sparkiscool/noxen/README.md

# Noxen

Drone frames whose printed parts are generated by a topology engine, one script per part, every optimisation run on GitHub.
The picture below is the current assembly, redrawn by CI after every result; nothing here is updated by hand.

## Scout v4
Scout v4, current assembly

[Open the Scout v4 viewer](https://sparkiscool.github.io/noxen/scout_v4.html?view=iso&still): 5.1 in Gemfan 5125 props on a frame printed
in PCTG, with 4 M3 bolts under the deck for the battery mechanism to mount to (the mechanism itself is designed separately), one camera that
is also a ceiling probe on a two-blade tape mast, and a half cage of 3 mm rods with a flat roof, frame-checked (`tools/scout_v4_shape.py`).

## Overseer
Overseer, current assembly

[Open the Overseer viewer](https://sparkiscool.github.io/noxen/overseer.html?view=front&still): every part, its mass and whether it passed; press play for the turntable.

Grey parts are placeholders still to be generated, red ones failed their last run. Every system is at https://sparkiscool.github.io/noxen/.

## Nox Ground Unit (the box)
Nox Ground Unit, current assembly

[Open the box viewer](https://sparkiscool.github.io/noxen/box.html?view=iso&still): the swap arm v7 with seven bays, the stand, the
enclosure, and the landing funnel drawn on the latch footprint so both drones seat at one height, 65 above the arm's grip height
so the wheel turns clear under them, standing on two beams across the enclosure's side sheets (`tools/import_box.py` brings the
mechanism's meshes over from the nox repo; `parts/box_funnel/make.py` draws the funnel).

## xswap short lock (the Overseer's battery mechanism)
xswap short lock in the Overseer

[Open the lock viewer](https://sparkiscool.github.io/noxen/xswap.html?view=iso&still): the short lock v5 on the Overseer's base inserts through one
swap cycle (pincer, fingers, gate bars, rail, flip), the drone see-through round it, with the shell's height over the cage feet read out
(`tools/import_xswap.py` copies the lock's meshes from its own page; `tools/xswap_motion.py` is the cycle).

## Live artifacts (the pages above as claude.ai artifacts, republished by the sessions)
Each system's `artifact` URL is in its `systems/<name>.assembly.json`; a session publishes `site/<name>.html` there after `python tools/build_site.py --inline`.
- Overseer: https://claude.ai/artifact/VhDfnp75uoVsj8SnyrW2Qg
- Scout v4: https://claude.ai/artifact/AqA1sXuqfs4APM6zRdf2iL
- Nox Ground Unit: https://claude.ai/artifact/QyhSnHpskSzztt5kajHG9z
- xswap short lock in the Overseer: https://claude.ai/artifact/Tiij4hVRdJWVdtLy9JdeQv

## How it works
One script per part, GitHub runs the topology engine, one page shows the assembly. Claude writes scripts, nothing else.

## Every part
1. Tell the design chat what the part mounts and carries. It writes your notes to `parts/<name>/feedback.md` and starts a worker
   session for the stream (CLAUDE.md, Sessions), so the chat stays free.
2. The worker writes `parts/<name>/part.py` and a line in `systems/<drone>.assembly.json`, pushes to main (the push starts the run).
3. The runner optimises, solid-checks, commits `result.json` + `part.stl`. The page rebuilds; the grey box becomes the real part.
4. The worker fixes fails at the root cause, republishes the artifact, reports once to the design chat and archives itself.

Manual run of any part(s): Actions -> parts -> Run workflow -> names. Empty = everything missing or stale.
Housekeeping: a weekly scheduled session runs `tools/sweep.py` on Monday morning and archives finished sessions.

## What the runner does when it is cut off
Runner cap is 6 h. The engine checkpoints every 10 iterations; a job that hits the cap saves the checkpoint and
starts itself again for that part, up to 4 attempts (about 22 h). A crash is not retried: it shows red and needs a fix.

## Layout
```
topo/                  engine (from nox/topo; the setup audit, PCTG and the export cleanup added here)
tools/solid_check.py   the gate      tools/build_site.py  page builder      tools/stale_parts.py   tools/sweep.py  housekeeping
parts/<name>/part.py   the setup; CI adds result.json, part.stl, preview.png
systems/*.assembly.json  every drone: part ids, placeholder shapes, poses       systems/dimensions.md  the numbers
site/index.html        the viewer (three.js, reads site/assembly.json that CI writes)
archive/               meshes nothing uses any more (archive/README.md)
```
Status on the page is computed, never stored: `result.json` present and its `part_sha` matches `part.py` -> done or failed; mismatch -> stale; missing -> pending.

## What came from the old repo (28 Oct)
`systems/dimensions.md`, `systems/parts-list.md`, both drones' assemblies and every part's mesh then (viewing copies; a run regenerates
the print file). Paths written `nox/...`, `docs/...` or `runs/...` in those files are in the old `nox` repo, not here.
Scout v3 (`systems/scout.assembly.json`) is archived: off the page, kept for its tools and the box's v3 checks.
