sparkiscool/noxen/archive/dimensions_scout_v3.md

# Scout v3 numbers (archived 9 Nov from systems/dimensions.md; Scout v3 is archived, the live Scout is v4: `python tools/dim.py C`)

## System Scout v3 (27 Oct 2026, layout v3 / cage v2, race-car shape; `nox/scout/v3/layout_v3.py`, assembly `nox/scout/v3/scout.assembly.json`, run `runs/scout_layout/v11/summary.md` (earlier: `v6/` cage v1, `v7/` octagon, `v8/` camera on top, `v9/` v3 middle rectangle, `v10/` Radxa standing); drone frame: x nose, y left, z up, plate underside 18.5, thrust centre = plate centre x 0; C geometry on E sizes unless tagged)
| Item | Value | Tag |
|---|---|---|
| Brief (Spark 27 Oct) | the latest Scout layout (PR 94 run v5) in a triangulated cage: **every rod 3 mm, about half the rods, any rod length; the bottom = the Overseer base loop's 4 side nodes (one reverse funnel, the Scout on fewer ramps); a race-car look; the camera low, no sharp section under it; small triangles to one node**; one camera; the Bee35 carbon base kept; one design | Spark |
| **Bottom (G Shared bottom ring)** | the Overseer cage v5 base loop's 4 side nodes (PR 122; Spark 27 Oct): (+85.8, ±116.1), (−68.9, ±119.7) about the catch centre, 154.7 long, 232.2 / 239.4 wide; plane 3.0 + 2.12 seat under the cartridge flat bottom (DEFAULT); nodes Ø20, rods 3.0; catch (tab line) x −2.50 (2.5 aft of the thrust centre, v13 re-trim for the real node mass), plane z −49.6; funnel band clear of links; swap column: receiver + 26.5 at the nose end, + 17.6 at the tail, + 30 at the sides | C |
| Rods | **58 (layout v13), all 3.0 solid carbon**: shell 50 (61..239, 6.34 m) on 19 nodes (4 on the ring, PETG nodes with 3.2 epoxy sockets, incl. the waist pair (−1.0, ±125.1, −11.9)); links 8, none on the carbon arms: 4 a side from the tie saddle's face (y ±44.3, z −7); none in the funnel band; nose top node (v13 node 17) sockets toward +x within 5 of its centre (camera mount 5.45 away, C); **every rod 3.0, every socket 3.2 (Spark 27 Oct: "lets just stick with 3mm rods for the scout"; the frame model's 6/4 sizing dropped)** (seat −2.12 and the catch's side sleeves stay) | C / Spark |
| Tie saddle | printed PETG (DEFAULT 27 Oct), 17 g E: a rail a side x −50..42, y ±36.3..42.3, z −15..6, outside the belly mount and the receiver TPU end pieces, rail and ties ≥ 2 off the flow bipod and cradle (y −50..−27.5, x −30..30, z −32..18.5; now 2.8 rail, 9.8 saddle ties, 42.3 shell rods, C); 2 tabs a side to the plate underside at x ±14..26, 4 M3 into the plate (4 new plate holes); rod sockets 3.2 epoxied; the cage ties' root and fuse, ahead of the latch; alt: core ties on the plate edges (42 rods, 651 g, bare carbon roots) | C / E |
| Shell (race-car look) | flat roof at the drone's top (109 between node centres), a clean raked front behind the camera (no nose point, Spark), a raised tail point (55 behind the margin hull, 18 under its top; it adds 54 of length), corners of the margin hull grown 24 mm along 6 directions; no triangle with all edges under 70, no rod under 45 (small triangles merged to one node); mirror-exact; node extents 362 x 266 x 111, 6.4 L, largest cell Ø129 (v13); rods 13.9 off the swept disks | C / DEFAULT |
| **Cage v20, the light funnel cage (8 Nov, Spark: "for the scout this is way too ridiculously heavy ... keep material near props as little as possible so it doesn't take away thrust ... reduce the number of rods by half, keep in mind this is a drone"; `tools/scout_cage.py`, frame model `tools/scout_cage_loads.py`; supersedes v19)** | What v19 weighed: 77 rods as cut (5.71 m, 79 g E) in 25 nodes (23 printed structures, 199 g M-run of 8 Nov), the units 177 g and the clips 15 g on a 340 g core: ~807 g against the 500 g budget; 1.74 m of rod lay over or under the prop discs (the roof fans, the lower band, the skids at |y| 84). v20 keeps the ring (side flats split at mid nodes PM0 / PM1), the window, the three-node ridge and the skids; drops the base rails and their mid nodes, the skid mid nodes, the lower band, the roof fans, the front slants and the yoke ties: 21 nodes (19 printed, 17 structures), 39 rods (2 bridges), 4 arm ties down to the skid ends; **41 rods as cut, 3.52 m (46 g E)**. New: a waist hoop RM-PM0 / RM-PM1 across the roof at x 0, the one transverse line between the four discs (5.65 from their edges in plan, 19 above); the skids at |y| 110 (outboard of the discs' plan, was 84) on A-frames from the side mids, a vertical from each skid end to its ring corner, a brace to the sill (K0-P0) or the tail flat (K1-P3). Disc shadow (`disc_shadow`: rod length inside a disc's plan, over it or under it): 314 mm, of it 212 the four ties under the arm tips (under the plate anyway) and 51 each the rear ridge rods' ends; v19 1744 over 26 rods. Checks: prop 12.2 (TB-P3), body 4.0 (sill vs camera), camera clear, passing 23.8, funnel 11.4 (exact descent gate: 0 crossings in 65 states), shell closed with 20 planar declared openings, open share 78 % (the four roof panels ring to ridge, 70 x 110: a flat ceiling touches the ring and the ridge first at any roll under 46°, the ring stands 12 outside and 13 above every disc edge, so only a poker reaches a disc through a panel). Frame: 117 Hz (v19 250), 18 hinges of 57 (v19 6 of 75), Euler ≤ 0.58 (P3-P4), pull-out ≤ 233 N (cap 940), side ≤ 49 (1200), end moment ≤ 1769 N mm (socket cap 2000, RF-RM), softest case the upside-down 35 g crash 15.0 mm at K3 (v19 1.45): half the rods is a tenth of the stiffness, every cap still met. Rejected on the way (frame model dry runs): hangers from skid mid nodes to the ring corners (6.6..12.1 from the discs at |y| 84..110); a V from the skid mids to the ridge (9.9 from the discs with the apex at z 70, 1.5 from the plate at z 62: no straight line threads the gap); roof fans (the front pair crosses the front discs 89 mm each and both pairs push the spine to Euler 1.46); the spine alone without the hoop (27 mm, 2157 N mm at RF-R7). Nodes: 74 sockets (v19 134), budgets 1.2..4.8 cm³ a structure (Σ 39.7, `spec_for`), **E 95..110 g the set**; the Scout then ~680 g E (core 340, units 177, clips 15, cage 150) against 500: the units are the next lever. | E / F |
| **Cage v20 run 1 and the 8 Nov node rules (Spark via the Overseer session: continue the Scout cage; a half cage is fine, it protects the top; as well designed as the Overseer's; design only, no prints)** | **Run 1 (8 Nov 11:45..12:20 PST, PETG rules):** all 17 structures PASS both gates, **104.1 g the set** (v19 199): K0..K3 7.7..7.9 g, P0+R0 / P7+R7 10.3, P3 / P4 6.6, PM0 / PM1 6.4, RM 4.6, P1 / P2 / P5 / P6 3.6, RF / RB 3.6; indices 0.01..0.11; 1..4 min each. Clips 3.7 g, 0.19..0.27. Nose unit 81.5 g, index 0.50 at the yoke under the plate (44.5, 1, 16) in the 35 g funnel catch: FAIL at the new 0.3 limit (0.39 at the NB sockets). Tail unit 90.3 g, 0.30 at the TB-P4 socket, gate FAIL on a 0.7 mm flake (6.8 mm³, 2.2 x 1.0 x 0.1) on the runner rim's end band at (−86.5, 30.4, −41.7), 0.4 under the rim top: a generated finish flake, not a drawn wall; watched for a recurrence before an engine session. System check against v19: the probes that reached the UBEC and the Radxa through the belly, the fit (tail unit room vs arm clip 2) and the FC cable access failed on v19 too; new on v20 are edge probes reaching the motor bottoms at the arm tips by 32 mm and the prop tips by 2..3 mm from below (v19's nose and tail V rods kept them 17..18 clear); four rods NB-K0 / NB-K3 / TB-K1 / TB-K2 would restore that at 45 rods as cut (Spark's call). **8 Nov rules applied (the Overseer's node changes, `parts/scout_node_lib.py`, `parts/scout_units_lib.py`):** every printed part PCTG (the engine keeps the PETG model, CLAUDE.md); limit 0.3 on every node, unit and clip, budgets x1.4 (nodes 1.54 x the skeleton, nose 55 → 77 cm³, tail 60 → 84, clips 1.5 → 2.1); skid nodes K0..K3 take a ground hit alone: **550 N** up through the foot (0.7 kg from 0.6 m, 4.1 J, stopped in ~15 mm of rod flex, peak 2x the average; the Overseer's 1300 N for 1.65 kg), limit 0.2, twice the budget; the landing slab inside the 3.0 foot, 2.5 tall; every socket the injectable pattern (`parts/socket_inject.py`: 0.5 annulus on 3 lands, feed ring 0.5 into the floor, Ø2 fill port, Ø1.5 vent; the port side from `port_dir`, in the units the port and vent continued 150 out), collar WALL 3.0 and FLOOR 3.0 (2.5 beyond the annulus); no min_member_mm in SPEC. **TPU 95A feet:** the Overseer's Ø22 x 6 cap (`parts/overseer_tpu_foot/make.py`) over each skid node's Ø16 landing face, four in `parts/scout_tpu_feet/part.stl` (written by `tools/scout_cage.py`), the Scout standing on them at z −59.4, the skid rods 10 above the ground; at K1 / K2 x −100 the caps crossed the funnel's rear outer wall by 2.0 mm when seated (|y| 116.3), so the rear skid ends moved to **x −95** (skids 195, descent gate 0 crossings in 65 states, frame unchanged: 118 Hz, Euler ≤ 0.59, 15.2 mm upside-down). Budgets now: 1.6..6.7 cm³ a node, skid nodes 7.7..8.2; expect ~130 g of nodes (E) with the thicker collars and the x1.4, the units ~100 and ~110 g (E) at x1.4: the Scout then ~720 g E against 500, the units still the lever. Design only: nothing print-ready (Spark 8 Nov: "wait on all prints, we are still designing"). | M / E / F |
| **Cage v21, the half cage (8 Nov, Spark: "why are we still keeping the lower half of the cage, it provides little value as the bottom shape for the funnel already had plenty of material ... get rid of any ongoing full cage and focus on the new half cage design")** | v20 run 2 cancelled (the 23 runs, ~1:40 pm PST). Kept: the ring at z 58, the ridge at z 70 with the waist hoop, the nose window, the four rods into the nose and tail units. Gone: the skids, A-frames, verticals, braces, the four skid nodes K0..K3 and the TPU feet (~68 g E with their ties and clips). New: a knee S0 / S1 at (0, ±115, 12) under each side mid, in the side flat's plane (12.4 outside every disc in plan at any height): a leg up to the side mid (46), a fan to the two ring corners on that side (91), and the two arm-clip ties in under the disc (82, level at z 12 from roots lowered 13.5 -> 12: at 13.5 the level tie's collar lost 6 % to the plate keep-out, the collar check refused all four clips). 31 rods (2 printed bridges, 2.46 m), 4 ties (0.33 m), 33 rods as cut 2.25 m (34..129); 15 printed structures + 4 clips. Landing: the base units' runners (seat rims z -44.3, 184 x 66.8): the frame model's contact points there (scout_cage.BASE, stiff to the core), and each runner takes a 600 N ground hit alone (2 m g h / 15 mm from 0.6 m at 765 g, the Overseer's rule; units kept at limit 0.3 and their budgets, not the 0.2 / 2x of a landing node: Spark's call). Checks: prop 12.2 (TB-P3), body 4.0, camera clear, passing 23.8, funnel 12.7 (NB-P0 seated), shell closed over the top with the bottom declared open in planar pieces (gap 0), mirror exact; disc shadow 295 mm (the four clip ties 48 each, the rear ridge 51 x 2; v20 314). Frame model: 136 Hz (v20 118), 20 hinges of 51, Euler ≤ 0.32 (RB-P4), end moment ≤ 1839 N mm (RF-RM; cap 2000), worst case upside down 12.8 mm at P6 (v20 15.2 at K3); side crash 3.1 mm on the knee and the runners. Rejected: the top alone (26 mm and 2.6 N m over the cap in a side crash); the leg without the fan (2.02 N m, 13.7 mm); the fan without the leg (17.2 mm); a rod in at x 0 to the nose unit's side instead of the clip ties (2.9 N m on its sockets); the knee at z 18 (the leg 40 merges into a bridge). Not covered from below by design (Spark: the funnel and the base units cover the bottom): a probe from under the arms reaches the motor bottoms (v20 already). | C / E |
| **Cage v19, the low domed funnel cage shortened to the rear discs (4 Nov, Spark: compact, the electronics into the printed base; `tools/scout_cage.py`, frame model `tools/scout_cage_loads.py`; supersedes v18)** | v18 with the tail flat in from x −130 to **−116**, the least the rear discs' 12 mm keep-out allows (54.1 + 48.45 + 12 = 114.6; v18's −130 made room for the tail electronics bay behind the plate, now in the tail unit's bay over the runner), TB in to (−112, 0, 10) (its rods to P3 / P4 pass the rear discs by 12.3). Node extents 252 x 230 x 118 (v18 266). Checks: prop 12.0, body 11.2 (NB-P0 vs the camera), camera clear, funnel 4.8; frame 231 Hz, Euler ≤ 0.55 (RM-P2; RB-P3 / P4 0.53 on the shorter tail), upside-down landing 1.4 mm. **CG (system_check on the assembly): run-2 masses (−0.35, 0.12, 4.6), run-3 masses (0.13, −0.02, 4.8) against the thrust centre (0, 0), tolerance 3; the frame model's all-up 730 g at (0.6, 0.0, 7.2).** **Nodes (4 Nov): the 25 nodes other than NB / TB are engine setups `parts/scout_cage_node_<key>` from `parts/scout_node_lib.py` (after the Overseer's node library): socket collars 2.5 round each 3.2 x 10 bore with a 3.0 floor (**5 Nov, Spark: the nodes are overweight: collars 2.0 with a 2.0 floor, 119 → 83 g of collars over the 25, and 2 cm³ generated: a run-1 node was 8.3..10.5 g, half of it the 4 cm³ budget, at indices 0.01..0.16, so half the budget keeps every index under 0.35; expect 4.5..7.5 g a node, 150 g the set, E**; **and the envelope (5 Nov, Spark: the nodes still look wrong): run 1 grew each node in a box-and-ball envelope up to 56 mm across, so with the frame loads tiny (indices 0.01..0.16) the 4 cm³ went into spindly webs between collars 7..17 mm out; now a Ø12 strut round each member from the centre to its collar's mouth (2.5 of room round the collar) and a Ø17 hub ball, so the engine only decides how much of each strut to keep: a star of struts, a node**), the bore from 7 out or further where two members meet closely so no bores overlap (exact check), a landing face under the six skid nodes, loads from the frame model's node_loads, supports the two stiffest members; h 1.0, 4 cm³ each (E); 3..8 members a node | E / F |
| **Cage v18, the low domed funnel cage on skid trusses (4 Nov, Spark: the whole design more pleasing, inside parts that hold everything; `tools/scout_cage.py`, frame model `tools/scout_cage_loads.py`; supersedes v17)** | v17's skid trusses, braces and ties with the profile lowered and domed: **ring z 58** (was 62; at \|y\| 115 it is 12 radially outside the discs at any height; at 54 the roof rods coming down to it passed 10 over the discs' far edges), **roof ridge of three nodes at z 70** (RF (70, 0), RM (0, 0), RB (−70, 0)) fanned to the ring: a 12 dome, every roof rod ≥ 12 over the discs (the mid node halves the ridge: an upside-down landing put 407 N in a 140 ridge rod, 1.69 of its Euler load; now 0.54 worst, RM-P2). **NB (118, 0, 8) and TB (−130, 0, 14) are printed into the nose and tail units** (`PRINTED`), the tie sockets C (±58, ±30, 14) on the units' yoke corners, the arm ties A on printed clips; v17's tail ties are the tail unit itself. 27 nodes (25 printed as nodes), 71 rods 3.0, 6.69 m (74 g E rod + nodes), 8 ties 0.65 m; pin-jointed 4 rods short of 75 (the window, the belly, the two ends between the skids). Node extents 266 x 230 x 118. Checks: prop 12.0 (P0-P1), body 6.0 (TB-B1 vs the UBEC), camera clear, funnel 4.8 (K3-R7 at +y 20, h 30); frame: first mode 232 Hz, crash deflection ≤ 1.54 mm (upside down on the roof; every other case ≤ 0.2), landings ≤ 0.05, compression / Euler ≤ 0.54, pull-out ≤ 443 N of 940 (P3-P4, upside down), end moment ≤ 297 N mm | E |
| **Mounting audit (4 Nov, Spark: confirm every screw hole and its access against the parts' published dimensions)** | **Published and used as published:** motors EMAX ECO II 2004, 12 x 12 M2 (spec; the Bee35 lists 12 x 12 M2 x 6 motor holes); FC MicoAir743 AIO, 25.5 x 25.5 Ø3 (spec) on the plate's 25.5 pattern, measured as a diamond at (1.9, 0) (M, 22 Oct); Radxa Zero 3W, four Ø2.8 (M2.5) at 57.85 x 22.85..22.90 (Radxa STEP v1.11); camera DECXIN 2633V2, M2 on 28 x 28 (coupon A, M); MTF-02P, UBEC, XR2: no holes (tape, spec). Bee35 plate (listings): FC patterns 20 x 20 / 25.5 x 25.5 / 30.5 x 30.5, motor 12 x 12 M2, plate 3.5 (D8 M). **Not published, from the trace (C / E, CHECK on the plate):** the nose bolt hole (36, 0) and the (3.9, ±31) pair the nose yoke also uses; whether the 20 and 30.5 patterns sit as squares or, like the measured 25.5, as diamonds. The nose yoke is held by the measured 25.5 diamond's three front holes alone, so those three pads are a bonus or a drill. The tail yoke's (−55, ±13) pair is drilled by design. **Screws and access:** FC standoffs M3 x 12 (4 standoff + 3.5 plate + 5 insert) down from the top through the plate into the nose yoke, open above; nose (36, 0) and (3.9, ±31) M3 x 8 from the top, open; tail (−16.13, 0) = the FC diamond's tail standoff bolt, (−55, ±13) M3 x 8 from the top between the arm roots; receiver 4 M3 up from below through the receiver's bolt keys (the latch's own design); camera 4 M2 x 6 from the front through the board into the posts' inserts, open through the window; Radxa 4 M2.5 x 6 from the tail end along −x into the posts' inserts: the UBEC now lies flat under the board (z −24.3..−16.3, the board's bottom edge at −15) and an Ø8 x 40 driver column from each hole is a cut, so nothing grows in the way; motor screws M2 x 14 (6 stock + the 8 mm clip) up from below through the clip and the plate, open under the arm tips; every rod slides into its socket along its own line, resin through the injection port. Build order: the units bolt to the plate first (from the top), the receiver up into them (from below), the boards (the Radxa's screws from the tail end, then the UBEC taped under it and the XR2 on its land), the camera from the front, the rods last | spec / M / C |
| **Inside parts (4 Nov, Spark: "design inside parts that hold everything"; `parts/scout_units_lib.py`, setups `parts/scout_nose_unit`, `parts/scout_tail_unit`, `parts/scout_arm_clip_1..4`; supersede the belly mount v1, the belly skirt, the tail bay mount v2 and the camera mount v1)** | **Nose unit**, one PETG piece: the nose yoke under the plate (3 M3 x 5.7 inserts: the Bee35 hole (36, 0) and two drilled at (34, ±14)) to the receiver's nose inserts (48.28, ±26.55) (Ø10 bosses z 9.6..18.5, the receiver's bolts up through its keys), the nose runner (x 55.3..93.5, \|y\| 33.4, z −44.3..−24.3: a 3 mm seat rim over the funnel's ring with 4 mm 55° lead-ins drawn, the inside generated) with a 26 x 20 window the flow sensor looks down through (MTF-02P lens (74, −2.5, −24.5), board taped under a land at z −18.4; was (0, −30, −30): beside the receiver there is no room between it and the funnel's y face, under the plate the receiver clips its view), the camera boom (lens (126, 0, 40), 4 forward: four Ø5.6 x 10 M2 posts behind the board back x 114 at (±14, 26 / 54) clear the front discs' 12 mm keep-out by 2.4), cage node NB's four sockets and the two nose tie sockets. **Tail unit**: the tail yoke (4 drilled M3 at (−30, ±14), (−55, ±20)) to the receiver's tail inserts (−37.65, ±26.55), the tail runner, the electronics tray (z 0..7.5: Radxa Zero 3W on four Ø8 posts with M2.5 x 4 inserts at its STEP holes, PCB bottom z 5.9, the SD card out the tail, USB-C / HDMI plugs out the right edge; UBEC 61 x 17 x 8 and XR2 34.5 x 13 x 4 on 2 mm tape lands, their leads and antenna cut), cage node TB's four sockets and the two tail tie sockets. **Arm clips** (4): 4 mm under each arm tip on the motor's M2 screws (M2 x 10 through clip and plate), Ø6 shaft clearance, the tie socket hanging under the tip. Keep-outs are cuts: receiver + 0.5, plate, boards + plugs, camera body / plugs / view, the discs grown 12, rods beyond the mouths. Loads: the receiver set's share 155 g (E) and the camera 10 g / boards 32 g in 35 g crashes (14 directions) and flight, a 35 g landing into the funnel on the seat rim and the lead-ins (0.42 of the drone a runner, E), every socket's frame-model force (`systems/scout.cage_loads.json`). Grids: both units h 2.0 (nose 150k cells, tail 123k; the tail at h 1.5 was 287k and its direct solve took 8.8 GB, killed here and over the CI runner's 7 GB; the nose 332k at 1.5 is refused), clips h 0.8 (86k). **Run 1 (4 Nov, 21 / 26 / 1 min):** nose gate PASS 60.4 g, index 0.60 in the funnel catch (seat up) at the nose wall's top (the wall room was 7 wide); tail gate FAIL (two necks at the ends of the 2 mm tape lands) and index 2.34 in TB-B1 tension under the tail pad (−55, −20) (the tray hung on a 10 wide wall slot); clips 2.99 g, index 0.26, clips 1 and 4 gate FAIL: the tie collar's top (root z 17) sheared by the plate keep-out to a 1.1 sliver (2 and 3 passed by grid luck). **The class: drawn bodies left thinner than 2 mm after their cuts; audit `drawn_thin` (exact geometry, under 2.5 mm across the smallest extent) now refuses them before a run; a collar sheared by a keep-out is caught by `check_collars` in the setups (a collar must keep 97 % of itself).** Run 2: lands 4 thick, clips 8 thick with the tie roots at z 13.5, the nose wall room to x 66, the tail wall room to x −66, both units 50 cm³. **Run 2 (31 / 31 / 3..5 min): nose PASS 73.3 g, index 0.41 (funnel catch); clips PASS 3.7 g, 0.12..0.23; tail FAIL: one neck (a 2.6 cm³ blob bridging the UBEC's lead clearance, a 17 x 9 slot through the yoke's side where the pads and tie socket load it) and index 1.16 at the tray's step past the wall room (36 vs 33.4 wide at z 0) in the funnel catch, 80.9 g.** **Run 3 (Spark 4 Nov: "we can keep the fc on top of the base plate"):** the FC on 4 mm standoffs over the plate (board z 26..27.6, caps to 32.5, 6 under the discs' band), so the yokes meet under the plate's middle at x −8 and bolt through the plate's own holes: nose (36, 0), the FC diamond's (19.93, 0), (1.9, ±18.03) (the FC's standoff bolts go on through the plate into the yoke's inserts), (3.9, ±31); tail (−16.13, 0) + one drilled pair (−55, ±13). **Then (Spark 4 Nov: "fit as much of the electronics into the printed base plate that hits the funnel as possible"): the tail tray behind the plate is gone; the three boards stand on edge in a bay over the tail runner, inside the funnel's bowl (x −100..−52, \|y\| 33.4, z −24.3..12): the UBEC at x −95..−87 (61 along y, 17 tall, leads out the ±y ends), the Radxa Zero 3W PCB at x −80..−78.4 (65 along y, 30 tall z −23..7, components to −x toward the UBEC, USB-C / HDMI up between the arms, the SD card out the −y end) on four Ø8 posts along +x with M2.5 x 4 inserts (posts toward the UBEC were boxed in by its clearance, audit), the XR2 at x −72..−71 (|y| 8, z −22.5..−10.5, antenna flat along −y); the UBEC and XR2 on 4 mm lands behind them; a short arm x −120..−96 to the tail node. Run 3 is this layout at 50 cm³ **Run 4 (5 Nov, 37 / 35 min): nose gate FAIL at index 0.42, 84 g: the lower camera posts' 2 mm stubs behind the plug keep-out had 1.2 mm of room beside them, two loose 33 mm³ blobs; tail gate FAIL at index 0.45, 80.8 g: the tail-node arm met the bay over a 4 mm overlap, three necks, the arm's collars 86 % off the main body. The class: a loaded drawn body whose only room to the support is thinner than a member; audit `env_neck` (the room eroded by half a member must still join every loaded body to the support) refuses it before a run. Run 5: the post block to the board's back and \|y\| 24; the tail bay room \|y\| 40 and up to z 22 behind the plate's tail, so the room passes the Radxa (on edge across the whole bay) on both sides and over its top (the arm into the bay alone still reached the yoke only through slivers: env_neck).** **Nose run 5 (5 Nov, 22 min, started by the push of the run-5 setup): gate FAIL on the same two loose stubs with the wider room, index 0.67, 82 g: the lower posts have 2 mm beyond the 8 mm plug keep-out and carry under 1 N each, so the layout never builds to them; run 6 gives every post a Ø10 x 4 root boss behind the plug zone, a body the layout ties and builds onto (the Overseer's head mount posts sit in its slab).** **Nodes, run 1 (5 Nov): 21 of 25 PASS at the first run, indices 0.01..0.16, 8.3..10.5 g each (198 g for 21; the 5 g estimate was for 3 mm rods alone: with 4 cm³ generated and 4 g of collars a node is 9); B0..B3: at each rail corner the arm tie and the yoke tie arrived 2..13° apart, so the no-overlap rule started their bores 39..85 mm out and the nodes grew to 290k..586k cells: B1 / B2 refused in a minute, B0 / B3 crawling. The yoke ties (C) now end at the rail mid nodes BM0 / BM1 (9 members each, bores from 13 at most; the corners 7..15); `scout_node_lib.check_members` refuses a bore over 25 mm out (a fork). Frame: 246 Hz with the ties so.** **Tail run 5 (5 Nov, 37 min): gate FAIL at index 0.40, 79.9 g: no necks, no thin walls, but the tail-node arm's web eroded apart from the body (a 2.7 mm³ remnant); run 6: the arm room \|y\| 20 and 24 tall, 60 cm³** **Run 6 (5 Nov, nose 21 / tail 42 min): nose gate FAIL, 84.4 g, index 0.45 (funnel catch, seat up, at the (36, 0) pad as in run 3): the root bosses fixed the posts (no loose stubs), but two 150 mm³ knobs sat on the seat rim's side bands at (62, ±29, −40), joined over 16 mm² on necks under 3 mm: the seat's side-face and end-face load regions ran 2.7 mm above the 3 mm rim up the chamfer, into the block's room, so the layout grew material out to those loaded nodes to carry the funnel's side push. The class: a load region reaching off its drawn face into design room; the audit's `load_room` check (over 10 % of a case's loaded nodes with no drawn cell at them) refuses it before a run; the seat regions now stop at the rim's top (both runners). Tail gate FAIL, 92.9 g, index 0.18 (TB-P3 tension): the first tail with no necks, no loose drawn bodies and no thin walls; one body plus a 4.8 mm³ floating crumb the engine's cleanup dropped (one watertight body exported) but the gate counts (any loose piece over 1 mm³): a gate rule, Spark's call (align it with the exporter's 10 mm³ core limit, or have the engine report where the crumb sits). The audit then found a second source in the tail: the wall room box (x −66..−52) ran from the seat up without the lead-in wedge, so the chamfer zone at the yoke end was design room the engine could fill toward the funnel's face (28 of the side-face region's 64 cells); both units' wall rooms now have the wedge cut out. Run 7: both units with the clipped seat regions and the wedge out of the wall room (the tail also for its mass: the 60 cm³ budget and the bay room gave 92.9 g).** | C / E / F |
| **Placement audit (5 Nov, Spark: "check that all nodes and all rods are in the right places")** | Every node part is built in drone coordinates at its cage point (`parts/scout_node_lib.py`: the collars along the rod axes from `tools/scout_cage.py`'s tables, so the mesh needs no pose); `check_members` passes for all 25 (every socket pair on one axis, 3..9 members, no bore over 25 mm out, every member with a frame-model load); the rods mesh `parts/scout_cage_v19/part.stl` is from the current tables (85a11aa, the yoke ties to BM0 / BM1); the cage checks on the current tables: prop clearance 12.0 (P0-P1), body 4.0 (P0-P7 vs the camera), no rod in the camera's view, funnel 4.8 (K3-R7 at +y 20, h 30), shell closed and mirrored (27 nodes, 71 rods, 46 triangles). **What was wrong on the page:** BM0 / BM1's meshes were run 1's, before the yoke ties C0..C3 were retargeted to them, so the four tie rods arrived at nodes with no socket for them; B1 / B2 had no mesh (refused as forks, never rerun); the other 19 nodes' meshes were built to the same geometry as now (only their loads changed). The node reruns of 5 Nov (the lighter spec) replace all 25. | C |
| **Merged nodes (5 Nov, Spark: "if any two nodes are too close together, like the nodes in the front, we should just make that into one structure, the same all across the scout")** | Rule, in `tools/scout_cage.py`: two nodes closer than MERGE_MM = 60 are one printed structure (`GROUPS`, union-find over `BRIDGES`), the rod between them a printed PETG bridge (no sockets); `parts/scout_node_lib.py` builds the pair as one part (`parts/scout_cage_node_<a>_<b>`: both nodes' collars, struts and hubs, a Ø12 room along the bridge, 5 cm³: two nodes' 2 and a bridge's worth), the rods mesh and the frame model leave the bridges out of the carbon (frame: a bridge is a PETG Ø8 beam, E 2.1 GPa). At 60: the two window posts P0-R0 / P7-R7 (41 mm), the ring's tail corners P2-P3 / P4-P5 (53) and the six skid-truss posts B0-K0 .. BM1-KM1 (57): 10 pairs + 5 singles (P1, P6, RF, RM, RB) = 15 printed structures, 61 carbon rods (6.14 m). Next pairs up: NB-P0 62 (NB is in the nose unit), B0-P0 / B3-P7 70, the corner diagonals B0-R0 / B3-R7 89. **Weight (E): a wash.** A rod costs 11 g/m; its two collars at 2.0 wall 1.1 g; the engine's material behind the two sockets ~0.8 g: a 41 mm window post 2.4 g in all, a 57 mm skid post 2.6. A printed Ø8 PETG bridge over the span between the hubs: 24 mm 1.5 g, 40 mm 2.6 g. So the window pairs save ~1 g each, the skid pairs break even, and the corner diagonals (B0-R0: 72 mm of bridge, 4.6 g against 2.9) would cost 1..2 g each, so they stay rods. Over the cage: −2 g for the 10 pairs, +5 g if the four corner groups B-P-R were merged too. **Frame model with PETG Ø8 bridges** (`systems/scout.cage_loads.json`): the 8 window and skid pairs alone: first mode 241 Hz (246 all carbon), crash deflection 1.44 mm (1.41), Euler ≤ 0.58 and the largest rod force 457 N unchanged (P3-P4), a bridge under 8 MPa (Ø6: 240 Hz; Ø10: 273 Hz, a Ø10 bridge is stiffer in bending than the rod). With the ring's tail corners P2-P3 / P4-P5 bridged too (the rule at 60): 218 Hz, 2.01 mm upside down on the roof, Euler ≤ 0.61 (RM-P2): the ring's rear corners carry the roof, and a Ø8 PETG bridge is 5x softer along its axis than the rod; the engine sizes the printed corner from the rod's load (5 cm³ a pair), so the built corner is stiffer than this Ø8 estimate. What merging buys is not mass but parts: 10 fewer rods to cut and 20 fewer sockets to resin. **The empty sockets Spark saw on the page (7 Nov, "nodes with place for rods that dont have rods"):** not the design: the page's mesh cleanup (`build_site.view_mesh`) merged two in-line rods that met at a mid node's centre into one body and dropped it, so RF-RM-RB, the rails through BM0 / BM1 and the skids through KM0 / KM1 (10 rods) showed empty sockets while the STL had all 69. The rods mesh now draws each rod as it is cut, socket floor to socket floor (`scout_cage.rod_ends`: 69 rods, 5.37 m, 42..136 mm, the cut list in `cage_shell.rod_cuts_mm`), so no two touch and the page keeps every one (checked: 69 bodies in the page copy). **Found on the way (the pair setups):** the nose braces K0-R0 / K3-R7 passed 15.9 mm from P0 / P7, through their P0-P1 / P7-P6 collars (the run-1 nodes had no check for a passing rod, so the printed P0 would have sat on the brace); they now end at P0 / P7 (one printed structure with R0 / R7, so the brace still reaches the ring through the bridge). Checks for it from now on: `scout_cage.checks` screens every rod against every node it does not end at (axis 20 mm from the centre; nearest now 23.8, the sill P0-P7 past NB, whose sockets point elsewhere) and `scout_node_lib.check_members` refuses a collar a passing rod comes within 1 mm of (exact, every node, NB and TB too). Grids: a 57 mm pair is 230k cells at h 1.0, so the pairs run at h 1.2; the singles at 1.0. Frame after the reroute: 221 Hz, 2.01 mm, Euler ≤ 0.61. **Strut singles at a flat 2 cm³ (run of 7 Nov 02:40, the five that stay single: P1 6.2 g, P6 6.2, RF 5.2, RM 5.7, RB 5.2; indices 0.04..0.28, one body each): gate FAIL on 2..10 flakes a node, 1.0..1.4 mm thick, 15..35 mm³, in the re-entrant corners where the strut rooms meet, where the engine's 6.25 mm members did not fill the Ø12 room (the export cleanup lists them as slivers but removes only their cores: an engine class, its own session started 7 Nov). The budget a node needs is what its members weigh: the engine's member floor is 6.25 mm at the gate's 2.0 mm erosion (`topo.layout.gate_member_mm`: 2 x 2.0 + 2.25), so every strut from the hub to a collar's mouth is Ø6.25 whatever the load (the indices at 2 cm³ say Ø4 would carry it); `spec_for` now sets each structure's budget from its skeleton (a Ø14 hub ball and a Ø6.25 member from the hub's surface to every mouth, the bridge too, +10 %): singles 2.5..3.5 cm³, pairs 5..7. Sockets start at 5 (NODE_R 7 → 5) and the strut room is 1.5 round the collar (2.5), so the struts are shorter and the rooms tighter. Expected: singles 6..8 g, pairs 11..14, the 15 structures ~150 g against run 1's 246 for 25 nodes. The lever left is the gate's member floor: at 4.5 mm the generated half of a node would halve again. **Merged run 1 (7 Nov 03:56, with the ports): singles P1 / P6 8.7 g, RF 5.6, RM 6.4 (PASS, index 0.04), RB 6.5; pairs B+K 12.6..14.0, BM+KM 14.8, P2+P3 / P4+P5 14.6; P0+R0 / P7+R7 stopped by the early strength check. Two classes: (1) every structure but RM failed the gate on 1.1..1.2 mm walls, 22..25 mm³ each, that sit ON the collars at their resin grooves: a 2.0 wall less a 0.5 groove is 1.5, and the engine session of 7 Nov found the same (the flakes of the earlier strut run were these too) and added the audit's `drawn_wall` (a drawn body with a wall under the gate's thin rule after its cuts is refused): collars are 2.5 again, as the Overseer's (2.0 at the grooves), the strut room 3.0 for the drawn share. (2) The pairs' indices 0.54..1.40 sat in the bridge next to one node (P2+P3 1.40 at 10 mm from P3; B0+K0 0.75 at 10 mm below B0): the pair had one support, the two stiffest members over both nodes, so every pull at the other node ran through the bridge; a pair now has the two stiffest members at each node as its support, the bridge carries only its frame force. Nose run 8 (with the ports, 20 min): gate PASS, 84.3 g, index 0.40 (seat-up catch): the first nose through both gates. Tail run 8 (42 min): 92.7 g, index 0.18, gate FAIL on the same 0.7 mm sliver at the runner's rim corner (−87, −30, −42). Clips run 3 (with the ports): PASS, 3.7 g, 0.10..0.19.** **Merged run 2 (7 Nov 05:58, collars 2.5, supports per node, 1..8 min each): 13 of 15 PASS both gates: P0+R0 / P7+R7 14.6 g (0.18), P2+P3 / P4+P5 16.9 (0.07..0.08), B0+K0 / B3+K3 16.6 (0.24 / 0.33), B1+K1 / B2+K2 14.2 (0.10 / 0.14), P1 / P6 10.2 (0.09), RB 7.6 (0.16), RF 6.5 (0.11), RM 7.3 (0.06): 157 g the 13, the whole set of 15 ~187 g against run 1's 246 for 25 nodes (the collars at 2.5 cost 0.2 g a socket back). BM0+KM0 / BM1+KM1 refused by load_room: at the pairs' h 1.2 the 1 mm landing-face band under KM0 caught a layer of cells outside the foot (128 of 280); the region is now the foot's own volume (z +0.2..2.8 of its 3, r 7.8).** **Merged run 3 (7 Nov 07:08, all 15 on one setup, 1..10 min each): 15 of 15 PASS both gates. B0+K0 / B3+K3 16.4 g (0.08), B1+K1 / B2+K2 14.2 (0.04), BM0+KM0 16.9 / BM1+KM1 17.0 (0.03 / 0.04), P0+R0 / P7+R7 14.6 (0.18), P2+P3 / P4+P5 16.9 (0.07 / 0.08), P1 / P6 10.2 (0.09), RB 7.6 (0.16), RF 6.5 (0.11), RM 7.3 (0.06): the set 200 g (M, 15 structures) against run 1's 246 g for 25 nodes; with the 61 carbon rods at 68 g and the 8 ties, the cage is ~290 g. The pairs came in 3..4 g over the skeleton estimate each (the bridge's Ø12 room filled, and the 2.5 collars). Every index is under 0.2: the budgets have margin to give back if the member floor ever drops.** | C / E / F |
| **Resin injection ports (5 Nov, Spark: "nodes need to be resin injectable")** | Every 3.0 socket on the Scout (the 15 cage structures, NB / TB and the tie sockets in the units, the arm clips) gets a Ø2 channel from the bore 1.5 above its floor out through the collar wall and the body (`parts/cage_node_lib.port_dir` / `port_cut`, cut through the whole envelope so nothing grows over it): the rod goes in dry, the syringe tip in the port, resin fills from the floor up through both grooves and shows at the mouth (the mouth is the vent; the coupon's floor vent is not drawn, a node's floor backs onto the body). Direction: perpendicular to the bore, as near outward from the cage (away from (0, 0, 10)) as the room allows, no other member within 30° (the 6..8-member nodes have no 40° gap) and the channel clear of the other collars by 1.5; in the units the node sockets' ports point down out of the underside and the tie sockets' out of the yoke's side, the clips' down under the arm tip. So every port is reachable with the cage assembled (rods last, row Mounting audit). Resin: **one tip for every socket on both drones (Spark 8 Nov: "one size that fits all optimized for resin flow and contact, then build the nodes around it"): a 14 G blunt luer-lock tip (Ø2.11 outside, Ø1.60 bore: 3.3x the flow of 16 G, 13x of 18 G, flow ~ bore^4) on a 3 ml luer-lock syringe, slow epoxy; ports become Ø2.5 (PORT_R 1.25, 0.2 clearance a side for a printed hole) with a 2.5 tall feed ring so the port opens fully into it; applied by recut after the 8 Nov batches land (a constant change on main restarts every running node). Bigger (12 G, Ø2.77) needs a Ø3.1 port, wider than the 3.0 collar wall leaves room for on the 6..8-member nodes; the 0.5 annulus round the rod sets the fill rate past 14 G anyway**, M (tip sizes) / E; coupon it before the first node (the Overseer's coupons v2 were brushed, not injected). **The bore's inside (7 Nov, Spark: "make the inner pattern in a way where the resin can actually make the best contact with the rod"):** a plain 3.2 bore on a 3.0 rod leaves 0.1 of radial gap, which resin barely enters, so the bore now has three 0.3 deep, 60° wide channels (pockets) along it from 1 mm above the floor out of the mouth, between three 60° lands of the plain 3.2 bore that centre the rod; the port opens into the first pocket, the two 0.5 grooves at a third and two thirds of the depth join the three pockets round the rod, and the resin shows at the mouth through them: a bond line of 0.3 on 60 % of the rod's surface and the grooves' rings on the rest, against a dry 0.1 film before (`cage_node_lib.socket_cuts(pockets=3)`, every Scout socket; the Overseer's sockets unchanged). The collar is 2.2 at a pocket and 2.0 at a groove, within the audit's 2 mm wall rule. The printer sees a 3-lobed hole: the lands are 1.7 wide arcs, the pockets 0.3 steps, both well over the 0.4 nozzle. | C / E |
| **Node length and the merge distance (8 Nov, Spark: "the nodes are super long")** | What sets a node's size: each arm reaches socket start + the 10 mm bore + the 4 mm collar end; the start is 5 mm unless a neighbour's bore would come within 2.5 mm of wall, which pushes it to 8..17 (mean 10..12 over the cage), so a single node is 43..58 mm across (RM 43, P1 57, RB 58) and a merged pair 104..115 mm (the 41..57 mm span between the two nodes inside one part). The levers: the bore depth (10 is Spark's coupon; 8 would take 4 mm off a part and leave ~750 N of pull-out against 301 N worst, E, not taken without a coupon), the wall between bores (2.5 to the gate's 2.0 would save ~1 mm a start, not taken), and the merge distance, which is the length: MERGE_MM 60 → 45, so only the window posts P0+R0 / P7+R7 (41 mm, 104 long) stay merged and the ring corners P2 / P3 / P4 / P5 and the skid-truss nodes B0..B3, K0..K3, BM0 / BM1, KM0 / KM1 are single nodes again (23 structures, 77 carbon rods as cut 5.71 m, 38..136 mm). Frame with only the two bridges: 250 Hz (221 with ten), crash deflection 1.45 mm (2.01), Euler ≤ 0.59: the ten PETG bridges had been softening the ring and the skids. **Split run (8 Nov 00:36, 0..8 min each): 23 of 23 PASS both gates, 199 g the set (the 15 merged structures were 200): B0 / B3 9.6 g, B1 / B2 7.8, BM0 / BM1 12.6, K0 / K3 6.3, K1 / K2 6.5, KM0 / KM1 4.3, P2 / P5 8.2, P3 / P4 8.7, P1 / P6 10.1, P0+R0 / P7+R7 14.6, RB 7.5, RF 6.5, RM 7.3; indices 0.01..0.18. Looked at on the page (headless render): every socket holds its rod, the hubs are Ø20 balls with the collars as short stubs, the skid nodes a boot on a foot.** | C / E / F |
| **Filament (8 Nov, Spark: "is PETG still the best filament for this?")** | **Superseded the same day: PCTG for every printed part (Spark 8 Nov via the Overseer session, CLAUDE.md; the Overseer's PETG nodes and arms broke in testing).** The morning's answer: PETG stays for the nodes, the units and the clips: the carbon rods carry the cage's stiffness (every node index is under 0.2 at the gate's 6.25 mm members), the crash cases need toughness more than stiffness, it prints on the open A1 mini with the stock nozzle, bonds with epoxy after a scuff, and is on Amazon in any colour. What would change it: PETG-CF (Bambu / Polymaker, Amazon) is ~2x stiffer and creeps less under a resined rod's pull, but it needs the hardened 0.4 nozzle (A1 mini: hardened steel nozzle, Amazon) and is more brittle across layers, so a crash into a node edge is worse; PA-CF / PAHT-CF want a dry box and an enclosure the A1 mini has not got; ASA / ABS warp open-frame and add nothing PETG lacks here; PCTG (Polymaker) is PETG's tougher, clearer cousin, same settings, a drop-in if a node ever cracks on a crash test. Resin: a slow (30 min) epoxy fills the pockets before it gels; CA would not reach the floor through a Ø2 port. | E |
| Frame results (Scout, `tools/scout_cage_loads.py` on v17 then v18, writes `systems/scout.cage_loads.json` with `node_loads` for the units' sockets) | the Overseer's engine (3D Euler beams, rigid joints: a 3.0 rod in a 10 deep PETG socket turns at ~230 N m/rad, 5..12x the rod's own 4EI/L, so the rods are the compliance; the PETG limits strength: pull-out ~940 N, side ~1200 N, end moment ~2.0 N m, all E), the plate and everything on it one rigid body (554 g at (−11, 0, −4)) on the ten tie roots, cage 211 g, 765 g all. Cases: 35 g crash in 14 directions onto the hull face the CG ray leaves through (6 faces), landing 6 g flat on the skids, rough landing 6 g rolled / pitched 20°. **Results v17: first free-free mode 204 Hz** (v16 with its single-diagonal panels 147); crash deflection ≤ 0.29 mm (v16: 17 mm tail-first, 8.4 flat), landings ≤ 0.06; largest rod force 210 N (tie A0-B0, nose crash); compression / Euler pinned ≤ 0.53 (P0-P7, the window sill, 115 long; Overseer benchmark 0.73); socket pull-out ≤ 207 N of 940, side ≤ 10 of 1200, end moment ≤ 402 N mm of 2000. **v18 (NB / TB on the units, no tail ties): 232 Hz, ≤ 1.54 mm (upside down on the roof, P3-P4 443 N), Euler ≤ 0.54, end moment ≤ 297.** v16's weak points, all fixed by v17: base rails 200 long buckled at 1.10, TB-B1/B2 at 1.08, the skid panels hung on socket bending at 1860 N mm, tie C1-B1 at 1157 N over pull-out | F on E |
| **Cage v15, the compact funnel cage (3 Nov, Spark: v14's 392 x 284 was far too large, then "the scout is colliding with the funnel"; `tools/scout_cage.py`, checks in the script; supersedes v13 and v14 for the shared funnel of `parts/box_funnel/make.py`)** | a closed 3.0 rod octagonal prism tangent to the prop keep-out, formed to the Scout seated in the funnel: **22 nodes, 48 rods, 4.88 m (54 g E rod + nodes), mirror-exact, shell closed with its openings declared (the bottom inside the base rails and its nose / tail Vs; the nose window for the camera); node extents 266 x 230 x 107** (v13 362 x 266 x 111). The one ring at z 62 is the prop keep-out ring and the roof's edge: flats at |y| 115, nose 136, tail −130, corner chamfers on |x| + |y| = 193.7 (tangent to the discs' 12 mm keep-out), every rod ≥ 12.1 from the swept discs; roof a 2-node spine (70 / −70, 0, 62) fanned to the ring; the front nodes dip to z 17 with a window sill between them under the 89 x 73° view from the lens (122, 0, 40). **The whole shell stays above z 0, over the funnel's wall tops (z −4.3), in every state of the descent (the end walls sweep |x| ≤ 153, |y| ≤ 85 at the capture limits; a first draft with its base ring at z −48 rode into the end walls a few mm above the seat):** base rails at |y| 115, z 0, nose and tail bottom nodes (118 / −130, 0, 8), four legs from the rail ends (±100, ±115) to feet at z −45 (TPU caps Ø16 x 3, contact −48, 10 over the funnel's nose beam; the belly skirt at −44.3); rods ≥ 6.3 off every part (the tail node behind the Radxa); longest rod 200, shortest 45, largest cell Ø76. **What the compactness cost the layout (3 Nov): the tail electronics moved from the tail bay (x −118..−178) to flat under the plate's tail (Radxa x −118..−53, UBEC and XR2 beside it, z 7.5..20, over the funnel mouth; XR2 antenna laid along −x), the camera from lens (149, 0, 42) to (122, 0, 40) just ahead of the front discs, the flow sensor from y −40 to −30; the funnel lost the rim on its x walls.** Seated check (tools/seat_check.py): 0 crossings with the funnel and deck for both drones. Node design, loads (frame model) and the saddle ties into the plate: next | C / E |
| Strength (frame model v4 on v13, `runs/scout_frame/v4/`) | 35 g crash (313 N at 912 g) through the saddle ties: **every rod 3.0 fails** (31 of 58 buckle, 12 crash and 22 handling stresses over 600 MPa, first mode 34 Hz, nodes by the fit); **Spark 27 Oct: 3.0 everywhere, accepted** (rods are the fuse, a cheap swap; lift it by the nodes or the plate); the camera mount v2 must reach 100 Hz on 3.0 rods (clips near nodes) | F on E / Spark |
| Balance | **tail bay out of the prop wash, CG in the middle of the props** (Spark 27 Oct, DEFAULT): Radxa on edge and the UBEC behind the rear disks, riding with the catch on the electronics session's mount (round 5 concept 49.2 g + cables 6.3 g, E; Radxa post keep-outs cut); XR2 fixed in the frame at x −110..−94, y −27..−15 (3.8 out of the wash); catch set **2.5 aft** (v13, for the real node mass): CG 0.7 mm off pack in, 0.7 pack out (system_check, x and y); FC IMU offset x −2.50 (PX4) | C on E |
| Camera (one) | DECXIN 2633V2 89 x 73 (E), horizon, **lens (149, 0, 42), close in at the nose, outside the cage, printed PETG only** (Spark 27 Oct): cradle 0.5 clear, lips 6 over and under (x 128..153, z 17..67); mount v1: one PETG print 21.8 g (M), lens hood 4.0 ahead (DEFAULT 3), truss arms into **4 snap clips pushed on from the front after the cage is built** (9 long, bore 6.2, mouth 5.6 into the cage): top (110.5, ±18.0, 61.1) rod 7-8, bottom (122.6, ±18.0, 11.5) rod 14-15; 2 CA'd stop collars; pop 23 N a clip (E) = the fuse; 109.3 Hz (F) | C / M / E / F |
| Funnel fit | funnel band (30 above the plane, inside the opening or 40 past its ends): no link in it; the shell rods leaving the 4 bottom nodes rise through it; 2 shell rods reach it at the nose low node (106.7, 0, −19.0); no tail low node (every node past x −130 about the catch ≥ 91 above the plane); the design center's ramp check decides | C |
| Landing | the 4 bottom nodes are the lowest points; no link lands on them. **Box catch F (PR 155, DEFAULT):** TPU foot caps Ø16 x 3 under the 4 ring nodes, the same as the Overseer's (both drones' side tubes at one height, cartridge 16.2 above the deck, C); 6 mm printed sleeves on the 2 side rods over x ±32 (2 x ~1 g E; they fall away if the ring rods go 6/4); alt: the loop 9.2 lower, ring on the deck | C / E / DEFAULT |
| Props shadow | 3.0 % above, 8.2 % below (plan shadow weighted by r, v13) | E |
| Mass | 912 g all-up (system_check, v13, E): cage 298 (shell rods 70, nodes + caps 203 by the fit to the saved nodes v2, saddle ties 8, tie saddle 17); camera 10 (E) + mount v1 21.8 + 2 collars 0.5 (M) = 32.3 (M + E); the electronics session's tail bay mount 49.2 and cables 6.3 (round 5 concept); bought, latch set and wires 526; budget 500 soft (L) | E |
| Access | swap down (cartridge, pack, plug); 4 receiver bolt keys from below; FC USB-C cable out the tail-left through a cell: 8 / 8; 25 / 25 with the belly mount v1's keys and paths | C |
| Electronics tail bay (mount v2 on v12) | v12 poses, catch −5.0 (C); tail block 15.9 g E (web under the plate to x −31.0, 2 M3 through the tab at (−42.0, ±16.0) C, fin + foot to z 34) + carrier 33.2 g E (4-M3 yoke = lateral fuse, tube spine 14, UBEC box 6, XR2 floor z 21); mount 49.2 g E at (−84.0, −0.2, 10.7) C, cables 6.3 g E; L crash worst 0.27 E; 235 / 476 Hz E; CG 0.56 / 1.49 at −5.0 C (main, camera mount); belly mount tail face x −31.0 (req). `runs/scout_electronics/v2/envelope.json` | C on E |
| Belly mount (concept v1) | PETG 25.0 g E at (2.1, −10.7, 6.8) C: 2 yokes, plate to receiver; receiver 4 M3 inserts (−37.65, ±26.55), (48.28, ±26.55); 4 new plate M3 (−25, ±13), (30, ±13), Bee35 holes empty; tail face x −31; ESC vents x ±18 (641 mm²); flow (0, −40, −30) on a bipod; flow clear air DEFAULT slipstream (10.7 out), alt column (2.6 % under a disk; no pose passes); FC on AIO holes, soft-mount req 5.2 columns, rib ≤ 6.5. `runs/scout_belly_mount/v1/` | C on E |
