sparkiscool/noxen/systems/probe_sim/blossom.png

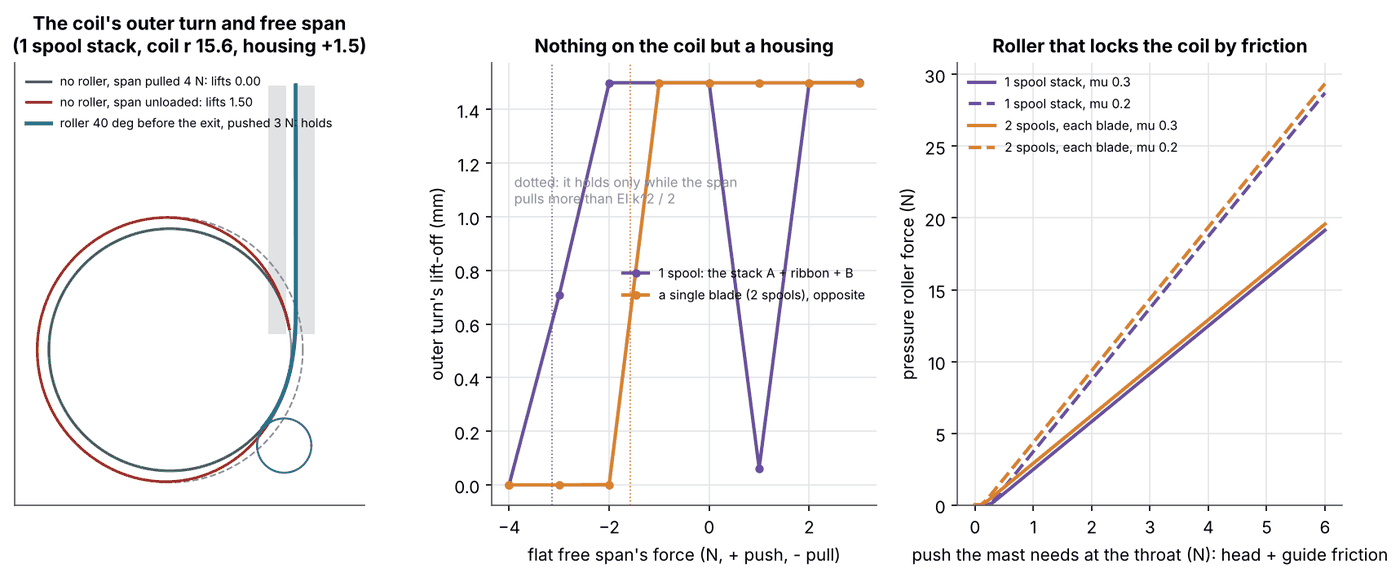
systems/probe_sim/blossom.png
