sparkiscool/noxen/systems/probe_sim/cable.png

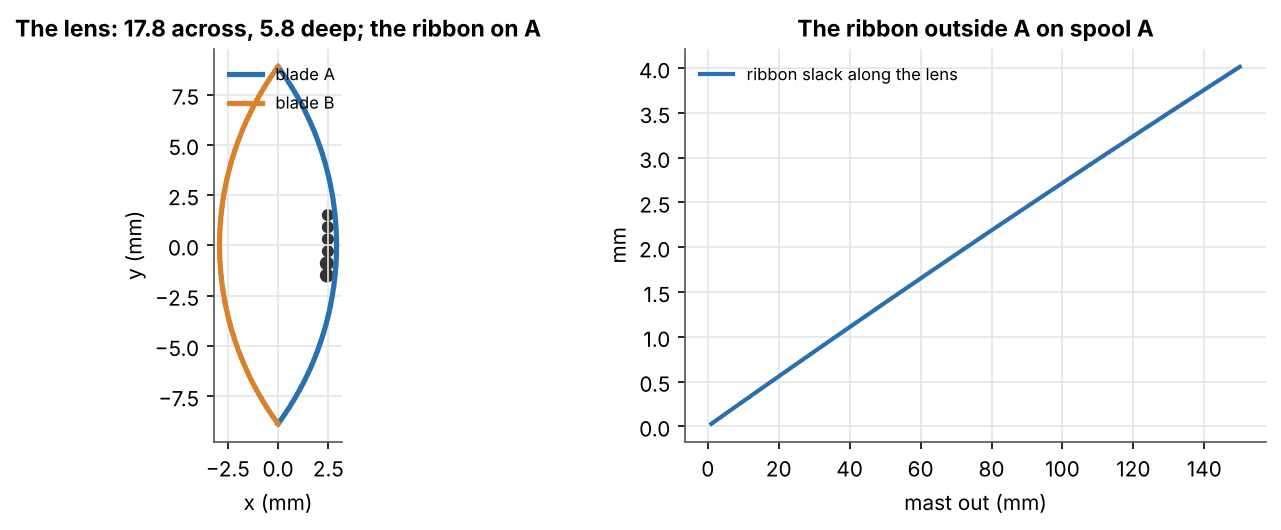
systems/probe_sim/cable.png
