sparkiscool/noxen/systems/probe_sim/coil.png

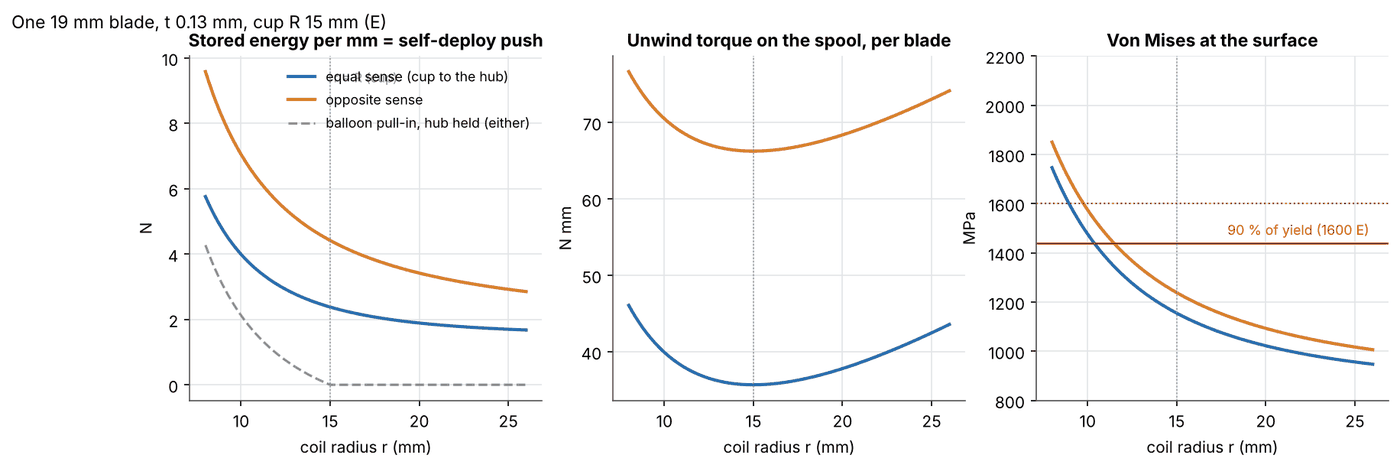
systems/probe_sim/coil.png
