sparkiscool/noxen/systems/probe_sim/drive.png

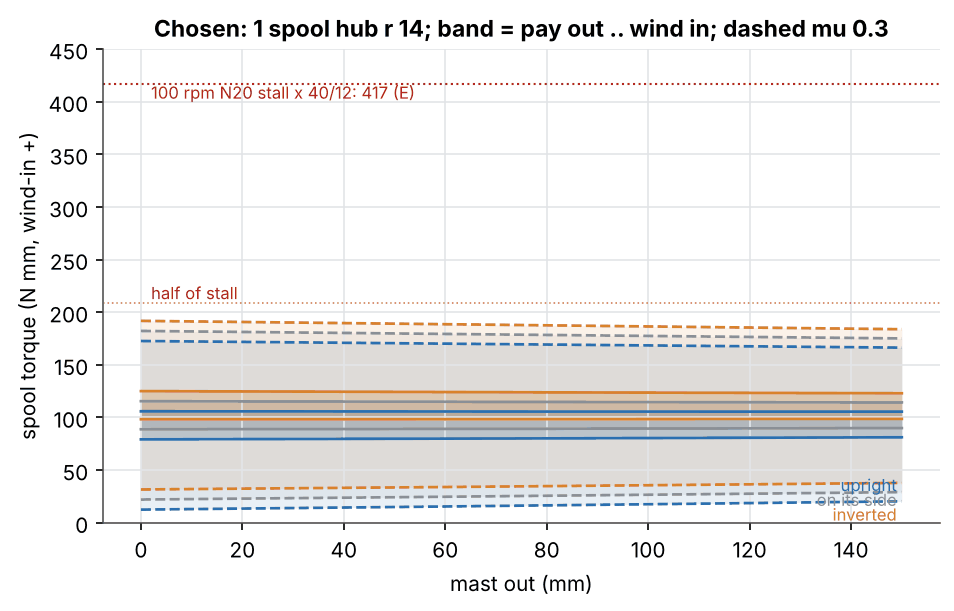
systems/probe_sim/drive.png
