sparkiscool/noxen/systems/probe_sim/fe_fold.png

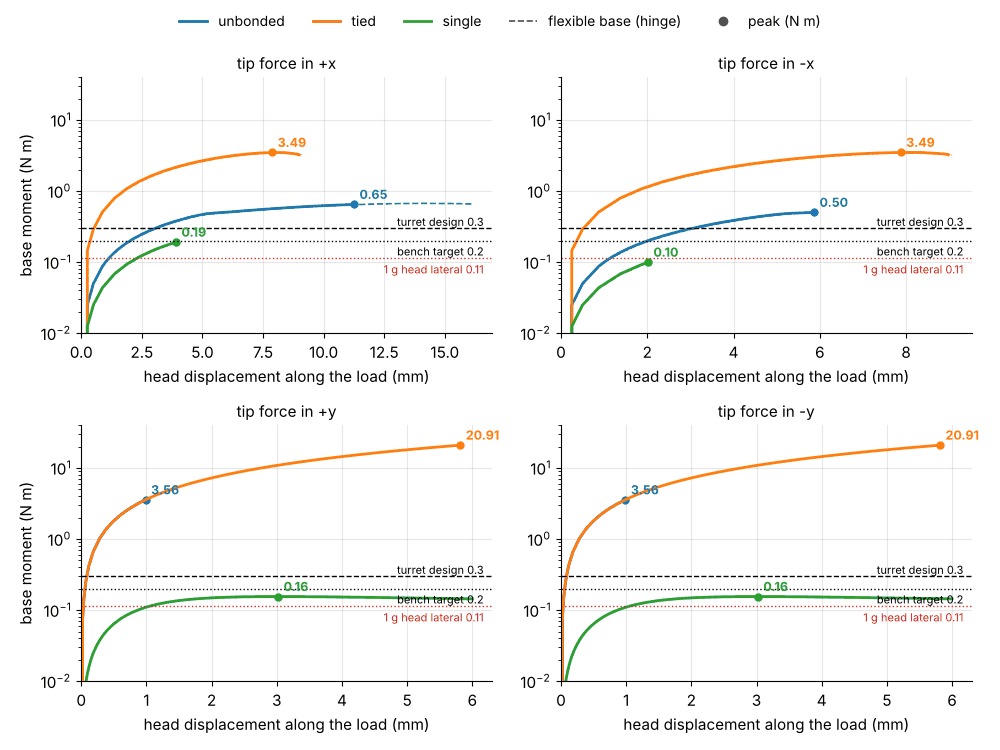
systems/probe_sim/fe_fold.png
