sparkiscool/noxen/systems/probe_sim/fe_modes.png

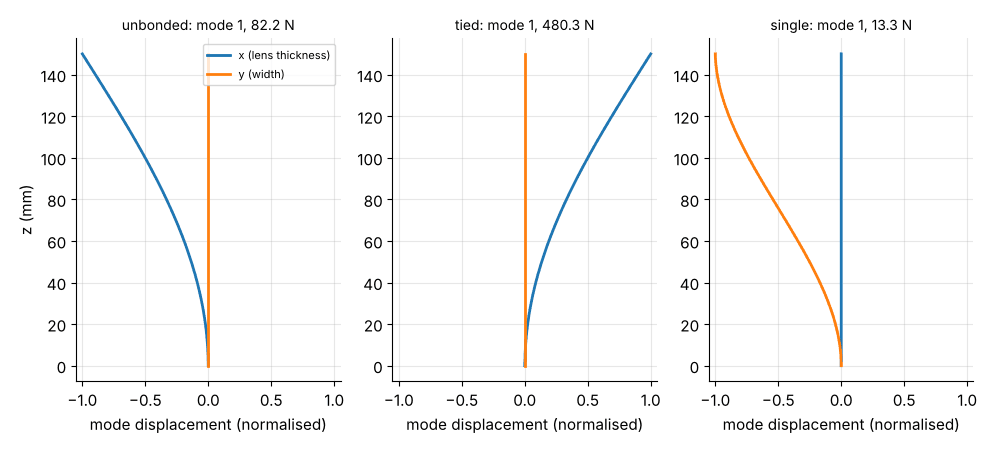
systems/probe_sim/fe_modes.png
