sparkiscool/noxen/systems/probe_sim/fe_transition.png

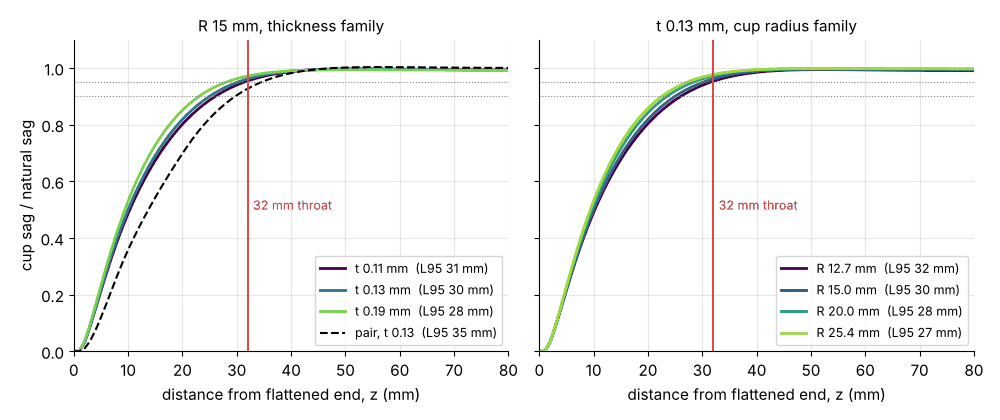
systems/probe_sim/fe_transition.png
