sparkiscool/noxen/systems/probe_sim/fit.png

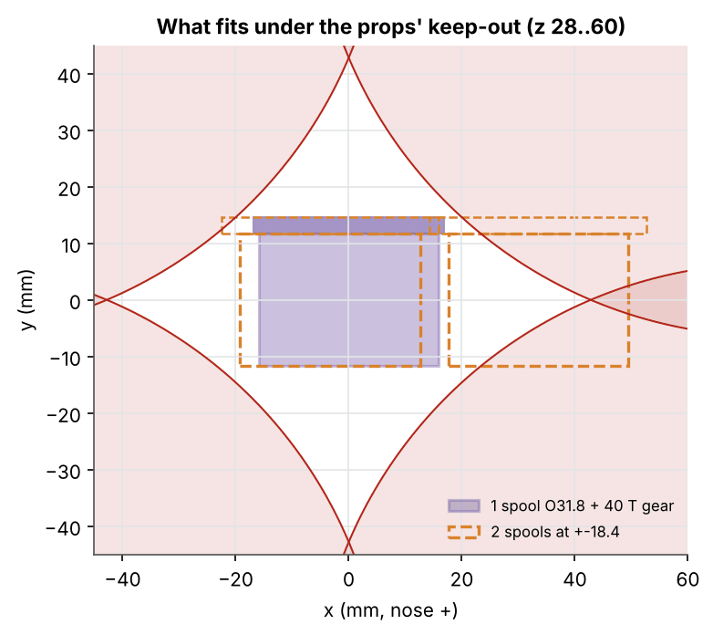
systems/probe_sim/fit.png
