sparkiscool/noxen/systems/probe_sim/hub_min.png

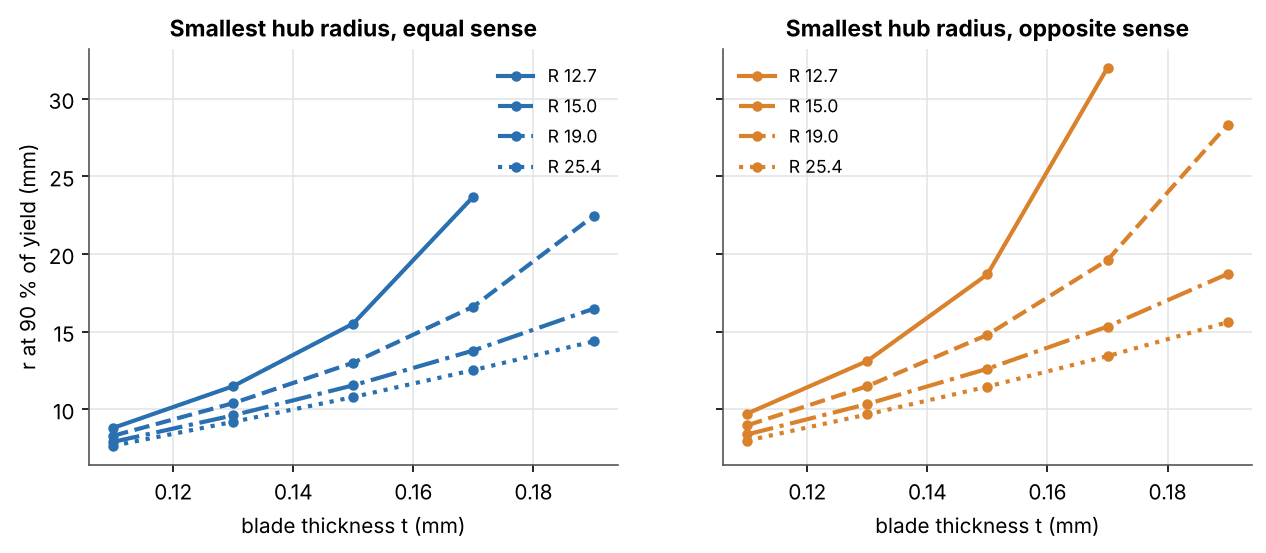
systems/probe_sim/hub_min.png
