sparkiscool/noxen/systems/probe_sim/layouts.png

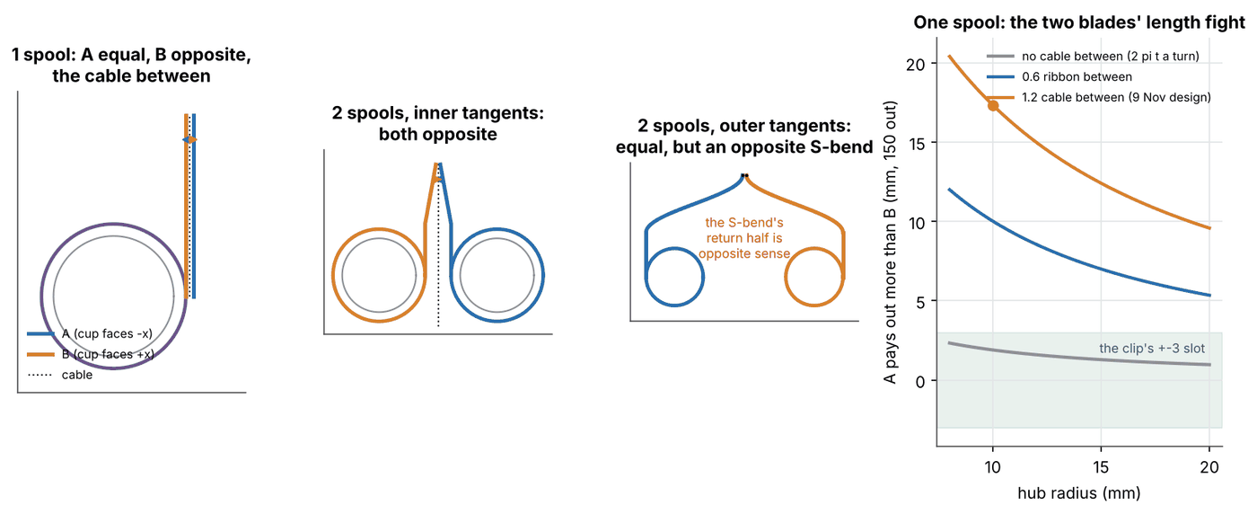
systems/probe_sim/layouts.png
