sparkiscool/noxen/systems/probe_sim/stroke_torque.png

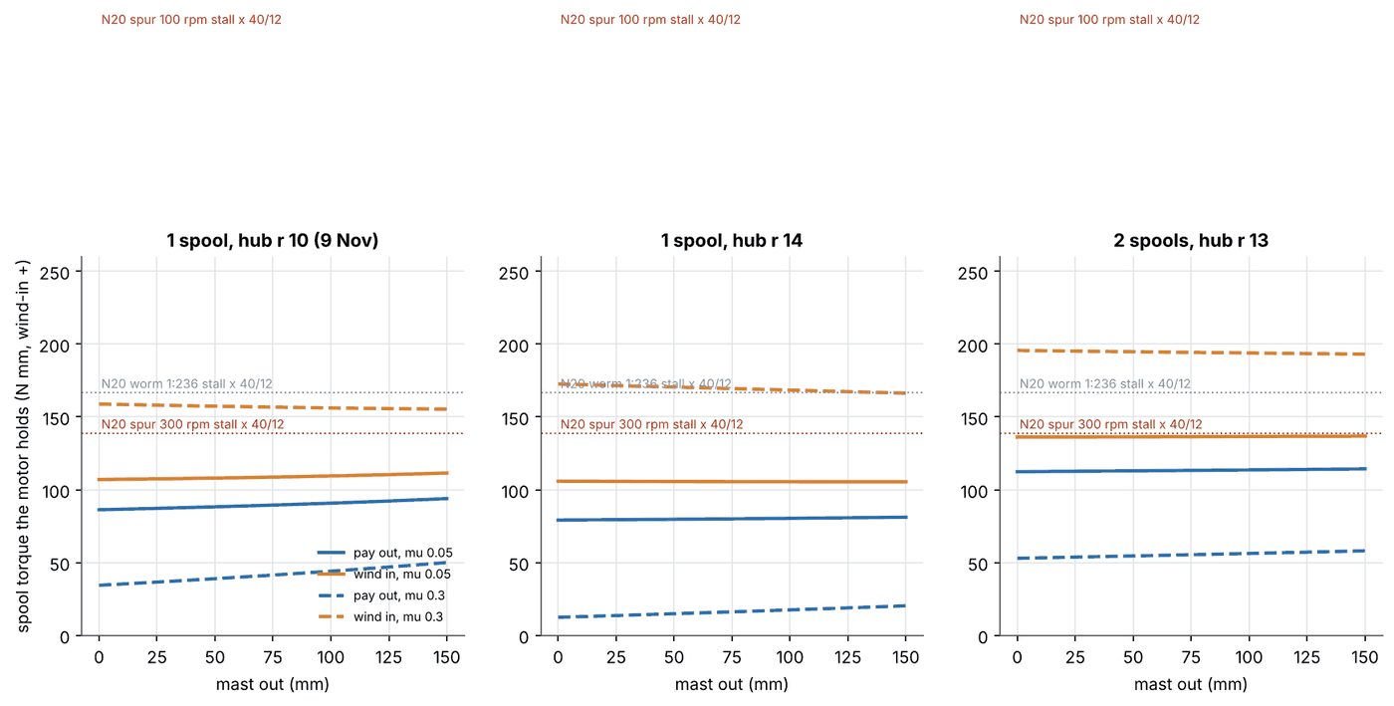
systems/probe_sim/stroke_torque.png
