sparkiscool/noxen/parts/box_arm/ref/README.md

Reference only, copied 13 Nov by the design chat from the older repo (arm v7, never built): the v7 system pass's results
(arm_v7_system.json: frame loads on the rails, V-wheels, hub, cases) and the scripts that made them. Nothing here is imported
by a part; read slices, the numbers that matter also sit in systems/dimensions.md "System box swap: arm".
