sparkiscool/noxen/parts/box_stand_mast/feedback.md

# Box stand (the built demo's mast, kb, bars, cradle keel, toe): notes

## Spark
- 13 Nov, asked in the design chat "The larger arm ring no longer clears your printed demo stand. Which change to the stand do you want?": "Hub 15 mm higher (Recommended)" = reprint the mast 15 mm longer and saw the cradle upstand off the printed keel.

## Design chat (session_01EtHMZPw3VtLv7n2ybfHWpH), 14 Nov: done here because three workers' permission checks refused the stand
- Geometry, in W (hub at the origin, so arm, funnel and seat do not move): the mast is 15 longer, a prism of its own 384 mm2 section let in at W Z -49 (between the kb's top at -52 and the stub's foot at -45): 187 long, 83.8 cm3 (was 172, 78.0). The keel is the printed one (git 33cd639) less everything above its bar's top (W Z -181 as printed): 36.7 cm3 (printed 55.2). The toe is the printed one, uncut (41.5 cm3). kb, both bars, keel and toe sit 15 lower in W (pose z -15); the floor is W Z -216.
- These three part.stl files are that geometry (mast in W; keel and toe in their printed coordinates, to be posed z -15). NOT yet in systems/box.assembly.json or tools/import_box.py on main (their STAND_NOTE, stand_versions and recut_stand still describe the cut keel): a push of systems/ or tools/ restarts every part with no result, so it waits for the runs to land.
- Checked: tools/box_check.py full run with this stand in place (local, 14 Nov): PASS, 0 overlaps. The -90 deg bay's lowest point is W Z -192.9, the keel bar's top -196: 3.1 clear; floor 23.1 under the bays.
- Print: the mast no longer stands on the 180 bed (187). File in print pose on its 60 x 187 side along the bed diagonal (160.5 x 160.5 x 60), 7,385 mm2 on the bed, solid check PASS; the tube's inner ceiling (7,163 mm2) bridges or takes support.
- NOT checked: the stand's strength with the arm v8 on it (the arm, its 11 bays with packs, the 118 N push at W Y 192). The keel bar without its cradle has the 580 mm3 section it already had over W Y 107..137; whether that carries the new overhung weight is open. Do not call the stand done.

## Design-chat worker, 14 Nov: strength with the arm v8 (parts/box_stand_mast/check.py, check.json)
- Method: hand beam checks on the plain sections (mast tube, kb tenon, keel and toe bars, bars), sections measured on the posed meshes; no FE (the pieces are prisms and bars; the result is not near the gate). PCTG allowables by class (topo/material.py), gate 0.5 in every class. Supports: the floor only (free-standing; nothing bolts the stand to the v2 sheets, which are a layout).
- Loads from the system: the arm v8 with 11 bays and packs 9717 g (E: printed at run masses or volume x 1.23, receivers at their runs, packs 7.5 / 2.2 N per bay from box_arm8 bay_mount, bought at catalogue masses), CG W (-2.1, 129.0, -21.4); the turning ring's CG 25.9 off the axle (2.2 N m unbalance at its worst angle); the insert at the drone 106.6 N (flight) / 118 N (misuse) down on the arm at W (0, 192.5, 176); carrying an Overseer 10 N; a dropped Overseer 150 N; axle stall 5.53 N m about Y; handling 3 g down + 2 g side. The stand's own 462 g.
- The sawn-off cradle held the v1 demo's -90 bay module (bay v4i and its XT60 pull, dimensions.md System box structure). In v8 every bay is on the arm's ring: that load is in the 9.7 kg and reaches the stand through the stub. Nothing else needs a new path.
- Results (worst index, case): mast (15 longer, as drawn) FAIL 0.77 standing (sustained; tube W 6438 mm3, 15.2 N m at the kb's top), 0.71 insert at the drone (38.9 N m), 0.86 handling (45.5 N m + 14.7 lateral + 30.3 torsion). kb FAIL: its tenon inside the mast (W 4396) 1.12 standing, 1.04 insert, 1.27 handling. Keel (sawn) FAIL: at least 1.75 standing at W Y 90 on a perfectly flat floor (lower bound: the floor's resultant is at Y 128 standing, 161 at the insert, in front of the bars at Y 62, so the keel carries at least V (y_res - y)), 2.75 at the insert; 7.7 on an uneven floor at the Y 175 notch. Toe: nothing on a flat floor; FAIL 2.11 on an uneven floor (20 x 10 bar). Bars FAIL 0.84 standing, 1.22 handling on an uneven floor.
- Fit FAIL: the arm v8's stub (parts/box_arm8/make.py) is a Ø90 flange with 4 M5 at r 38 on 45 deg, i.e. X +-26.9, Z +-26.9; the mast's face is 40 wide with holes at X +-10, Z +-30 (stub v3). The stub does not bolt to this mast.
- Not changed: no piece redrawn. The fix is a new stand, not a piece: the arm hangs 130..190 in front of the mast and the floor has to push back under the ring, where the ring's sweep leaves 20 mm over the floor at X 0, 37 at |X| 100, 76 at |X| 150. Requirements for it (a stream of its own, engine parts): (1) a mast face for the v8 stub (Ø90, 4 M5 at r 38 on 45 deg, W Y 0) clear of the axle stepper (X -71..-29, Y -48..24, Z 19..61) and the PSU box (X 42..157, Y -66..-36, Z -170..45); (2) the wrench at the stub face per case in check.json (standing 95.3 N at Y 129 is the one that sets the mast at SF 10; the insert 106.6 N at Y 192.5 sets the base); (3) a base bearing on the floor forward to about W Y 250 as two rails at |X| >= 100 tied behind the hub (Y < 76, Z < -155 is free across) to the mast's foot; (4) pieces within the 180 bed, joints carrying 45 N m. Print nothing of the stand until then: the 15 longer mast is not to be printed.
