sparkiscool/noxen/parts/box_funnel/feedback.md

# Landing funnel (parts/box_funnel/make.py: frame, end walls, strips, drive): notes

## Spark
- 13 Nov: "do a full optimization run over the whole design and build the arm as well make sure things all are compatable and get it ready to print"
- 10 Nov: both packs' latch sets must fit the funnel meant for them ("yes we need to make the battery fit the funnel do whatever you need"); the Overseer seat moved so both grip points line up.

## Design chat (session_01EtHMZPw3VtLv7n2ybfHWpH), its reading, not Spark's words
- Drawn, never through the engine; its solid check ran out of memory here and is unverified. The end-wall drive is a placeholder.
- The seat and hole were resized to the real latch v7 sets (hole 177 x 57, seat 68.8 wide, CX -0.48): parts/latch7/make.py `--fit` is the check, both packs, keep it clear.
- systems/box.assembly.json (the whole box) still shows the old funnel, latch v5/v6 context meshes and the arm v7 meshes.

## Design chat, 13 Nov: state handed to a fresh funnel worker (the first one stopped after three poses of the design in one context)
- Done and passing its checks: funnel v5 (two engine halves on four cross arms, lead-screw wall drive, four steel hold-down keys on the end walls into the receivers' end notches), the turned pose (tools/seat_check.py SEAT_TO_W, one definition: both drones nose toward the hub side), tools/box_check.py PASS with 0 overlaps against arm v8 (it reads parts/box_arm8/make.py funnel_keepout(): W X -36..69, Y 54..79, nothing below Z 161.5) and latch v7. Audit smokes at SPEC h: box_funnel_arm 0.241, box_funnel_half_tail 0.381.
- NOT passing: box_funnel_half_nose, audit 0.60 (limit 0.5), case "Overseer off centre onto the +y face, at its ear", peak at seat (57.9, 58.3, -32.6): the rail's section just inboard of the nut block's lane (the lane, |y| 46..58, h 0..12, leaves the 3 mm wall as the only web between the rib above and the room under the ledge). The tail half has the same section and passes; what differs is not found (nose rib runs to x 88, tail's to 76; the nose beam is 46 further from its ear).
- Tried, did not move it: a wider link from the ear to the nose beam (0.61 -> 0.59), a 15 mm deep run outside the arm's head from the ear to the beam (0.59), closing a 0.6 fin at the motor plate (0.60).
- Not tried: the audit's stress field for that case in both halves side by side (look before changing anything more); a web outboard of the block lane on the -y side only (no switch bar there), dropping the mirror symmetry; the nose beam as two stubs over the rail disc (seat x 114..138) with its own arm variant.
- Open besides: the stand's keel and toe are cut back from the -90 deg bay as geometry only (strength unchecked; Spark's printed demo keel would need the same cut); the enclosure sheets need 8 holes o 4.5 at W Z 121.3; the M4 screw shafts are cut to 62 (Spark does not cut metal if a part to length exists: look for one); the topo suite's slender-arms test fails the same before and after the audit.py change (an engine matter, reported to Spark).

## Funnel worker 2 (session_01EtHMZQEmMbreZjxCMTMFTs), 13 Nov: what was found and changed
- Cause of the nose half's 0.60: a fin of room. The nut blocks' lane stopped at |y| 58.1 and the room ends at 59: 0.9 mm of room, one cell at h 2.2, the rib's lowest fibre ending on the motor's drawn front plate. A second one inboard (0.67 once the first was closed): the wedge between the sloped side wall's back and the lane, under a member wide above h 6.8. The tail half has both; its grid puts that cell among the ones left out beside a loaded node, so its 0.38 hid it. Nose and tail were never different.
- Fixed in make.py: the lane runs out past ROOM_Y and in to the wall's back above the height where the wedge is under 3.2; the joint M4's nut pocket is open to the side. topo/audit.py room_strength now says when the peak sits in room one cell thin and gives the fin's box (test in test_topo t_audit_room_full).
- With the fins closed the honest peak was the rib beside the joint flange (0.53 nose, 0.42 tail): the joint held the rail over |y| 42..60 only. Now: a second M4 at |y| 83, z -24.5 outside the rib (in the rib its nut pocket necked the outer fibre, 0.57), the rib 77 wide (was 74; 88 is the bed's limit for the flange), its root down to z -41 over x 0..22. Steps or tapers in the rib's width near the joint were notches (0.46 to 0.64): it is one width from the joint on.
- Audits at SPEC h: nose OK 0.469, tail OK 0.410, arm OK 0.241. What is left at the peak: the drawn side wall at the inboard end of the tab's slot, beside the motor plate (nose), and under the loaded face near the switch pocket (tail); the level elsewhere is 0.3 or under. The margin is thin for the runs (thinned estimate 0.99 / 0.87): if a run's result fails there, the slot's end is the place (it ends 0.6 from the plate; the travel fixes both).
- tools/box_check.py full: PASS, 0 overlaps; latch7 --fit ok for both packs. Closest landing pass of the Overseer is 1.0 mm (cage node 0 at seat (-76, -78, -17), the wider rib's corner).
- Screw: no shaft to length exists. Amazon lists this gearmotor with M4 x 34, 55 or 100; the travel needs 59.3 (plate 3.5 + half block 6 + 48.2 + half nut 1.6). The page's bought list now names the M4 x 100 (B0GDTKHL8T), cut to 62; it named the 55 before, which is 4.3 short. To use the 55 uncut the walls' open position would have to come in from 11.0 to under 6.7 (the latch stream's number).
- Stand: checked, FAILS. The page's keel and toe were cut more than their note said (the note gave the last cut only): the keel keeps 30.0 of 55.2 cm3, its cradle is gone and its bar is 9.2 high where it was 20; section modulus 89 mm3 where it was 5637. At index 0.5 it carries 3 N at the toe's front edge (uncut 193 N). The arm v8 bays pass 8.1 mm over the floor on the centre line, so no keel fits there: the spine has to become two rails outside |X| 70 or the hub has to stand 15 higher. Not redrawn: it moves the box structure (mast, sheets, the demo Spark printed) with the arm. Written on the page (tools/import_box.py STAND_NOTE).
- Still open: the enclosure sheets' 8 holes o 4.5 at W Z 121.3; the topo suite's slender-arms test (engine).
- First runs on main (13 Nov, run 265): half_tail PASS 0.467, 246.5 g; arm PASS 0.448, 63.7 g; half_nose FAIL 0.545 (245 g) at (24.9, 73.7, -30.4): the rib's lower outer fibre over the motor, where the motor's side entry keeps the rib 14.4 deep. Solid check PASS on all three.
- Fix: the rib is 88 wide (the beam's width) from the joint to x 50 and 77 beyond; the joint's outer M4 moved into the rib at |y| 68, pocket open to the top. Filled solid the rib reads 0.32 (was 0.47). An 88 rib over its whole length and a square top edge hit the Overseer's v8 foot nodes landing 20 off centre (1066 mm3, then 59): hence 77 beyond x 50, the nose rib ends at x 84 (was 88) and the top outer edge is chamfered. No audit check added for this fail: the room read 0.469 filled and 0.545 built, and no rule on that ratio holds (the arm read 0.241 and 0.448).
- After the fix: audits nose 0.434, tail 0.413, arm 0.241; box check PASS, 0 overlaps, with the Overseer's v8 nodes and head mount v12; closest Overseer landing pass 1.3 mm; latch fit ok. The uncut M4 x 100 shaft was tried: it crosses the Overseer's cage tubes in 17 landing states, so the cut to 62 stands. Topo suite 46 / 47 (slender arms, known).
- Stand (Spark 13 Nov: hub 15 mm higher, mast 15 longer, cradle sawn off the keel): not drawn. This session's permission system refused the work.

## Funnel worker 3 (14 Nov): the halves' print pose, the print kit; the stand not done
- The halves (build -z, upside down) passed their runs standing on 40 to 66 mm2: the side walls' top edges were square to their 55 deg faces (a line) and the rib's room ended 1.0 under that plane. Nothing in the engine makes a result touch the bed (the build direction is only the layers' weak axis). Now in make.py: TOP_Z (the bed plane, seat z -16.3), RIM (each side wall's top edge level over |x| 0..90 with a drawn flat behind it out to |y| 61, 3 thick: 2 x 7.0 x 90), the rib's room and the joint's outer flange end ON that plane, the rib's chamfer is the same plane as before. Drawn flat on the bed 1452 mm2 a half; topo/audit.py `bed` refuses a setup under its `bed_min_mm2` (1200 here; reported for every part, test t_audit_bed).
- Width: the half stays 176 on the 180 plate (the beam, 42 over the bed); what lies on the bed is within |y| 79, so a 5 mm brim fits. No change to the laps or the arms.
- Seat finish: upside down the ledges' seat face is an overhang and takes supports. LIP 0.4: the plastic seat face stands 0.4 under the seat plane, the TPU strips (unchanged, 2.0) stand proud, so the drones rest on TPU only and a support scar never carries. Latch fit unchanged (rests at 0.0 / -0.01, on the strips).
- Audits at SPEC h with the rim: nose 0.384 (was 0.434), tail 0.399 (0.413). tools/box_check.py full PASS, 0 overlaps (closest Overseer landing pass 1.4); latch7 --fit ok both packs.
- Kit: tools/funnel_kit.py writes print/<name>.stl in print pose, measures it there (size, flat on the bed, overhang), gates that file, pictures it (parts/box_funnel/kit/), all in parts/box_funnel/kit.json; the page's print table is that file. End walls measured in eight poses: neither the back nor the sliding face lies flat (0 mm2: the corner hips fold out of the face's plane, the key bosses stand on the back); they stand on their foot, 252 mm2 with a 5 brim, 711 mm2 of overhang within 6 of the bed (tabs, nut blocks, bosses), none on the sliding face. Keys: 3 x 3 x 16 round-ended, to length, on the bought list.
- 46 other engine setups read 0 mm2 of drawn flat on their bed plane (the nodes, the arm v8 carriage and lift among them): the check is asked per setup, not forced on them.
- Stand (mast 15 longer, cradle sawn off the keel, the stand in box_check, the mast's print file): NOT done. This session's permission system refused reading the stand's meshes, twice, as it did for worker 2. Nothing of the stand is changed; the page's stand note stands.
