sparkiscool/noxen/parts/overseer_head_mount/feedback.md

## Spark 9 Nov
- "weird disconnected members, i thought we were over this issue": no member may end in air. Check every result with a skeleton-tip check before reporting (tips away from every drawn attachment).
- Option A of the 8 Nov study: L2 as far back as allowed outside the cage, cameras behind the cage front with maximum vision, sockets one socket back on the cut rods, head rods cut off (crossbar saddle).
- 9 Nov (Spark: go): cut the cage crossbar 15-16 in the middle so the L2 moves further back. L2 base 40 back and 40 up from v9's (384.0, 0, 51) = (344.0, 0, 91.0), axis unchanged (15 deg below +x). Study with the bar removed (head rods already cut): rods 52 clear, props 47 clear, 1 % of the L2 field blocked; at 60 back 9 %, 80 back 13 %. The saddle goes; the mount gets one socket on each cut end of the crossbar (it bridges the gap, so nodes 15-16 stay tied through it). Spark needs the crossbar cut positions in inches. Re-check the cameras (lens (340, +-30, 10)) against the new L2 field and the rods.

## 12 Nov (Spark) on v11 as the page shows it
- "the headmount on the artifact doesnt even fit the rods and also doesnt require the front rod to be cut at all also its still too forward"
- Design chat's check of the page (12 Nov, build da656d4): the page draws the crossbar 15-16 whole (rod mesh at its old length, 23 mm of it through the mount's solid); node 17's 4 tubes end at the mount face in half-pipe channels open to -x (a ring 5.2 round each tube 18..33 from node 17 is only 21-38 % in the mount for 17-15 / 17-16, 62-67 % for 17-18 / 17-19), so on the page the rods look beside the mount, not in it; the L2 base (344, 0, 91) is still ahead of the crossbar line (x 354 at z 129), so cutting the bar buys nothing visible.
- So: the rods must visibly seat in full sockets; the crossbar cut must be what lets the L2 go back (L2 behind the bar line, through the gap) or the bar stays whole; the L2 and cameras further back than v11. Spark (8 Nov): "i can also cut the rods more if thats better". The page must draw every cut rod at its cut length.
