sparkiscool/noxen/parts/overseer_arm_front_pad/feedback.md

## Spark 9 Nov
- Same motor mount as the rear arm: entirely solid, circular, a lot of material ("so it doesn't crack and break again"; "the motor snapped off along with the place it mounted to, make sure that doesn't happen again").
- "I already replaced it once so now it needs to be two nodes length back not just one": the sockets two socket lengths back on the cut rods (tubes 34 toward the root, spokes 24 out from the arm node). Spark cuts the rods flush at the current pad's socket mouths and needs those cut positions in inches.
- The ring under the pad stays on the front pad (without it the pad stood on four posts and reached 0.41).
