sparkiscool/noxen/parts/overseer_arm_rear/feedback.md

## Spark 9 Nov
- The arm design itself is good. The ENTIRE motor mount must be solid, also under the circular plate: "we need a lot of material there so it doesn't crack and break again". Base completely circular. (Setup now: solid O36 x 14 pad on a solid 8 deep cone, solid_ok.)
- "Last time the motor snapped off along with the place it mounted to, make sure that doesn't happen again" (limit 0.2 on the arms; print on its side, 100 % infill at the motor end; motor heat to be checked on the test jig).
- The under-pad flaps "do nothing, remove them" (rear: removed; it passed without them).
