sparkiscool/noxen/parts/box_arm/ref/box-arm.md

# Box swap arm v4: cartridge long side along the axle, gripper squeezing tangentially (16 Oct 2026)

The arm of the swap wheel (`nox/box/box.md`): everything that turns on the axle, plus the stub axle it turns on. Bay modules (linked, they are the box's standing frame; the casing is retired, Spark 16 Oct 21:09) are in `nox/box/box-case.md`; the stand in `nox/box/box-stand.md`. Numbers: `nox/dimensions.md` section I and `nox/box/arm_layout.py` (the one source the scripts read; the v4 block at its end). Scripts: `nox/box/` (meshes are rebuilt from them in each chat): `arm_layout.py`, `arm_pose.py` motor poses, `arm_cad.py` drawn bodies (`stub`, `head_parts`, `gripper_v4`, `fingers_and_racks`, `pinion_u`, `bay_module_parts`), `belt_clamp_v2.py` head belt clamp (+ `belt_clamp_v2_figure.py` section drawing), `arm_topo.py` pipeline, `arm_run_hub.py`, `post_hub_v5.py` (hub checks + print pose), `export_hub_set.py` (the drawn print set in print pose; `export_hub_set.py <name>` rebuilds one part), `arm_run_head.py [h] [cm3] A|B`, `arm_run_baymod.py`, `arm_kinematics.py` swap cycle + exact clearance sweep, `arm_wiring.py` harness numbers (doc `nox/box/box-wiring.md`), `post_v4.py`, `arm_artifact_build.py` + `arm_artifact_template.html`. All C unless tagged; hardware sizes not measured are E, CHECK. Live state of every arm part: `nox/current-parts.md`.

## How it got here (15 to 18 Oct)
- **v1 (15 Oct):** one bar, heads 180° apart.
- **v2 (16 Oct 00:00, Spark: heads one pitch apart, current parts):** 90° on crossing bars; failed the sweep (a turning pack's corners reached r 108). Sweeps now sample every 2° of every turn.
- **v3 (16 Oct 02:50):** glide rides under the pack, two 112 bars flat (Spark: 2040 on hand is 230+), glued bay ring (Spark 02:36). Built with the cartridge's x along the axle.
- **v4 (16 Oct 20:30):** Spark 17:34: both cartridges long side along the axle, squeezed tangentially (one head for Scout and Overseer). Spark 19:28: bays bolted to each other so any one swaps out. Cartridge v3 (19:15) numbers; main contacts are the receiver chat's copper strips + sprung copper shoes on AA springs (16 Oct 20:08), copied into every bay. Hub v3, motors, bars, belts, glides and idler ends carry over unchanged.
- **v4c / v4d (17 Oct 01:18..04:29):** balance leads dropped (01:18). Universal bay modules (02:00..02:02): every bay one module, Scout receiver centred, gripper tab line **Y_C 175** (was 136); 30° pitch, **9 bays, 90° drone opening** (02:27: as much as the funnel allows); bolted long side to long side with **M5 + nuts** (04:28 / 04:29). DS3218 servo from Spark's caliper photos (03:23).
- **Belt clamp (Spark 03:12: "we have no way to connect the belts"):** v1 (03:40, printed tooth grooves + cover plate) did not work (Spark 15:35); **v2 (15:40) = loop and pin**, taken from proven printer and robot-kit clamps (section below). Heads A and B run as v5 with v2.
- **Stub v3 + −90° cycle (18 Oct, arm chat):** stand v5e puts the stub on one 2040 post and mounts only the −90° bay, so the stub is redrawn for the post (section Stub v3) and the swap cycle picks and returns at −90 (section Swap cycle).
- **v5 (23 Oct, arm-v5 chat, Spark: no 2040 bars):** printed V-rails on the hub posts, 3-wheel bearing carriages, rack and pinion on the head motors (section v5 below). Bars, belts, idlers, idler ends, T-nuts and the head 20Ts go. v4 (sections What it is, belt clamp, axle drive) stays the demo build on hub v5; v5 needs hub v6 (motor seats moved, detent tower moved).

## v5: printed V-rails, bearing carriages, rack and pinion (23 Oct 2026; numbers and checks `nox/box/arm_v5_layout.py`, result `runs/arm/v5-layout/`; **24 Oct: rail, wheel, carriage, stroke and bolt numbers superseded by the section "v5 mechanism drawn" below and `runs/arm/v5-layout-b/`**)
Each head rides a **printed PETG V-rail** bolted to hub v5's four posts (same bolts, M5 inserts in the rail foot) on a **3-wheel carriage** printed into the head: **V-wheels OD 24 on 2 x 625ZZ each**, M5 axles through the carriage plate, two fixed on the rack side, one **eccentric** opposite (0.8 throw M5 spacer, the openbuilds V-slot pattern copied in print). The drive is a **16T m1 printed pinion on the head motor's D-shaft** meshing a **71 m1 rack** printed on a web of the carriage. No belt, idler, clamp, tension or endstop part on the heads; the axle drive (80T sun + spliced loop) is unchanged.
- **Rail (one design, A / B differ by the inner insert row):** Y 74..94 like the bar it replaces, r 29..134 (1.5 off the 80T flange); body X ±9, **90° ridge on both faces to X ±12 at Y 88 ±3, tip truncated at 11.5** (so the wheel groove's apex never bottoms); foot pads X ±16 x 6 (Y 74..80) only at the posts with the 2 x M5 inserts each (X ±10; r 35 / 38.75 and 76); a 4 x 4 servo-ribbon channel in the top at X −8..−4 with a 3.2 mouth (ribbon slid in from the end, DEFAULT). ~44 g each (E; a 112 2040 is ~90).
- **Carriage (head v6 feature, drawn):** plate Y 94..98, X −28..28, u 0..46 (the head body generates from Y 98, 0.7 later than the v4 glide); wing X 28..46.5 over the fixed wheels out to the rack web, u 0..30; **wheels at X ±22** (groove bottom X 12 on the ridge apex line, rim 1.0 off the rail body), Y 83..93, at (22, u 10), (22, 38), eccentric (−22, 24); nylocs Y 79..83; **rack web X 40.5..46.5 x Y 64..94 x u −41..30**, teeth on its +X face at Y 64..73 (pitch X 45.5, tips 46.5). Head B = head A mirrored in X (rack and eccentric on B's −X), as the gripper already is.
- **Pinion and motors:** 16T m1 (r 8, tip 9), teeth Y 64.5..72.5, boss Ø14 Y 56.5..64 with an M3 grub on the D-flat; axis at head X 53.5, Z 55: the pinion stays 6.4 / 7.0 inside the rack at the drone / park. 50.3 mm per motor turn, the 57.6 stroke in 1.15 turns. **Motors v5 (arm frame): A (53.5, 55) turned 45.8°, B (−55, −53.5) turned −135.8° (edge toward the axle, nearest 59.5, far corners r 100.1), axle (53.9, −43.7) at −39° on C 69.4** (balance search with the v5 motors: residual 10.1 g·m E, v4 4.4; the loop band at −39°). Drop lane to r 34 (2.5 off the 80T flange; the sweep chat's number).
- **Checks (C, 2D over 4 x 4 stroke states, both heads park / wait / bay / drone):** every pair that shares a Y band ≥ 1.0 (the wheels to the rail body 1.0 and the nylocs to the rail feet 1.4 are the designed minima; everything else ≥ 1.5); park bisector 4.0 (rule 1.5); carriage corner r 138.5 at the drone and the wheel rim r 141.3 at Y 83..93 (v4 glide corners 135.7, bar corners 135.5; stand arm lane r 145.5): **the bay module's keep cylinder grows from r 136.5 / Y 70..95.5 to r 143 / Y 70..98 in the next module version** (the v4i modules run Y 133..221, so nothing printed is touched). Loads (E): 20 N insert push = 1.5 N·m on the carriage, 55 N on a wheel flank; pinion separating force 7.3 N bends the hanging rack web 0.10 at the drone (0.2 backlash).
- **Detent moves (hub v6):** the v4 roller arm (hook at (−2.2, −66), anchor (−39, −56), tower (17, −29.4)) sits where head B's rack web now runs; re-place with `detent.py search()` on the v5 obstacles. 2D candidates with the same lever geometry: **roller angle −45° (ring v1 unchanged: notches every 30°), pivot side −1: roller (18, −18), pivot (7.4, −28.6), hook (35, −56.2), anchor (61.9, −29.3), min gap 2.9**; tower column near (16, −38) clears the loop band by 6 (E). −45 / +1 and −75 / +1 also clear (2.1 / 2.9). The holding margin with 10 g·m of unbalance: 0.366 + 0.10 = 0.47 N·m vs 0.554 (two springs): 1.19 (was 1.51); keep two springs.
- **Compaction (R 100 fixed; the box length is the funnel mouth, 320 on Y_C, back to the electronics at Y −66):** v5 on the posts with the universal modules keeps Y_C 175 and the 403 enclosure (DEFAULT, the v4i modules are sliced). **C1 Scout-length modules: Y_C 138, modules Y 94..184, enclosure 366.** **C2 rails on the motor plate (hub v6 without posts, rail Y 54..74, pinion plane Y 55..63, carriage plate 74..78): Y_C 118, modules 74..164, enclosure 346.** Height and width unchanged. Spark decides (`current-parts.md` Spark section, Decide: arm v5 stack).
- **Parts:** out 2 x 2040, 2 idler ends, 2 idlers, 2 belts + connectors, 8 T-nuts, 2 x 20T, 2 glides; in 2 rails, 6 V-wheels, 12 x 625ZZ, 6 x M5 x 25 + nylocs, 2 eccentric spacers, 2 pinions, 2 grubs, 8 M5 inserts, 2 racks (in the heads). Per arm about −120 g (E).
- **Next:** rails A / B v1 + V-wheel v1 + pinion v1 drawn (`arm_cad`, solid check, print pose); detent re-placed; hub v6 generated (v5 seats, tower at the new place, 1.0 under the 80T kept); heads A / B v6 with the carriage (plate, wing, web, wheel bores, the wiring entry moved to X −6) replacing the glide and the clamp; `arm_kinematics.py 1.0 all` with the v5 meshes; artifact "Nox Box Mechanism" shows v4 / v5 / v5-compact.

## v5 mechanism drawn (24 Oct 2026, arm-mech worker; `nox/box/arm_v5_cad.py`, layout `arm_v5_layout.py`, checks `runs/arm_rail/v1/checks.json`)
Rails A / B v1, V-wheel v1 (x6), 16T pinion v1 (x2) and the printed eccentric bush v1 (x2) are drawn (manifold3d), solid-checked and saved in `print/` (`box_arm_*_v1.stl`). The carriage itself stays a head v6 feature; `arm_v5_cad.carriage()` is a drawn proxy from the layout numbers for the fits, the sweep and the motion artifact.
- **Layout changes forced by checks (round DEFAULTs: Y_C 175, v5 rails on the hub posts):** (1) rail top Y 94 → 93 (C): the carriage plate (Y 94, C) sat at 0.0 on it, now 1.0 (C). (2) **Rail to post: one M5 x 16 socket head per post, down from the rail top at X 0 (C; counterbore Ø9 to Y 84, Ø5.5 through, C) into an M5 heat-set insert in the hub post top (hole Ø6.4 x 8 at X 0, E)**; was 2 x M5 at X ±10 from below into rail inserts: the inner posts (r 35 / 38.75) sit over bearing 1's shoulder, so no bolt head reaches them from below once the hub is on the bearings (hub v5's holes are blind at Y 52, M), and from above at X ±10 a head crosses the ridge and the wheel path. Alternative: cross bolts along X through cheeks on the rail foot and the posts (heavier, hub change too). (3) Ribbon channel centred, X −2..2, Y 89..93 (C), flanks tapering 4 → 3.2 (C) at the mouth (was X −8..−4: a 1.0 outer wall); the head's wiring entry moves to X 0; the counterbores open into it at the posts (the ribbon spans the Ø9). (4) Drone insert +6 (hook latch, E): stroke states park 32 / wait 81 / bay 86.1 / drone 89.6 / **drone insert 95.6** (C); the pinion stays ≥ 6 inside the rack only with the **rack web to u −47 (C, was −41, rack 77)**. **The carriage moved inward on its plate: wheels at u 4 / 32 / eccentric 18 (C, were 10 / 38 / 24, wheelbase 28 kept), plate u 0..40 (C, was 0..46)**: with the old set the +6 put the wheel rim at r 147.3 and the plate corner at r 144.3 (C) at the drone insert, past the r 143 module keep and the stand's r 145.5 arm lane; now r 141.3 / 138.5 (C), as before the push. Rail end stays r 134 (C): the outer wheel contact at the drone insert is r 127.6, 6.4 of ridge past it. **Bay module keep cylinder (next module version): r 136.5 (unchanged, C) to Y 98 (C, was 95.5)**: at a bay the carriage reaches r 131.9 (wheel rim) / 129.2 (plate), the rail tip r 134.5 (C). (5a) **Park hard stop** (box electronics v1: homing without endstops): a block X ±9 x Y 93..97 x r 27..31 (C) on each rail's top at the inner end; the carriage plate's inner edge meets it at z0 31 (C), 1.0 inside park; rail A's r 35 counterbore cuts through it (the M5 head passes). Homing: drive inward at low current to the stall, z0 := 31, go to park 32. The rail starts at r 27 (was 29: the 80T, ring and collar end at Y 72, the rail is Y 74..93). Heads v6 keep nothing at u < 0 inside X ±10, Y 93..98. (5) **Eccentric = printed bush** (no bought spacer): the carriage plate grows a boss r 8.6 (C, a 3.0 wall, the boss rule) round a Ø11.2 bore at (−22, u 18) (plate to X −30.6), head keep-outs Ø10 x Y 98..106 over every axle (head + key) and Ø26 x Y 98..101 over the bush (13 wrench) (C). 2D layout recheck (`runs/arm/v5-layout-b/`): every carriage / rail / motor gap ≥ 1.0, bisector 4.0 (C); the detent at −45° no longer clears (−1.32, C) with the longer rack tail (u −47): **re-placed at −135° (section v5 detent below)**.
- **Rail v1 (A / B, PETG):** body X ±9, **full depth Y 74..93** (C, DEFAULT; the layout's foot-only bottom left 13, 19 is 3.1x stiffer about X), r 27..134 (C); 90° ridges on both faces (X 9 → 11.5 flat, Y 85..91, C), tapered to X 10 over the last 2.5 (C) at both ends (the wheels slide on from the outer end); foot pads X ±16 x Y 74..80 x r ±10 (C) at the posts (clipped at r 27); the park stop block on the top at r 27..31 (the ribbon channel runs under it as a 4-long tunnel), a 2 x 45° fillet foot → body; one counterbored M5 per post; ribbon channel; A has one Ø2 dimple at r 125 (C), B two 4.5 apart (C, a 2.5 web). Symmetric in X: A and B differ only in the inner post (r 35 / 38.75). **49.7 / 50.0 g (M)**, 32 x 107 x 23 (M), bottom (Y 74) down, bed 2411 / 2439 mm² (M), no supports (the stop bridges the 3.2 channel mouth).
- **V-wheel v1 (PETG, x6):** OD 24 x 10 (Y 83..93, C), 90° groove centred Y 88 (C), apex truncated at r 10.25 (C, 0.25 off the ridge's flat), so the floor over the bearing seat is 2.22 (C); rim edges 0.5 chamfer (C); seat Ø16.05 (C) for 2 x 625ZZ butted, no centre lip (a 2.0 lip needs a 12-wide wheel and moves every Y in the stack): **press + a film of epoxy, DEFAULT** (alternative: wheel 12 wide with a 2.0 lip and 2 x M5 shims between the inner races). Rim r 12 at X 10 = 1.0 off the rail body (C); contact on both flanks r 10.5..12 (2.1 per flank, C). **2.8 g (M)**, either face down, bed 192 mm² (M, brim).
- **Pinion 16T m1 v1 (PETG, x2):** involute 20°, 0.1 backlash, **tip relief 0.06 over the top 0.35 and the tip cut to r 8.9** (C), root r 6.75 (C); teeth Y 64.5..72.5 (C), the bed-side 0.3 inset 0.3 (C, elephant foot); boss Ø14 Y 56.5..63 (C, 1.0 under the rack web) and a Ø12 neck Y 63..64.5 (C, 1.0 off the web face) so it is one body; D-bore Ø5.15 with the flat 2.075 off the axis (C); M3 grub tapped straight into the boss (Ø2.5 at Y 59.75, from the flat side, DEFAULT; the D carries the torque, the grub only holds it axially). **3.0 g (M)**, gear face down (143 mm², M). Fit (C): 0 mm³ with the drawn rack at every stroke state and through one full pitch of rolling, closest 0.06 (C; the rack tip in the 16T's root).
- **Eccentric bush v1 (PETG, x2):** shank Ø11 x 3.9 (C; Y 94.1..98, the plate stays in the clamp path), hex flange AF 13 x 2.5 (C) on the plate top, M5 bore 0.8 off axis (C; wall 2.05), a dimple on the flange marks the low side. Stack: M5 x 25 socket head on the flange, plate, 5 x 10 x 1 shim (Y 93..94), wheel, nyloc. Set: turn the hex until the carriage has no play and still rolls by hand, tighten. **0.8 g (M)**, flange down; shank bending at 52 N (E) 2.8 MPa, index 0.11 (E).
- **Loads (hand calcs, E; `arm_v5_cad.loads()`):** the 60 N insert acts at Y_C 175 and the rack takes it at Y 68.5, so the carriage couple is **6.39 N·m** (the layout used the plate plane: 4.6) → **228 N axial on each outer fixed wheel** (the eccentric sits at the centroid, 0). Rail bending at the outer post 5.7 MPa (index 0.23 across layers); rail slope at the carriage 0.47° = 0.63 shift at the pack; post bolt 156 N; park stop at the 74 N stall 6.2 MPa (0.25 across layers). Wheel flank: 323 N normal on one flank, Hertz 60 MPa vs 92 yield onset (index 0.66); 625ZZ axial 228 N vs C0 670. Pinion: 0.48 N·m, Lewis 25 MPa (0.56 in-layer), stall 74 N 31 MPa (0.70); D-flat 5 MPa. Pull 50 N (E): the same couple reversed, 0.83 of it. All loads E (hand calcs), geometry C.
- **Open:** wear of PETG wheels on a PETG ridge (Problem 25: 500 strokes on the first print); m1 teeth are under the 2.0 rule by nature (tooth 1.47 at the pitch line, like the gripper's m1 racks; solid_check passes, they read as acute edges): the alternative is m1.5 (r 12), which moves every motor; heads v6 may add tip relief on the rack too (the 16T's root is undercut; the drawn pair clears by 0.06, C).

## v5 detent, swap cycle and sweep (24 Oct 2026, arm-mech worker; `detent.py` `CHOSEN_V5` / `obstacles_v5()`, `arm_kinematics.py 1.0 v5`, `arm_v5_motion.py`; runs `runs/detent/v2/`, `runs/arm/v5/`)
- **Detent re-placed (C):** the −45° candidate no longer clears with the u −47 rack tail (−1.32, C). `detent.py search(v5=True)` on the v5 obstacles (posts, rails A / B with the park stops, both carriages swept over park..drone insert incl. the M5 tails to Y 73, 16T pinions and shafts, the axle loop / 20T / shaft at −39°, drop lane, saddle; levers widened to a 15 / 17) gives **`CHOSEN_V5`: roller at arm angle −135° (r 25.5), pivot side +1, levers 15 / 39 (as v1), hook along the tangent (psi 315): roller (−18, −18), pivot (−7.4, −28.6), hook (31.6, −28.6), anchor (31.6, −66.6), tower column at (18.5, −28.4)** (C). Gaps: arm parts 1.14, tower 1.0 (C, the designed minimum; the search's `gt < CLR` now has a 1e-6 float margin, which is why it returned none before). **Ring v1 unchanged** (−135 = −105 − 30: the same 12 notches, the hall at −60° still sees a land, home magnet unchanged). Holding with the v5 unbalance (10.1 g·m E): disturbance 0.422 N·m (E), 0.390 per spring: **margin 0.93 with one, 1.85 with two springs (keep two)** (E).
- **Detent arm v2 (PETG, `runs/arm_v6_parts/detent_arm_v2_print_pose.stl`):** the v1 lever with the hook along the tangent, 58.6 x 19.6 x 2.5 (M), 2.3 g (M), flat (714 mm² bed, M), solid_check PASS. **No printed spacer** (v1's Ø4.5 spacer round the M3 is a 0.65 wall and failed the gate): **2 x DIN 988 3 x 5 x 0.5 shims under the arm instead (DEFAULT)**. In-plane bending at the pivot at 8.4 N (E) ~10 MPa in-layer (E, index ~0.2). The tower (5.1 g C) is hub v6's: `arm_solids(design(CHOSEN_V5), Q)["tower"]`, mesh `runs/detent/v2/detent_tower_v5_W.stl`.
- **Swap cycle v5 (`arm_kinematics.KEYS_V5`, times E):** the v4 −90° cycle with the XT60 and hook latch: A's drone insert runs park → 83.6 fast (0.9 s), then the last 12 at 20 mm/s to **95.6** (0.6 s), releases at 12.0 s; the drone stays up on the plungers (pack at R + 11, E). B's bay insert: park → 72.6 fast, the last 12 at 20 mm/s to 84.6. Same 22 s, same stops.
- **Sweep v5 (`arm_kinematics.py 1.0 v5`, C): 298 states, 0 overlaps** (rails A / B v1, carriages drawn from the layout with wheels, axle stacks with the real M5 x 25 tails, bushes, 16T pinions rolling, detent at `CHOSEN_V5`, hub v6 drawn proxy, v5 motors and axle loop, v4 grippers and servos, cartridge v3, bay modules v4i at all 9 angles + TPU strips). Closest per pair (`runs/arm/v5/sweep_pairs.json`): fingers to servo 0.30, packs in the demo bay 0.30, detent spacer over the notch 0.40, fingers 0.50 (all v4 / designed); hub proxy to the 80T 0.99 and to the post 0.99 (C on the drawn proxy, 1.0 exact); **carriage plate to rail 1.0, wheels to plate 1.0, axle stacks to rail 1.4, detent ring to tower 1.07, tower to the 80T 1.40, axle loop to the tower 1.75** (C). Rack on pinion is a meshing pair (allowed; its own roll check: 0 mm³, closest 0.06, `runs/arm_rail/v1/checks.json`). Not in this sweep: the stand and the funnel (`sweep_box.py` built config is stale since stand v5e), hub v6 / heads v6 meshes (rerun `arm_kinematics.py 1.0 v5` when they exist).
- **Motion artifact:** `runs/arm/v5/motion.html` (+ mp4 / gif / png): one cycle with the v5 parts, readouts head A / B z0.

## v7 system pass: both packs, 9 bays (24 Oct 2026, swap arm system worker; `swap_system.py` (NOX_ARM v7), `arm_v7_layout.py`, `arm_v7_cad.py`, `hub_v6.py` / `hub_v6_topo.py`, `arm_kinematics.py 1.0 v7:<pack>:<pick>:<ret>`; requirements `nox/dimensions.md` "System box swap: arm"; results `runs/arm/v7/`)
- **Status (round 3d, 24 Oct): concept check PASS (review round 4, after rounds 2 and 3 FAIL); recheck after merge: the carriage plate top 74.35 (C) and the insert-lane keep-out lowered to Z 89 / 95 (C / M) for heads v7 (session_01CN2CVH9uV21E2RDEbEipvG).** Current numbers: `nox/dimensions.md` "System box swap: arm"; summary `runs/arm/v7/summary.md`. The bullets below are the pass's history, newest last; superseded values are marked.
- **Rails v5 (24 Oct, box electronics PR 103):** the head ribbon is 5 conductors ~6.1 wide (E); the rail channel grows to 6.5 at the floor with a 5.0 mouth (C) and the M5 x 10 rail bolt heads sink under its floor (v4 had them 3.25 up into it, C). Ribbon slides in from the channel end. `runs/arm_rail/v5/summary.md`.
- **Grip line Y_C 167.1 (24 Oct, DEFAULT):** latch v4's Overseer receiver v2 (main) has a lead end 2.15 longer (its 3.0 capture lead-in, M); the arm's Y error (±1..1.8, E) rules out the trim, so Y_C moves 165 → 167.1 (Y_C_min, F); the catch, structure and heads sessions were told. Hub v7 (PR 111) is in the rerun: 0 overlaps, fit 0.0, access 9/9 (M).
- **Why:** the v6 concept check failed twice (the XT60 mates before the receiver gives pitch guidance; v6 pitched 2.56° free) and Spark set 9 bays with 4 Overseer. Hub decisions (DEFAULT): XT60 at each cartridge's closed end + ties, one ring R 113, head brake, both packs.
- **Layout:** rails to r 151 (rails A / B v3, tie sockets), carbon ties, R 113 for the drone seat and every bay, strokes +13, **common grip Y_C 138** (this pass, DEFAULT: the Overseer gripped on its drone's thrust axis needs only Y_C ≥ 136.8; 138 brings the free mate pitch from 1.10 / 1.01° at 175 to 0.64 / 0.56° and the box 37 shorter), head A's rack tail to u −63, **head B's to −54** (it never inserts at the drone; the full tail met the detent), detent tower moved to (31.1, −31.1) (`CHOSEN_V7`; ring v3, arm v2 unchanged), springs x1.18 (round 1; round 2 x1.25, round 3 x1.5).
- **Checks (round 1, superseded by round 3d: see Status):** seat state Scout 0.34 mm / 0.35°, Overseer 0.36 / 0.29° (target 0.5 / 0.5); worst swap index 0.47; sweeps of a Scout cycle (pick −210, return 30) and an Overseer cycle (−150 / −60) with every bay's receiver and seated pack: 0 arm overlaps; system_check at 5 poses fit 0.0 mm³, access 9/9 (motor screw key 70 long: the servo sits over the line at Y_C 138).
- **Round 2 (concept check strike 3, back to the system pass):** two Overseer receivers side by side overlap 937 mm³ at R 113, so the bays alternate (Overseer 30, −30, −90, −150; Scout 0, −60, −120, −180, −210; 0 mm³, gap ≥ 5); the detent alone sags the arm ~2.4° under a 1 N·m bay load, past the lead-ins' 1.2° capture, so the axle driver stays on for every insert and pull (the arm turns ≤ 0.49°) and the detent (springs x1.25) only holds the parked, unpowered arm; bay cases at every real bay angle for both heads and packs; the Overseer cycle checked as an assembly (fit 0.0, access 9/9, worst 16.3 L / 266); an XT60 tolerance stack (RSS 0.41°: Scout 1.05° of the ±1.06° float, the ties stay); the head brake's bench drop gates the first Overseer swap. Sweeps of a Scout cycle (−210 / 0) and an Overseer cycle (−150 / 30): 0 overlaps.
- **Round 3 (concept review round 2 FAIL; latch d0cd1a1; the hub's Y_C 138 DEFAULT):** the latch now puts the XT60 end at the arm side and the Overseer's tab line 30 toward it, so its arm-side end sits at Y 74.76. The arm takes the **low carriage stack** (plate Y 68.75..72.75, countersunk wheel axles flush, thin nuts, eccentric flange flush: nothing under a cartridge above 72.75) and **rail v4** (top 66.75, keel to Y 38 from r 89) to keep the mate tilt. Fixes from the review: the belt run's lever on the 80T pitch radius (the axle path 198 N·m/rad, not 317), the park stop at X 0 (hub turn 2.9°, not 22.9°), box structure v2's bays everywhere (`arm_v7_layout.BAYS`), a power cut with a head out at every bay, the XT60 mate at all 20 places with gravity and the driver on, a capture budget with a positional RSS and the imposed offset. **Axle 5:1 (16T) + detent x1.5**: 4:1 could not index, hold parked and hold a head out at once (the hub's x1.8 indexes at 1.29 only). Sweeps 0 overlaps for both cycles; fit 0.0 mm³ and access 9/9 at 10 poses.
- **Round 3b (hub: one funnel, 191 opening):** the catch centre, the latch set centre and the tab line coincide (TAB_OFF Scout 3.71, Overseer 5.18 from the swap CG toward the XT60; superseded in 3c: Scout 0, latch 258becf), and the grip line moves out to **Y_C 165** so the Overseer's set (179.6) clears the plate top by 2.45 (limit 163.3). The Scout's XT60 lands 31 further from the rail (free tilt 0.92°), so **the XT60 rests on the latch's receiver pitch guidance (hub DEFAULT)**: 0.68° per axis vs ±1.06°, the guide taking ≤ 3.5 N·m at a 5 mrad stub. The power cut carrying now needs the brake for both packs (Scout 1.35 unbraked). Layout pages show the insert-lane keep-out (orange). Round 3's items below stand where not replaced.
- **Round 3c and the heads v7 concept (Spark 24 Oct: plug / unplug loads, parts-optimised, servo research):** latch 258becf closes the XT60 on its receiver pitch guidance (Scout 0.75°, Overseer 0.66° vs ±1.06°; guide ≤ 2.9 N·m). The grabber concept (`head_v7_concept.py`, visual https://claude.ai/artifact/JWnuGJqAAvRXxATL5hyBya): spring-closed blades on carbon rods, one servo cam opens them, the pull never reaches the servo, the grip holds unpowered; pinion face 13. Numbers in dimensions "Heads v7 grabber concept".
- **Round 3d (concept review round 3 FAIL, fixed; XT60 per axis on the latch's float carrier: x ±2.37°, z ±1.06°):** roll held by the receiver's side faces over the engaged cartridge height (31 / 44, not 87) after the per-bay gravity offset: 0.73 / 0.84°; about x 1.24 / 1.04°, no pitch guide (the hub dropped the posts), the stub may tilt 10 mrad. The unpowered arm posed where the pack leaves the side faces, indexing at the slow-pass torque: springs x1.3 (1.31 / 1.14 / 1.04). Grabber: rods along x in the head body, a 16 long guide boss per blade, cam rise 6.0, no outboard pin. Pinion v3 face 13.5 (10.25 on the rack tail): 0.45 / 0.49 at the drone insert. Alternatives: https://claude.ai/artifact/F7cY19HjCUZFY53HUB5k6d.
- **At round 3 (closed in 3b to 3d):** the XT60 budget, Overseer 0.68° + RSS 0.41° = 1.09° vs ±1.06° even with a rigid stub, so the latch adds receiver pitch guidance before the XT60 mates, or widens the float carrier to ±1.5° with the stub ≤ 1.9 mrad (superseded in 3d: ≤ 10 mrad) at 60 N (structure). The funnel and hook latch are not yet posed at R 113 / Y_C 138 (catch).
- **For other systems (current):** box structure: bay set v2 (agreed), each bay located to the mast ±0.15° (not chained), **stub tilt ≤ 10 mrad at a 60 N insert** (5.9 N·m + 57 N at the mast face), the stand's arm lane ≥ 159, the arm's swept disc Y 38..73 to r 151 (the keel). Latch: no pitch guide (the XT60's ±2.37° float about x takes the tilt); the receiver's x side faces engage before the XT60's first contact; receiver v2 durability to the full load set. Catch: the funnel notch to the insert-lane keep-out. Box electronics: a per-bay gravity offset in the axle's step target (measured at commissioning, sag check), slow stepping through each detent notch, the axle motor on the head brake's relay, a brake self-test at every boot, live bays per `arm_v7_layout.BAYS`.

## v6 system pass (24 Oct 2026, swap arm system worker; numbers C geometry, E loads and stiffnesses, M meshes unless tagged; `swap_system.py`, `arm_v6_layout.py`, `arm_v6_cad.py`, `hub_v6.py`, `hub_v6_topo.py`, `arm_kinematics.py 1.0 v6`, assembly `box_swap_arm.assembly.json`; requirements `nox/dimensions.md` "System box swap: arm"; results `runs/arm/v6/`)
- **Model:** every arm part in pose through the cycle, the carried cartridge from the latch standard (`battery_latch.latch_assembly`, staged read-only from part/battery-latch until it lands), the demo bay as the latch receiver. A frame model (beams + contact springs) carries the cases where they act. The receiver is a gap + spring (its 0.3 locating gaps, 0.40° of tilt, then stiff): the arm alone carries the push until the gaps close. The 60 N insert then lags 1.88 and the receiver holds 3.5 N·m of pitch (5.5 at the stall), now in the L Swap case. Every guided case also runs free (no receiver) as a misuse bound; the pieces take the worse of the two. Concept review round 1 FAILED on the gapless receiver, the guided-only requirements, the missing receiver moment in the shared cases and a power cut while carrying; all fixed here.
- **Concept check: FAIL twice (review rounds 1 and 2), back to the system layout.** The latch receiver gives no pitch guidance until the deck at the seat, so the XT60 mates on the arm's own pitch stiffness: v6 reads 2.56° free at the mate (float carrier ±1.06°), the Overseer at R 113 3.47°. The compliance is spread (rail 31 %, wheels 20 %, carriage 11 %, bearings 9 %); the lever is the 151 mm from the rack plane to the XT60 at the cartridge's lead end. Only **ties + the XT60 at the cartridge's closed end** keeps both inside the float (Scout 1.03° at Y_C 175, Overseer 0.70° at R 113). v7 direction (DEFAULT): ties back, XT60 at the closed end (asked of the latch; alternative: receiver pitch guidance before the seat), R 113 for every seated face (asked of the structure), Y_C 175 for both cartridges, rails to r 151, rack tail u −63, detent springs x1.2. The hub v6 topo run waits for it.
- **Spark 24 Oct (via the hub): 9 bays, 4 Overseer (−60..−150) + 5 Scout (30, 0, −30, −180, −210), 30° pitch.** Either head reaches every bay inside one axle window phi −300..90 (390° of the loop's 422°; the splice moves).
- **Stack (compact):** rails straight on the motor plate (Y 54..73, no posts), carriage plate 74..78, rack teeth 61.5..73 (tail u < −40 from Y 63 over the axle loop), pinion v2 face 10.5. Y_C 129.1 for the next modules (the latch's 42.55 tab line), demo 175. Arm alone 10.4 L AABB / 220 largest at park, 11.8 L / 240 at the drone insert (C).
- **Alternatives (receiver with gaps):** v5 on posts (Y_C ≥ 149, lag 2.65, receiver 3.3 N·m); v6 + carbon ties (lag −0.04, receiver −10 % for 4 rods + 8 sockets: rejected); XT60 on the tab line (the latch's call: receiver 1.6 N·m with ties).
- **Insert:** the head stops at the seat (95.6 / 86.1); every insert is commanded 2.7 past it at 2 A and ends on the driver's stall detection or the step count (DEFAULT), so the seat sees 60..74 N whatever the lag; re-home on the park stop each cycle.
- **Power cut (v6, superseded: v7 round 3d reads 1.29 / 2.73 unbraked (E), brake required for both packs):** a head carrying a cartridge (391 g) outweighs the cogging and would fall 64.6 at 1 g onto the park stop (24 N·m into the head, 625ZZ 1.23). Requirement to box electronics: normally closed relay contacts short each head motor's coils while the 24 V is off; the head then creeps down at ~8 mm/s.
- **Fixes the system pass forced:** fixed-wheel axles M5 x 20 (the x 25 tails reached into the hub plate); rack tail stepped to Y 63 (crossed the axle loop at park); hub harness hole Ø9 at the drop lane; the axle motor on 3 x M3 (its 4th key line is under the detent springs); a TPU bumper on each carriage plate's inner edge (a power cut with head A up, then a bump: the head falls 64.6 onto the park stop; PETG on PETG reads 1068 N, stop 1.19, 16T 3.19; the bumper 253 N, 0.28 / 0.76).
- **Detent v5:** ring v2 passed solid_check but broke the 2.0 rule (1.54 spot face to notch, 1.05 bolt hole to bore, strike 2); ring v3 has no bolts through it: three underside pockets key it on the 80T's M3 heads, epoxied on the boss (walls 2.05 / 2.4, solid_check PASS). Tower at (21.2, −30.3), every gap ≥ 1.0 (C); two springs hold 2.4x the worst driver-off gravity torque (E).
- **Overseer pack:** does not fit this arm (park corner r 109.5 vs 97.5, 55.6 of a 51.8 chord, 171 long vs the 161 module, detent 0.91); it needs R ≥ 112 + 172-long modules + a third spring, or its own station.

## XT60 swap (23 Oct 2026, Spark: XT60 back, contact pads retired; numbers `nox/dimensions.md` I "XT60 mate")
Every insert now pushes an XT60 home and every pick pulls one apart: **insert 60 N, pull-out 50 N (E; were 15 to 20 N and ~8 N).** What that changes on the arm (next sessions, DEFAULT):
- **Head drive:** the v5 16T pinion (r 8) needs 0.48 N·m at 60 N; stall ~74 N at 2 A (E), 1.2x. The last 12 of every insert run at ≤ 20 mm/s (E) with the drivers at 2 A; `box-wiring.md`'s 1.2 A heat fallback (~56 N at r 6.37, less at r 8) no longer pushes it home. If the first coupon push stalls: a 12T m1 pinion (r 6, ~99 N stall E).
- **Carriage, rails, V-wheels:** draw and check them at insert 60 N and pull 50 N (the v5 layout's 20 N gave 1.5 N·m and 55 N on a wheel flank; 60 N gives ~4.5 N·m and ~165 N, E).
- **Gripper:** spring ≥ 15 N per finger (was 8 N): a 50 N pull through the 10° tab pockets splays each finger ~8.3 N (E). The servo opens against it (~0.18 N·m at the 12T, E, both servos fine).
- **Heads A / B v6:** load cases insert 60 N through the pack face, pull 50 N through the fingers (were 20 N).
- **Axle:** no change: the push is radial (no torque on the wheel); with the axle driver off for the insert (Problem 17) the lead-ins float the arm easier at 60 N.
- **Sequence:** unchanged steps; the pick also unmates, the insert also mates (`box.md` Swap sequence). Mate check = box keep-alive current under 50 mA (E).

## Wheel coordinates (W)
Origin on the axle at the stub flange's mounting face (the 2040 stub post's front face, `nox/box/box-stand.md` v5e). **Y** along the axle (+ away from that face) = the cartridge's length (z), closed end toward −Y. **Z** radial, up at the drone position. **X** tangential at the top = the cartridge's slide axis (X = −x: a proper rotation, B+ / B− on the two long sides; a wheel turn never mirrors them). phi = the direction head A's bar points; head B's bar points at phi + 90. Each head has its own frame: bar along +Z, glide inner end at u = 0; s = Y − Y_C.

## What it is
**Superseded by the v7 system pass above (24 Oct): the v4 belt heads, idler ends, bars and Y_C 175 described here are history; the stub v3 and the axle drive's fixed 80T stay (5:1 with a 16T in v7).**
- **Stub axle v3 (below), hub v5, three NEMA17s, two 112 bars, idler ends:** motors A (34, −59) 25°, B (61, 55) 0°, axle (−34.7, −60.1) 50°; bars Y 74..94, r 22..134.
- **Axle drive v4 (17 Oct, Spark 01:37: only 6 mm open belt on hand):** planetary: the 80T sun is fixed, the axle motor rides on the arm and its 20T walks round it (4:1). Belt = a 122T loop cut from the 6 mm open belt (cut 274 C), lap-spliced, at C 69.4 (C, motor unmoved). Bounded arm travel: the lap stays off the 20T for 422° (C); the −90° cycle stays inside phi −180..90 (C). Printed gears rejected (Problem 2). Sun mount: the fixed sun post (Problem 2).
- **Cartridge (v3) in the arm:** **Y_C 175** = tab centre (v4c, the middle of the universal bay); pack Y 137.5..216.5, X ±20 over the guide rails. Carried: bottom at u 15.4, top 63.4. The head's generated body reaches from the glide (Y 97.3) to Y_C + 47.
- **Head** x2 (`box_head_A_v5`, `box_head_B_v5`, generated; B = A's gripper mirrored in X): v1-style glide and the **belt clamp v2** (below), plus a generated body under the carried pack (Y 97.3..222, u −26..14) to two drawn parts: the **rack guide block** (X 17..44, u −12..−2, one channel for both racks and the pinion; no floor over the servo) and the **servo plate** on the ears (u −20.6..−14.6, window for the body, 4 x M3 through slots ±1.5 along s + M3 nuts on top, DEFAULT).
- **Gripper v4d:** the servo (DS3218 A, MG995 B) **stands radially under the pack**, shaft +u at X 33.5 (A; B −33.5). **DS3218 from photos (P ±1, 17 Oct 03:23):** body 40 x 20 (listing), case top at the shaft end 40.7 above the base, ears underside 28.2, 2.9 thick, span 54.5, holes 49.5 x 10, shaft 8.5 (±1.5) from the near end. In the head: body u −51.7..−11.0, s −8.5..31.5 (cut covers shaft offsets 7..10.5), ears u −23.5..−20.6. MG995 taken as the same envelope (E, CHECK on arrival). 12T module-1 pinion (axis along u) at u −10..−4 on the spline. **Racks side by side in s**, moving along X: rack A (s +6..+12) carries the −X blade, rack B (s −12..−6) the +X blade; mesh clean over the whole travel (−1 open .. +4 squeezed, 0.2 backlash); the racks run 0.8 over the case top where the guide floor is open. Blades 13 wide (s ±6.5) in the 14 recess, 3 thick to u 22.9 (7.5 into the 7.65 recess), 5 thick below u 14, each stepping over to its rack below u −4; inner faces X ∓10 on the tabs, ∓11 open, ∓6 squeezed; rib 0.8 into the tab pocket at u 19.4. Spring not drawn (band, DEFAULT).
- **Placement (the envelope rules that set it):** parked, A's parts stay at X + z0 + u ≥ 1.5 in the arm frame (B mirrored), so the two heads are ≥ 3 apart; at every position (drone the worst, z0 89.6) every head point outside the own mouth (|X| ≤ 19) stays inside r 98.5, so heads never reach a neighbouring bay. The servo standing radially at X 33.5 is the layout that meets both with R 100 (lying along X its ears reached r 101.5 at a bay; along s its ears crossed the other head at park). v4d servo: lowest corner X + z0 + u = 3.8 at park (rule 1.5).
- **Park z0 32** (was 26): packs at r 47.4..95.4, corners r 97.5, 2.5 inside the seated packs' faces (r 100); the glides 11 apart.
- **Harness (17 Oct, `nox/box/box-wiring.md`):** one 19-wire bundle (3 steppers, 2 servos on a shared 6.8 V pair, hall) twists in the sun post's bore, ties on axis to the end clip's saddle at Y ~82, drops at 135° to the hub, servo ribbons fold inside the bars' top T-slots to the heads. With stub v3 its fixed end is the stub's lead channel (Stub v3).

## Stub v3 (18 Oct 2026, arm chat; `arm_cad.stub()`, numbers `arm_layout` "stub v3" block)
**In v7 (24 Oct):** still the part the hub turns on; its tilt at the mast face is now a box structure requirement (**≤ 10 mrad at a 60 N insert**, `nox/dimensions.md` "System box swap: arm" Stub stiffness). Box structure v1 measured 15.1 mrad on the assembled mount, over the limit: **stub v3 is DESIGN until the box structure v2 mast recheck passes** (`docs/generative.md`: every READY part passes its system).
Fixed part the hub turns on. Stand v5e bolts it to **one 2040 post** (40 face toward +Y at Y 0, slots at X ±10), so the v2 flange (Ø90, 4 x M5 on r 38 at 45° for the wood upright) is replaced. **47.7 g (C; v2 109.7), one watertight body, `box_stub_v3.stl.b64.txt` in Nox Print Files (sha e5b73c7c9588), v2 file removed.**
- **Kept from v2:** Ø49.9 bearing seats Y 6..40 (6010 pair at Y 8..24 and 24..40, E: press fit, sand), shoulder for bearing 1, Ø24 bore through the plate, 2 x M3 heat-set at Z ±21 (Y 32..40) for the sun post.
- **Flange → 4-lobe spider plate**, Y 0..6: a Ø54 hub disc + one lobe per post hole, each lobe a Ø14.4 pad hulled toward the axis, concave corners filleted r 3. **Holes at (X ±10, Z ±30)**, Ø5.5. Pad size from `stub_v3_search()` (C): the lightest pad with Problem 46's ≥ Ø12 and 2.0 web, 2.0 + 0.1 wall round the counterbore, inside the post's 40 face (X ≤ 20) and 1 inside the hub sleeve (r 39.1): Ø14.4 (range 14.4..15.0).
- **Bolt heads inside bearing 1's radius.** The holes sit at r 31.6, under bearing 1 (r 25..40 from Y 8). So the heads sink flush: **M5 x 8 button head (ISO 7380, Ø9.5 x 2.75, E)** in Ø10.2 x 2.75 counterbores, floor Y 3.25 (grip 3.25), head top Y 6, **2.0 under the bearing face (C), 3.87 to hub v5 at every arm angle (M, 36 angles).** The shoulder is r 26.4 (was 27) so the heads pass it by 0.45. Shank 4.75 into the slot: lip ~1.8 + ~3 into the T-nut (E, CHECK with a T-nut in the offcut). A socket head (5 tall) would hit bearing 1. Snug only, ~1 N·m (E): ~1 kN preload, 21 MPa under the head (E). This closes the sweep chat's open item (v2's M5 heads ran into the hub sleeve).
- **Shaft hollowed to Ø40** from the plate to the end (wall 4.95 under the races); two full-height ribs (r 3.6 round Z ±21) carry the sun post's inserts. Loads are small (E: 2 kg arm at Y ~60 plus a 20 N push at r 150, Y 175: tube stress < 1 MPa; yaw on the 20 x 60 bolt pattern ~64 N per bolt, lobe bending ~5 MPa in the layer plane).
- **Lead exit (`box-stand.md` Problem 7):** the post face closes the bore's back end, so a **10 x 6 channel in the plate's back face runs the bundle out toward −X** (+X ties on clearance; −X keeps it off the stand's tie and its brackets, DEFAULT; ±Z blocked by the lobes, `stub_v3_search()`). The bundle leaves the flange at X −27 and drops beside the post; zip-tie it to the post just under the flange (DEFAULT). The printed grommet (`box-wiring.md`) is not used. **Twist length 90 → 69 (channel to the saddle exit); lay the bundle untwisted at phi −45, the cycle's centre: the −90° cycle's ±135° gives 0.52 % outer-wire strain (C; was 0.74 %); a run to the soft limits would give 1.57 % (C).**
- **Print:** plate face (Y 0) down as saved: 2225 mm² on the bed (M), the best of the 6 faces, one first-layer island, no thin islands; the only overhang is the lead channel's 10 wide roof (bridge, 65 mm² M). 74.4 x 53.5 x 40, no supports needed.

## Head belt clamp v2: loop and pin (17 Oct 15:40, `nox/box/belt_clamp_v2.py`)
**Superseded (24 Oct): v6 / v7 drive the heads with rack and pinion; no belt clamp, no idler ends.**
Each head's open GT2 6 mm belt runs motor 20T → idler → back, both ends held on the head's inner run (A: pitch line X 27.65, Y 66..72; B: X 48.65 in B's frame, Y 56..62). **Method from proven designs, not invented here:** Vampire Bat carriage clips (belt through a thin slot, wrapped round a 4 mm tube, squeezed to itself), goBILDA / ServoCity GT2 3-1 clamp (belt meshed to itself, one pinch bolt), printables 617391 (fold-in-loop, teeth against teeth). v1 (printed grooves + plate) is retired.
- **How it holds:** each belt end is folded back on itself **teeth in**, so the two legs mesh tooth into tooth, and pushed up a narrow slot; an **M3 screw through the loop is the pin**. Pull on the run tries to slide the legs against each other: the meshed teeth stop it, the slot walls keep them meshed, the pin stops the loop pulling through. No printed teeth, no plate.
- **Per end (C):** slot 12 long (6 teeth) x 6.4 across the belt width, 0.8 lead-in at the mouth; the legs converge over 3.6 to the pin; pocket r 3.23 round the Ø3 pin (wrap 2.88 + 0.35); pin hole Ø3.3 through both walls across the belt width; side walls ≥ 2.4, end walls 2.0; a 4 wide sight window on one side of the pocket. **Slot width = the coupon's pick** (1.8 / 2.0 / 2.2; meshed pair 0.63 + 0.75 + 0.63 = 2.01, E).
- **In the head (drawn feature, head chats):** both ends back to back on the inner run, mouths outward, pins 8.5 apart: 2 x (12 + 3.6) + 8.5 = **39.7 ≤ the 40 clamp zone** (A u −18.6..21.4, B −15.6..24.4, unchanged, `CLAMP_DZ`, `CLAMP_DZ_B`). The loaded leg lies on the run's line (no kink at the mouth). Pin = M3 x 12 + nut, or a Ø3 dowel. The joint to the glide's side skin stays generated (B: only at u ≥ −4). **Drawn 17 Oct 19:10 in `nox/box/belt_clamp_v2_head.py` (`head_clamp(h, slot)`, same keys as v1): slot centre X = pitch line − PLD − back + meshed / 2 (A 27.77, B 48.77 in B's frame), body X ±5.63 round it, Y = belt ±0.2 + 2.0 walls (A 63.8..74.2, B 53.8..64.2), pins at u0 + 15.6 and + 24.1 (A −3.0 / 5.5, B 0.0 / 8.5), mouths at u0 and u0 + 39.7; the slot width is an exact cut at build time (`arm_cad.CLAMP_SLOT`, env `NOX_SLOT`, DEFAULT 2.0) and the generator keeps out of 2.2, so one layout serves any pick; head A's low −X corner is trimmed by the 80T flange + 1 keep-out at park (8.7 mm3, C), gap 1.0 to the flange.**
- **Assembly:** fold the end teeth in, legs meshed; push the fold up the slot from the mouth until the loop shows in the window; push the pin through the loop; pull the run to seat it; trim the tail ~5 past the mouth. Length steps: re-fold one tooth along (2 mm of belt, 1 mm at the idler).
- **Belts (C/E, idler pitch taken as the 20T's, CHECK):** loop A 398, loop B 410. Each end uses 2 x (12 + 3.6) + π x 2.19 = 38.1 inside the clamp + ~5 tail, and the mouths are 39.7 apart, so **cut A ~445, B ~457**; cut 5 long, trim the tails.
- **Tension: preload 20 N (E, DEFAULT).** Loosen the idler end's 2 M5, push it out along the bar's T-slot, tighten. Target pluck on the free return run (motor to idler, the run the head is not on): **A 143 Hz (span 179), B 139 Hz (span 185)** with belt 7.6 g/m (E); f = sqrt(T / m) / (2 L). Weigh the 918 spare piece to replace 7.6 (P).
- **Proof test before the heads print:** coupon set `belt_clamp_coupon_set_v2` (Nox Print Files `belt_clamp_coupon_set_v2.stl.b64.txt`; 3 coupons, slot 1.8 / 2.0 / 2.2 marked by 1 / 2 / 3 notches on the tab end; 11.6 g M; prints flat, no supports, bridges only). Fold a belt end into each, pin it with an M3, hang **10 kg** (98 N > 93 N stall per end, E) through the Ø6.5 tab hole: 1 min, then 10 min, Sharpie mark at the mouth. Pass = < 1 mm creep, no crack. **The narrowest slot that seats by hand and passes goes into the heads.**

## Arm auto-centering detent (17 Oct, Spark 04:16 / 04:17; next arm version = hub v5, `nox/box/detent.py`, render `detent_render.py`)
One detent at the pivot centres the arm for both heads. Placement from `detent.py search()` (roller angle, pivot side, lever lengths, spring direction, tower point; every gap ≥ 1 to the fixed and turning parts, C).
- **Ring (fixed, PETG, 5.0 g C):** on the 80T's top face (Y 64..69.9), bore Ø30.5 on the 80T collar (collar Ø30, flange Ø55, total 18: P, Spark 17 Oct 12:41; was Ø24.5 on an assumed Ø24). M3 heads on Ø36 clear the collar by 0.25 (C): drill the 80T web through the ring's holes (the ring is the jig). Ring base follows the 80T body width (`RING_Y[0] = Y_P80[1]`), fine up to 12.5 (CHECK the width), clamped by the 80T's 3 M3 (now M3 x 20 low head, E: CHECK the 80T thickness), counterbored flush. Notched rim Ø47 (r 23.5) at Y 67.8..69.9; below it a Ø42 step for the roller's nut. **12 V-notches, 60° included, one per arm stop** (`stops()`: head A or B on the drone or any bay inside the soft limits; bay spacing may be uneven, the list follows `BAY_ANGLES`), 15° off the bolts (1.59 wall, C). Capture ±7° (C).
- **Roller arm (turns, PETG, 2.4 g C):** 683ZZ (Ø7 x 3) on an M3 x 8 + thin nut, seated at arm angle −105°, r 25.5; pivot 15 along the tangent (M3 on the tower), bellcrank hook 39 radially out; rides 1.5 up onto each land.
- **Hardware (DEFAULT, 17 Oct prep):** pivot = M3 x 10 socket screw threaded into the tower boss's Ø2.9 hole, run down until it touches the arm, backed off 1/4 turn, medium threadlocker: the arm (Ø3.2 hole) turns on the shank, not clamped. Roller = 683ZZ on M3 x 8 + spacer + thin nut. Hook and anchor = smooth Ø3 pins (dowel or drill-bit shank) pressed into the Ø2.9 holes; M3 screws only with heat-shrink over the thread (threads cut rubber). Ring = 3 x M3 x 20 low head through the 80T (CHECK its thickness). Hall A3144 + Ø3 x 2 magnet.
- **Pull: rubber bands for now (Spark 17 Oct 11:00, DEFAULT).** One band in each of the two pin grooves (Y 77.6 / 83.6), hook pin to anchor pin, 38 between pins seated, 41.9 on a land (C). **Need ≥ 6.7 N total at 38 (margin 1.5, C / E); fit 7.5..10 N at install (E: rubber relaxes ~10..20 % in days); ≤ 10 N keeps the pivot and anchor near the hub v5 load cases (8.4 N checked, worst 0.31 M).** Pick bands by a hang test: one band over a 3 rod, 0.38 kg (3.7 N) hung on it, rod to hook ≤ 38; band loop unstretched well under 85 around (small, ≥ 3 wide). Candidates per groove (E, neo-Hookean, hang test decides; target 3.7..5 N at 38): 1 nitrile O-ring ID 22 x 1.5 (~3.5 N) or ID 24 x 1.9 (~3.3 N) from a metric kit (best: least creep); 2 orthodontic elastics 1/2" heavy 6 oz (~1.7 N each at 38, rated); 2 #8 office bands 7/8" x 1/16" (~2.5 N each). **Stopgap until they arrive (Spark 11:40): stack whatever bands are on hand in parallel, each taut at 38 (wrap twice if slack), until the whole bundle passes 0.76 kg → ≤ 38 and 1.0 kg → ≥ 38; spread along the pins (Y 75..86), bundle ≤ 5 thick; re-test next day.** Later option, no part change: 0.5 x 5 x 25 steel extension springs, 3.4 N seated, 4.18 N on a land (42 limit).
- **Tower (hub v5, drawn, 5.3 g C):** a Ø10 column on head A's motor spoke at (17, −29.4), webs at Y 66.3..71.3 to the pivot boss and the anchor post. `arm_cad.hub_parts()` includes it when `arm_layout.HUB_DETENT` (True); `arm_run_hub.py` adds the pivot and anchor loads. **Hub v5 generated 17 Oct 09:05, regenerated 22:43 (table below).**
- **Holding (solved 17 Oct 10:55, `detent_kin.py`, C; was a hand estimate):** the roller never touches the 60° flanks: their tangent points from the seated roller sit at r 23.75, above the rim edge r 23.5, so it rests on the two notch edges (seats at r 25.45, not 25.5) and climbs over the edge. Restoring torque from the spring energy (quasi-static, frictionless) peaks right off the notch centre and falls to 0 at ±7°: **0.277 N·m per spring, 0.554 with two** (was 0.39 per spring E) vs 0.366 N·m to beat with the driver off (E: carried pack at a horizontal stop 0.22, 2RS seals 0.06, stepper cogging x4 0.09). **Margin 0.76 with one spring (does not hold), 1.51 with two; per newton of pull at 38: 0.082 N·m peak (C). Rubber bands now (Pull bullet).** Leaving a notch needs at most 0.55 N·m (2 springs), far under the motor's 2.4 N·m at the arm. Roller arm swing 0..5.74°, spring 37.86..41.90 (limit 42) (C). Artifact "Nox Arm Detent" (`detent_artifact_build.py` + `detent_page.html`).
- **Firmware (DEFAULT):** move to the notch within ±3° (under the ±7° capture), driver off ~150 ms (E) so the detent centres the arm, then full current = the lock (Spark 04:17). For an insert stroke the driver stays off (Problem 17): the lead-ins then need ~2.6 N sideways at r 150 to float the arm against the detent (E), under the ~8.7 N they make from the 15 N push.
- **Homing:** one A3144 hall switch (E) in a pocket on the tower web at arm angle −60°, face 1.0 off the rim; one Ø3 x 2 magnet pressed radially into the land it sees at phi 0. Home = rotate slowly to the switch edge, drop current, the detent picks the notch. +3 wires in the lead bundle (19 total, `nox/box/box-wiring.md`). **Home stays phi 0 with the −90° cycle (`arm_layout.HOME_PHI`; ring v1 unchanged): after homing the arm turns −90 to the cycle start (DEFAULT).**
- **Clearances:** `arm_kinematics.py 1.0 axle` / `all` with the detent: 158 states, 0 overlaps; tightest designed gaps: roller spacer 0.4 over the notch void, nut 1.0 over the 80T top, tower 1.0, arm parts 1.14 (C). **With the solved motion (`detent_kin.py`, every 0.25° of φ −278..143, roller arm swinging, springs stretching; vs hub v5 M, motors, pulleys, axle loop, bars, heads A / B at park, wait and full stroke, ring, 80T, post): 0 overlaps; closest 0.30 (roller arm plate over the tower web, designed), arm to ring 0.58, springs to hub 1.0, tower to the fixed parts 1.10 (M, 22:43 hub; was 0.97); roller on the rim ≥ 0.001 (rolling contact, C).** Rerun against the v5 heads with clamp v2.

## Ring and stroke
**Superseded by v7 (24 Oct): R 113 for every seated face, strokes in `arm_v7_layout.strokes()`.**
**R = 100 = the flat bottom face of a seated cartridge** (bays and the drone); pins r 141.5, pack top r 148, TPU strip to 149.5, back plates to 152.5, module lugs to r 179 (no casing). **12 positions at 30° (v4c): the drone at the top (90°), the opening 90° wide (60..120°, as much as the funnel allows: every module point above Z 102 has |X| > 84, the collar's opening), 9 universal bay modules at 0, −30 .. −210 and 30°** (`nox/box/box-case.md`). **The demo mounts only the −90° module (`arm_layout.DEMO_BAY`, stand v5e); the rest chain onto it.** Head stroke (glide inner end): park 32 → bay 84.6 (+1.5 into the TPU strip) → drone 89.6; B waits at 81 until the drone has landed.

## Swap cycle (`arm_kinematics.py`, 18 Oct: pick and return at the −90° bay; motion times E)
**Superseded by v7 (24 Oct): `arm_kinematics.keys_v7(pick, ret)`, bays per `arm_v7_layout.BAYS`.**
22 s, 21 keyframes, **phi −180..90 (C), inside the soft limits −278 / +143 and the lap splice's travel**; 540° of turning per cycle (the 0° cycle turned 270°; head A can't pick at −90 while B waits under the drone, they are 90° apart):
1. phi −90: A extends into the −90° bay, grips the charged pack, retracts (0..4.5 s). B is parked at the 0° position.
2. Turn +90 (phi 0): B under the drone, A carrying at 0°. B rises to wait under the seat; **the drone lands (6.5 s)**; B reaches up, grips the dead pack, retracts.
3. Turn +90 (phi 90): A at the top inserts and releases (latched at 12.0 s), retracts, closes. B (carrying) at 180°.
4. Turn −270 through the top (phi −180): B at the free −90° bay inserts and releases, retracts.
5. Turn +90 home (phi −90), ready for the next cycle.
**Drone land to latch 5.5 s (E), the same as the 0° cycle.** Every stop (−180, −90, 0, 90) is a detent notch (`detent.stops()`: 14 stops, the same 12 notches; ring unchanged). **Sweep 18 Oct (`arm_kinematics.py 1.0 all`: hub v5 as printed M, bay modules v4i M at all 9 angles, drawn heads, stub v3 + its 4 bolt heads): 296 states, 0 overlaps, closest 0.14 (rack on pinion, designed).**

## Operation sweep (exact, `python3 sweep_box.py <dt> built|ring9 env|drawn|v5` → `out/sweep_<config>_<heads>.json`; wraps `arm_kinematics.py`)
Every part as a mesh in W: hub v5 as printed (the Nox Print Files mesh brought back to W, drawn features missing 0.01 mm3, M), every drawn part, the bought parts (steppers, pulleys, belts as loops, idlers, 6010s, servos, both bars), bay module v4i (M) + TPU strips, the cartridge v3 as a solid (tabs squeezed in 0.5 steps), **the harness keep-outs** (saddle Ø10 Y 78..86, drop lane Ø8 at 135° r 32 Y 50..86, hub lacing taken as the full annulus r 43..49 Y 8..50), and for the as-built box **stand v4 wood** (`stand_v4.py` pieces) **+ the funnel** (45° frustum 4.4 thick, E). Every 0.2 s, every keyframe, every 2° of every turn; python-fcl distance on every pair not meant to touch, kept per pair over the whole cycle; manifold3d volume on anything flagged. Configs: **built** = bays 0° and −30° on the wood stand (stale: stand v5e mounts −90; the `built` config needs the v5e pieces and `SCOUT_BAYS` containing −90 before it runs again); **ring9** = the 9-bay ring, no stand. Heads: **drawn** (lower bound), **env** = env − cuts of `head_parts()` (the most material the v5 runs could place: upper bound), **v5** = the head chats' meshes (`models/box_head_<h>_v5.stl`, head frame).
**Result 17 Oct 23:26 (sweep chat), 218 states each:** **drawn heads, built and ring9: 0 overlaps**, closest 0.14 (rack on pinion, designed). **Env heads, built: all clear except two slivers only the real v5 meshes can settle:** head A env ∩ head B env with both parked (354 mm3, X −24..−20.3, Y 70..74, arm Z 31..55: A's −X skirt under its bar vs B's glide env) and head B env ∩ hub v5 (6.3 mm3, 0.7 deep at Y 53.3..54). Env heads to the stand (C / E): +15° bay block 10.4 (idler B; heads further), wedge 85, funnel blocks 21.9, base 15.7, funnel 8.0 (heads at the drone); **motors to the upright's face 2.0** (bodies start Y 2, face Y 0). Harness: **drop lane 0.5 to the fixed 80T flange** (rule 1.0; r 34 gives 2.5 and clears the hub and both bars, C); lacing 3.0 to the 6010s, 2.0 to the stub. Hub v5 (full mesh) to post 0.99, 80T 1.00, stub 1.00 (M). **Outside the sweep then (bolts not modelled): the stub v2 flange's 4 M5 heads ran into hub v5's sleeve end. Fixed by stub v3 (18 Oct): heads flush at Y 6, 3.87 to hub v5 (M), now a part in the sweep (`stub_bolts`).** Figure `out/box_sweep_findings.png`.

## Generated parts (noxopt, `docs/generative.md` steps; cloud, 2 cores)
| Part | h | Gen target | Result (M / C) |
|---|---|---|---|
| hub `box_hub_v5` (detent tower drawn in; regenerated 17 Oct 22:43, the 09:05 mesh was lost with its chat) | 2.5 | 55 cm3 | **214.2 g** (M; 09:05 run 215.8, v4 211.3), drawn 138.4 g, one watertight body, function 0 / 0 / 0, **worst 0.30** (detent pivot, across layers, misuse), wrinkle 0.32 / 0.70; layout stopped at it 91 (grey 0.7 %), pruned 0; thin 0 (`thin_check` off-grid rule); bearing bore **Ø80.2 drawn exact** in `hub_parts()` (256-gon, `BRG_OD / 2 + 0.10`, measured Ø80.20 M), so no post-cut; `arm_kinematics.py 1.0 all` (drawn heads and bay modules): 158 states, **0 overlaps**, closest 0.14 (rack on pinion); `detent_kin.py`: closest 0.30 (roller arm over the tower web, designed); 171.5 x 171.3 x 67, sleeve end down (748 mm² M on the bed), tree supports under the motor plate (12163 mm² overhang M); 31 min. Print file `box_hub_v5.stl` (Nox Print Files `box_hub_v5.stl.zip.b64.txt`, sha 6d6b9344e7f6); checks `post_hub_v5.py`; renders `hub_render.py` |
| head A `box_head_A_v5` (17 Oct 19:10) | 1.75 | 14 cm3 | **56.1 g** (M; v4 50.0; drawn 32.0 incl. the 4.7 g clamp body), one watertight body, function 0.01 / 0 / 0, thin 0 (two sub-mm slivers at the guide block's rack channel, X 26..43 Y 166..168, pruned twice; gone in the final build), wrinkle 0.22 / 0.31, **worst 0.45** (insert push 20 N, across layers at (-4, 106, 13), misuse; v4 0.34); belt stall ends 0.18 / 0.08; `arm_kinematics.py 1.0 all` with the generated head: 158 states, **0 overlaps**, closest 0.14 (rack on pinion); 73.0 x 68.7 x 158.7 print pose, glide legs down (bed 331 mm² M, the best of 6, `print_orient.py`), tree supports under the glide (the clamp hangs 10.2 below the legs, E ~15 g); 87 min. **Belt clamp v2** drawn (`belt_clamp_v2_head.py`, slot 2.0 DEFAULT: an exact build-time cut, rebuild with `NOX_SLOT=<pick>` from `head_A_density.npz`), **wiring entry channel + zip fin + plate zip tab** drawn (dimensions I) |
| head B `box_head_B_v5` (17 Oct 20:11) | 1.75 | 14 cm3 | **55.5 g** (M; A v5 56.1, A v4 50.0; drawn 32.0), one watertight body, function 0.01 / 0 / 0, thin 0 (one r 0.58 member pruned), wrinkle 0.22 / 0.30, **worst 0.96** (belt stall ends, across layers, misuse; as built 1.33 at the generated bridge from the glide skin to the clamp, (27, 74, −1) B frame: B's clamp sits 21 further out than A's, X 43..54; one local reinforcement pass, `head_reinforce.py`, 8 seeds, r 2.0, +0.1 g); insert push 0.70 (A v5 0.45 worst, A v4 0.34); `arm_kinematics.py 1.0 all` with heads B v5 + A drawn: 158 states, **0 overlaps**, closest 0.14 (rack on pinion); 103.3 x 68.4 x 168.7 print pose (post_v4), bed 311 mm², tree supports; 72 + 10 min. Slot 2.0 DEFAULT; slot pick: `NOX_SLOT=<pick> NOX_REINFORCE=rebuild python3 head_reinforce.py B 1.75`, then `post_v4.py heads` (keeps the prune and the reinforcement; `arm_build_from_density.py` would drop both) |
| bay module `box_baymod_v4` v4i (`nox/box/box-case.md`) | 2.0 | 25 cm3 | **83.5 g** (drawn 54.6), one body, function 0 / 0 / 0 after the post cut (smoothing left 70 mm3 in the dovetail groove, cut out), thin 0, wrinkle 0.22 / 0.38, **worst 0.05** (extract pull 20 N); overhang filter on, built from its near end (Y 133); print near end down, 92.6 x 73.2 x 87.6, bed 462 mm², tree supports ~21 g (E); 48 min |
Overhang filter off on the heads and the hub; on for the bay module.

**Drawn print set (`export_hub_set.py`, 17 Oct 22:45; stub v3 18 Oct; each on its largest flat face, one watertight body, `print_orient.py` pass, C):** stub v3 47.7 g (plate face down; section Stub v3), sun post v1 30.4 g (flange down), detent ring v1 5.0 g (bore Ø30.5), roller arm v1 2.4 g (with its spacer), idler ends A / B v3 9.2 / 11.4 g, pinion v4 0.6 g (x2), fingers v4 for head A and head B (4.9 / 3.9 g each pair). All in Nox Print Files.

## Problems
1. **Hardware sizes from memory (E, CHECK):** NEMA17 length, 80T pulley, idler bore, AA spring force. DS3218 from photos (±1, P photo); MG995 not measured. Fix: caliper the MG995 when it arrives; D13 for the rest before the prints.
2. **Axle drive (17 Oct, Spark 01:37: no closed 244, only 6 mm open belt).** Printed m1 gears (28T : 111T, C 69.5) rejected: the 111T (tip r 56.5) hits the hub's inner bar posts, head B's belt and head B's clamp in every 6-wide slot from Y 50 to 80, at every arm angle (`python3 arm_kinematics.py 1.0 gears`, 158 states, up to 4060 mm3, C). **DEFAULT: the 80T sun + a 122T loop from the open belt, C 69.4.** Splice: lap 15 teeth (30): the outer end's teeth glued on the inner end's back with rubber-toughened CA; the lap only ever passes the 80T (r 25.5), never the 20T: it has 422° of arm travel before it reaches the 20T (≥ 5 margin each end, C); the −90° cycle stays inside phi −180..90 (C, 18 Oct; was −225..90 E). Set it at phi −67.5 centred on the 80T opposite the motor; firmware soft limits at phi −278 / +143 (C). Tension: the loop is made on a jig (fixed length); the axle motor's 4 M3 sit in slots ±1 along the motor-to-axle line (C 68.4..70.4 = loop 242.2..246.0, C): slide the motor out until snug, tighten. Proof test: hang 10 kg on the finished loop (stall belt pull 93 N E). **Sun mount, solved 17 Oct (hub v4):** a fixed **sun post** (`arm_cad.sun_post`, PETG, 30.4 g solid C) bolts to the stub end with the old cap's 2 x M3 at Z ±21 and clamps bearing 2's inner race (the stub now ends flush at Y 40; the v3 cap at Y 42 never touched it); its Ø43.5 column passes the hub through a **Ø45.5 hole** (1.0 radial, C; 0.99 to the generated hub, M) to Y 54 and carries the 80T on 3 x M3 heat-set on Ø36 at 0 / 120 / 240° plus a Ø11.9 spigot in the 80T's bore (drilled Ø12). The hub stays ≤ Y 53 inside r 29 (1.0 under the 80T flange, M); inner bar posts moved to **r 35 (A) / 38.75 (B)** by the clearance search (`sun_post_search()`: A 1.0 off the 80T, B 1.04 off the loop, C). **Leads: cable twist (DEFAULT, simpler than a slip ring at the post tip):** the 19-wire bundle runs up the stub's bore and the post's Ø8.5 bore and is tied to the arm past the 80T boss (Y ≥ 72); bounded travel ±210° over ~90 = 0.74 % outer-wire strain (C); **with stub v3 the twist length is 69 (fixed end at the stub's lead channel): 0.52 % over the −90° cycle with the bundle neutral at phi −45 (C)**; no bought ring, no 12-wire cap. **Harness solved 17 Oct (`nox/box/box-wiring.md`):** 19 wires (the old 15 missed the servos), bundle Ø7.3 in the Ø8.5 bore (1.2 clear), on-axis saddle tie at Y ~82 on the end clip, 135° drop lane to the hub, servo ribbons folded inside the bars' top T-slots. **Hub v4:** 211.3 g (M; v3 229.7), worst 0.15 (post A35 radial; v3 0.14), one body, function 0 / 0 / 0; `arm_kinematics.py 1.0 axle` and `all`: 158 states, **0 overlaps**, closest axle-drive pair 0.9 (80T to hub, on the 30k-face sweep mesh; 1.0 exact), closest overall 0.14 (rack on pinion, designed). Section drawing: `hub_section.py`. The v1 clamp plate's 0.6 over the 80T flange is gone with v2; the head runs recheck head A's clamp walls against the flange.
3. **Homing:** the arm homes on the detent's hall switch (Detent section); heads have no endstops: sensorless homing or a hard stop (DEFAULT). The lead twist (Problem 2) carries 19 wires (C, `nox/box/box-wiring.md`; was 15 E, which missed the servos).
4. **80T web drilled** for 3 x M3 on Ø36 (DEFAULT; collar Ø30 P leaves 0.25 to the heads, drill through the ring), bolted to the fixed sun post (not the hub); drill its bore out to Ø12 if the slip ring's fixed leads pass through it (Problem 2).
5. **Printed glides on the bar**: fine for the demo, wears. **Closed by v5 (23 Oct): bearing carriages on printed V-rails (section v5).**
24. **Axle motor shaft tip vs the detent anchor (v4, found 23 Oct):** the anchor post at (−38.9, −56.3) is 5.6 from the axle motor's shaft axis (−34.7, −60.1); the shaft (Ø5, to Y 74) runs through the post (Y 66.3..74) by ~0.9. `detent.py obstacles()` has the 20T but not the shaft. Fix for the demo: cut the axle motor's shaft at Y 64 (flush with its 20T, DEFAULT), or check that the delivered shaft is shorter. Gone in v5 (the detent moves).
25. **v5 open items:** the eccentric spacer's hex pocket size (CHECK the part on hand, else a printed eccentric bush); the V-wheel contact band is ~2 mm per flank (printed PETG on printed PETG: wear unknown, run the carriage 500 strokes on the first rail print); rack / pinion backlash 0.2 as the gripper's; the pinion grub on the D-flat (flat starts 4 from the face, boss Y 56.5..64: fine); the hub v5 posts carry the rails as they carried the bars (same bolts), but hub v6 is needed anyway for the motor seats.
6. **Gripper spring not drawn** (band, DEFAULT).
7. **Printed module-1 gears, 0.2 backlash**: first print tells.
8. **Funnel hub** must pass the cartridge + open blades: opening X ±23, Y 96..180 (current-parts Problem 30).
9. **Hub films / pinched mesh** (h 2.5 artefact): the 22:43 hub has 0.3-thick films, ~114 mm² (M), at r 30..35.5, Y 48..49 over the bore cavity, in two patches (about −30..0° and 120..150°). Under one line width: the slicer drops them; let Bambu Studio repair the rest.
11. **Rib only 0.8 deep**: test on the swap test print first (Spark 17 Oct 01:37: test print yes); widen the cartridge recess to 31 only if it slips.
14. **Servo stands radially:** its body hangs to u −51.7, 19.7 past the axle when parked (at Y 166..207, where nothing else is). The glide-to-servo body is now a ~110 long cantilever along Y (Y_C 175).
15. **Overseer:** not designed now (Spark 17 Oct 02:02: Scout only). Its cartridge (pack 148 x 48 x 45 P, est. 153 x 51 x 57 E) carried at park would reach r ~107 and hit the seated packs at R 100: grow R ~9 or make its cartridge lower when it is designed. A 51 wide Overseer cartridge also only just fits the 30° sector at r 100.
26. **XT60 forces are E (section XT60 swap):** Amass gives 18 to 44 N for the XT60L; a worn plug pulls lighter, a new one may push harder. Fix: D17 on the scale, then the swap coupon at 2 A; if the head stalls, the 12T pinion.
17. **Capture float (`archive/scout-v2/s2-cartridge.md` Problem 8, now reoriented):** a receiver's lead-ins move the cartridge up to 3.3 in x (tangential now) and z (along the axle). x: de-energise the axle motor for every insert stroke (3.3 at r 150 = 1.3°, DEFAULT). z: the head is stiff along Y; a ±1.5 TPU float under the rack guide block (not drawn). Check on the swap test print.
16. **Head A and B are mirror variants** with mirrored fingers: print the right set for each head.
18. **Belt clamp v2 hold is untested:** meshed pair 2.01 is from the belt spec (E), belt 7.6 g/m (E), idler pitch = the 20T's (E). Fix: the coupon set picks the slot (P); weigh the spare belt; measure the idler (D13).
19. **Ø3 pin is a tighter wrap than the Vampire Bat's 4 mm tube.** GT2 bent teeth in round Ø3 may crack its backing after many re-folds. Fix if it does: Ø4 rod (hole 4.3, pocket r 3.73); the zone then needs 40.7, so 5.5 teeth per slot or a 41 zone.
20. **Detent pull (solved 17 Oct, C / E):** peak 0.082 N·m per newton of pull at 38 because the roller sits on the notch edges, not the flanks; 0.366 N·m to beat (E) needs ≥ 6.7 N total for margin 1.5. Now rubber bands (Spark 11:00): hang-test them (Pull bullet), retest after a few days for relaxation, add a strand if the arm drifts with the driver off. More margin if needed: a stiffer spring under the 42 limit, or a ring with flanks the roller reaches (half angle ≥ 35°: tangent point under r 23.5).
21. **Detent stops vs the new bay list: checked (hub v5 chat, 17 Oct 09:05; again 18 Oct for the −90° cycle).** With 9 bays at 30° (v4c) `detent.stops()` gives 14 arm stops phi −270..120 at 30° pitch, which fold to the same 12 notches every 30° (C): ring unchanged, 7.0 g, 1.59 wall to the bolts.
22. **Harness open items (`nox/box/box-wiring.md` Problems):** grommet / end clips / slot clips clearance search + STLs (the grommet is not used with stub v3); head v5 wiring entry channel (head chats); fold-in-slot hand test in a 2040 offcut before the heads print; sweep keep-outs (sweep chat); 6.8 V servo buck not on the buy list; bore heat check on the soak test (fallback: drivers to 1.2 A, margins in the wiring doc).
23. **Stub v3 bolts (E, CHECK):** the counterbores take ISO 7380 button heads (Ø9.5 x 2.75); a different head (socket, flange) does not fit under bearing 1. The M5 x 8 shank reaches 4.75 below the post face: check with one T-nut in an offcut that it pulls the nut up before it touches the slot floor (slot depth ~6.1, E). If only socket heads are on hand: buy 4 x M5 x 8 ISO 7380.

## Status
Live state of each part: `nox/current-parts.md`. Notes, newest first. 23 Oct (arm-v5 chat): **v5 layout** (section v5): printed V-rails + 3-wheel 625ZZ carriages + rack and pinion replace the bars, belts, idlers and clamps; motors v5 A (53.5, 55) / B (−55, −53.5) / axle at −39°; every 2D gap ≥ 1.0 over the stroke; detent re-placed at −45° (candidate); compaction C1 / C2 = Y_C 138 / 118, enclosure 403 → 366 / 346; `arm_v5_layout.py`, `runs/arm/v5-layout/`. 18 Oct (arm chat): **stub v3 drawn and saved** (47.7 g C, `box_stub_v3.stl.b64.txt`, v2 removed; one 2040 post, button heads flush under bearing 1, Ø40 hollow, lead channel −X); **swap cycle moved to the −90° bay** (`arm_layout.DEMO_BAY`, phi −180..90, 540° per cycle, 296 states, 0 overlaps, closest 0.14 designed; detent stops unchanged); `arm_layout.py`, `arm_cad.py`, `arm_kinematics.py`, `export_hub_set.py` saved to Nox Source. 17 Oct 22:50: **hub print set saved to Nox Print Files** (hub v5 regenerated 22:43 because the 09:05 mesh was gone: 214.2 g M, worst 0.30, bore Ø80.2 drawn, 0 overlaps; stub v2, sun post, detent ring + roller arm, idler ends A / B, pinions, fingers x4 rebuilt from the scripts); scripts `post_hub_v5.py`, `export_hub_set.py` and the bore change in `arm_cad.py` saved to Nox Source. 17 Oct 19:10: **head A v5 done** (56.1 g M, worst 0.45, 0 overlaps, BUILT at slot 2.0; READY after the coupon pick). Belt clamp v2 drawn into `arm_cad.py` for both heads (`belt_clamp_v2_head.py`); head v5 wiring entry channel, zip fin and plate zip tab drawn (dimensions I). Head B v5 runs in its own chat. 17 Oct 16:10: **arm harness v1 (`nox/box/box-wiring.md` + `arm_wiring.py`):** 19 wires through the post bore (the 15-count missed the head servos), bundle Ø7.3 in Ø8.5 (1.2 clear), twist strain 0.74 %; on-axis saddle tie on a printed end clip (M5 into the bar's core hole), 135° drop lane to the hub struts, servo ribbons folded inside the bars' top T-slots (bottom slots hold the post nuts); open: clip STLs, head v5 entry channel, slot hand test, sweep keep-outs (Problem 22). 17 Oct 15:40: **belt clamp v2 (loop and pin) replaces v1** (Spark 15:35: v1 didn't work); coupon set v2 saved in Nox Print Files; the v1 coupon and head plates (printed 13:18) are retired; heads A / B v5 take v2 with the coupon's slot width. 17 Oct 13:10: print set checked (`arm_print_set.png`): hub v5, stub, sun post, detent ring + roller arm, idler ends A / B, pinions x2, fingers x4; all one watertight body, fit 180, oriented for the bed (M). Not ready: heads A / B v5 (own chats; gated by the v2 coupon). 17 Oct 12:45: hardware measured: bearing, NEMA (17HS19-2004S1), 20T, 80T flange / collar / length match or beat the CAD except the 80T collar (Ø30, was 24): ring rebored Ø30.5; open: the 80T body width. 17 Oct 11:50: print prep done: hub v5 print file (bore Ø80.2). 17 Oct 10:55: detent solved through its motion: 0 overlaps, but one spring does not hold (Problem 20), artifact "Nox Arm Detent". 17 Oct 09:05: **hub v5 done** (detent tower drawn in, 215.8 g M, worst 0.31, 0 overlaps). 17 Oct 06:30: **bay module v4i done** (universal, 83.5 g, worst 0.05, M5 joints, print near end down); layout v4c / v4d published (Y_C 175, 9 bays at 30°, 90° opening, servo from photos). The full sweep + artifact run in their own chat after the heads (meshes: `box_baymod_v4_W.stl` from this chat, the heads' `_W.stl` from theirs). Swap test print (Spark 01:37): one bay module, one cartridge, head A. Linked bay modules are the standing frame (`nox/box/box-stand.md`); the bay ring chat adds front feet, funnel seats and spider bosses to them (new numbers: `nox/box/box-case.md`).
