sparkiscool/noxen/parts/box_arm8/kit/box_arm8_blade.png

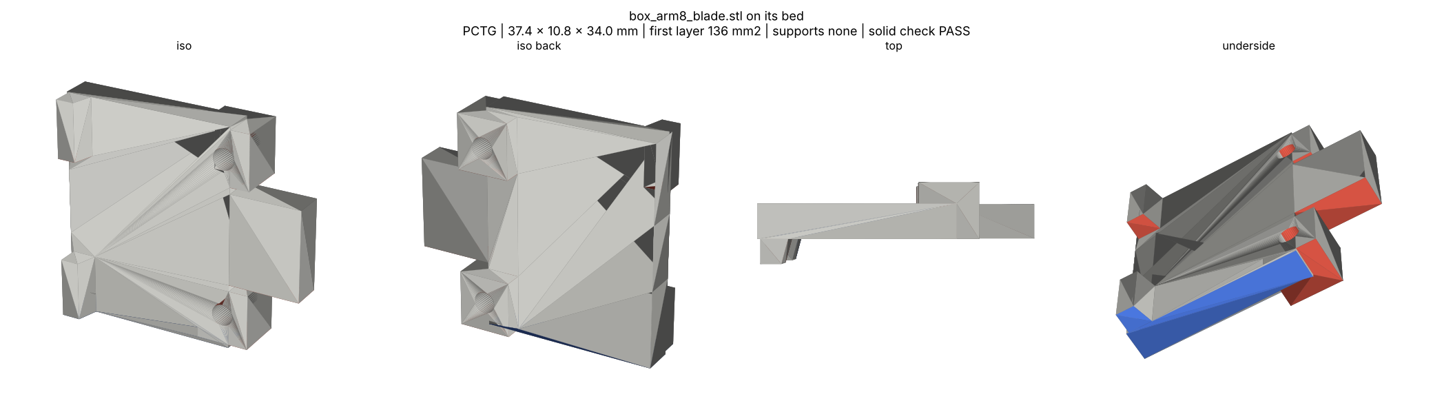
parts/box_arm8/kit/box_arm8_blade.png
