sparkiscool/noxen/parts/box_arm8/kit/box_arm8_detent_arm.png

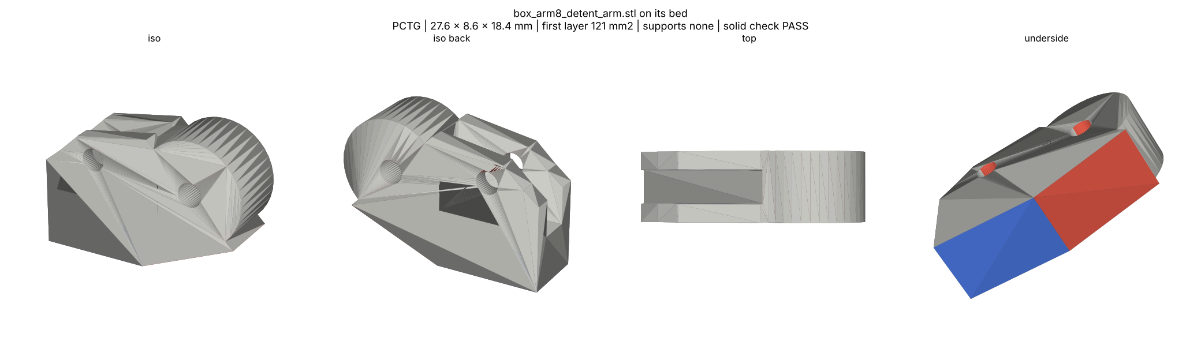
parts/box_arm8/kit/box_arm8_detent_arm.png
