sparkiscool/noxen/parts/box_arm8/kit/box_arm8_pad_a_28.png

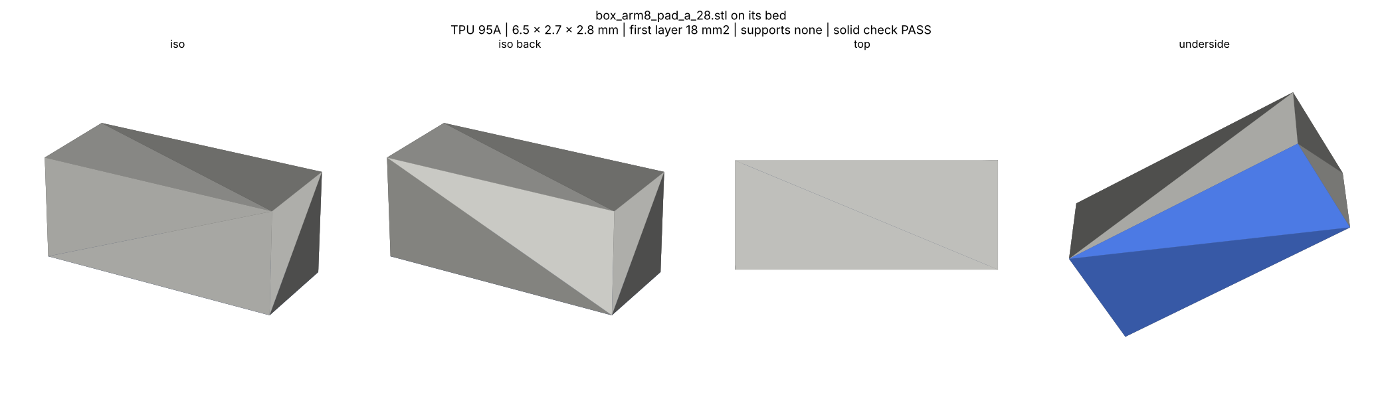
parts/box_arm8/kit/box_arm8_pad_a_28.png
