sparkiscool/noxen/parts/box_arm8/kit/box_arm8_paddle.png

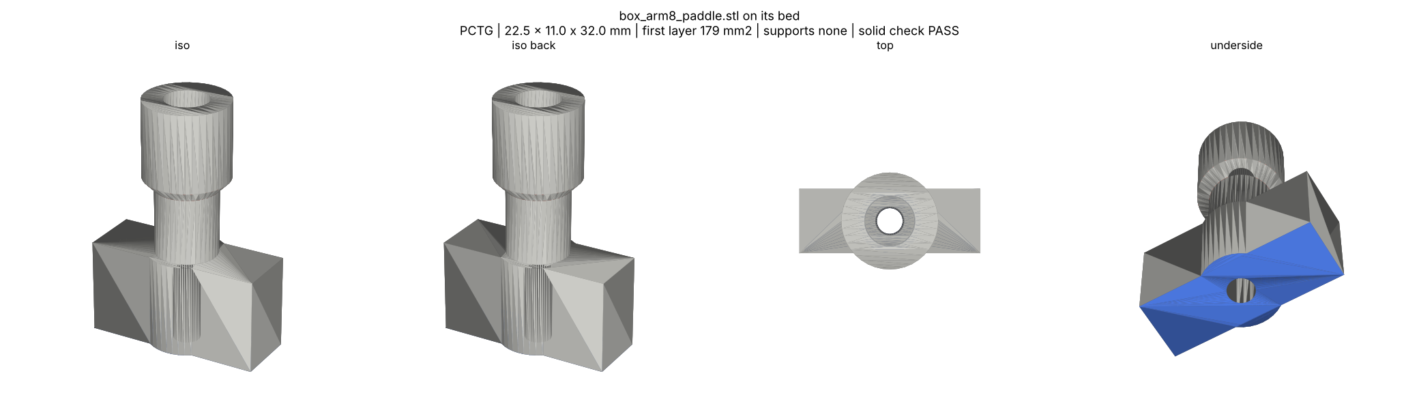
parts/box_arm8/kit/box_arm8_paddle.png
