sparkiscool/noxen/parts/box_arm8/kit/box_arm8_post.png

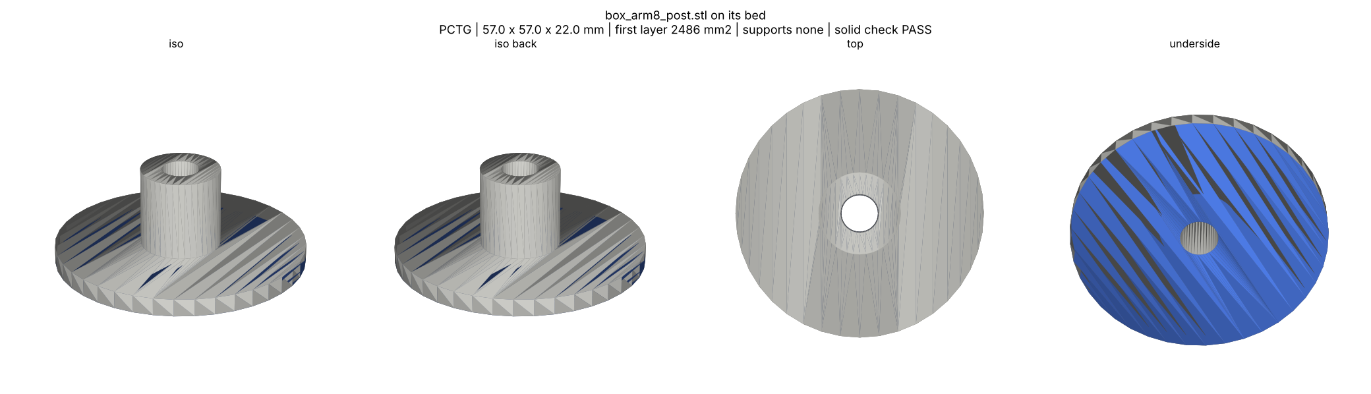
parts/box_arm8/kit/box_arm8_post.png
