sparkiscool/noxen/parts/box_arm8/kit/box_arm8_saddle_overseer.png

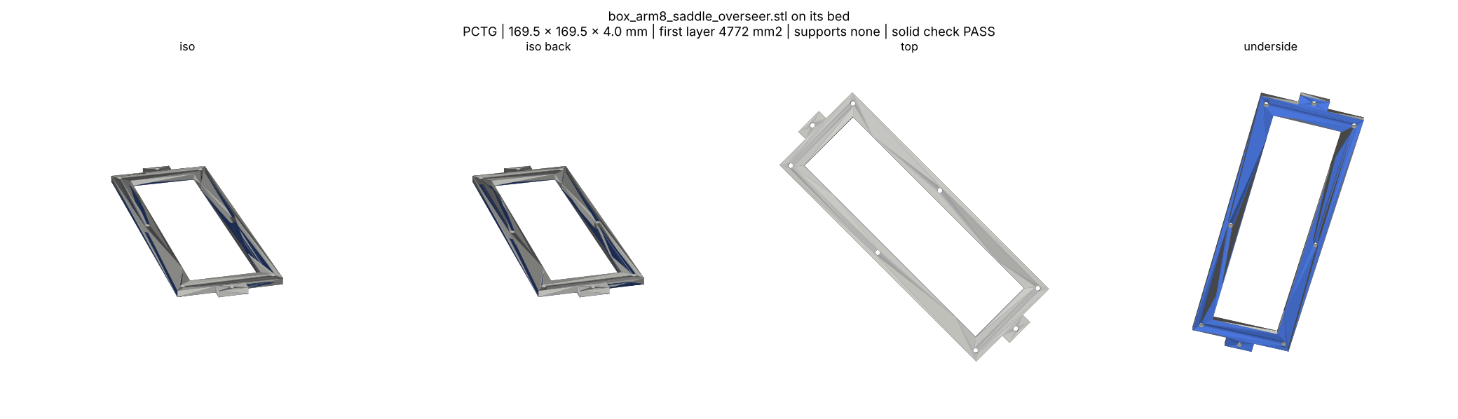
parts/box_arm8/kit/box_arm8_saddle_overseer.png
