sparkiscool/noxen/parts/box_arm8/kit/box_arm8_saddle_scout.png

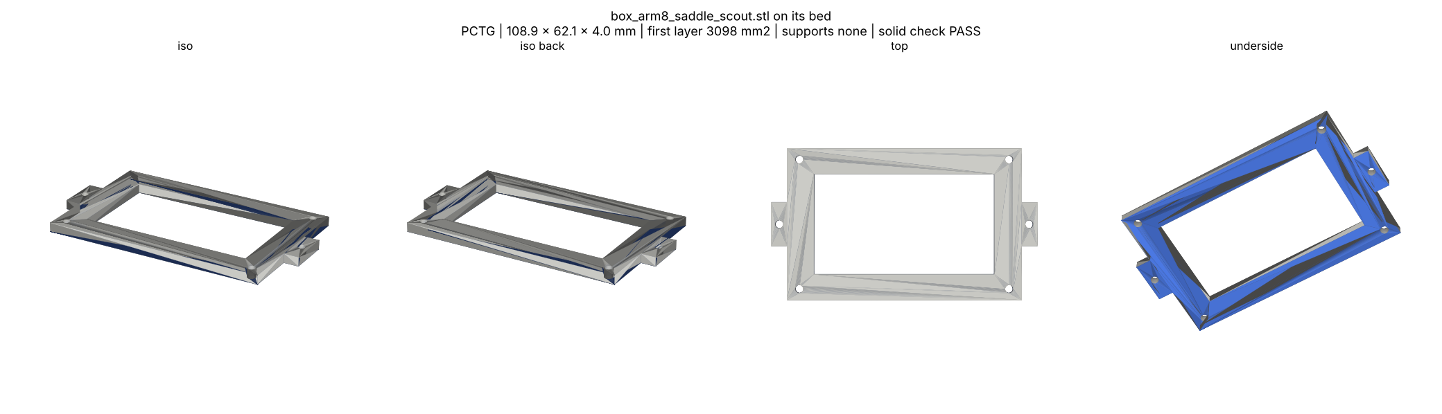
parts/box_arm8/kit/box_arm8_saddle_scout.png
