sparkiscool/noxen/parts/box_arm8/kit/box_arm8_tie.png

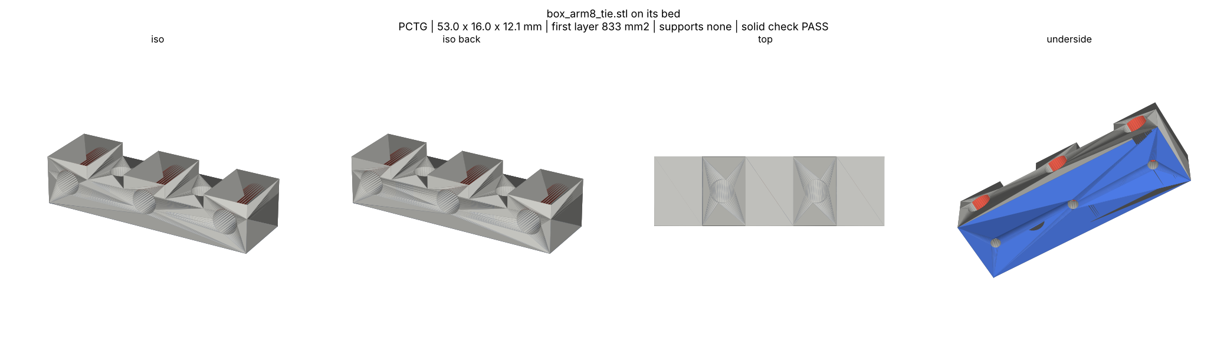
parts/box_arm8/kit/box_arm8_tie.png
