sparkiscool/noxen/parts/box_arm8_carriage/preview.png

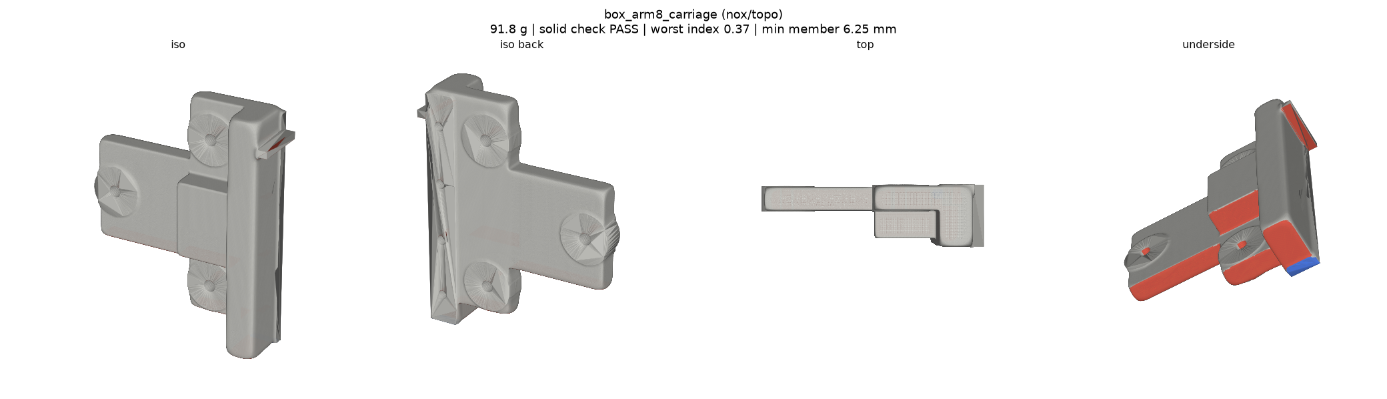
parts/box_arm8_carriage/preview.png
