sparkiscool/noxen/parts/box_arm8_hub/preview.png

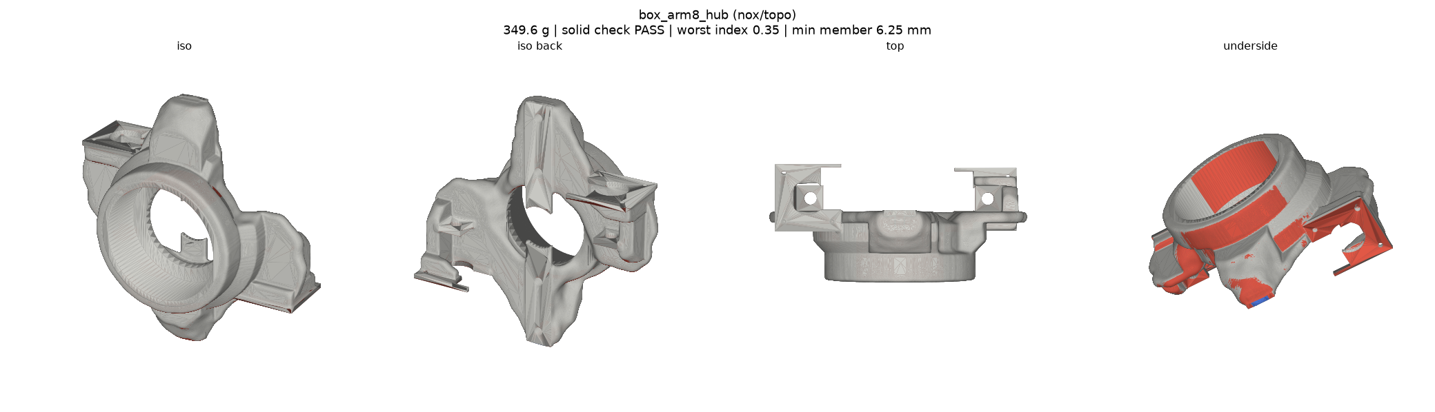
parts/box_arm8_hub/preview.png
