sparkiscool/noxen/parts/box_arm8_lift/preview.png

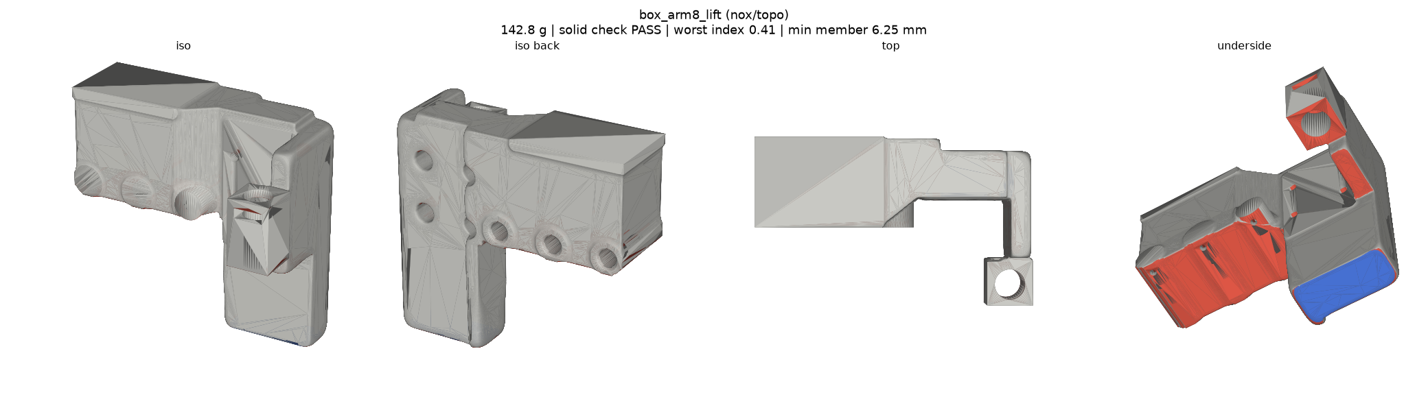
parts/box_arm8_lift/preview.png
