sparkiscool/noxen/parts/box_funnel/kit/box_funnel_arm.png

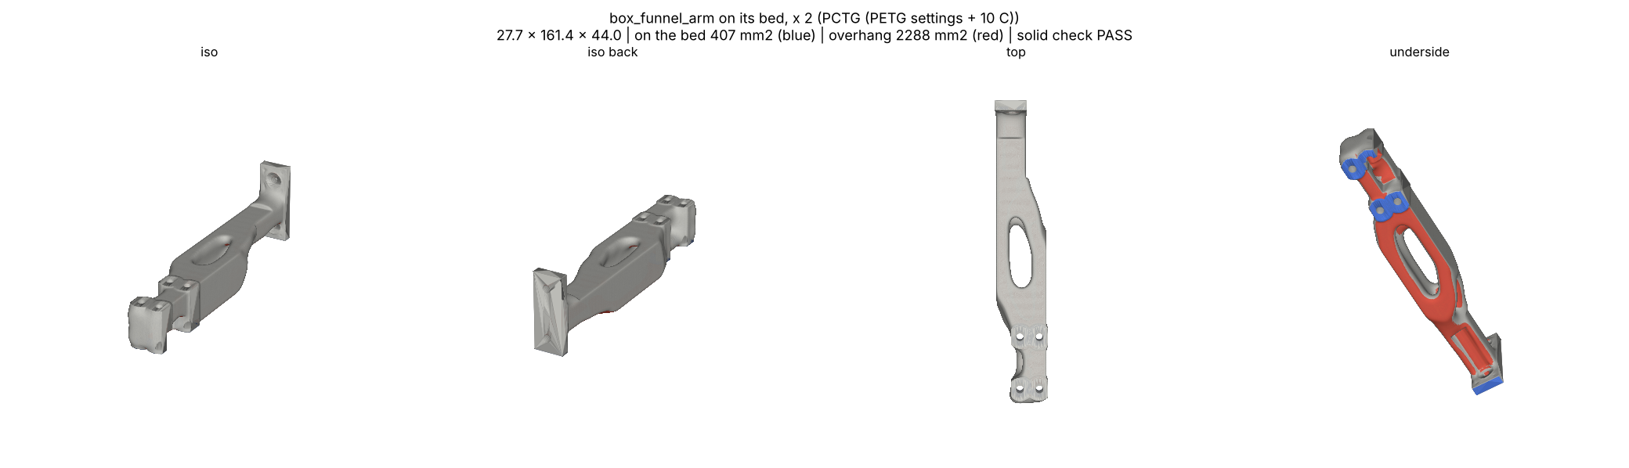
parts/box_funnel/kit/box_funnel_arm.png
