sparkiscool/noxen/parts/box_funnel/kit/box_funnel_arm_mirrored.png

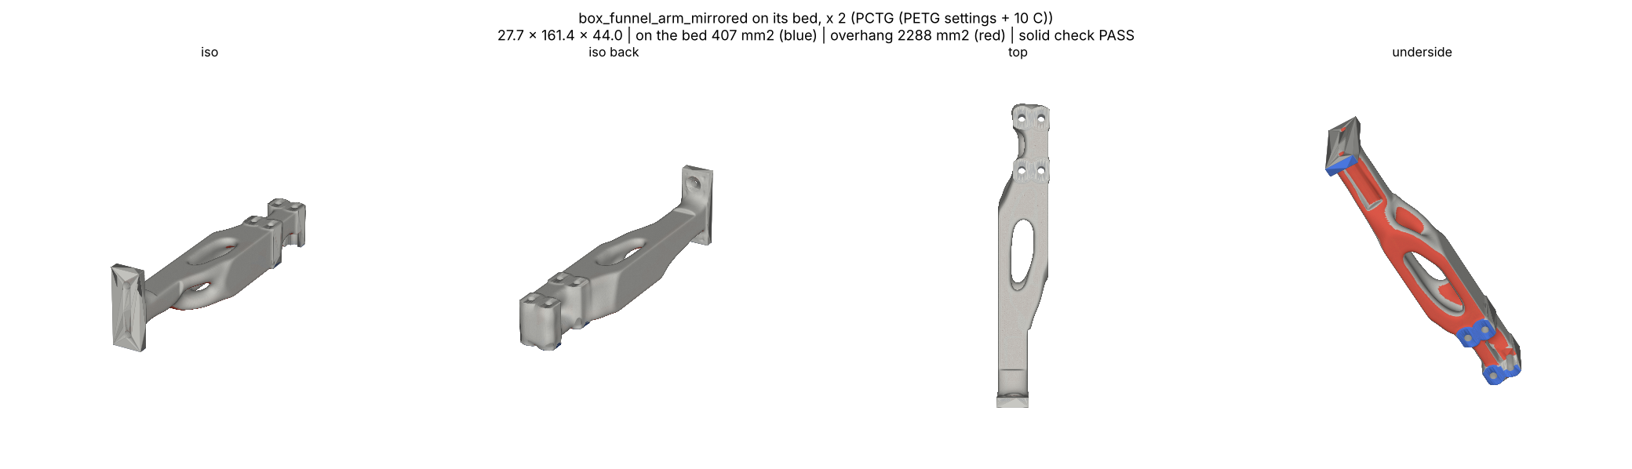
parts/box_funnel/kit/box_funnel_arm_mirrored.png
