sparkiscool/noxen/parts/box_funnel/kit/box_funnel_half_nose.png

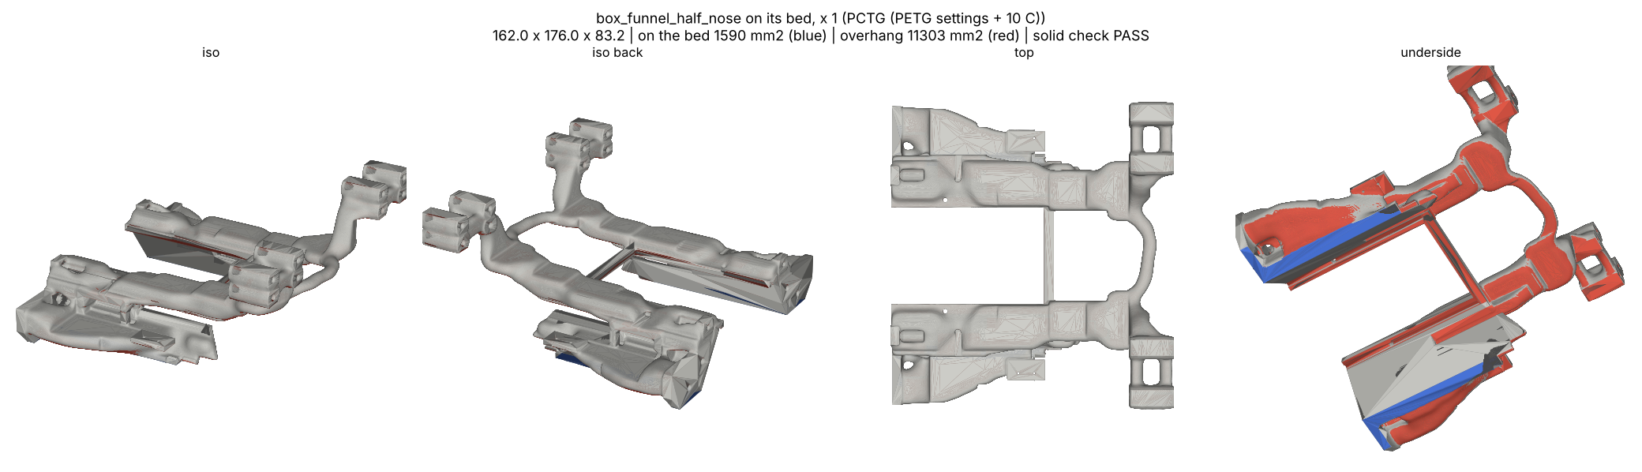
parts/box_funnel/kit/box_funnel_half_nose.png
