sparkiscool/noxen/parts/box_funnel/kit/box_funnel_half_tail.png

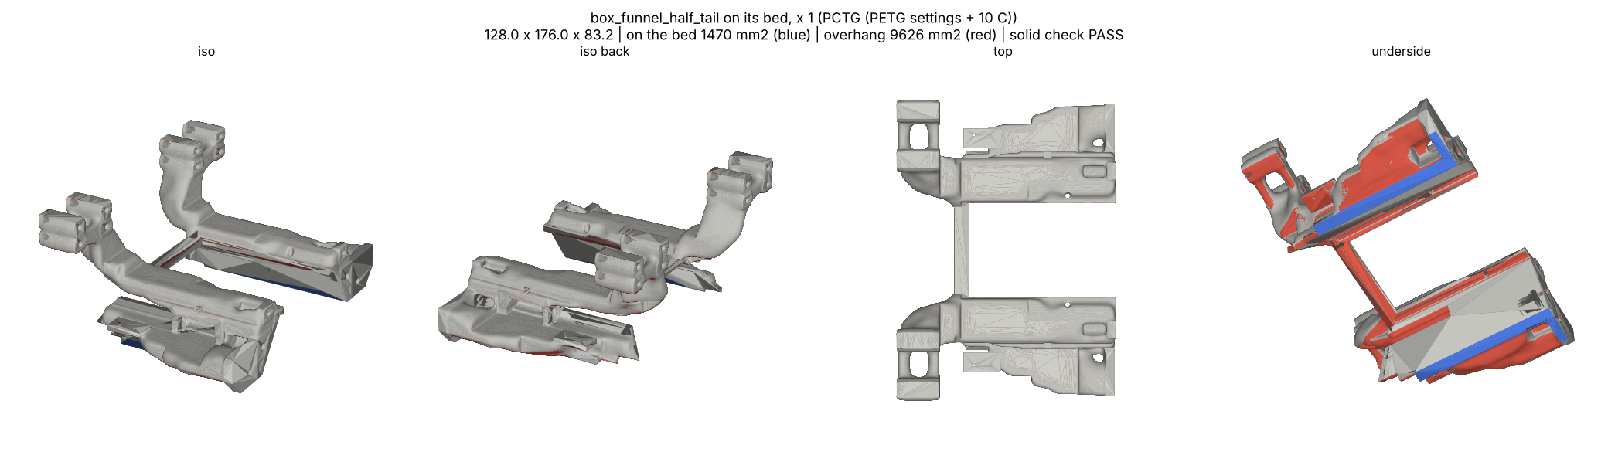
parts/box_funnel/kit/box_funnel_half_tail.png
