sparkiscool/noxen/parts/box_funnel/kit/box_funnel_wall_nose.png

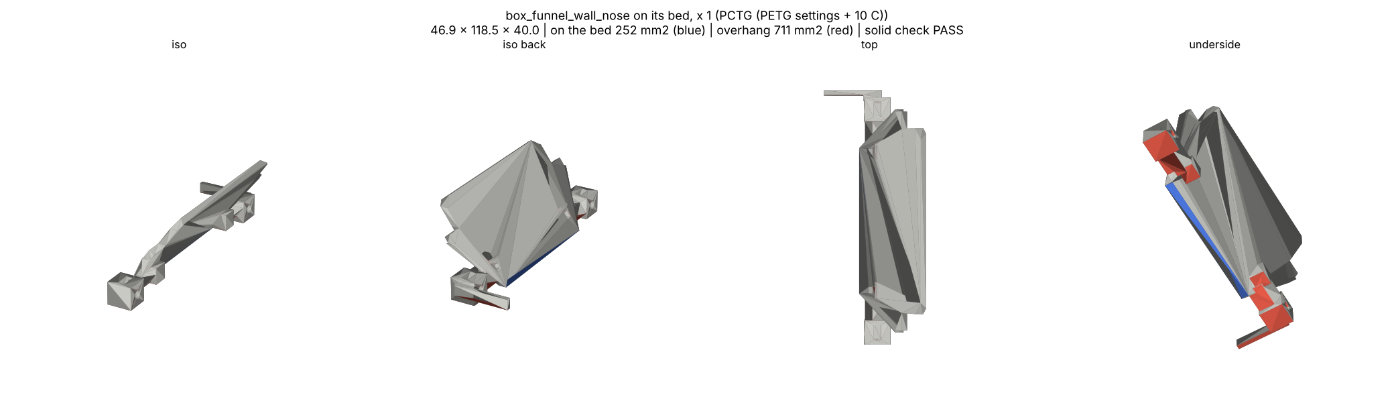
parts/box_funnel/kit/box_funnel_wall_nose.png
