sparkiscool/noxen/parts/box_funnel_arm/preview.png

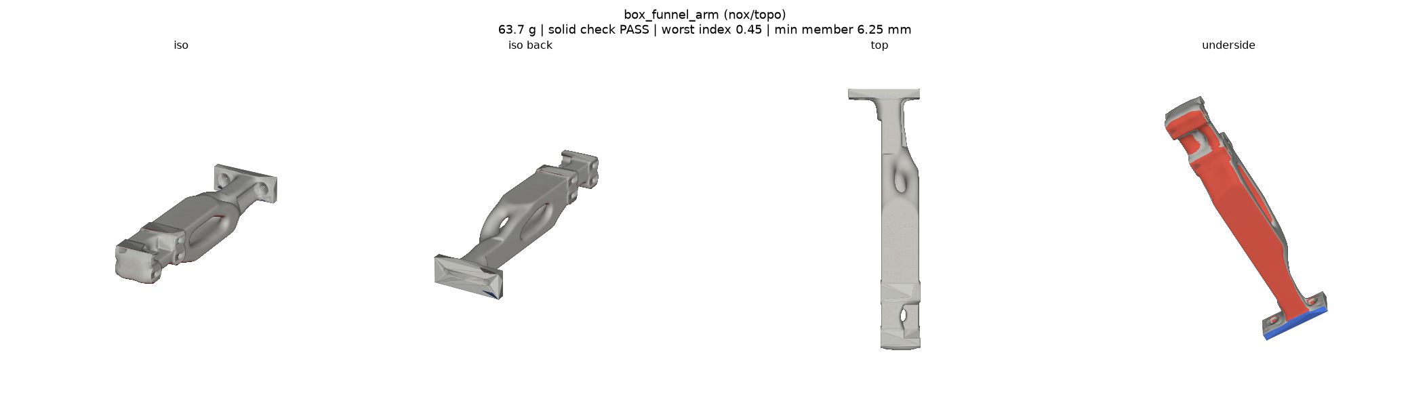
parts/box_funnel_arm/preview.png
