sparkiscool/noxen/parts/box_funnel_half_nose/preview.png

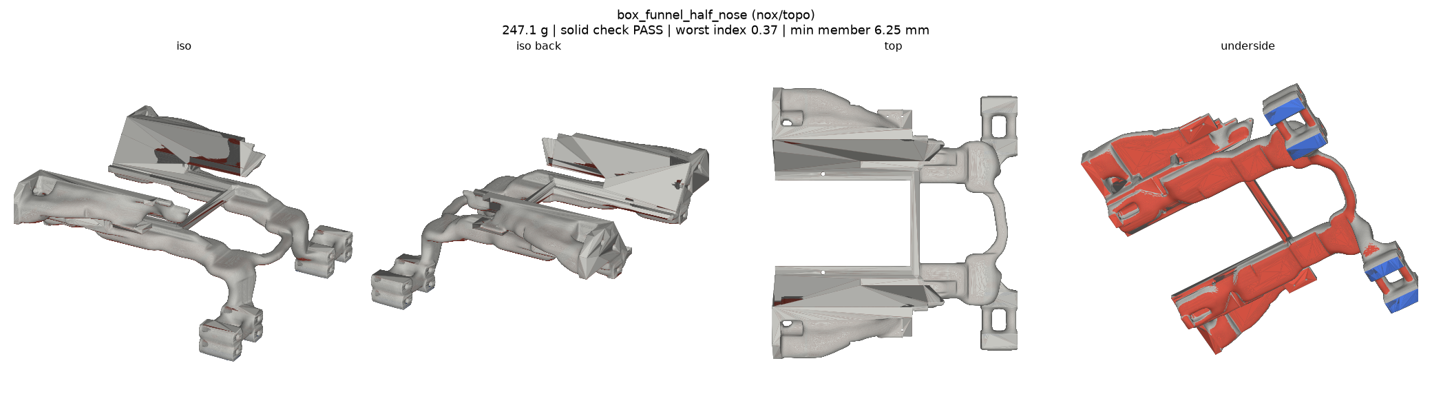
parts/box_funnel_half_nose/preview.png
