sparkiscool/noxen/parts/box_funnel_half_tail/preview.png

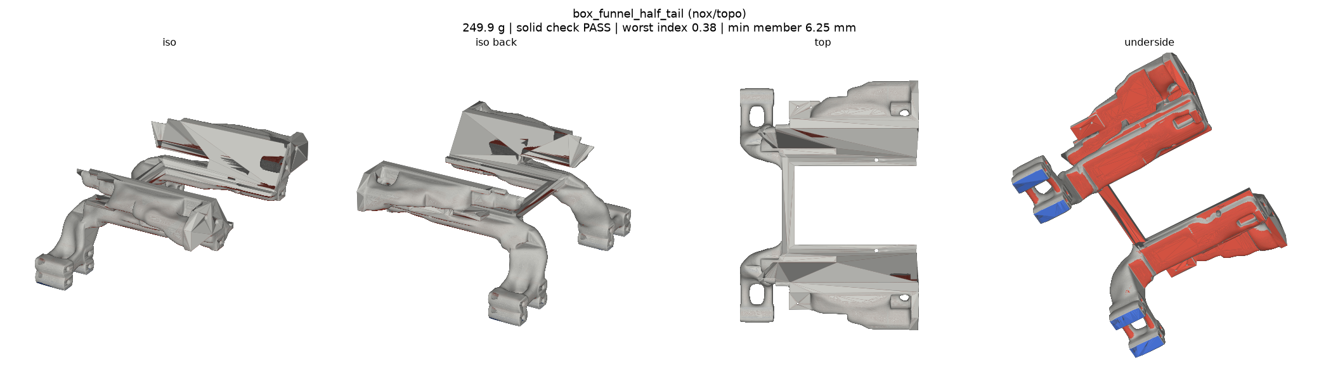
parts/box_funnel_half_tail/preview.png
