sparkiscool/noxen/parts/holder/preview.png

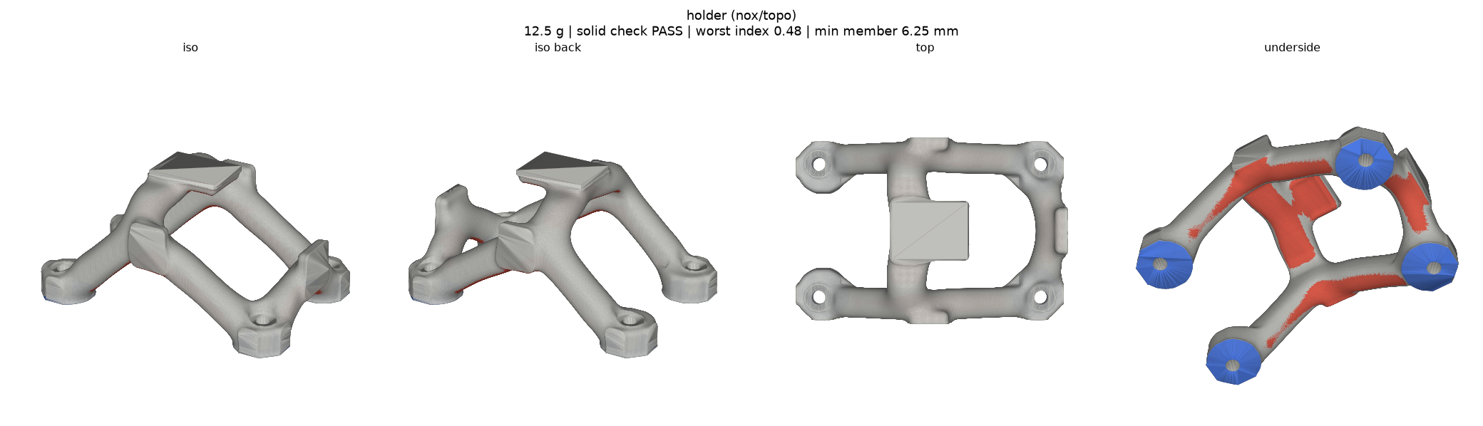
parts/holder/preview.png
