sparkiscool/noxen/parts/hub_deck/preview.png

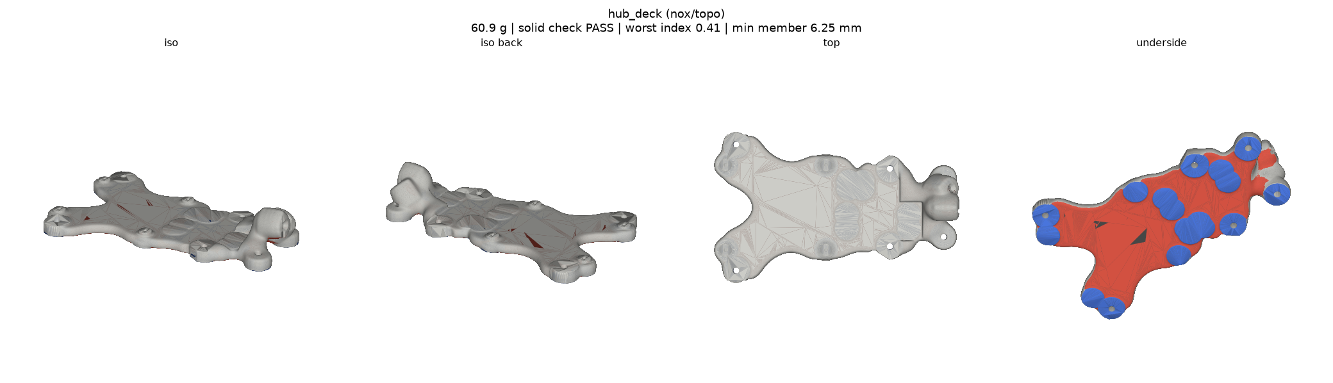
parts/hub_deck/preview.png
