sparkiscool/noxen/parts/latch7/kit/latch7_cartridge.png

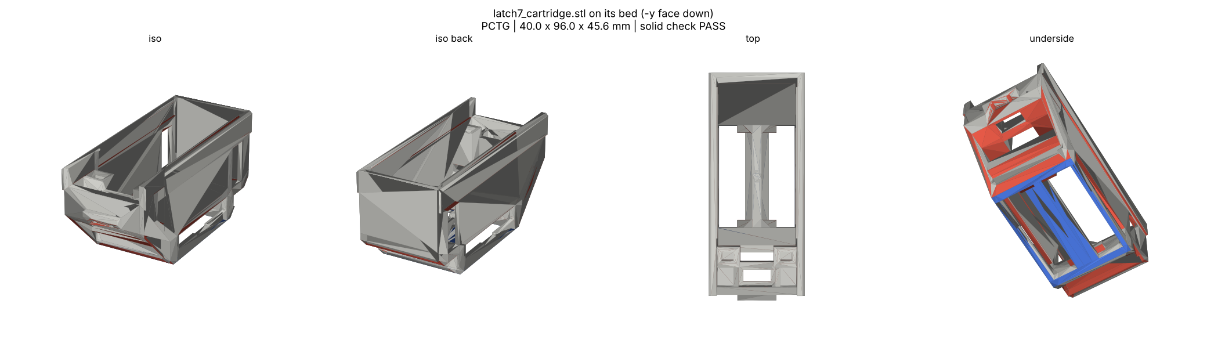
parts/latch7/kit/latch7_cartridge.png
