sparkiscool/noxen/parts/latch7/kit/latch7_ov_bolt.png

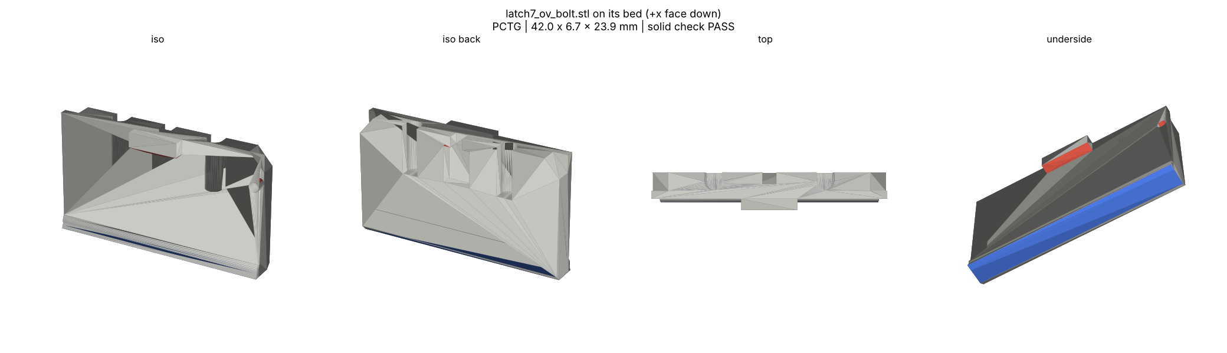
parts/latch7/kit/latch7_ov_bolt.png
