sparkiscool/noxen/parts/latch7/kit/latch7_plug_collar.png

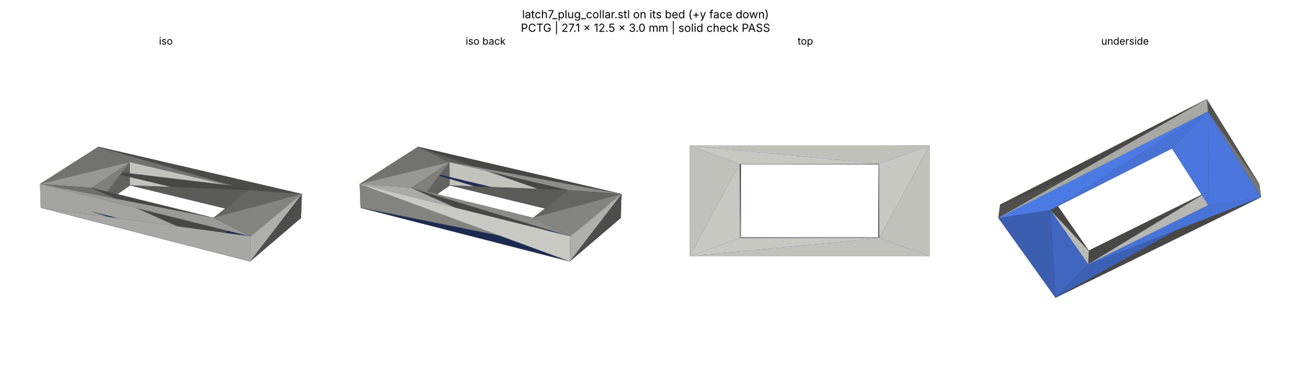
parts/latch7/kit/latch7_plug_collar.png
