sparkiscool/noxen/parts/latch7/kit/latch7_spring_pin.png

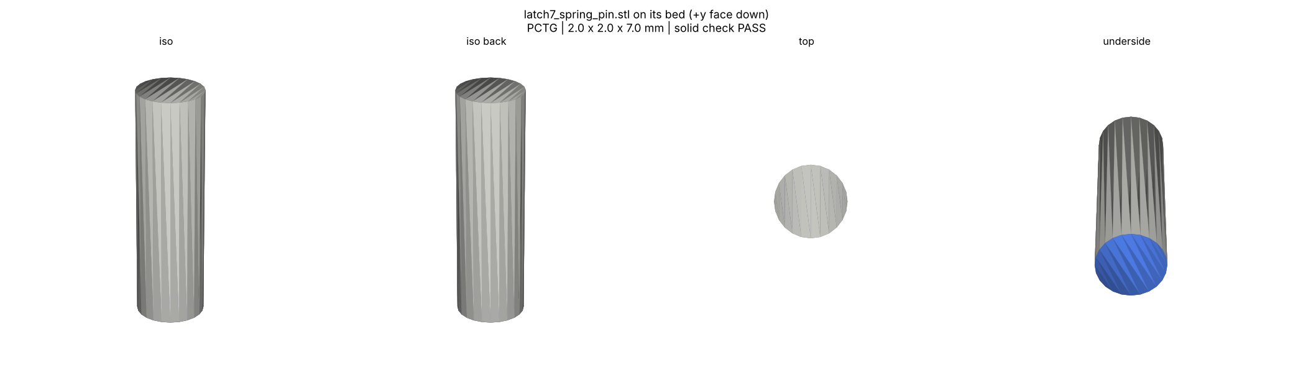
parts/latch7/kit/latch7_spring_pin.png
