sparkiscool/noxen/parts/motor_mount/preview.png

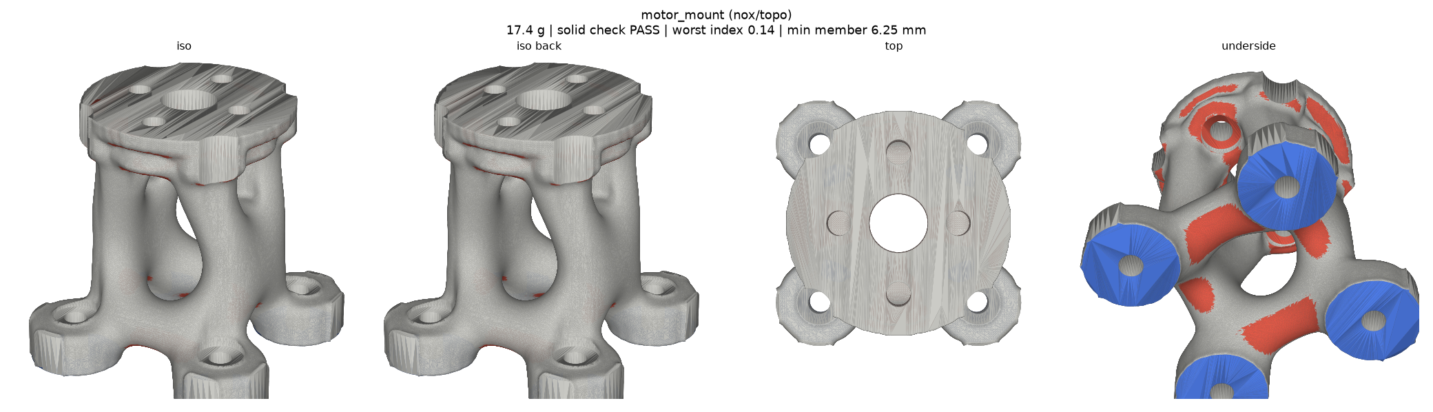
parts/motor_mount/preview.png
