sparkiscool/noxen/parts/overseer_arm_front_pad/preview.png

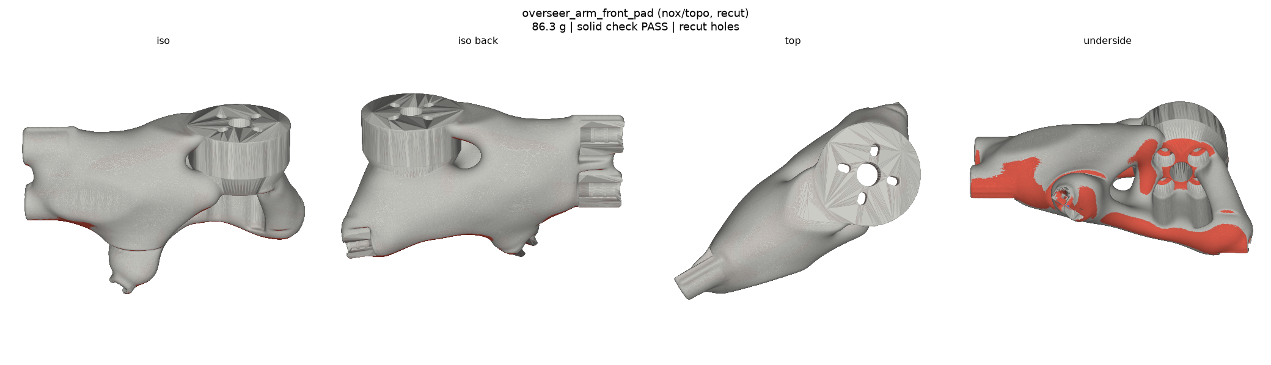
parts/overseer_arm_front_pad/preview.png
