sparkiscool/noxen/parts/overseer_arm_front_root/preview.png

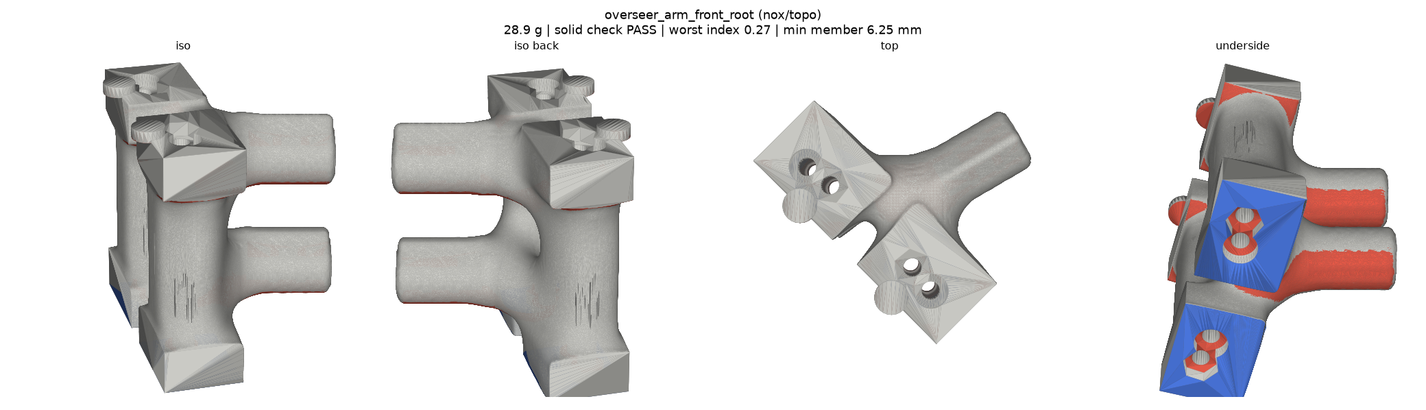
parts/overseer_arm_front_root/preview.png
