sparkiscool/noxen/parts/overseer_base/preview.png

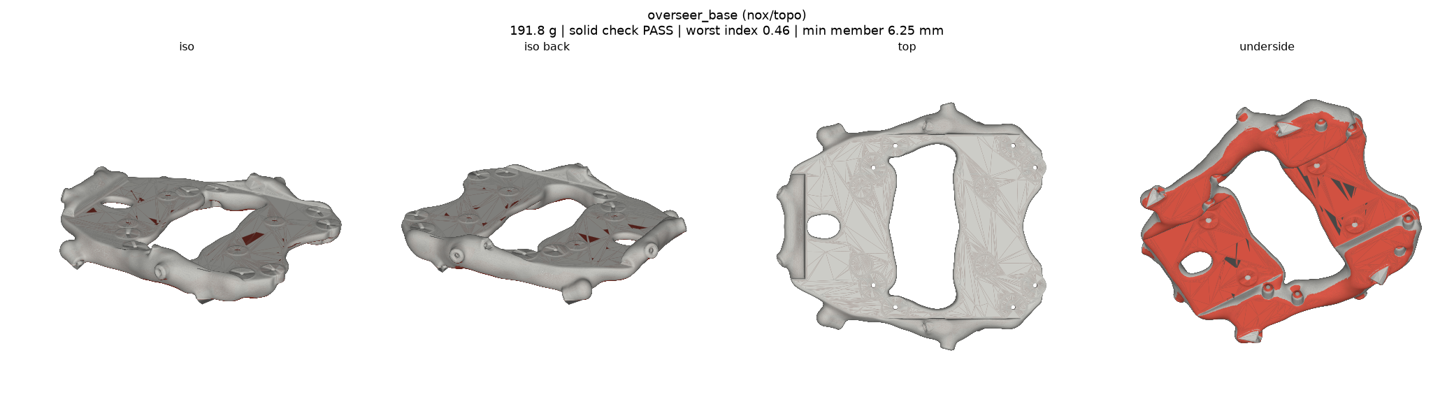
parts/overseer_base/preview.png
