sparkiscool/noxen/parts/overseer_cage_node_3/preview.png

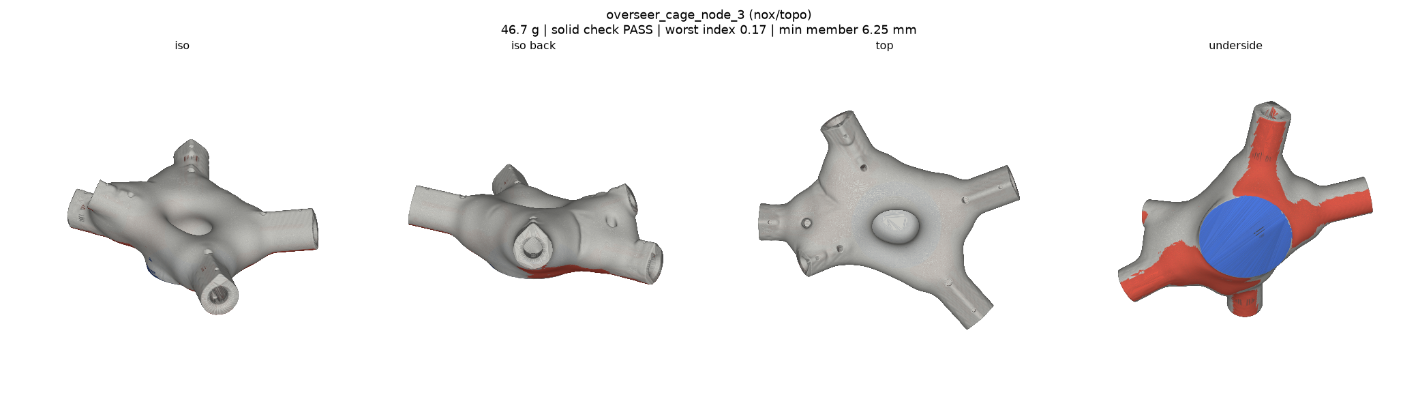
parts/overseer_cage_node_3/preview.png
