sparkiscool/noxen/parts/overseer_cage_node_4/preview.png

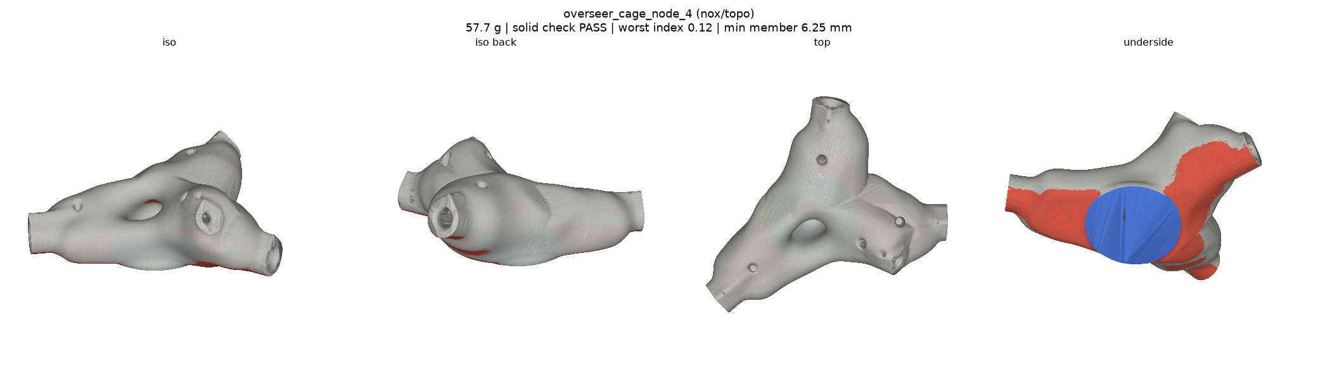
parts/overseer_cage_node_4/preview.png
