sparkiscool/noxen/parts/overseer_cage_node_5/preview.png

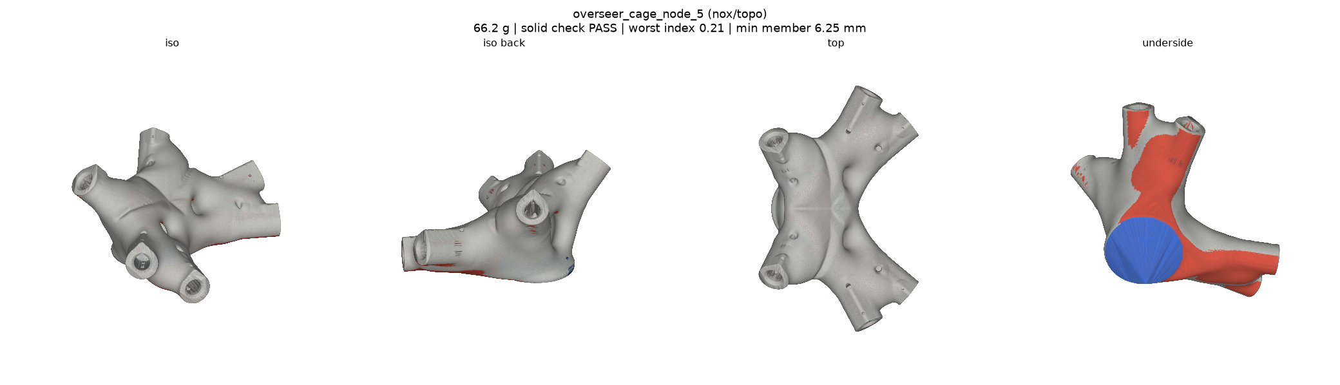
parts/overseer_cage_node_5/preview.png
