sparkiscool/noxen/parts/overseer_cage_node_6/preview.png

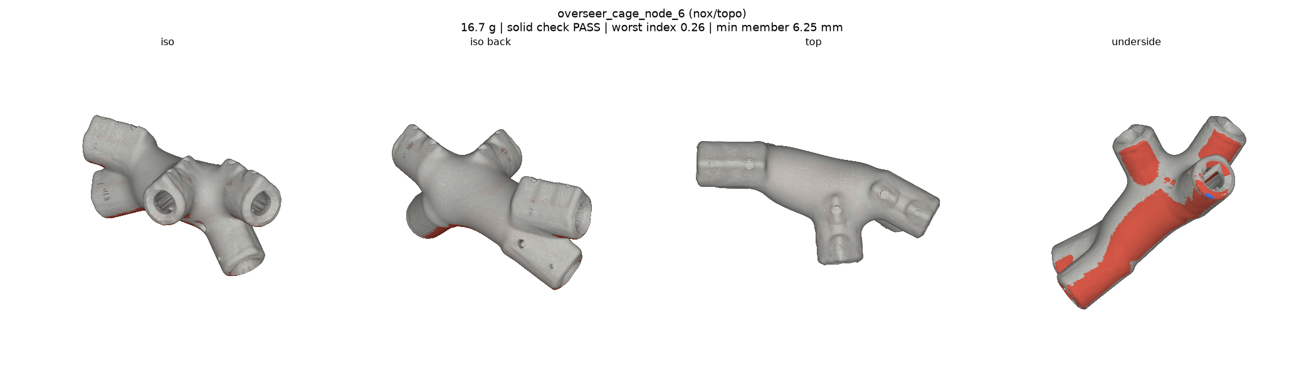
parts/overseer_cage_node_6/preview.png
