sparkiscool/noxen/parts/overseer_cage_node_7/preview.png

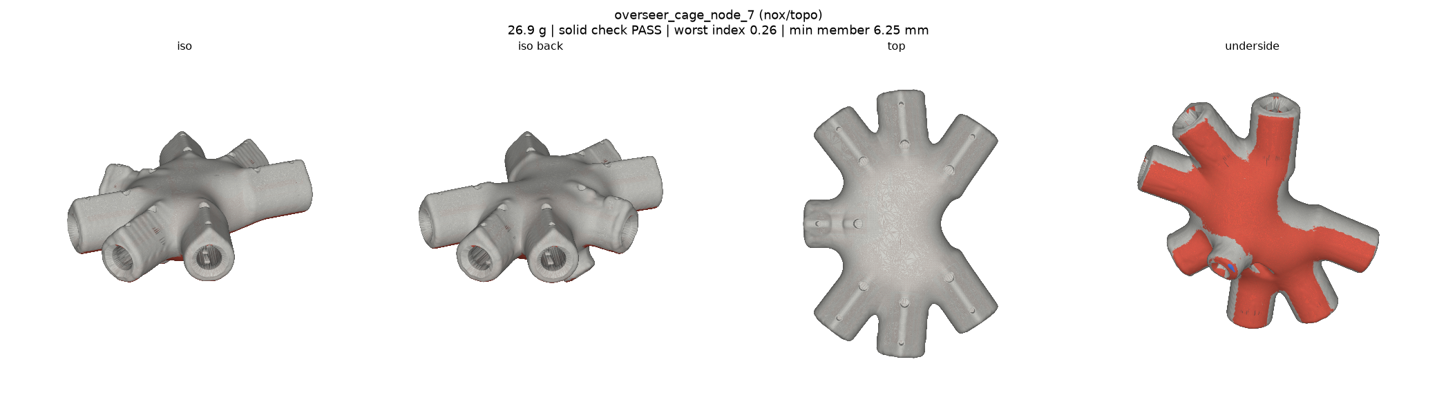
parts/overseer_cage_node_7/preview.png
