sparkiscool/noxen/parts/overseer_cage_node_11/preview.png

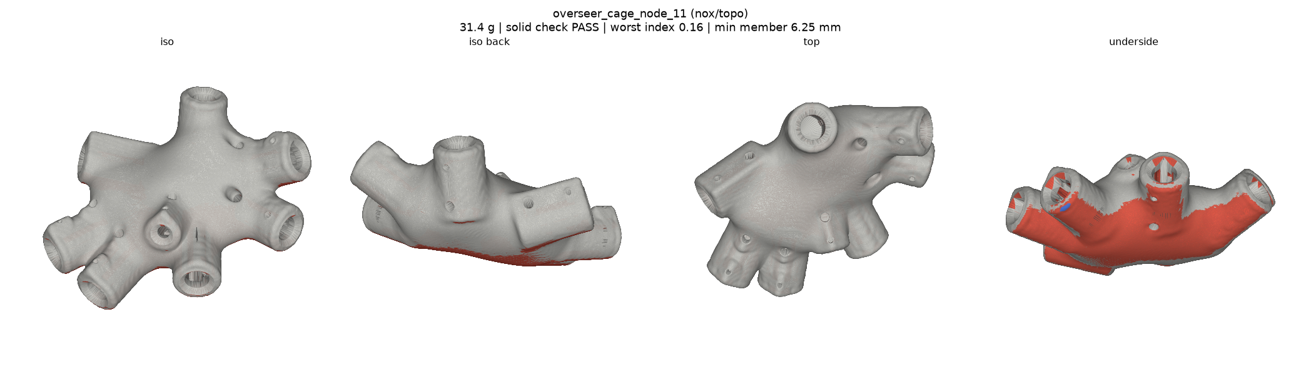
parts/overseer_cage_node_11/preview.png
