sparkiscool/noxen/parts/overseer_cage_node_13/preview.png

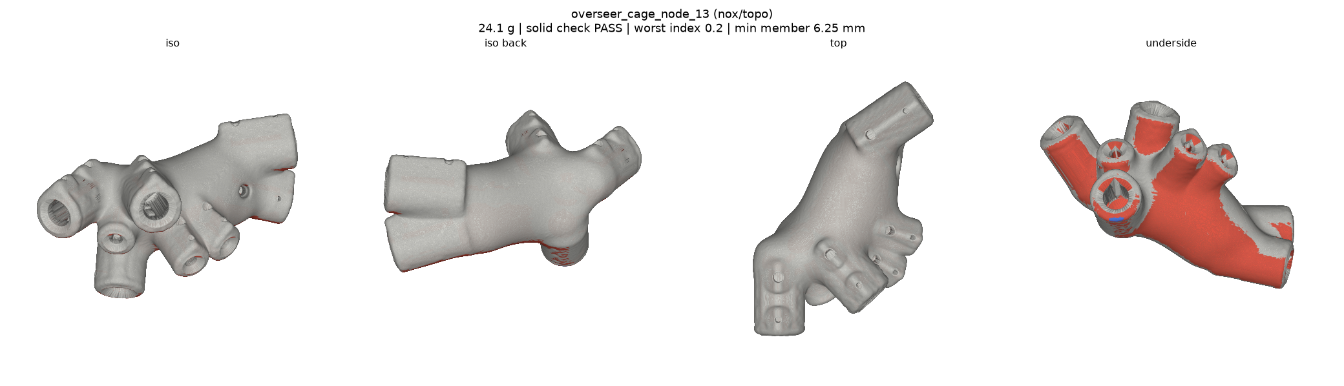
parts/overseer_cage_node_13/preview.png
