sparkiscool/noxen/parts/overseer_cage_node_15/preview.png

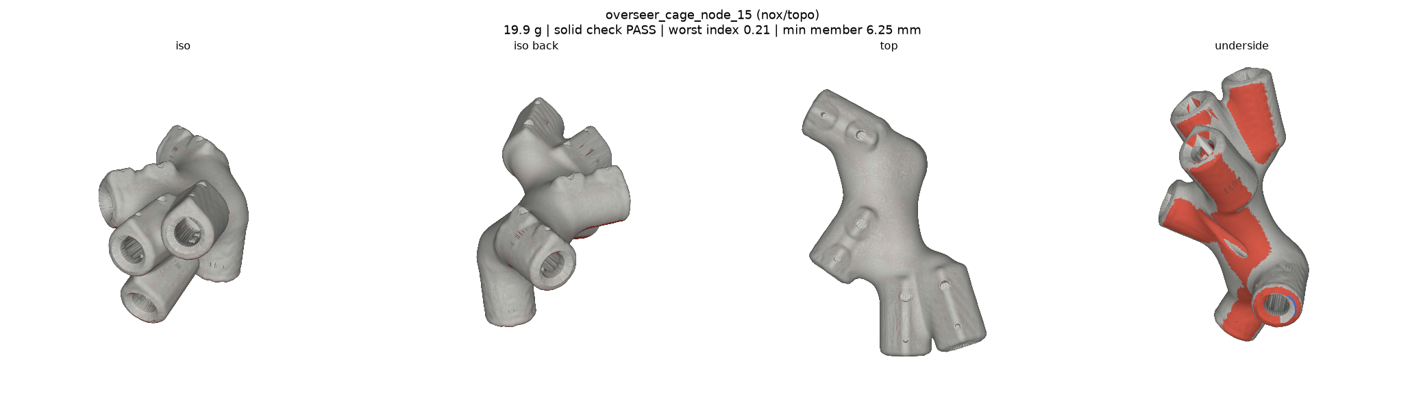
parts/overseer_cage_node_15/preview.png
