sparkiscool/noxen/parts/overseer_cage_node_18/preview.png

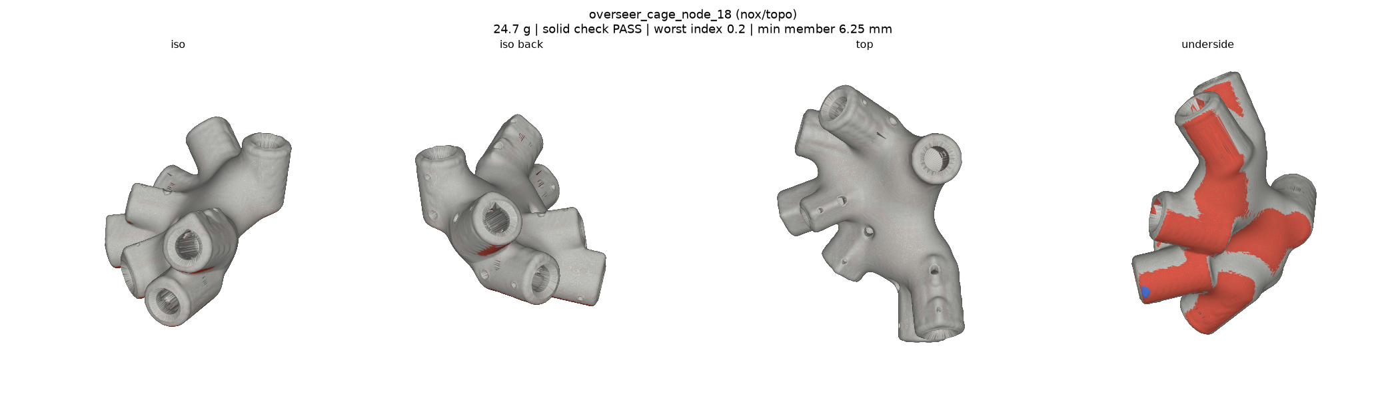
parts/overseer_cage_node_18/preview.png
