sparkiscool/noxen/parts/overseer_cage_node_21/preview.png

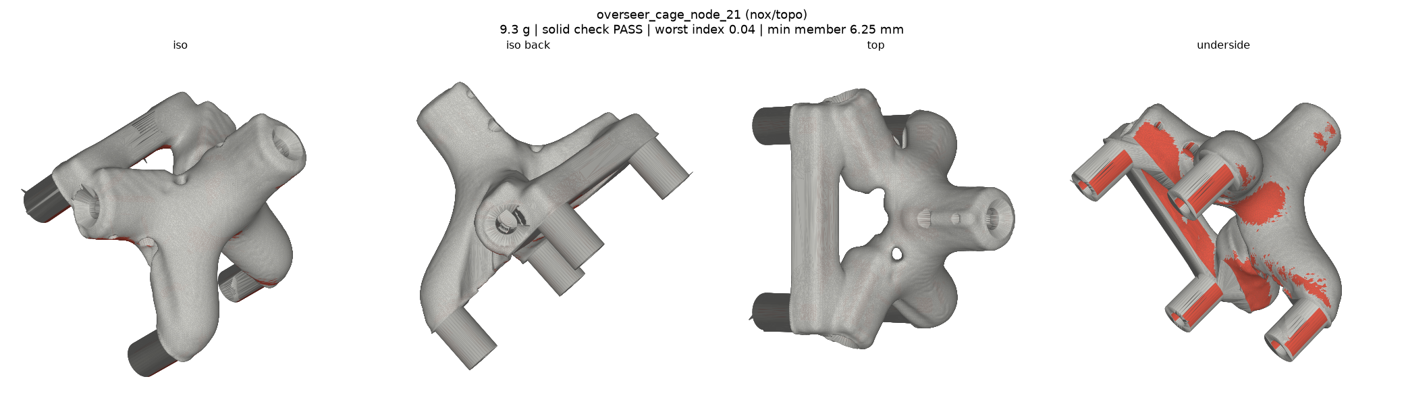
parts/overseer_cage_node_21/preview.png
