sparkiscool/noxen/parts/overseer_head_mount/preview.png

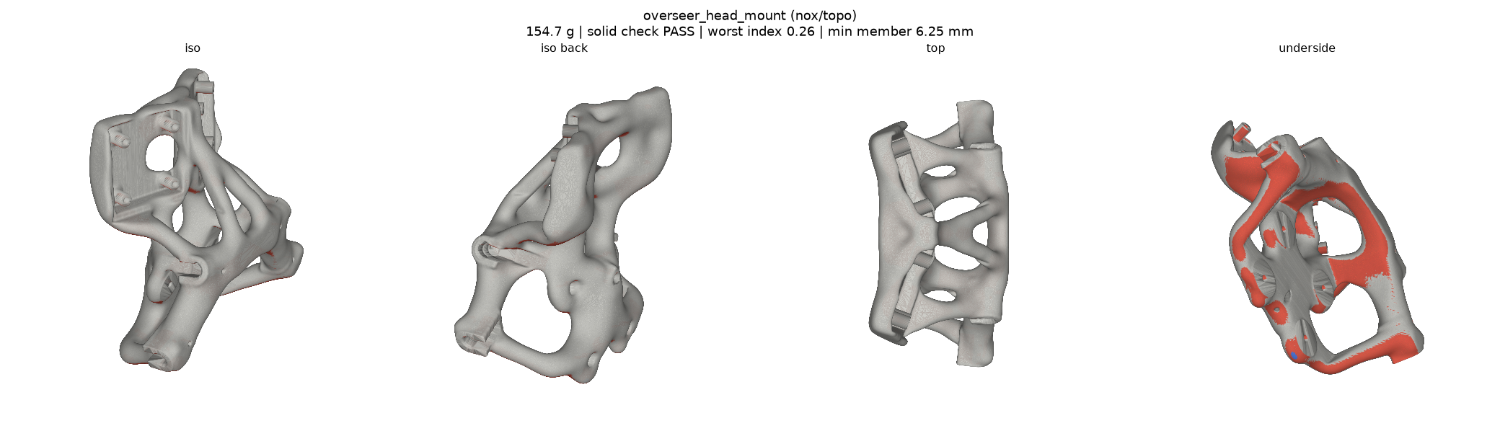
parts/overseer_head_mount/preview.png
