sparkiscool/noxen/parts/overseer_tpu_foot/preview.png

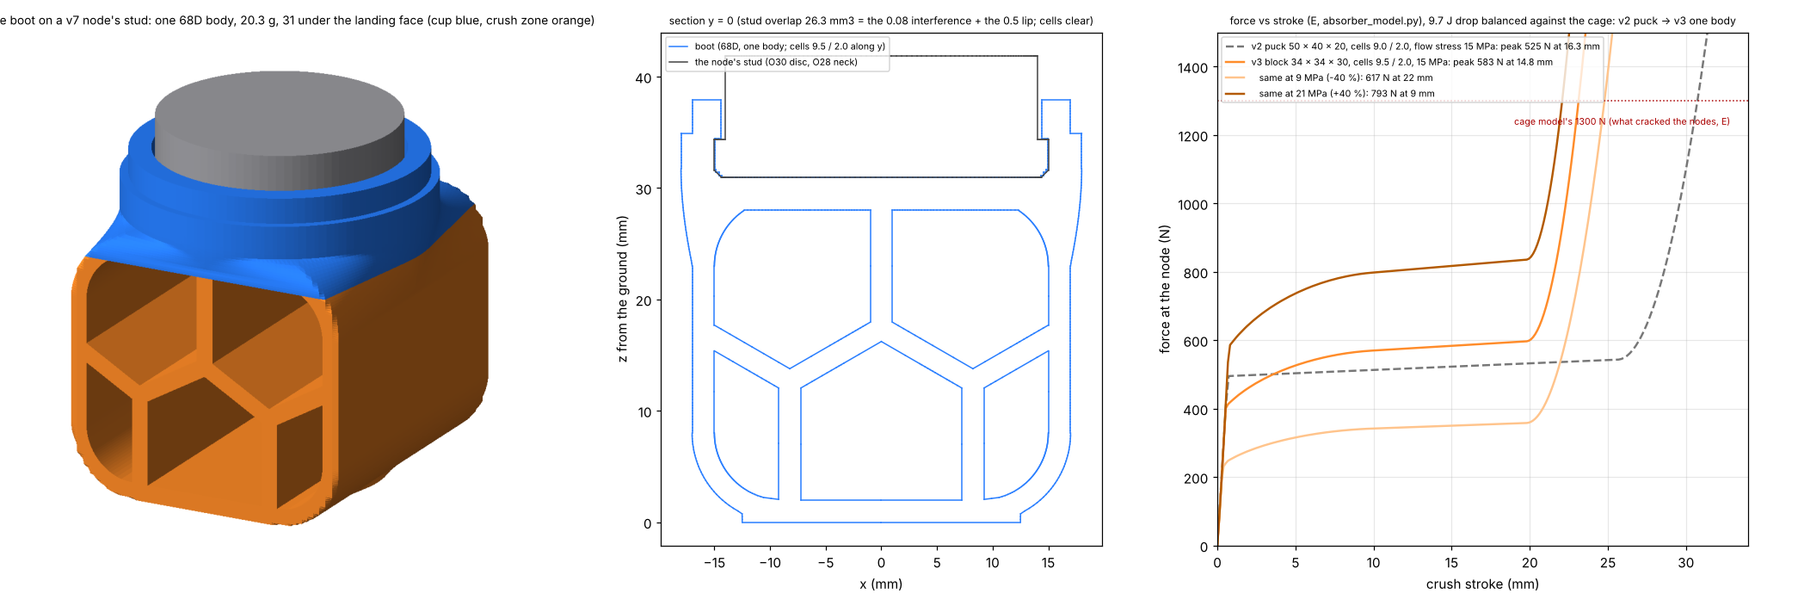
parts/overseer_tpu_foot/preview.png
