sparkiscool/noxen/parts/scout_arm_clip_3/preview.png

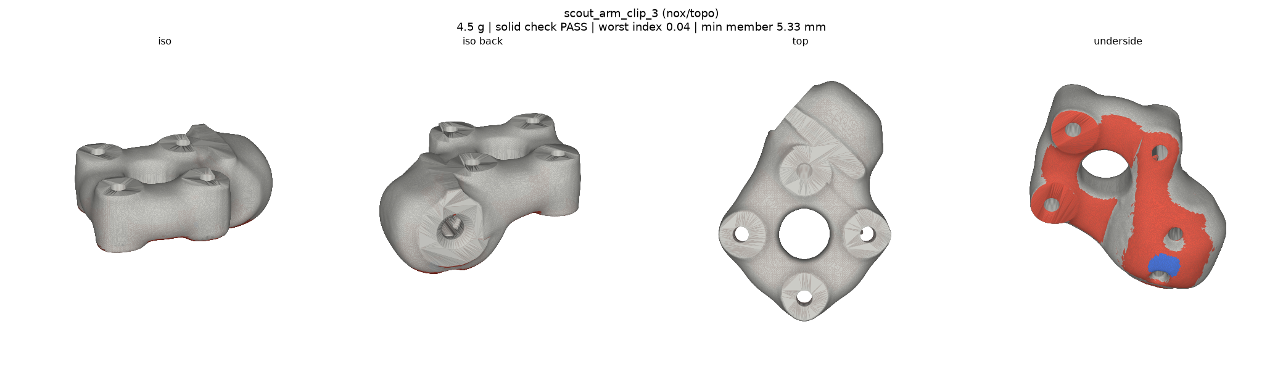
parts/scout_arm_clip_3/preview.png
