sparkiscool/noxen/parts/scout_cage_node_p0_r0/preview.png

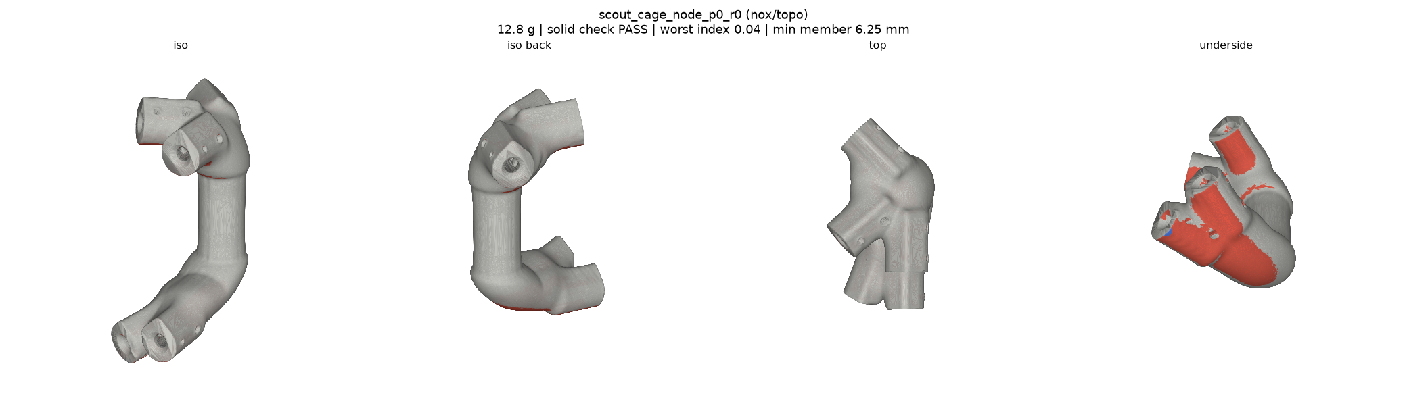
parts/scout_cage_node_p0_r0/preview.png
