sparkiscool/noxen/parts/scout_cage_node_p2/preview.png

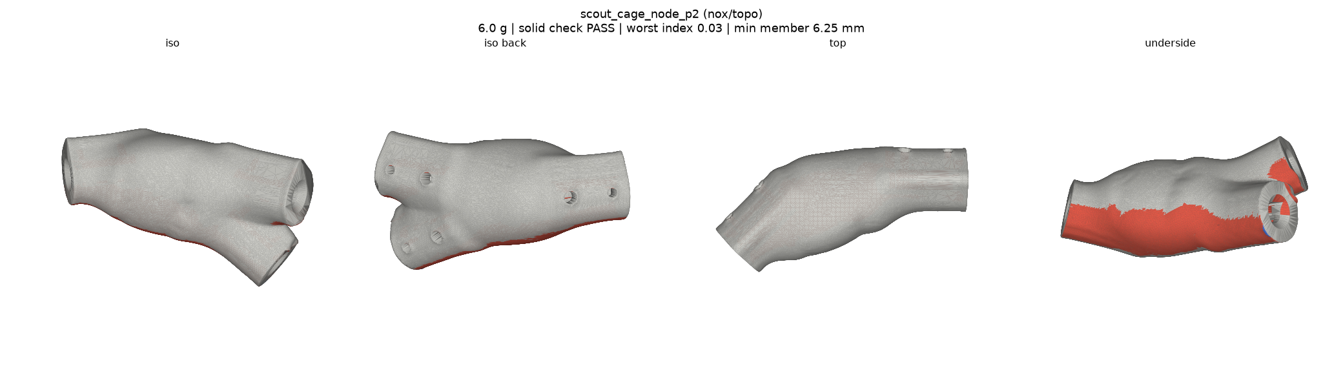
parts/scout_cage_node_p2/preview.png
