sparkiscool/noxen/parts/scout_cage_node_p3/preview.png

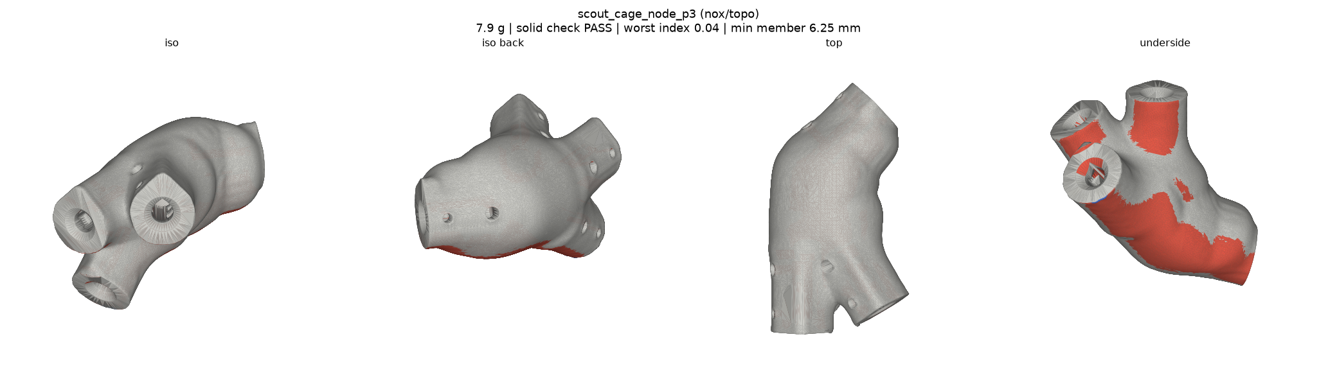
parts/scout_cage_node_p3/preview.png
