sparkiscool/noxen/parts/scout_cage_node_p6/preview.png

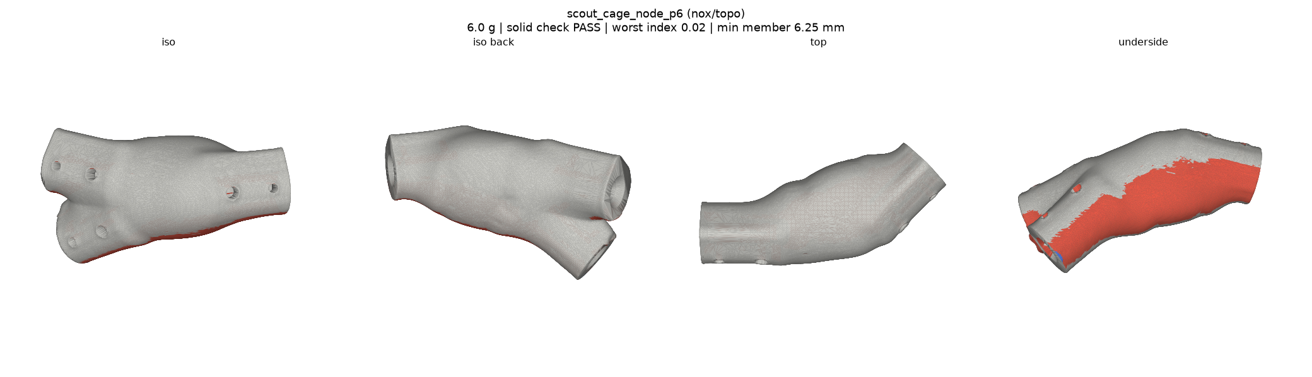
parts/scout_cage_node_p6/preview.png
