sparkiscool/noxen/parts/scout_cage_node_p7_r7/preview.png

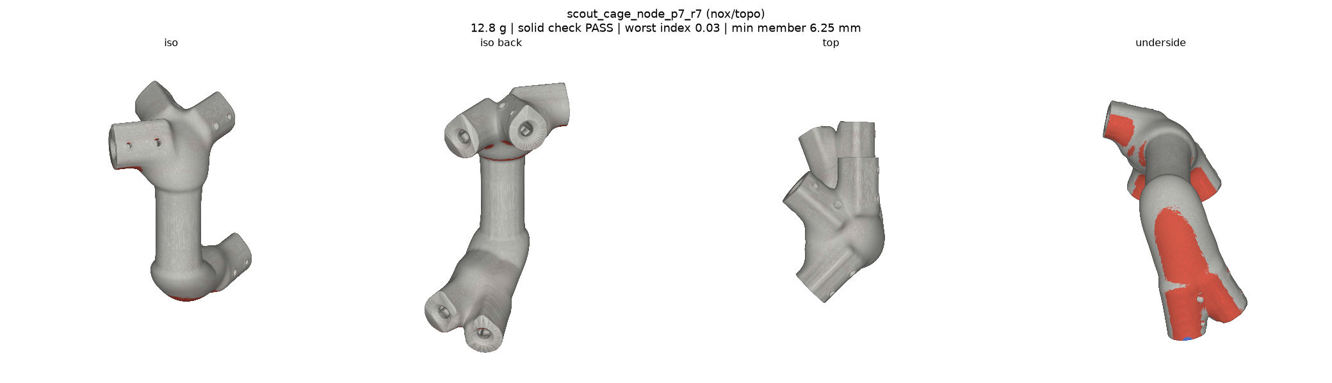
parts/scout_cage_node_p7_r7/preview.png
