sparkiscool/noxen/parts/scout_cage_node_pm0/preview.png

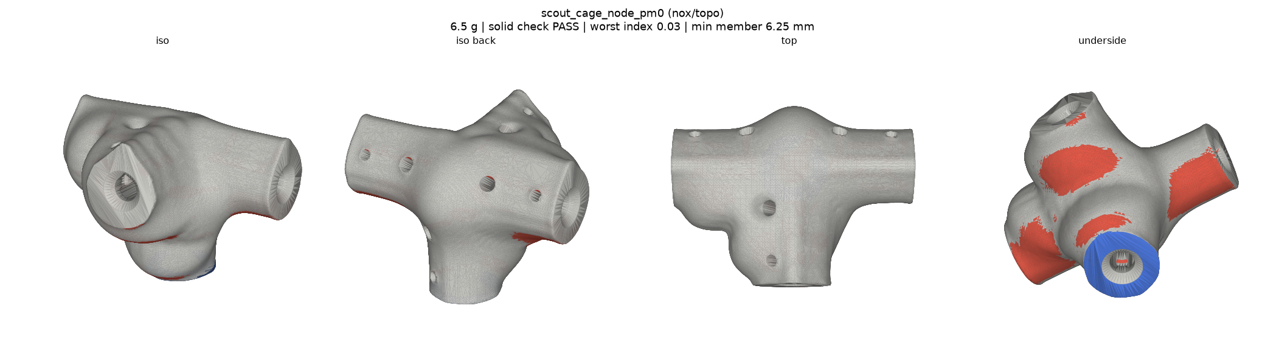
parts/scout_cage_node_pm0/preview.png
