sparkiscool/noxen/parts/scout_cage_node_rb/preview.png

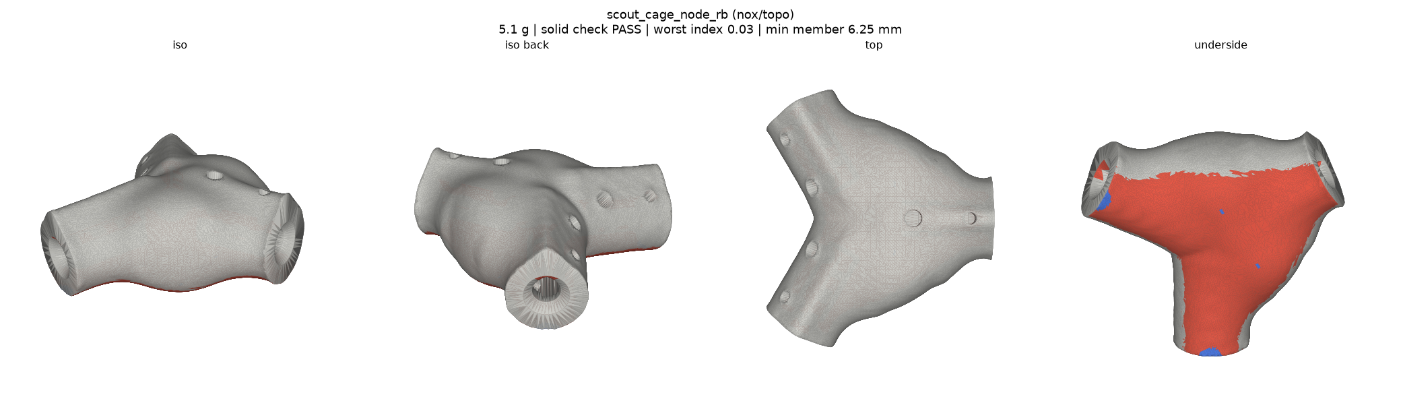
parts/scout_cage_node_rb/preview.png
