sparkiscool/noxen/parts/scout_cage_node_rf/preview.png

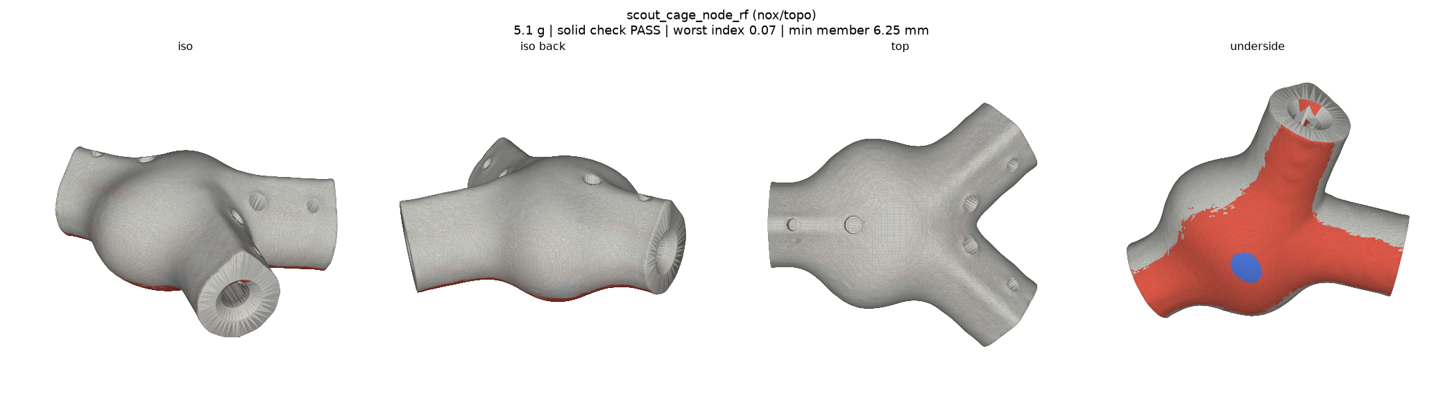
parts/scout_cage_node_rf/preview.png
