sparkiscool/noxen/parts/scout_cage_node_s0/preview.png

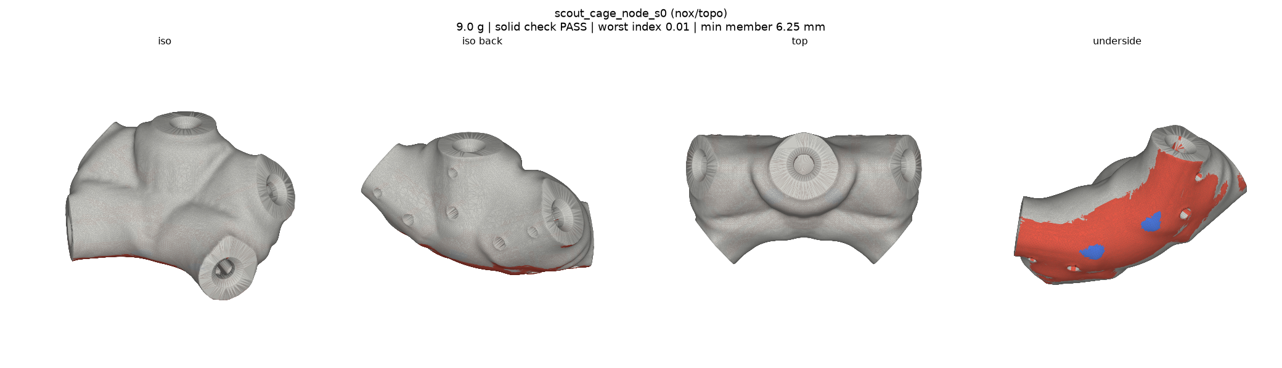
parts/scout_cage_node_s0/preview.png
