sparkiscool/noxen/parts/scout_cage_node_s1/preview.png

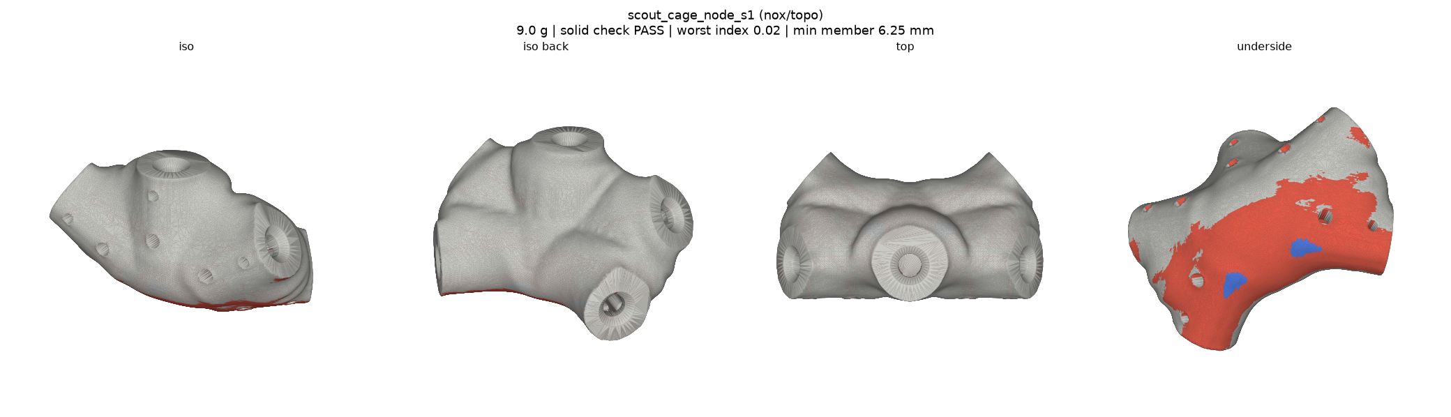
parts/scout_cage_node_s1/preview.png
