sparkiscool/noxen/parts/scout_nose_unit/preview.png

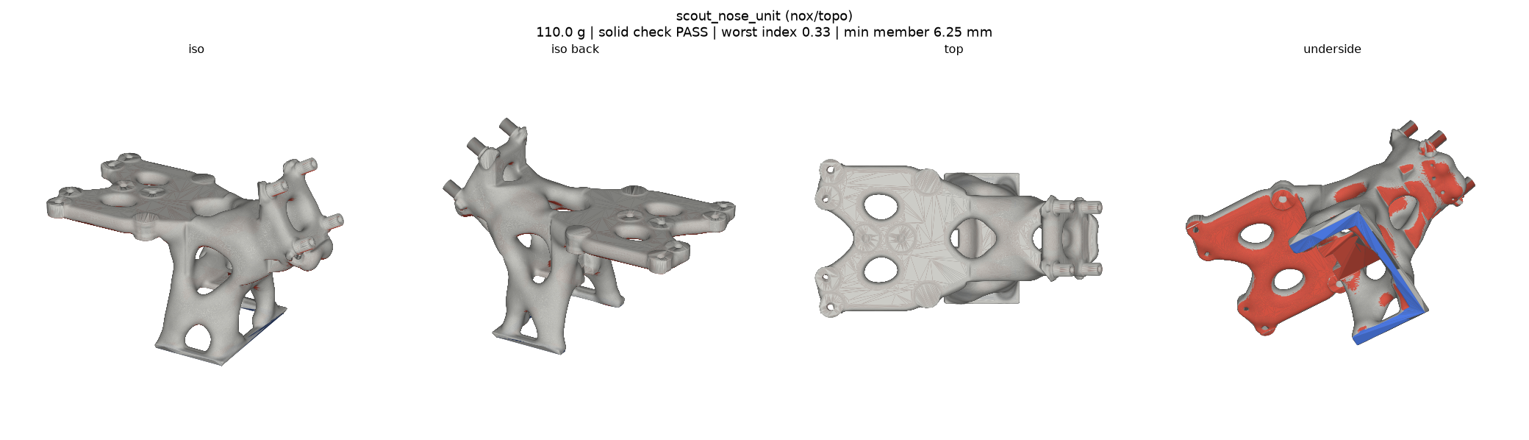
parts/scout_nose_unit/preview.png
