sparkiscool/noxen/parts/scout_tail_unit/preview.png

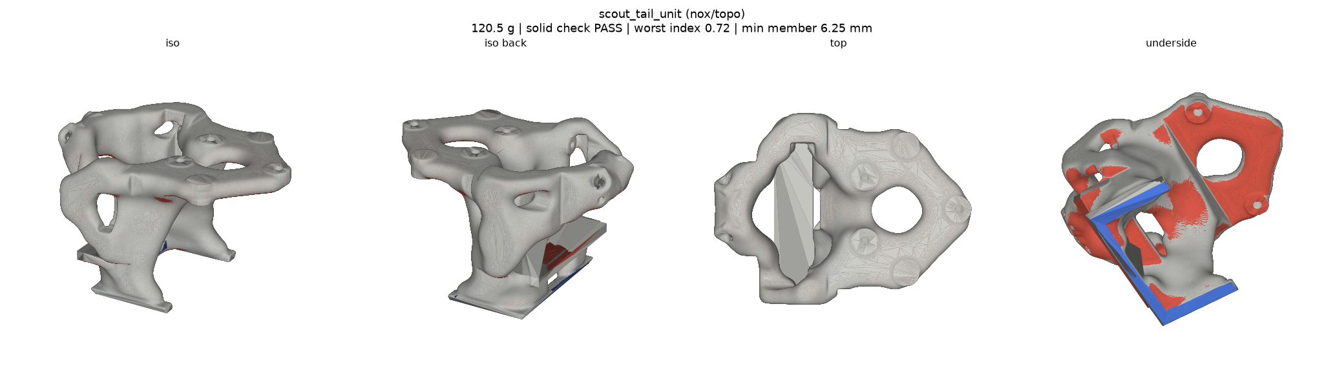
parts/scout_tail_unit/preview.png
