sparkiscool/noxen/parts/scout_v4_arm_coupon/preview.png

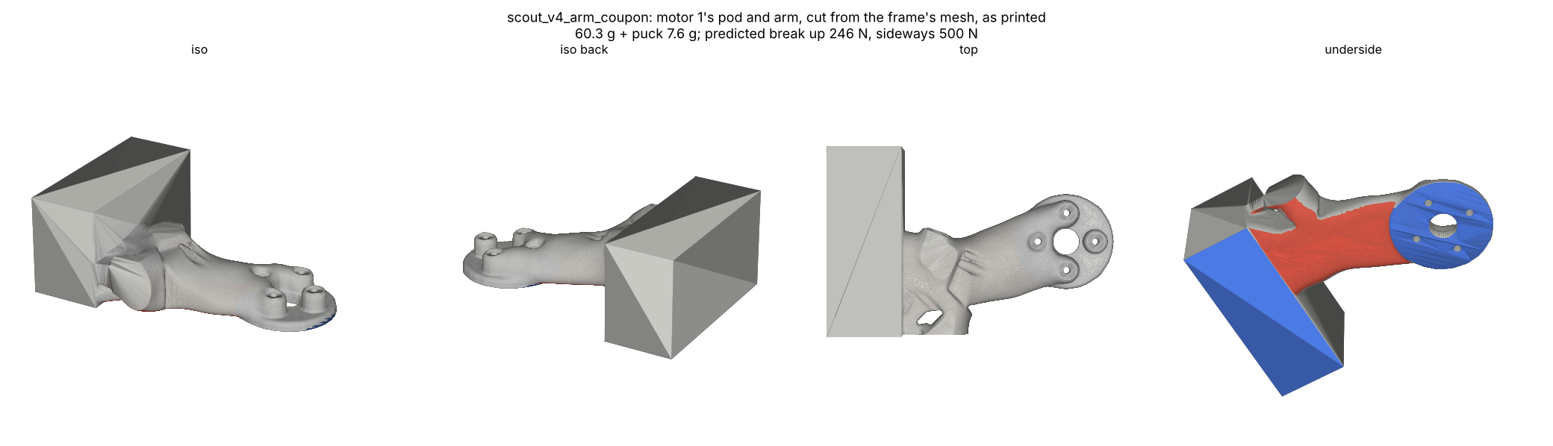
parts/scout_v4_arm_coupon/preview.png
