sparkiscool/noxen/parts/scout_v4_cradle/preview.png

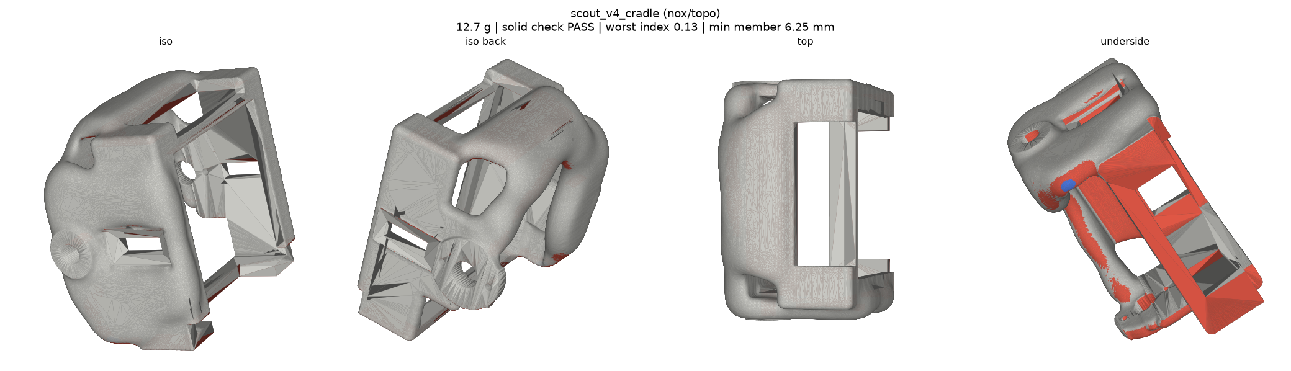
parts/scout_v4_cradle/preview.png
