sparkiscool/noxen/parts/scout_v4_frame/preview.png

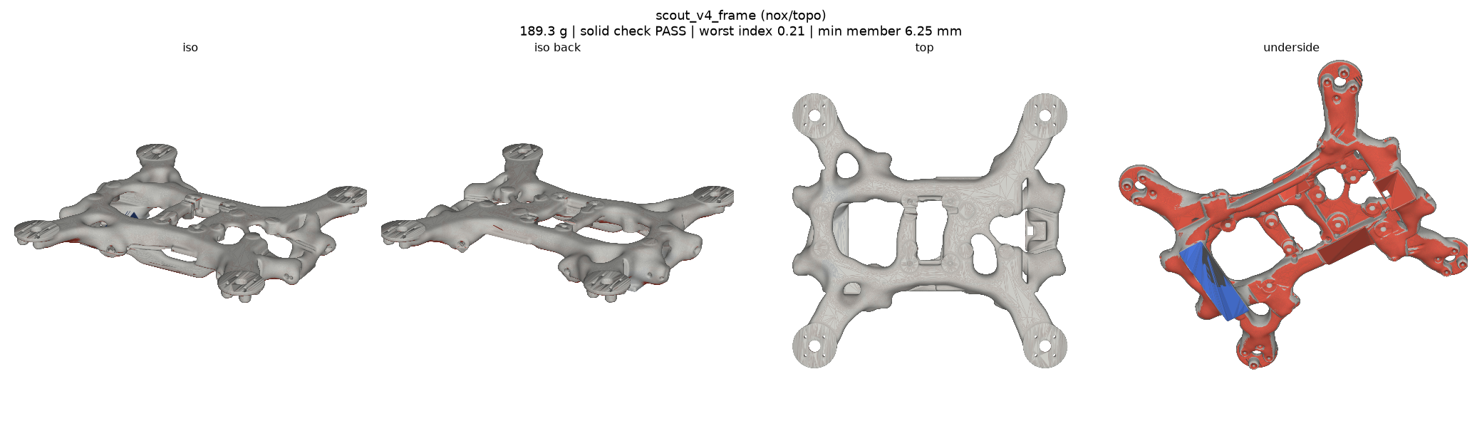
parts/scout_v4_frame/preview.png
