sparkiscool/noxen/parts/scout_v4_head_frame/preview.png

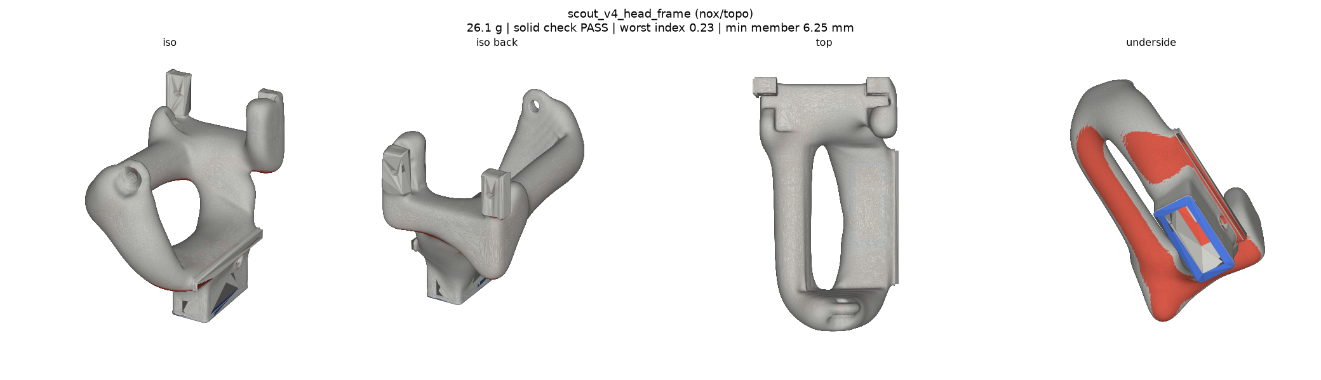
parts/scout_v4_head_frame/preview.png
