sparkiscool/noxen/parts/scout_v4_node_p1/preview.png

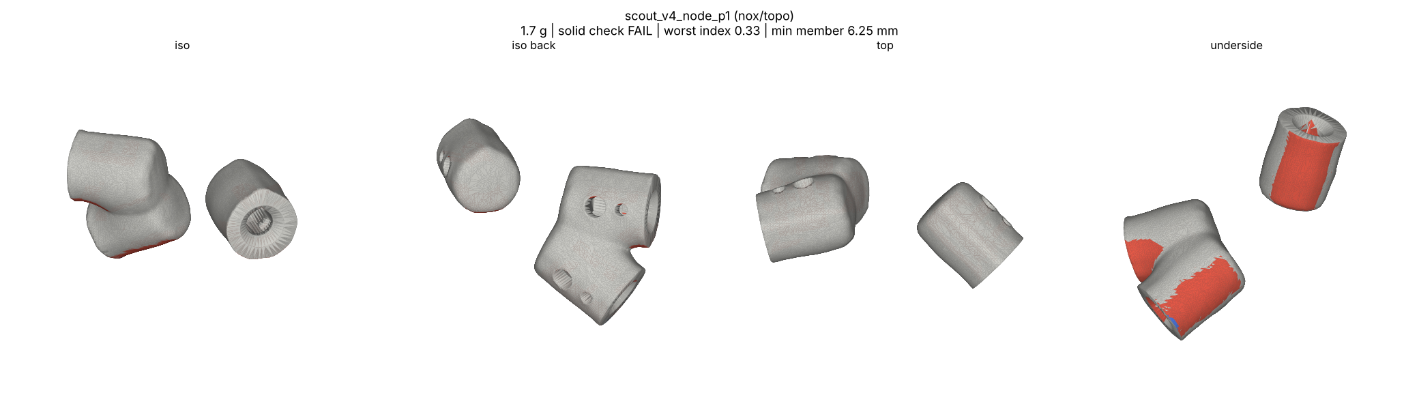
parts/scout_v4_node_p1/preview.png
