sparkiscool/noxen/parts/scout_v4_node_p2/preview.png

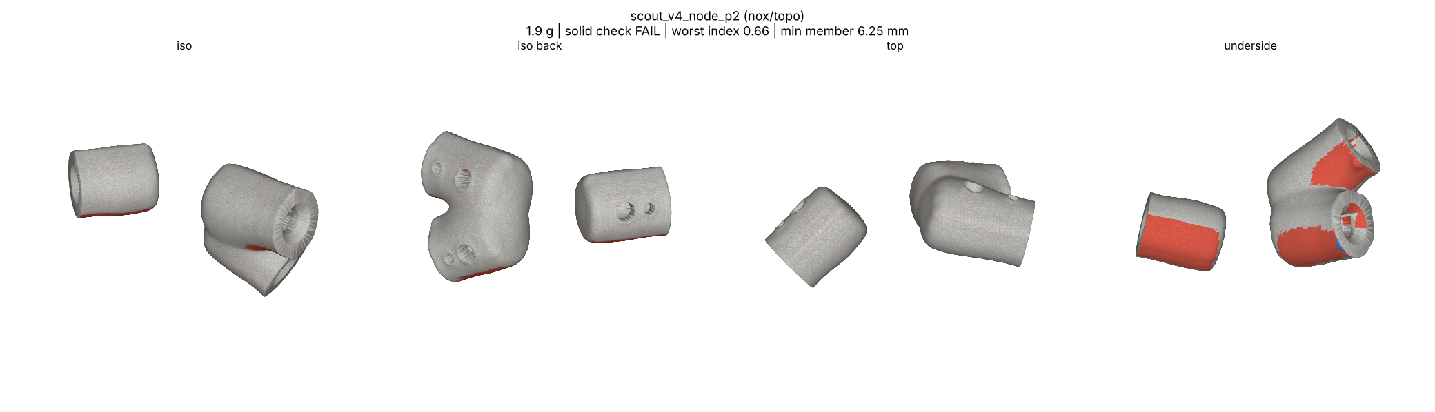
parts/scout_v4_node_p2/preview.png
