sparkiscool/noxen/parts/scout_v4_node_p6/preview.png

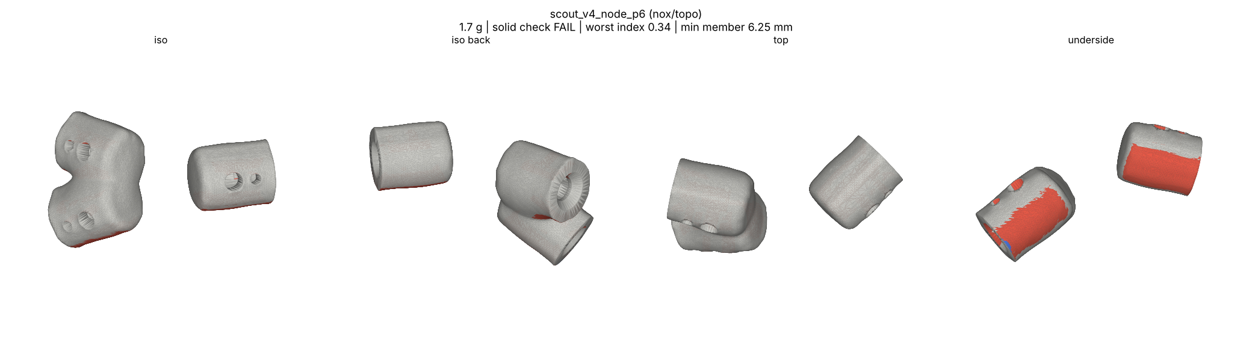
parts/scout_v4_node_p6/preview.png
