sparkiscool/noxen/parts/scout_v4_node_r0/preview.png

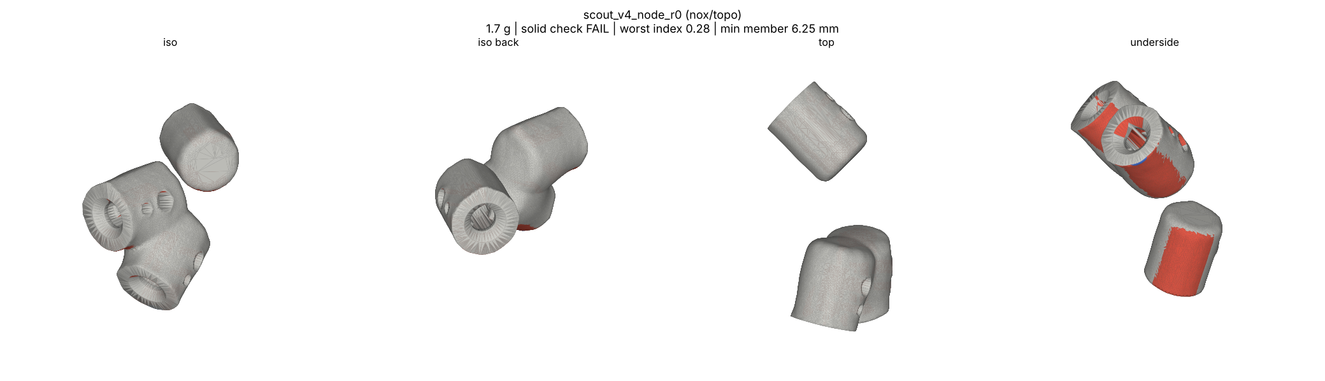
parts/scout_v4_node_r0/preview.png
