sparkiscool/noxen/parts/scout_v4_node_r7/preview.png

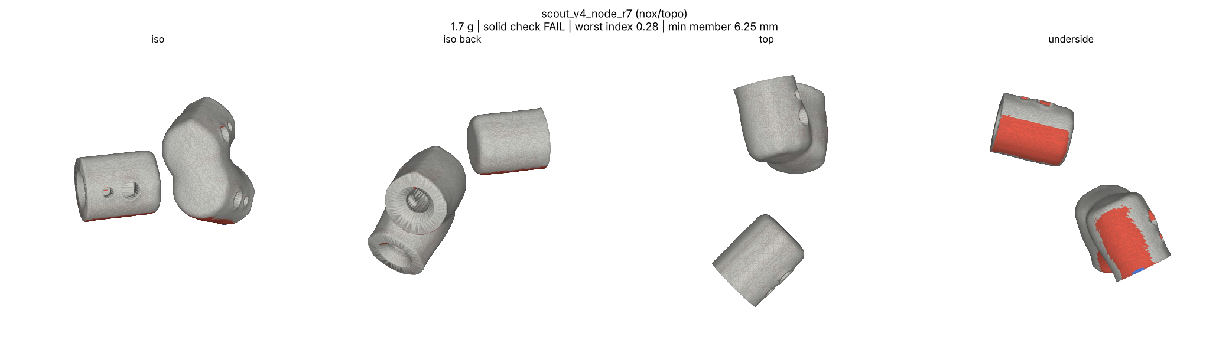
parts/scout_v4_node_r7/preview.png
