sparkiscool/noxen/parts/scout_v4_node_rs1/preview.png

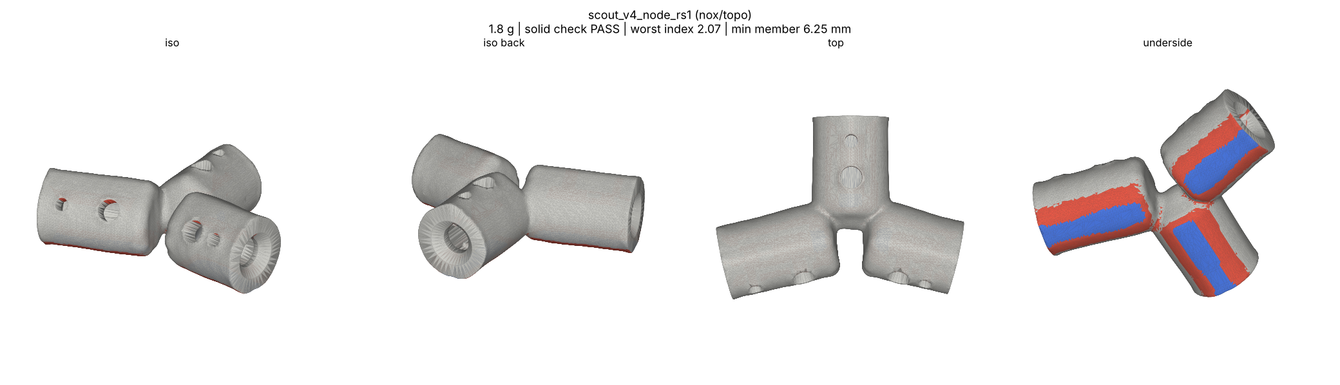
parts/scout_v4_node_rs1/preview.png
