sparkiscool/noxen/parts/scout_v4_node_s1/preview.png

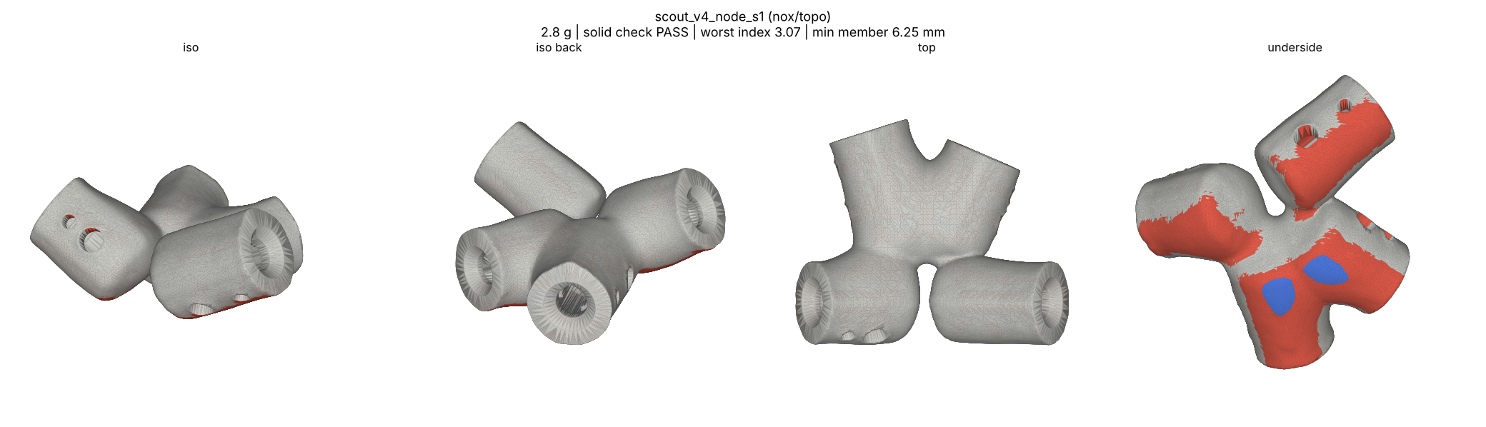
parts/scout_v4_node_s1/preview.png
