sparkiscool/noxen/parts/scout_v4_node_tb/preview.png

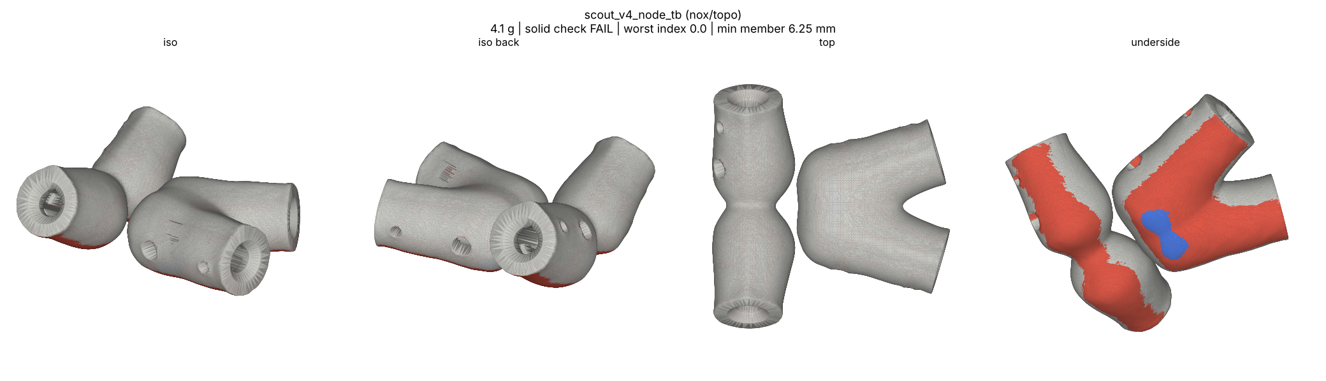
parts/scout_v4_node_tb/preview.png
