sparkiscool/noxen/parts/scout_v4_probe_turret/preview.png

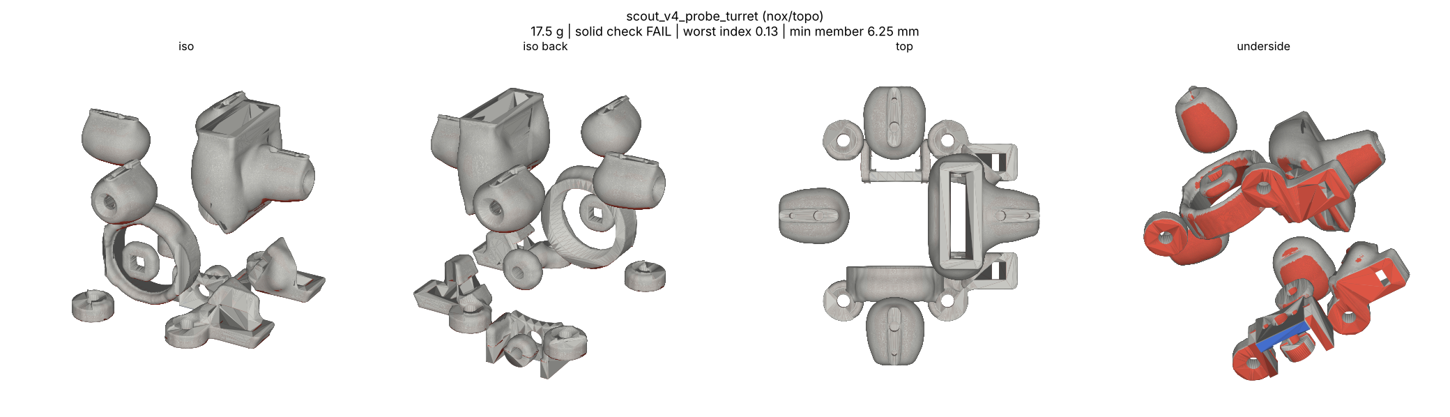
parts/scout_v4_probe_turret/preview.png
