sparkiscool/noxen/parts/arm_1/part.stl

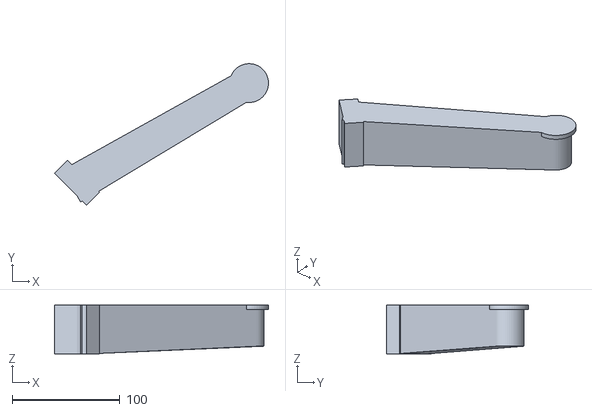
[picture p86: CAD file, 2026-10-28]
parts/arm_1/part.stl
198.4 x 131.3 x 45.0
