sparkiscool/noxen/parts/arm_2/part.stl

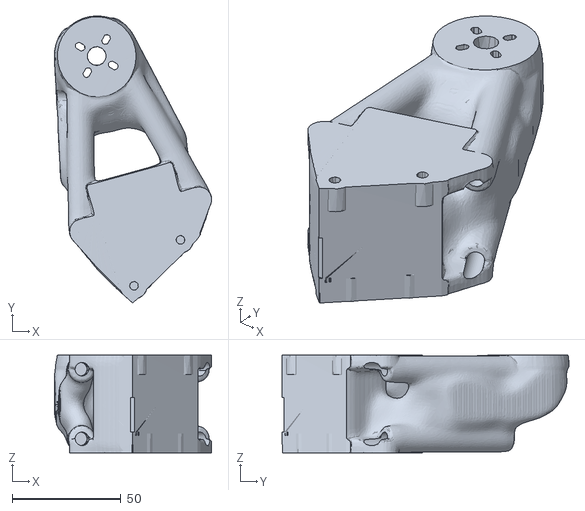
[picture p87: CAD file, 2026-10-28]
parts/arm_2/part.stl
72.3 x 131.9 x 45.0
