sparkiscool/noxen/parts/bottom_plate/part.stl

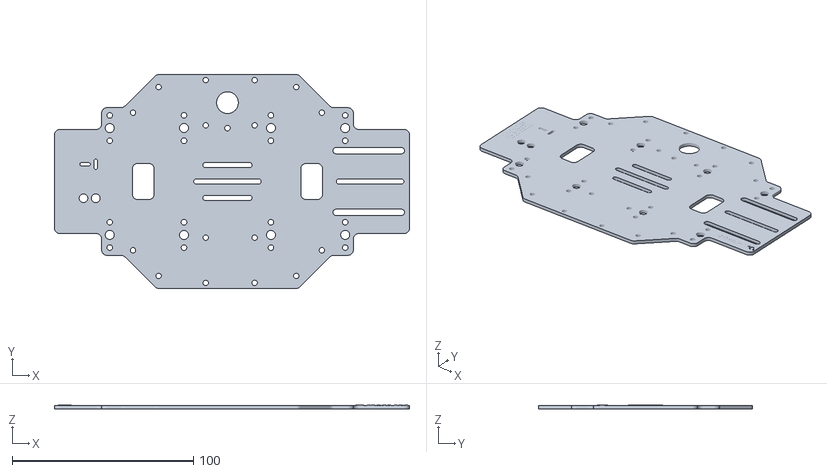
[picture p88: CAD file, 2026-10-28]
parts/bottom_plate/part.stl
196.0 x 118.0 x 2.10
