sparkiscool/noxen/parts/box_arm8/view/box_arm8_bay_m180_recv.stl

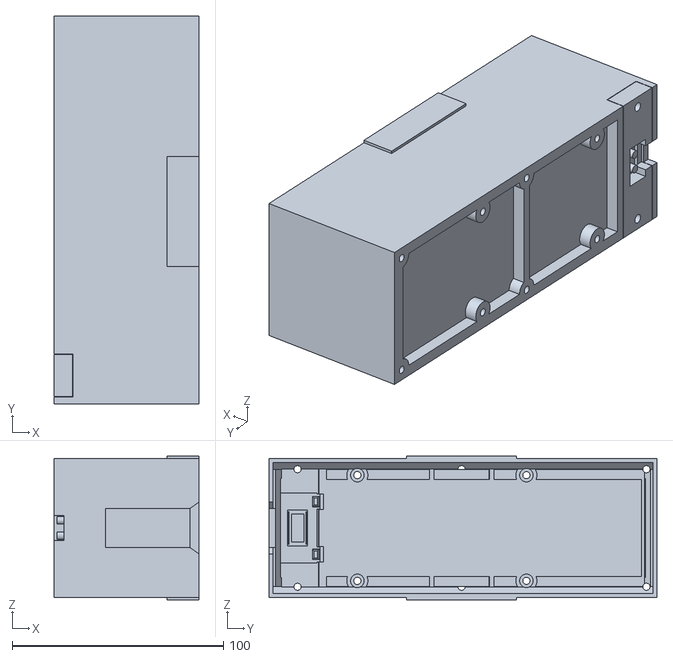
[picture p89: CAD file, 2026-11-14]
parts/box_arm8/view/box_arm8_bay_m180_recv.stl
68.6 x 183.6 x 68.0
