sparkiscool/noxen/parts/box_arm8_blade/part.stl

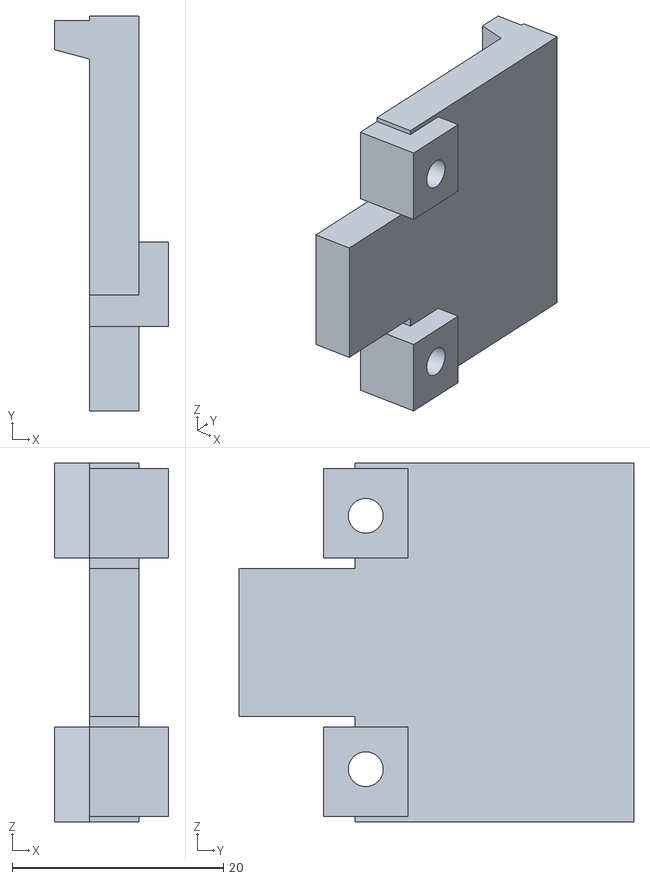
[picture p90: CAD file, 2026-11-13]
parts/box_arm8_blade/part.stl
10.8 x 37.4 x 34.0
