sparkiscool/noxen/parts/box_arm8_carriage/part.stl

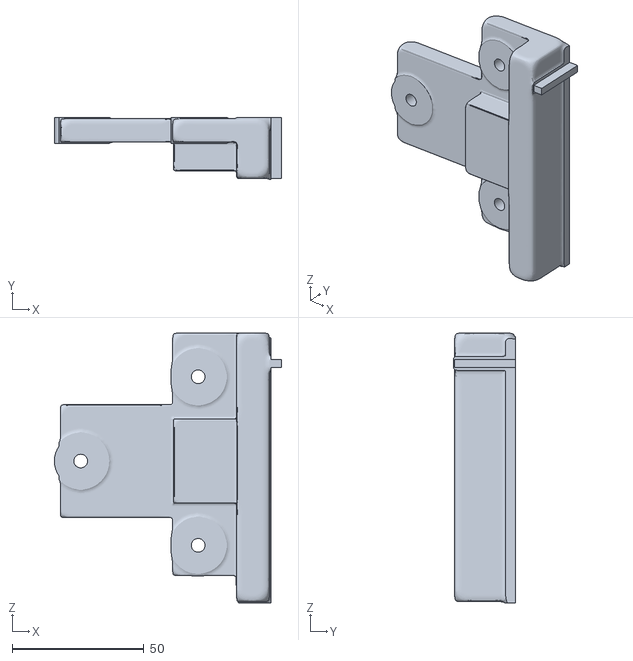
[picture p91: CAD file, 2026-11-14]
parts/box_arm8_carriage/part.stl
86.3 x 23.6 x 102.5
