sparkiscool/noxen/parts/box_arm8_detent_arm/part.stl

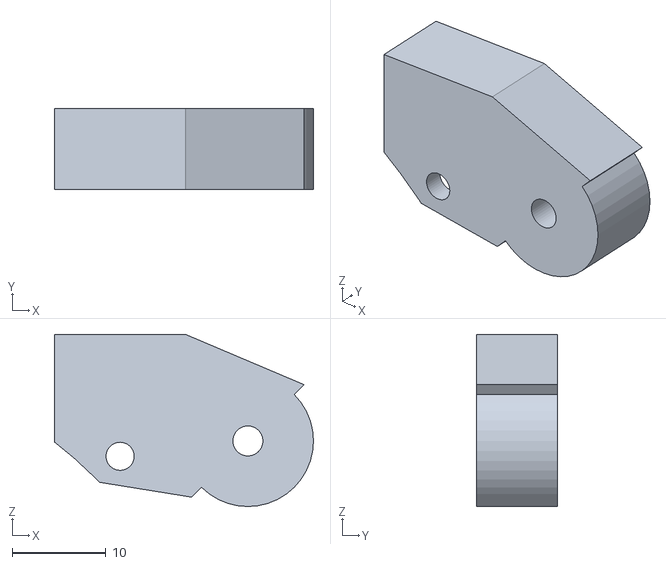
[picture p92: CAD file, 2026-11-13]
parts/box_arm8_detent_arm/part.stl
27.6 x 8.60 x 18.4
