sparkiscool/noxen/parts/box_arm8_hub/part.stl

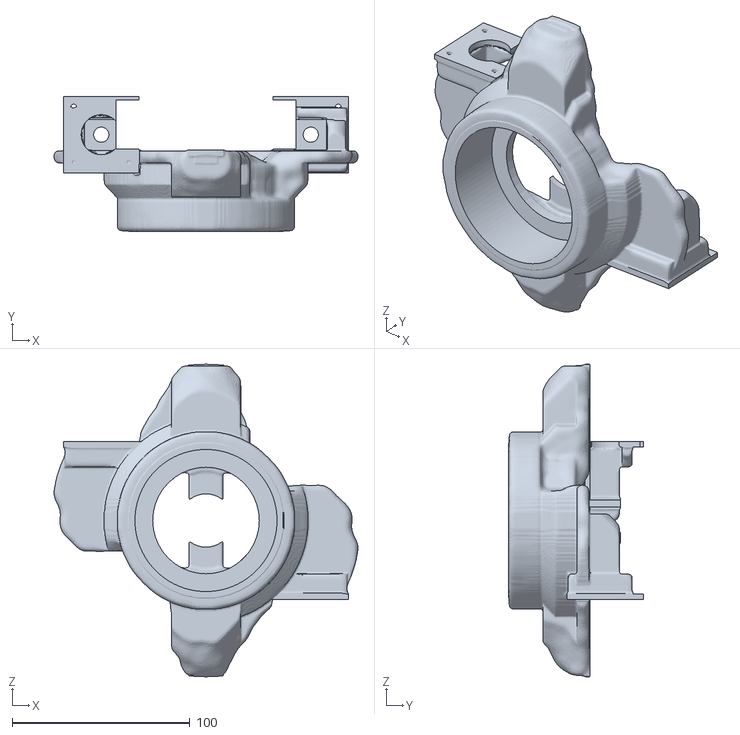
[picture p93: CAD file, 2026-11-14]
parts/box_arm8_hub/part.stl
171.2 x 76.0 x 176.0
