sparkiscool/noxen/parts/box_arm8_lift/part.stl

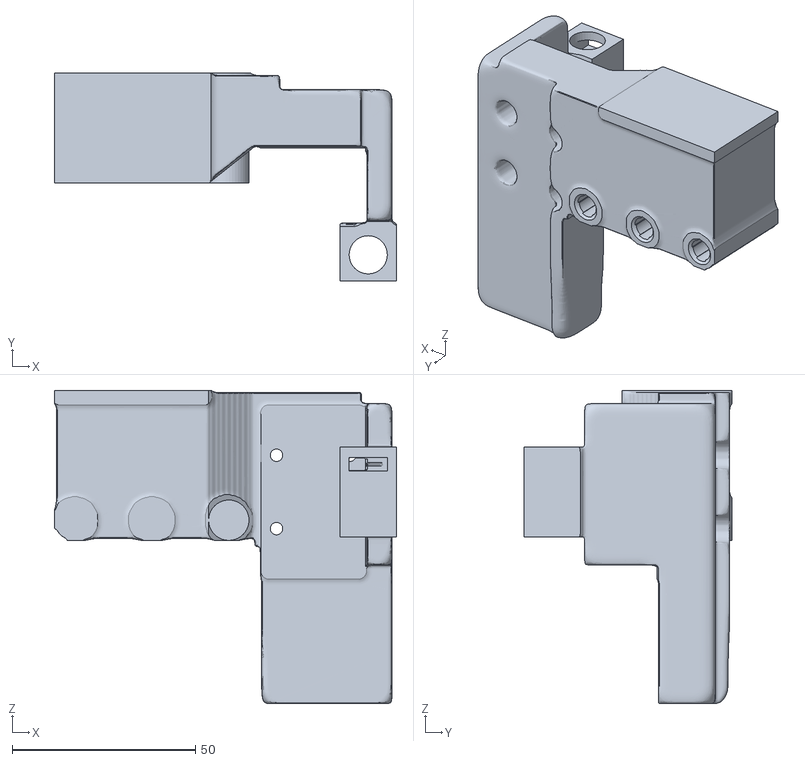
[picture p94: CAD file, 2026-11-14]
parts/box_arm8_lift/part.stl
93.2 x 56.6 x 85.4
