sparkiscool/noxen/parts/box_arm8_link/part.stl

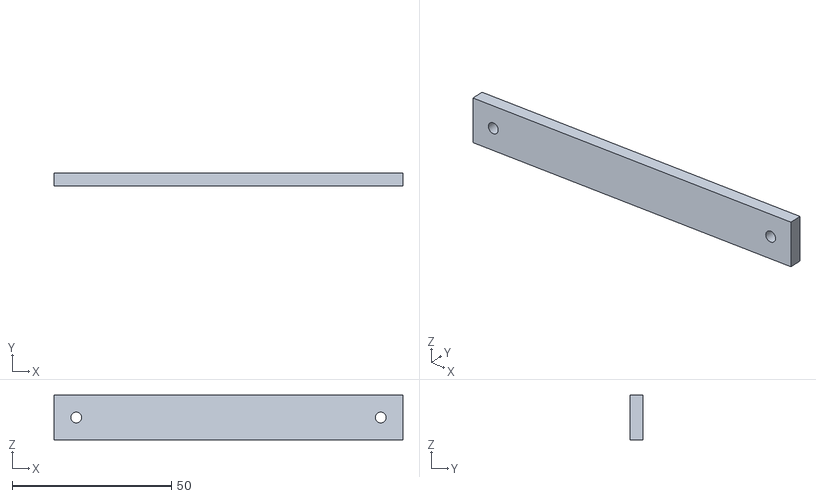
[picture p95: CAD file, 2026-11-13]
parts/box_arm8_link/part.stl
109.7 x 4.00 x 14.0
