sparkiscool/noxen/parts/box_arm8_paddle/part.stl

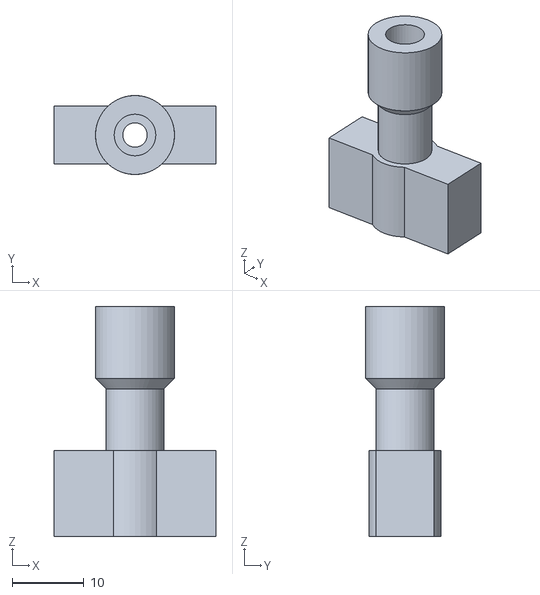
[picture p96: CAD file, 2026-11-14]
parts/box_arm8_paddle/part.stl
22.5 x 11.0 x 32.0
