sparkiscool/noxen/parts/box_arm8_pads/part.stl

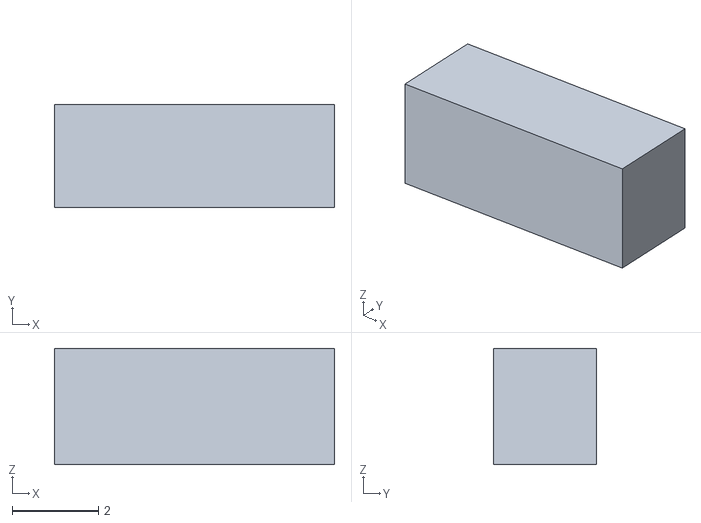
[picture p97: CAD file, 2026-11-14]
parts/box_arm8_pads/part.stl
6.50 x 2.40 x 2.70
