sparkiscool/noxen/parts/box_arm8_pilot/part.stl

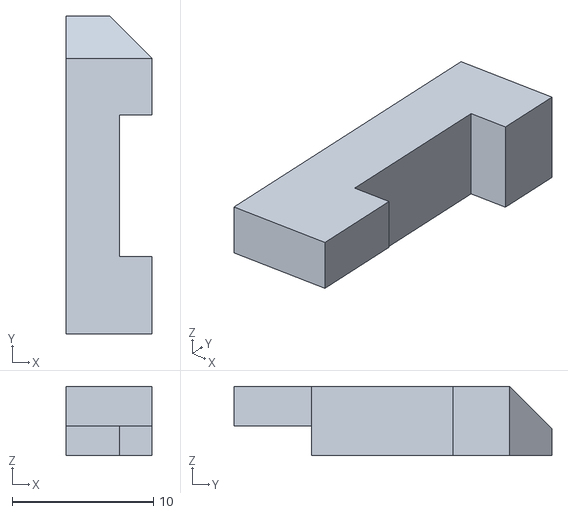
[picture p98: CAD file, 2026-11-14]
parts/box_arm8_pilot/part.stl
6.10 x 22.5 x 4.90
