sparkiscool/noxen/parts/box_arm8_post/part.stl

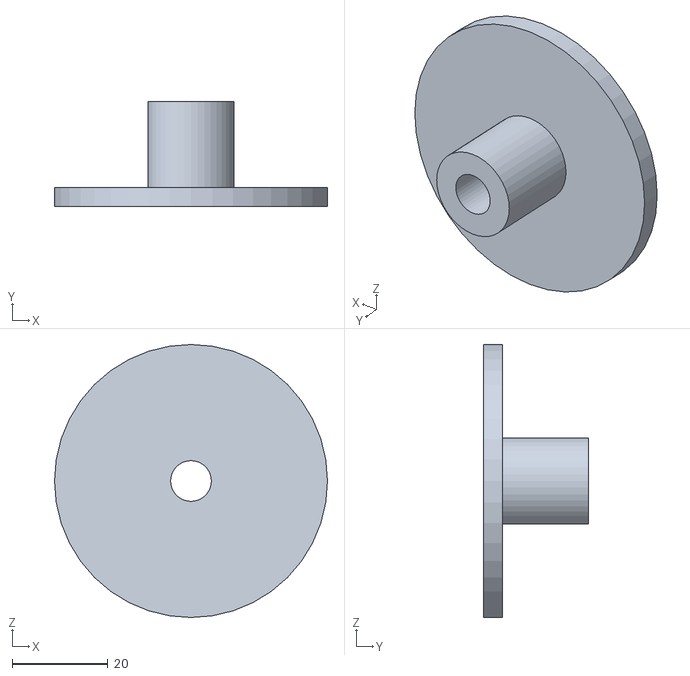
[picture p99: CAD file, 2026-11-13]
parts/box_arm8_post/part.stl
57.0 x 22.0 x 57.0
