sparkiscool/noxen/parts/box_arm8_rail/part.stl

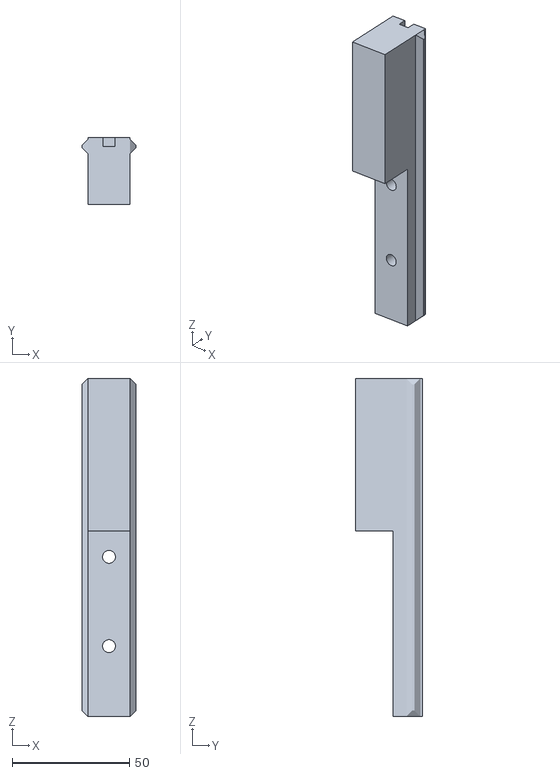
[picture p100: CAD file, 2026-11-13]
parts/box_arm8_rail/part.stl
23.0 x 28.8 x 144.0
