sparkiscool/noxen/parts/box_arm8_saddle_overseer/part.stl

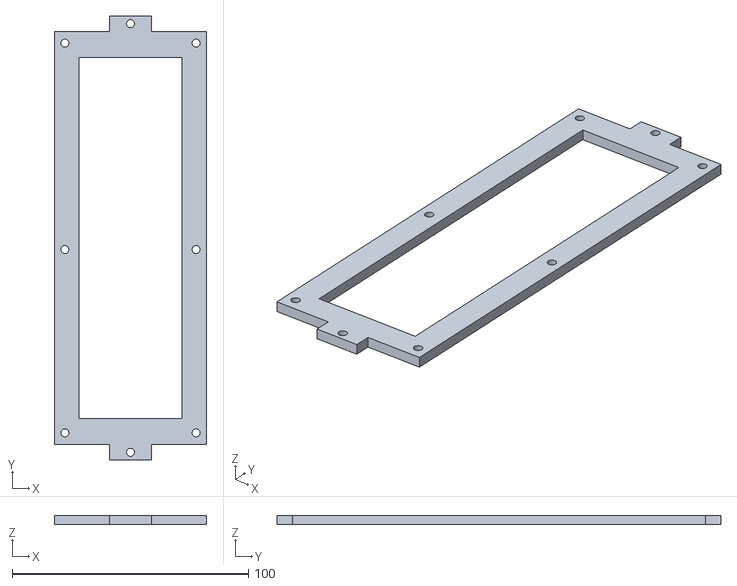
[picture p101: CAD file, 2026-11-14]
parts/box_arm8_saddle_overseer/part.stl
64.6 x 188.1 x 4.00
