sparkiscool/noxen/parts/box_arm8_saddle_scout/part.stl

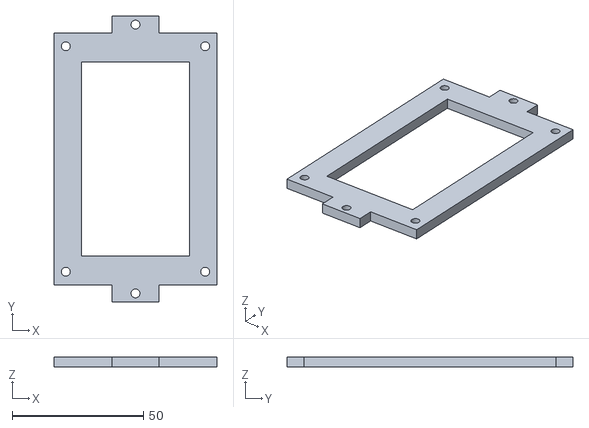
[picture p102: CAD file, 2026-11-13]
parts/box_arm8_saddle_scout/part.stl
62.1 x 108.9 x 4.00
