sparkiscool/noxen/parts/box_arm8_stub/part.stl

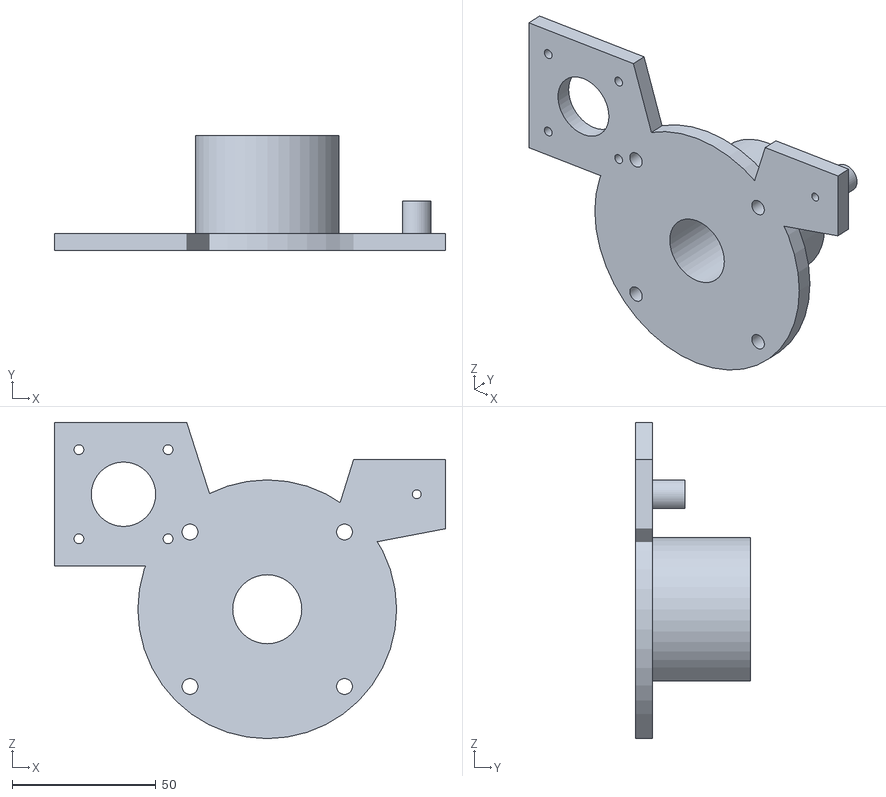
[picture p103: CAD file, 2026-11-13]
parts/box_arm8_stub/part.stl
136.0 x 40.0 x 110.0
