sparkiscool/noxen/parts/box_arm8_tie/part.stl

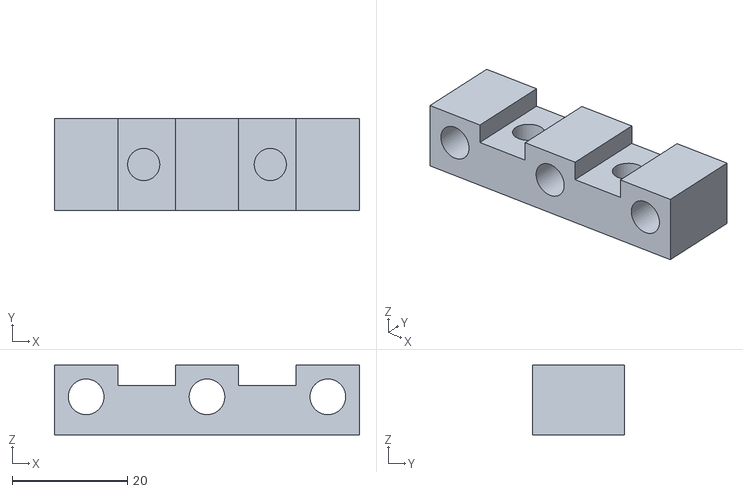
[picture p104: CAD file, 2026-11-13]
parts/box_arm8_tie/part.stl
53.0 x 16.0 x 12.1
