sparkiscool/noxen/parts/box_arm8_unit_body/part.stl

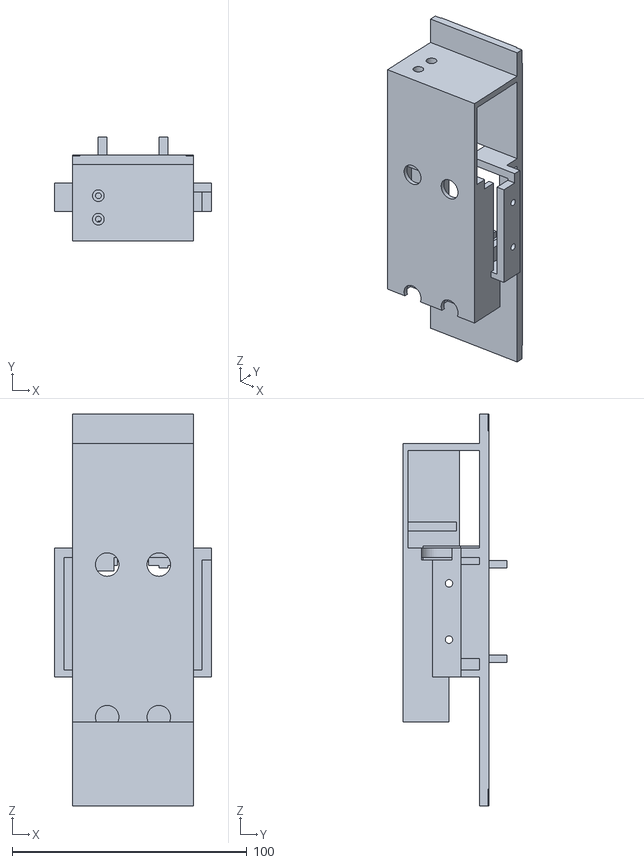
[picture p105: CAD file, 2026-11-14]
parts/box_arm8_unit_body/part.stl
67.0 x 44.1 x 167.0
