sparkiscool/noxen/parts/box_arm8_wheels/part.stl

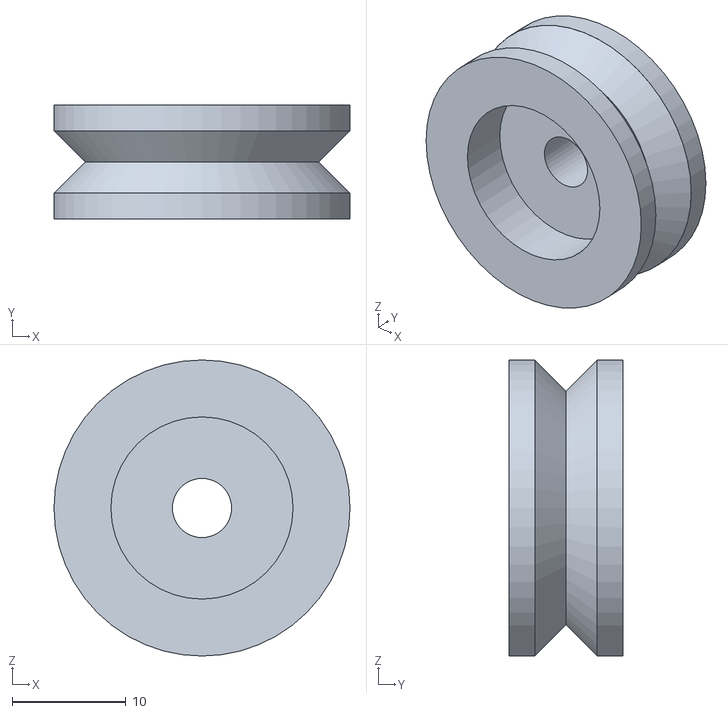
[picture p106: CAD file, 2026-11-13]
parts/box_arm8_wheels/part.stl
26.0 x 10.0 x 26.0
