sparkiscool/noxen/parts/box_arm_axlesa/part.stl

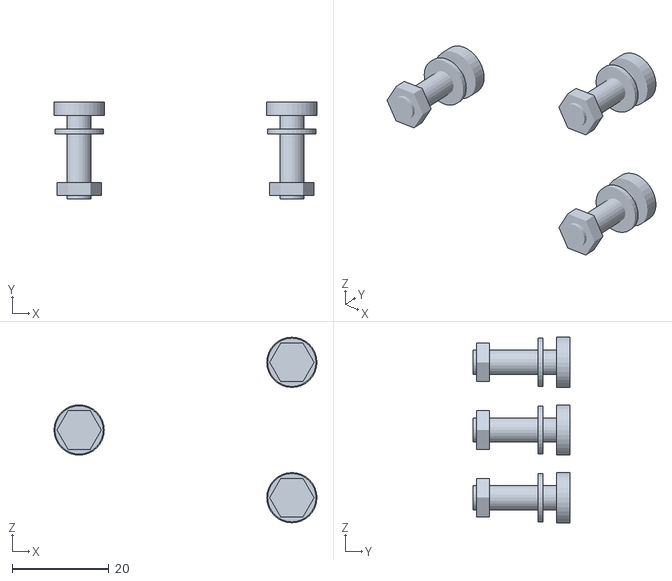
[picture p107: CAD file, 2026-11-03]
parts/box_arm_axlesa/part.stl
54.4 x 20.0 x 38.4
