sparkiscool/noxen/parts/box_arm_belt_axle/part.stl

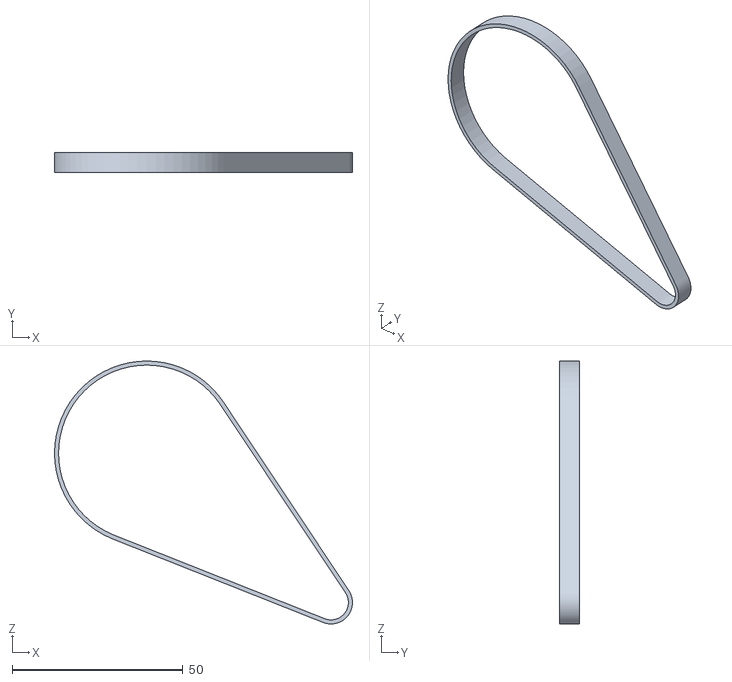
[picture p108: CAD file, 2026-11-03]
parts/box_arm_belt_axle/part.stl
87.2 x 6.00 x 77.0
