sparkiscool/noxen/parts/box_arm_brg0/part.stl

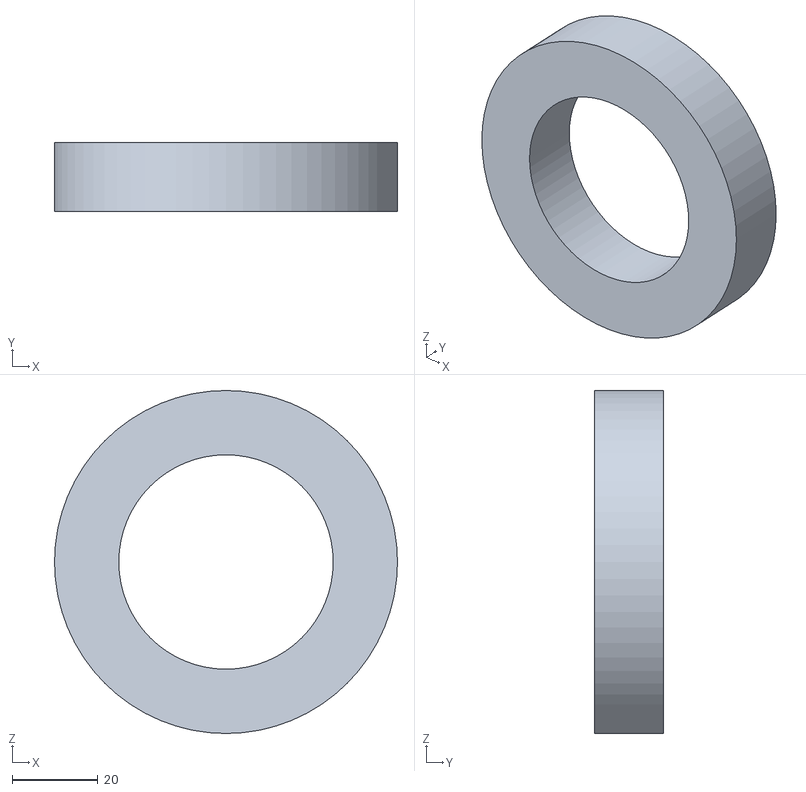
[picture p109: CAD file, 2026-11-03]
parts/box_arm_brg0/part.stl
80.0 x 16.0 x 80.0
