sparkiscool/noxen/parts/box_arm_busha/part.stl

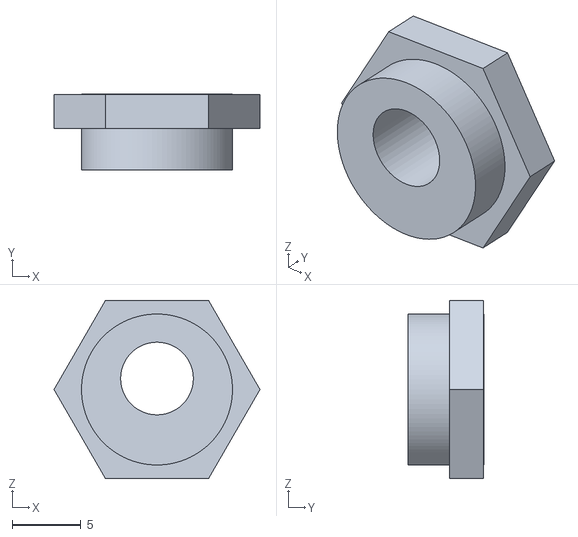
[picture p110: CAD file, 2026-11-03]
parts/box_arm_busha/part.stl
15.0 x 5.51 x 13.0
