sparkiscool/noxen/parts/box_arm_detent_arm/part.stl

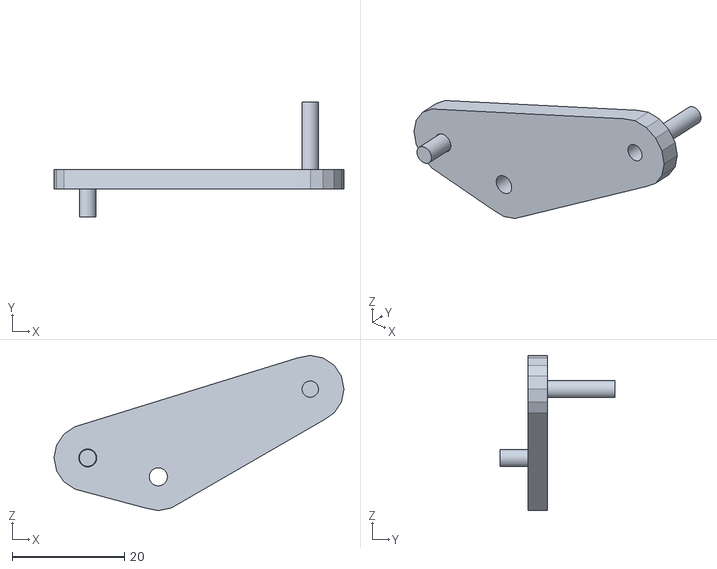
[picture p111: CAD file, 2026-11-03]
parts/box_arm_detent_arm/part.stl
51.6 x 20.5 x 27.6
