sparkiscool/noxen/parts/box_arm_detent_ring/part.stl

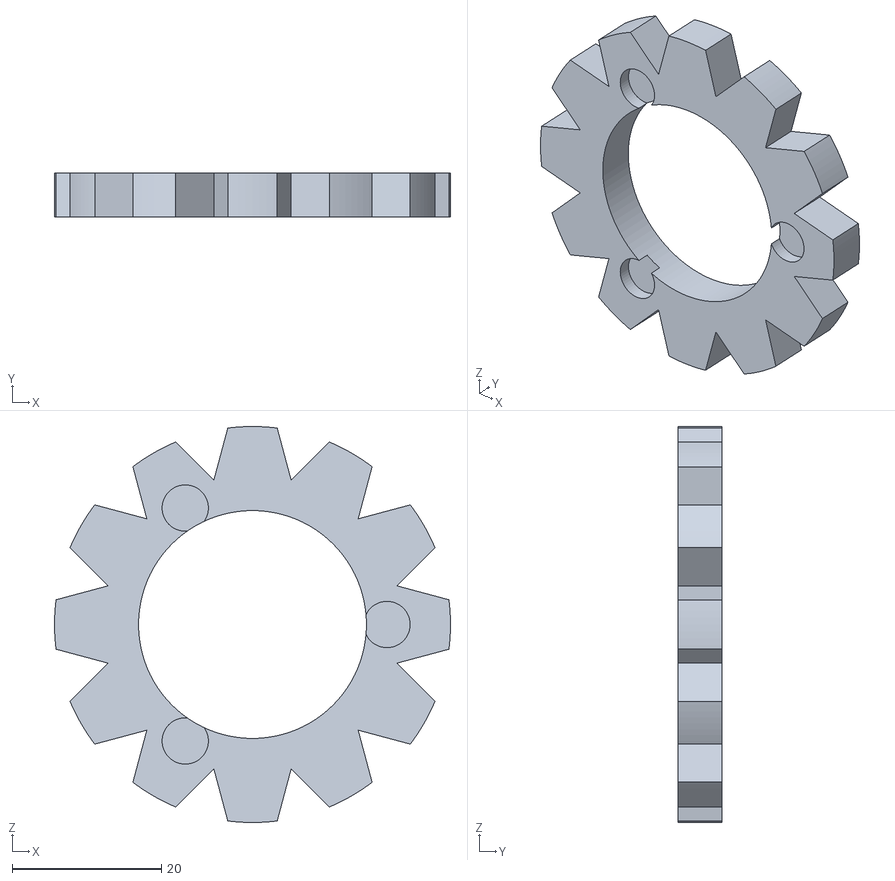
[picture p112: CAD file, 2026-11-03]
parts/box_arm_detent_ring/part.stl
53.0 x 5.90 x 53.0
