sparkiscool/noxen/parts/box_arm_detent_roller/part.stl

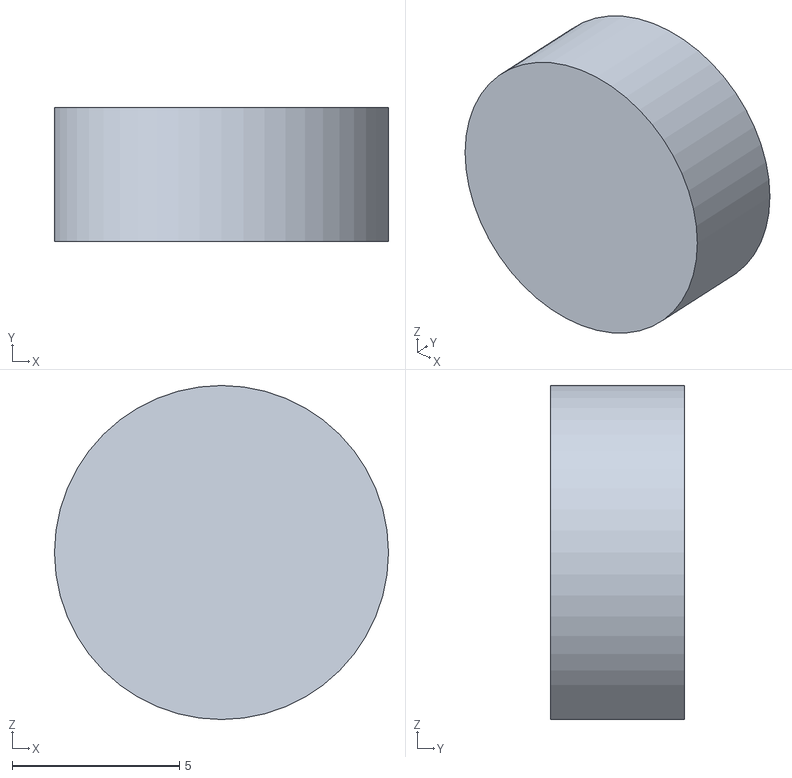
[picture p113: CAD file, 2026-11-03]
parts/box_arm_detent_roller/part.stl
10.00 x 4.00 x 10.0
