sparkiscool/noxen/parts/box_arm_detent_springs/part.stl

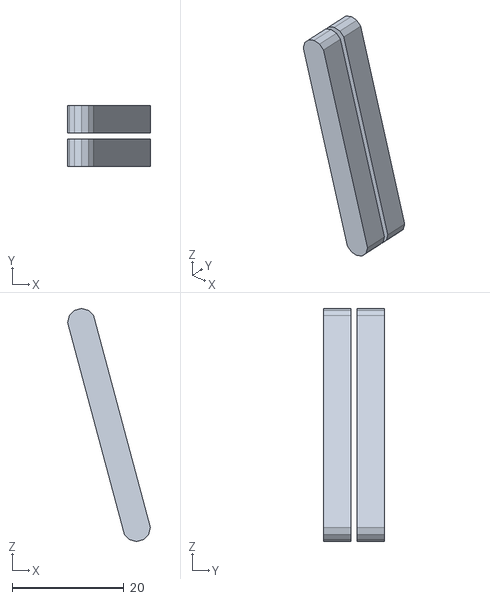
[picture p114: CAD file, 2026-11-03]
parts/box_arm_detent_springs/part.stl
14.8 x 11.0 x 41.7
