sparkiscool/noxen/parts/box_arm_detent_tower/part.stl

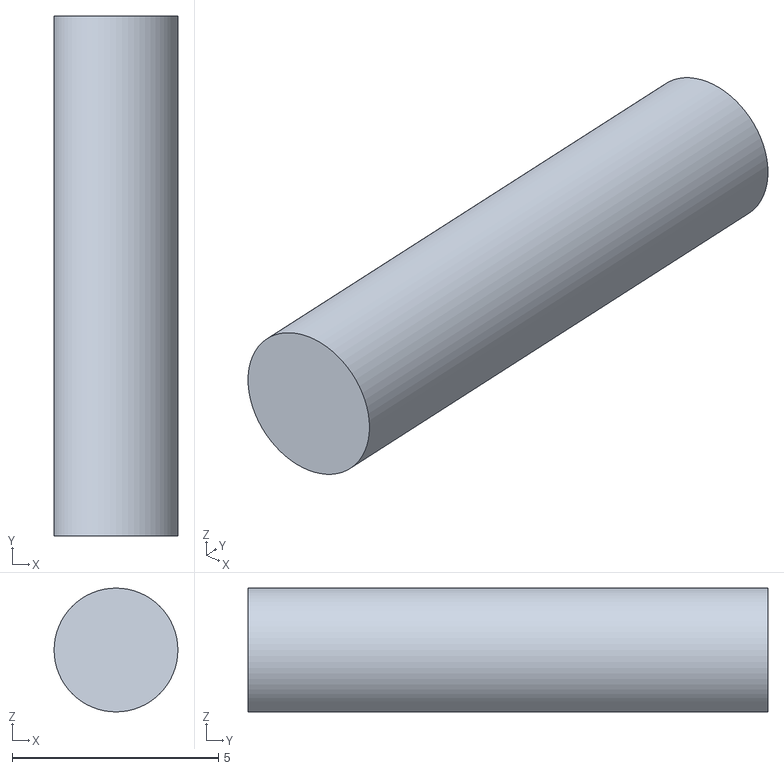
[picture p115: CAD file, 2026-11-03]
parts/box_arm_detent_tower/part.stl
3.00 x 12.6 x 3.00
