sparkiscool/noxen/parts/box_arm_finga_a/part.stl

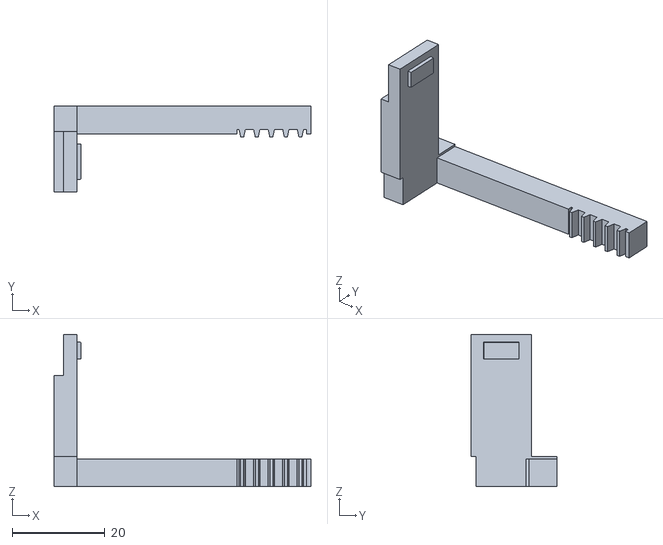
[picture p116: CAD file, 2026-11-03]
parts/box_arm_finga_a/part.stl
55.5 x 18.5 x 32.9
