sparkiscool/noxen/parts/box_arm_fingb_a/part.stl

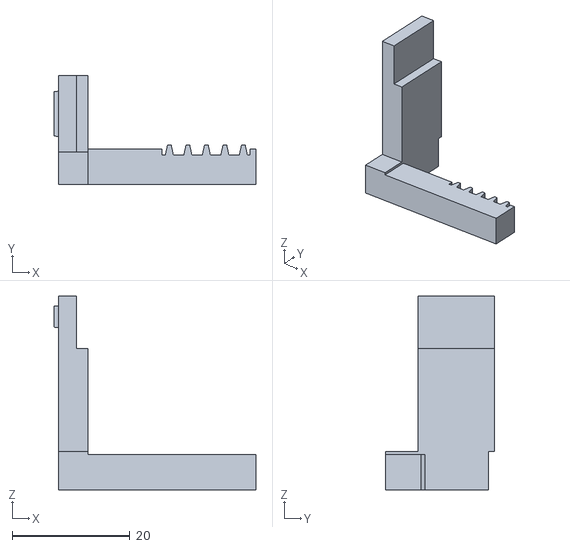
[picture p117: CAD file, 2026-11-03]
parts/box_arm_fingb_a/part.stl
34.3 x 18.5 x 32.9
