sparkiscool/noxen/parts/box_arm_gripa/part.stl

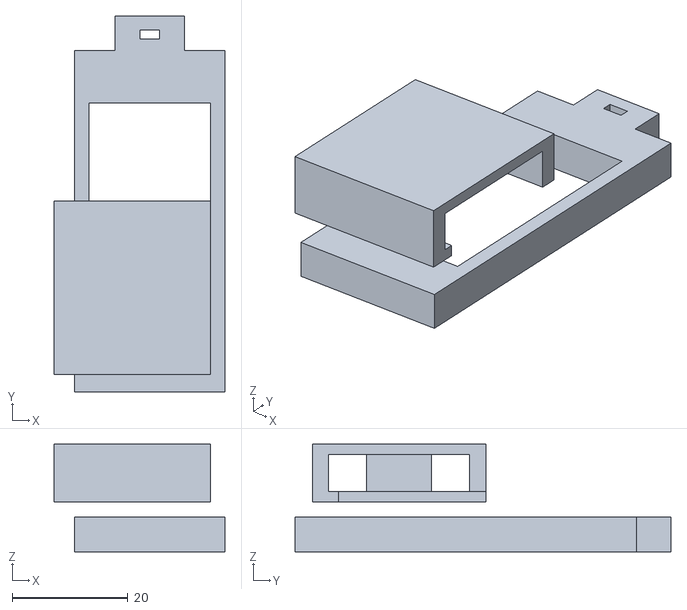
[picture p118: CAD file, 2026-11-03]
parts/box_arm_gripa/part.stl
29.5 x 65.0 x 18.6
