sparkiscool/noxen/parts/box_arm_heada/part.stl

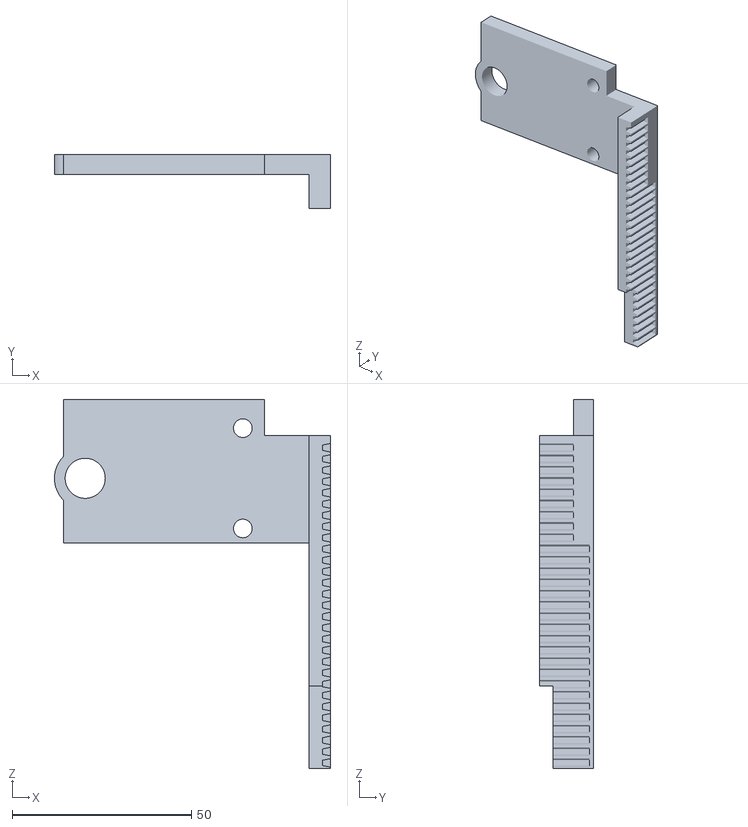
[picture p119: CAD file, 2026-11-03]
parts/box_arm_heada/part.stl
77.1 x 15.1 x 103.0
