sparkiscool/noxen/parts/box_arm_headb/part.stl

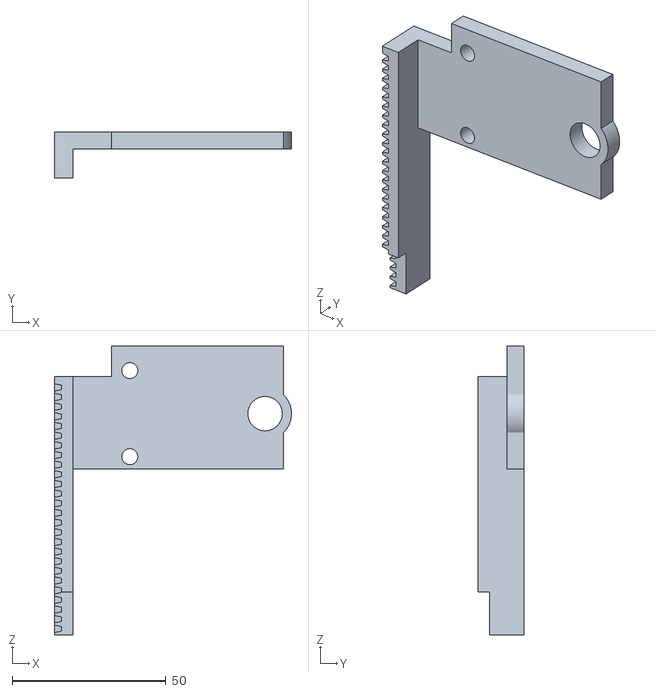
[picture p120: CAD file, 2026-11-03]
parts/box_arm_headb/part.stl
77.1 x 15.1 x 94.0
