sparkiscool/noxen/parts/box_arm_hub/part.stl

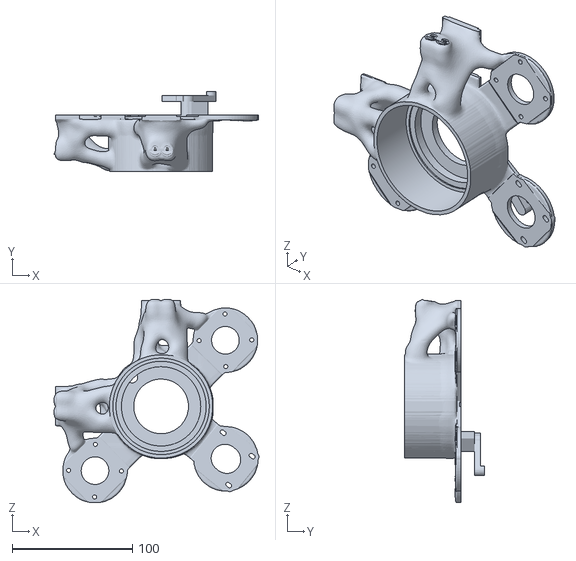
[picture p121: CAD file, 2026-11-03]
parts/box_arm_hub/part.stl
170.6 x 66.9 x 169.3
