sparkiscool/noxen/parts/box_arm_motor_a/part.stl

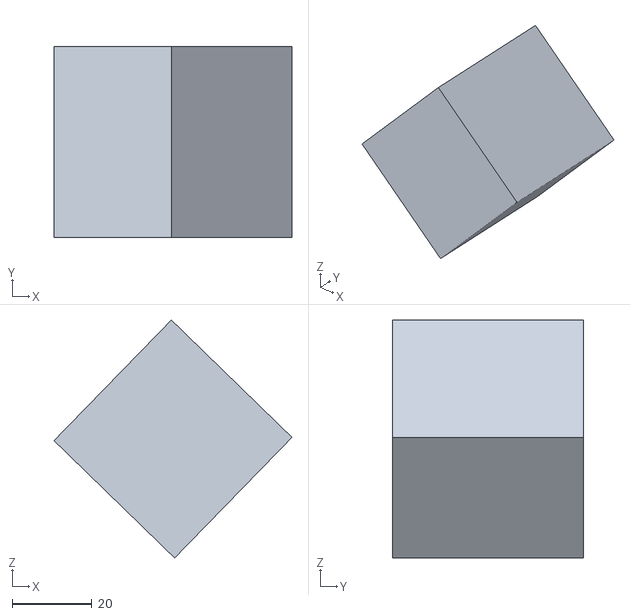
[picture p122: CAD file, 2026-11-03]
parts/box_arm_motor_a/part.stl
59.8 x 48.0 x 59.8
