sparkiscool/noxen/parts/box_arm_motor_axle/part.stl

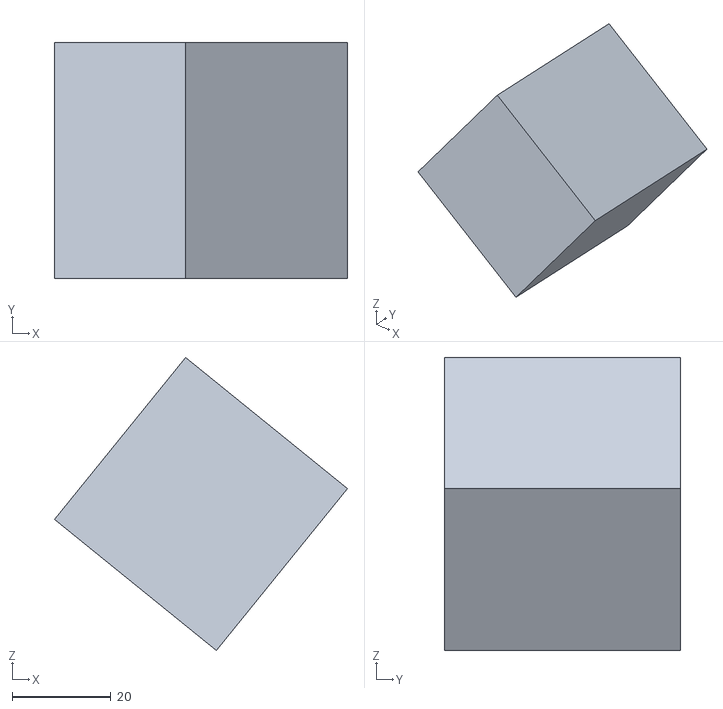
[picture p123: CAD file, 2026-11-03]
parts/box_arm_motor_axle/part.stl
59.5 x 48.0 x 59.5
