sparkiscool/noxen/parts/box_arm_p20_axle/part.stl

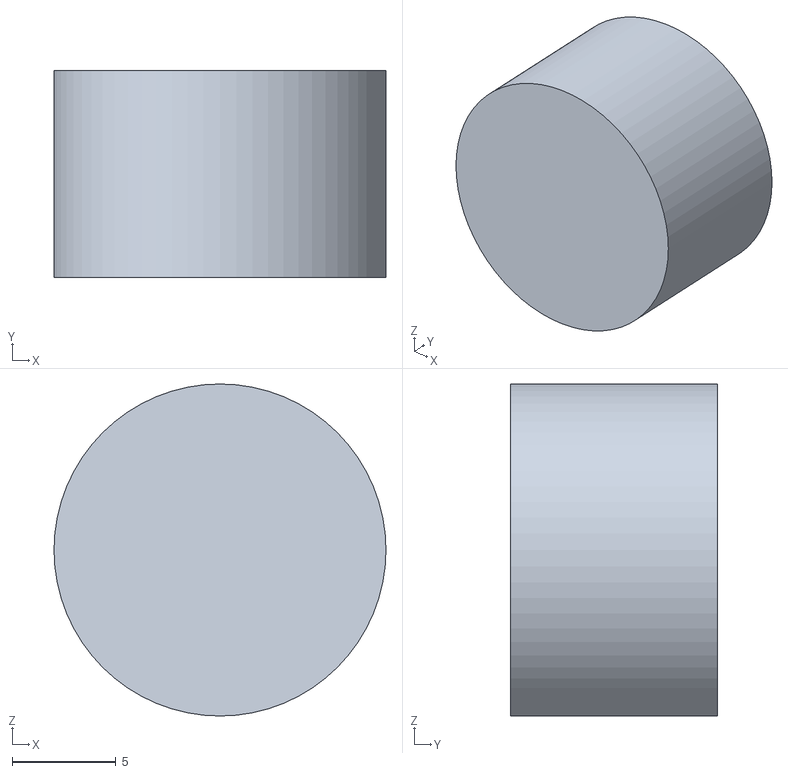
[picture p124: CAD file, 2026-11-03]
parts/box_arm_p20_axle/part.stl
16.0 x 10.0 x 16.0
