sparkiscool/noxen/parts/box_arm_p80/part.stl

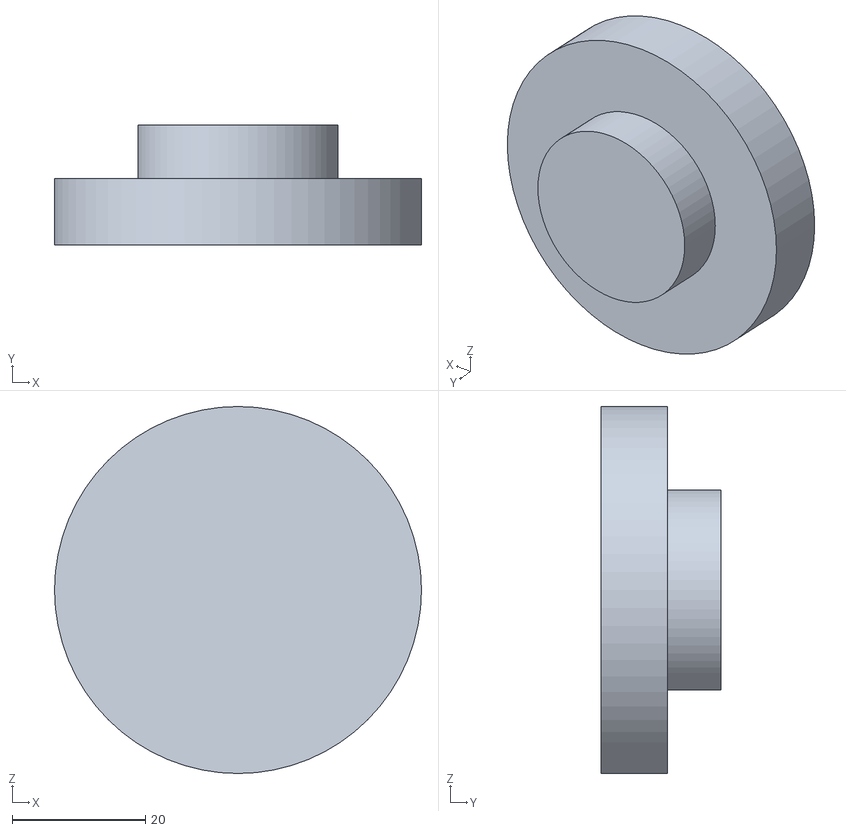
[picture p125: CAD file, 2026-11-03]
parts/box_arm_p80/part.stl
55.0 x 18.0 x 55.0
