sparkiscool/noxen/parts/box_arm_pack_charged/part.stl

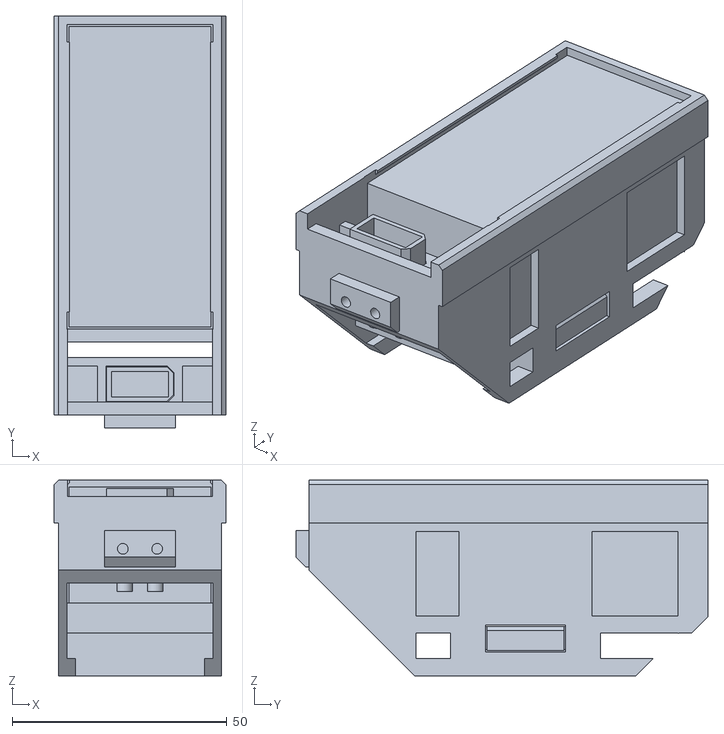
[picture p126: CAD file, 2026-11-03]
parts/box_arm_pack_charged/part.stl
40.0 x 96.0 x 45.6
