sparkiscool/noxen/parts/box_arm_pin16_a/part.stl

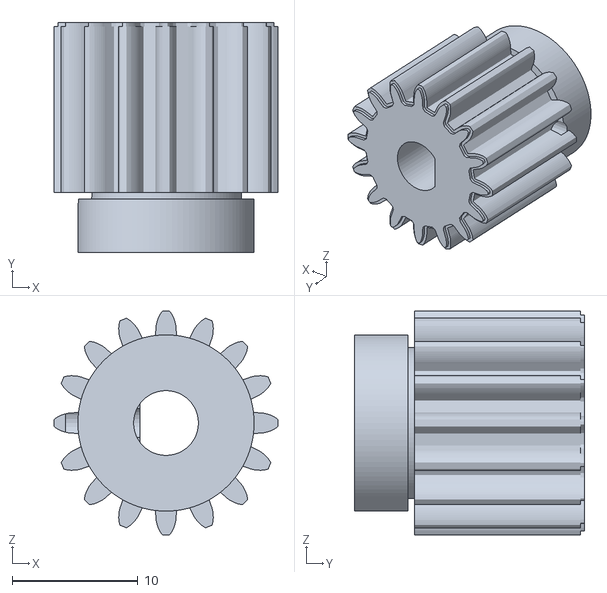
[picture p127: CAD file, 2026-11-03]
parts/box_arm_pin16_a/part.stl
17.8 x 18.2 x 17.8
