sparkiscool/noxen/parts/box_arm_pinion_a/part.stl

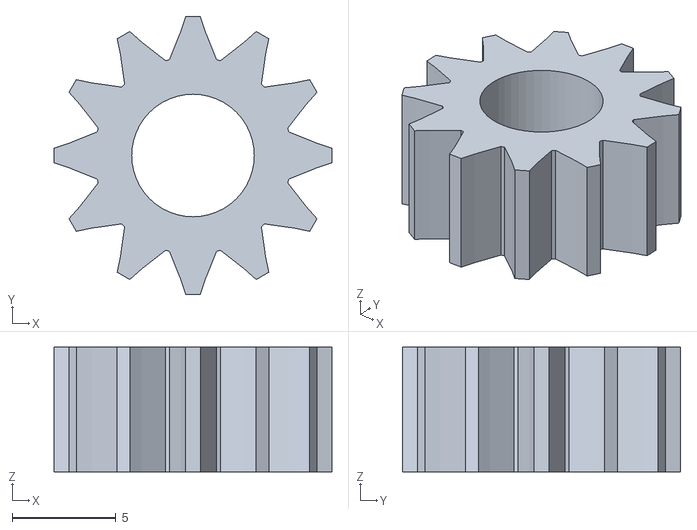
[picture p128: CAD file, 2026-11-03]
parts/box_arm_pinion_a/part.stl
13.4 x 13.4 x 6.00
