sparkiscool/noxen/parts/box_arm_post/part.stl

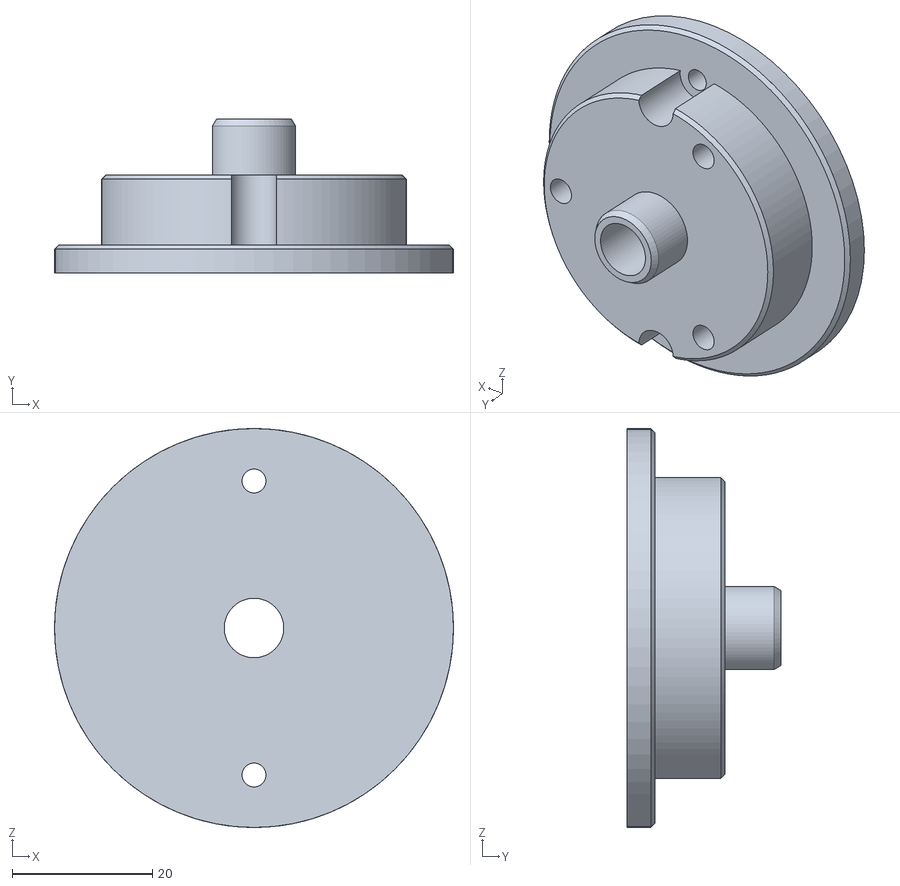
[picture p129: CAD file, 2026-11-03]
parts/box_arm_post/part.stl
57.0 x 22.0 x 57.0
