sparkiscool/noxen/parts/box_arm_raila/part.stl

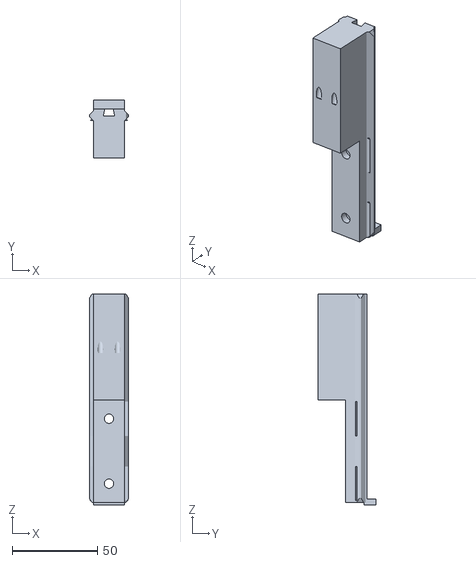
[picture p130: CAD file, 2026-11-03]
parts/box_arm_raila/part.stl
23.0 x 34.0 x 123.5
