sparkiscool/noxen/parts/box_arm_rec0/part.stl

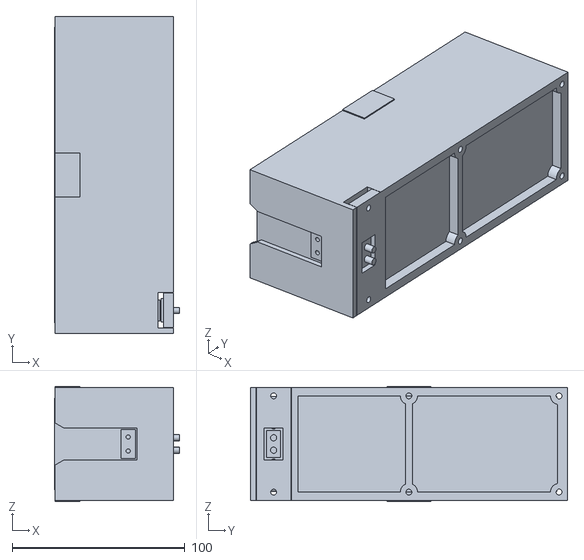
[picture p131: CAD file, 2026-11-03]
parts/box_arm_rec0/part.stl
72.3 x 183.6 x 66.8
