sparkiscool/noxen/parts/box_arm_rec120/part.stl

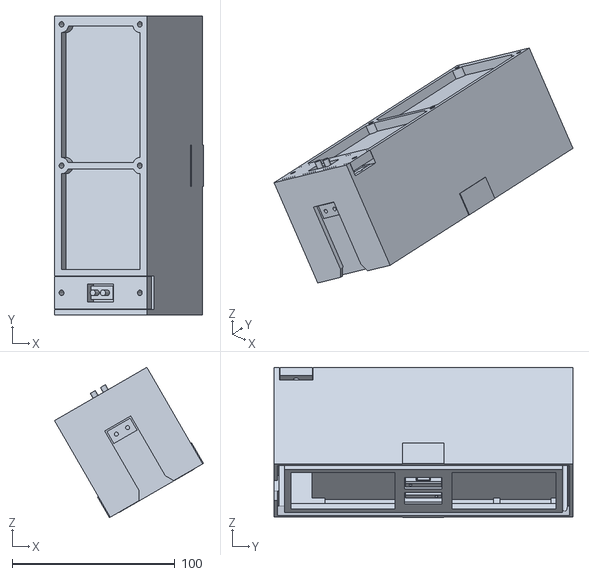
[picture p132: CAD file, 2026-11-09]
parts/box_arm_rec120/part.stl
91.6 x 183.6 x 92.5
