sparkiscool/noxen/parts/box_arm_rec30/part.stl

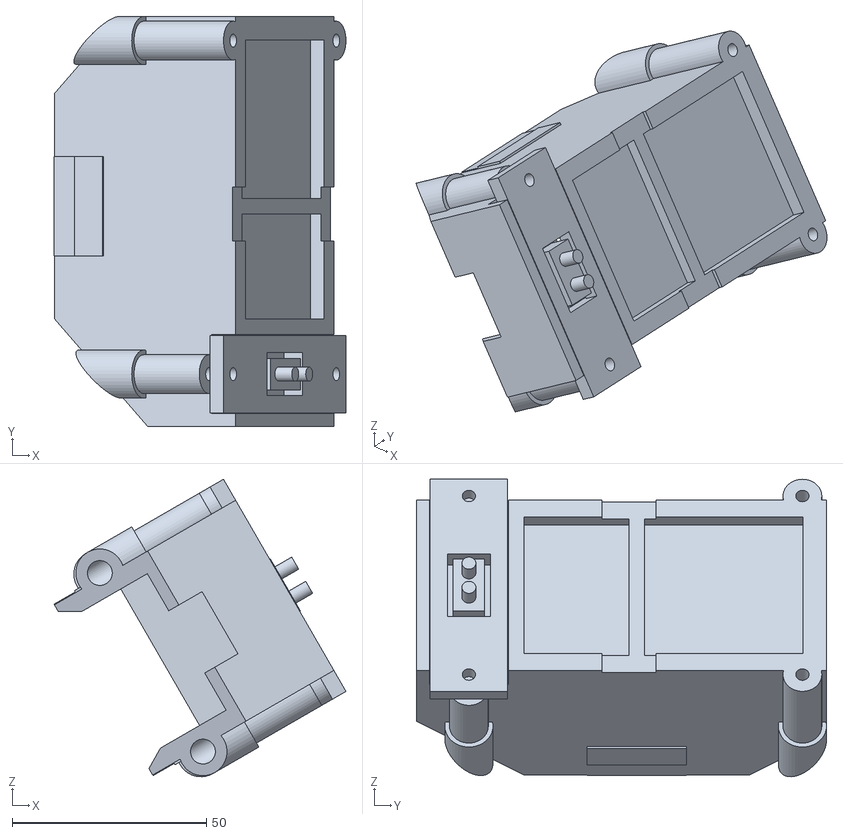
[picture p133: CAD file, 2026-11-03]
parts/box_arm_rec30/part.stl
75.2 x 105.6 x 76.6
