sparkiscool/noxen/parts/box_arm_rec_150/part.stl

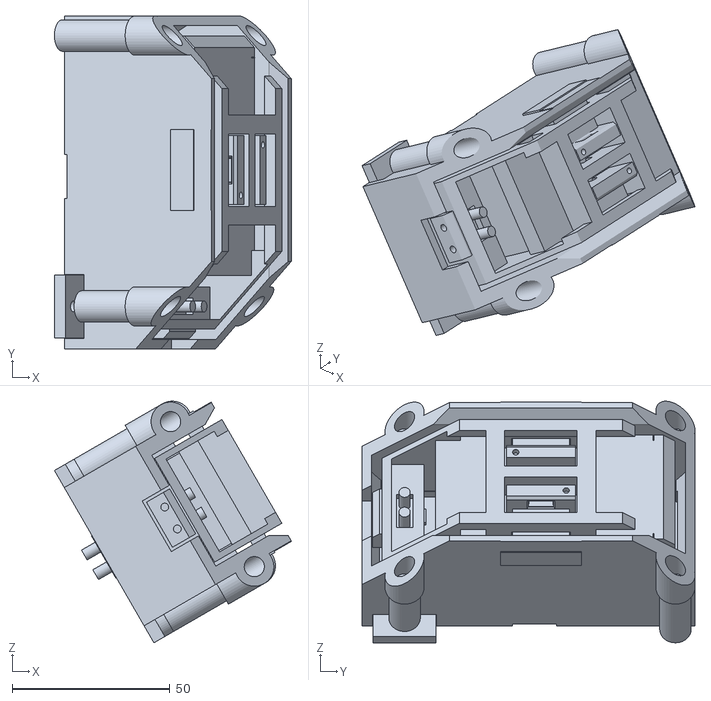
[picture p134: CAD file, 2026-11-03]
parts/box_arm_rec_150/part.stl
75.2 x 105.6 x 76.6
