sparkiscool/noxen/parts/box_arm_rec_90/part.stl

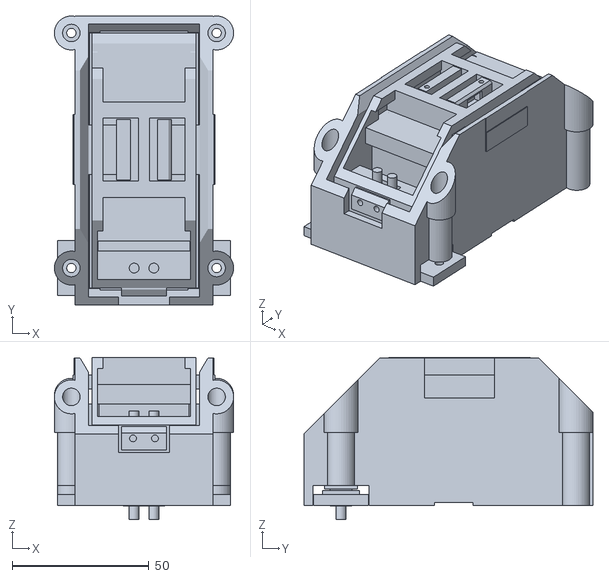
[picture p135: CAD file, 2026-11-03]
parts/box_arm_rec_90/part.stl
65.5 x 105.6 x 59.3
