sparkiscool/noxen/parts/box_arm_servo_a/part.stl

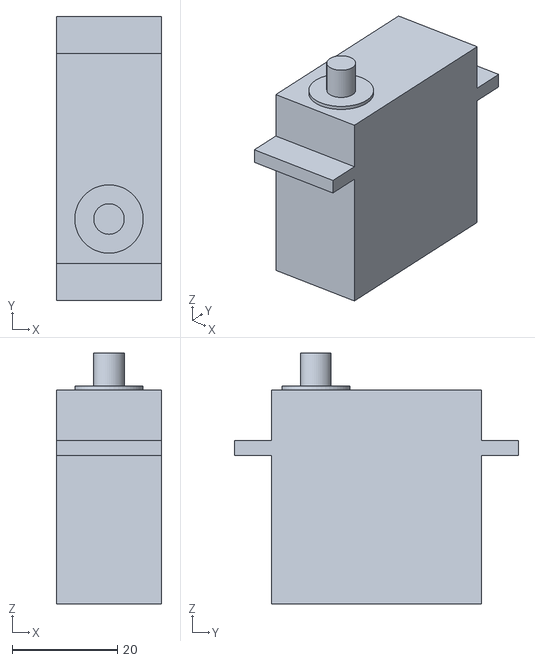
[picture p136: CAD file, 2026-11-03]
parts/box_arm_servo_a/part.stl
20.0 x 54.0 x 47.7
