sparkiscool/noxen/parts/box_arm_shaft_a/part.stl

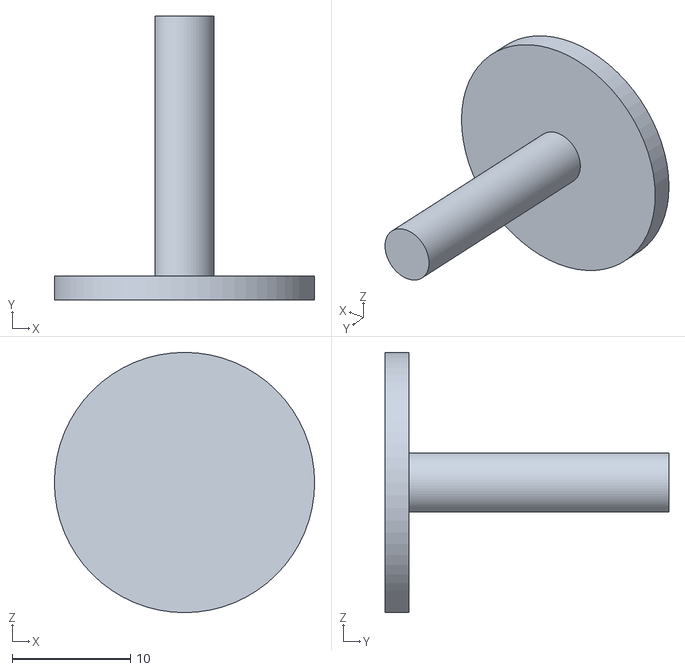
[picture p137: CAD file, 2026-11-03]
parts/box_arm_shaft_a/part.stl
22.0 x 24.0 x 22.0
