sparkiscool/noxen/parts/box_arm_shaft_axle/part.stl

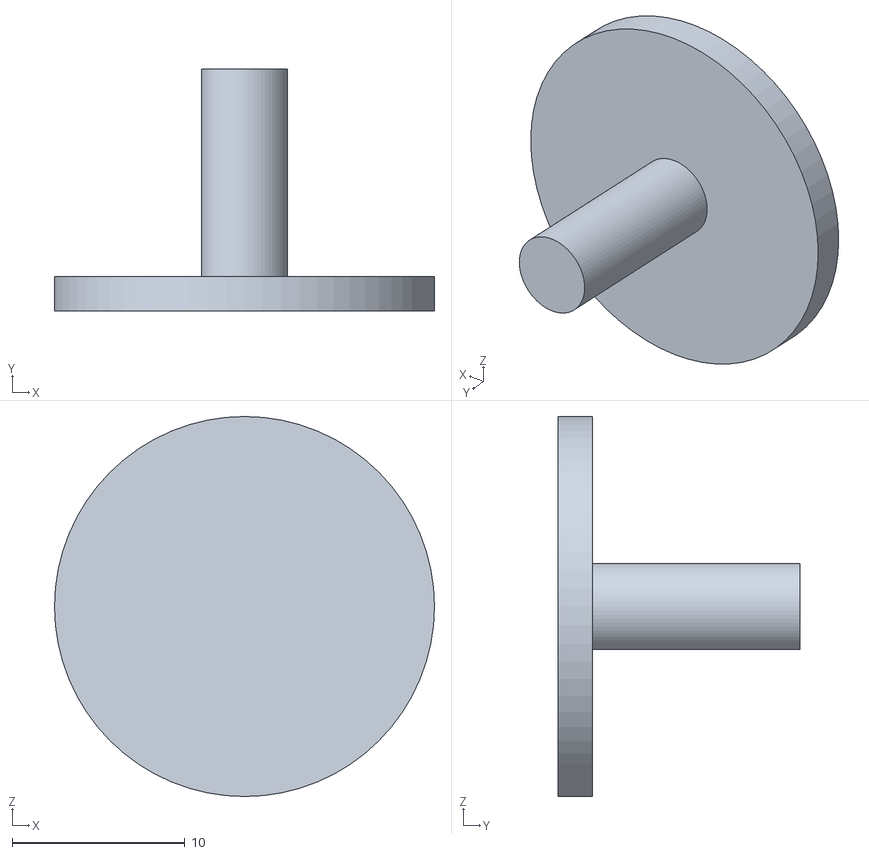
[picture p138: CAD file, 2026-11-03]
parts/box_arm_shaft_axle/part.stl
22.0 x 14.0 x 22.0
