sparkiscool/noxen/parts/box_arm_stub/part.stl

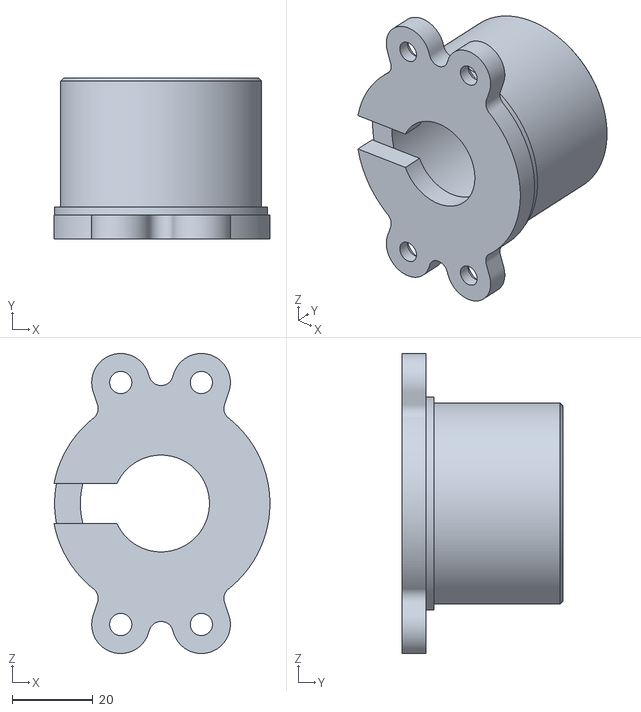
[picture p139: CAD file, 2026-11-03]
parts/box_arm_stub/part.stl
53.5 x 40.0 x 74.4
