sparkiscool/noxen/parts/box_arm_tiesa/part.stl

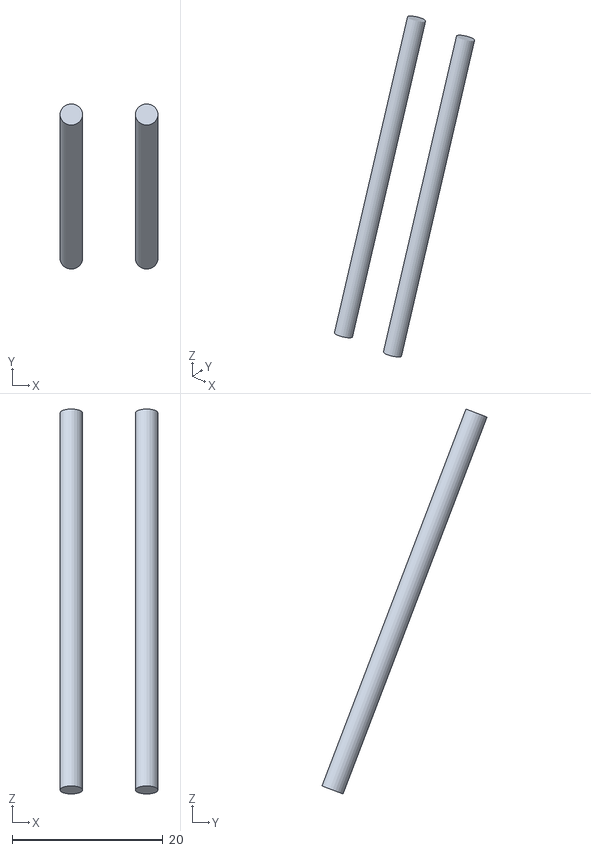
[picture p140: CAD file, 2026-11-03]
parts/box_arm_tiesa/part.stl
13.0 x 21.9 x 51.1
