sparkiscool/noxen/parts/box_arm_wheelsa/part.stl

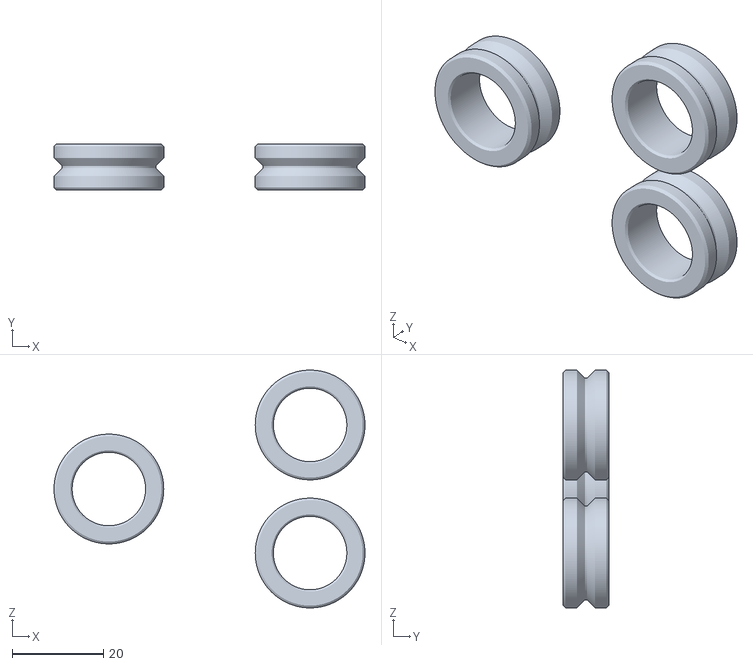
[picture p141: CAD file, 2026-11-03]
parts/box_arm_wheelsa/part.stl
68.0 x 10.0 x 52.0
