sparkiscool/noxen/parts/box_dome/gore_meshes/hoop_0.stl

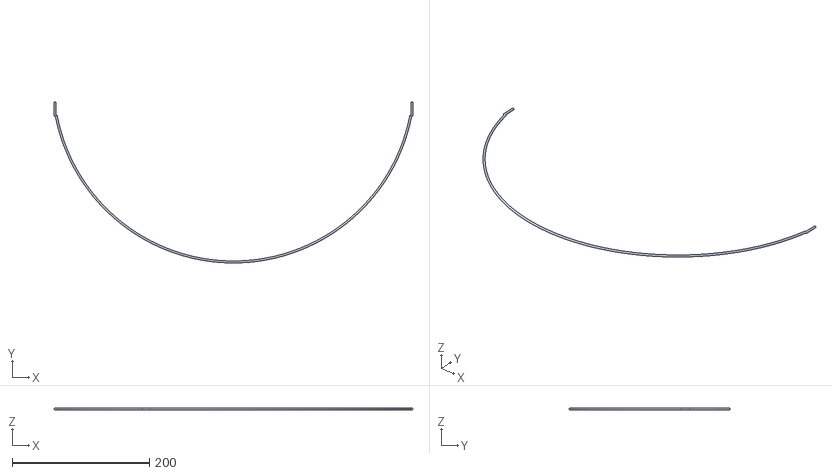
[picture p142: CAD file, 2026-11-09]
parts/box_dome/gore_meshes/hoop_0.stl
522.9 x 234.4 x 3.00
