sparkiscool/noxen/parts/box_funnel_arm/part.stl

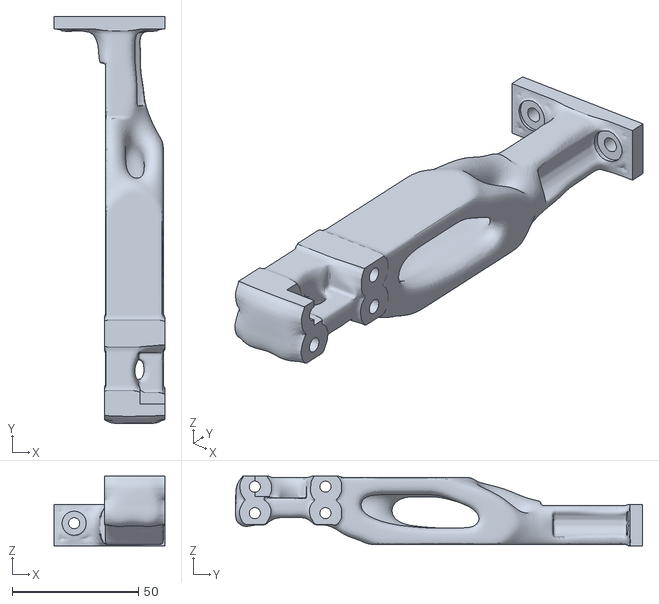
[picture p143: CAD file, 2026-11-13]
parts/box_funnel_arm/part.stl
44.0 x 161.4 x 27.7
