sparkiscool/noxen/parts/box_funnel_arm_drawn/part.stl

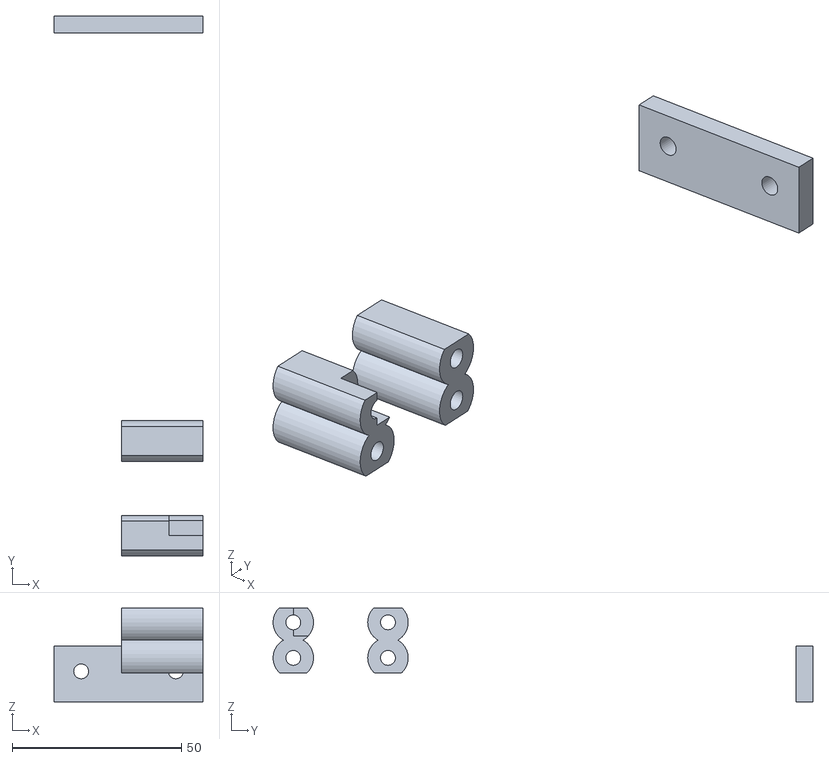
[picture p144: CAD file, 2026-11-13]
parts/box_funnel_arm_drawn/part.stl
44.0 x 159.7 x 27.7
