sparkiscool/noxen/parts/box_funnel_arm_room/part.stl

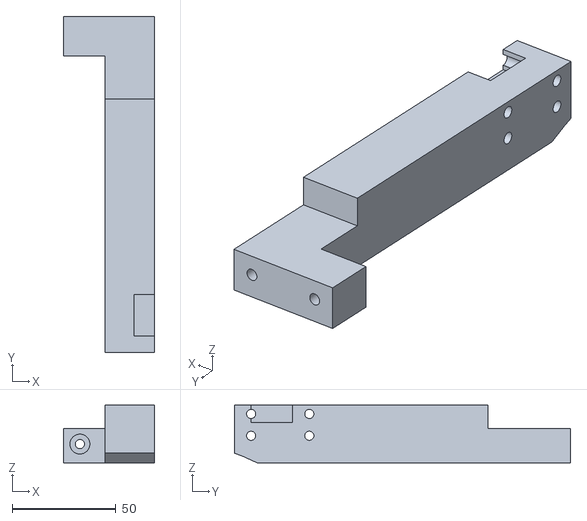
[picture p145: CAD file, 2026-11-13]
parts/box_funnel_arm_room/part.stl
44.0 x 161.7 x 27.7
