sparkiscool/noxen/parts/box_funnel_drive/part.stl

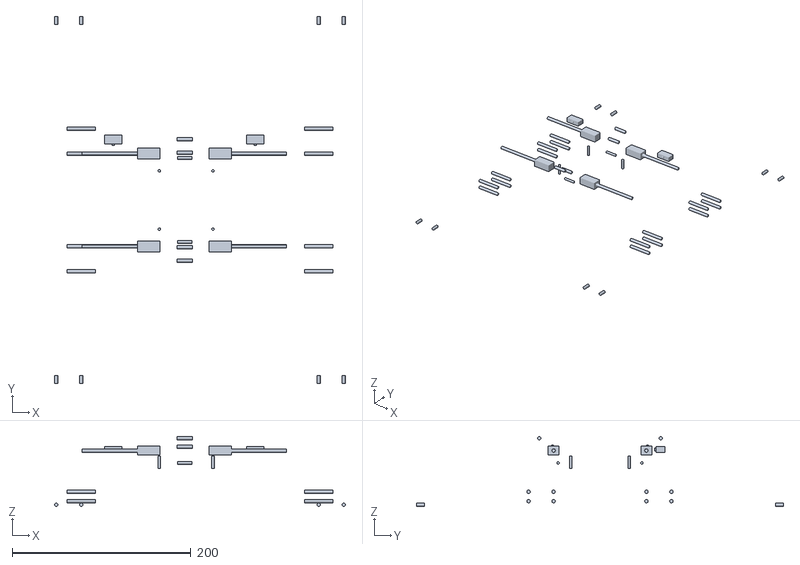
[picture p146: CAD file, 2026-11-13]
parts/box_funnel_drive/part.stl
326.0 x 411.3 x 78.5
