sparkiscool/noxen/parts/box_funnel_half_nose/part.stl

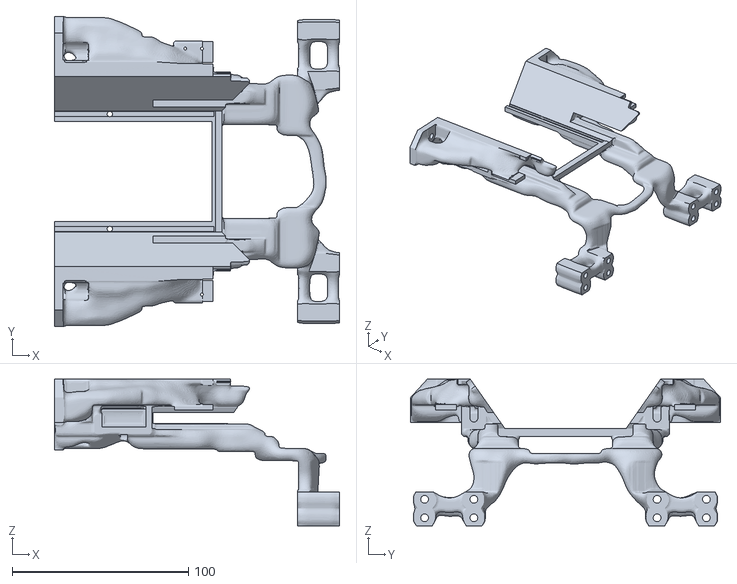
[picture p147: CAD file, 2026-11-14]
parts/box_funnel_half_nose/part.stl
162.0 x 176.0 x 83.2
