sparkiscool/noxen/parts/box_funnel_half_nose_drawn/part.stl

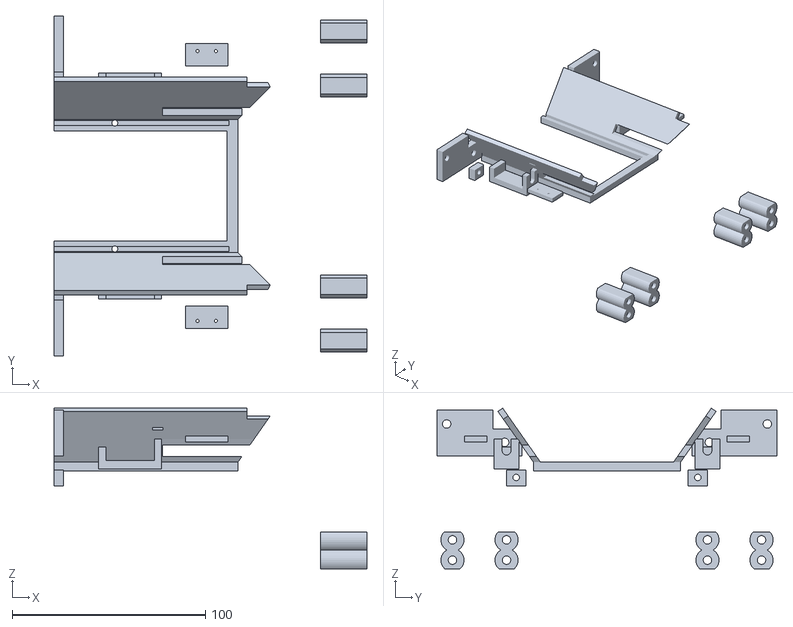
[picture p148: CAD file, 2026-11-13]
parts/box_funnel_half_nose_drawn/part.stl
162.0 x 176.0 x 83.2
