sparkiscool/noxen/parts/box_funnel_half_tail/part.stl

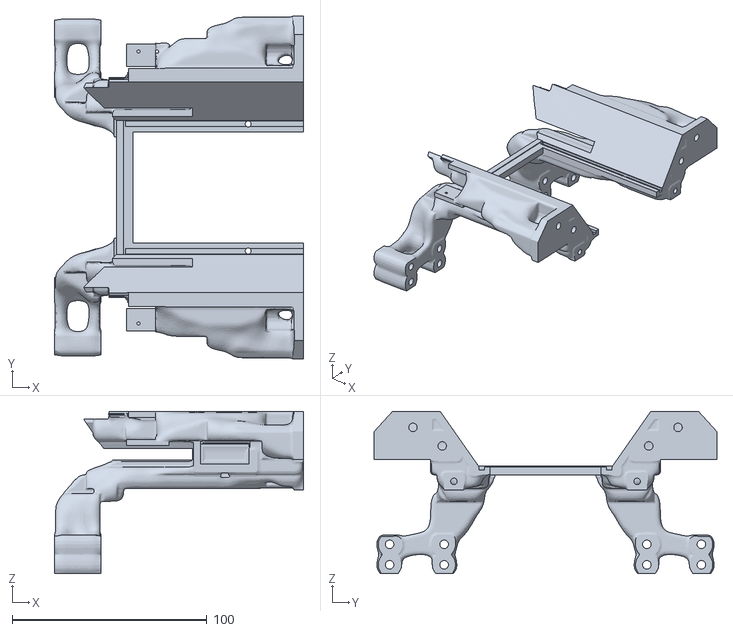
[picture p150: CAD file, 2026-11-14]
parts/box_funnel_half_tail/part.stl
128.0 x 176.0 x 83.2
