sparkiscool/noxen/parts/box_funnel_half_tail_drawn/part.stl

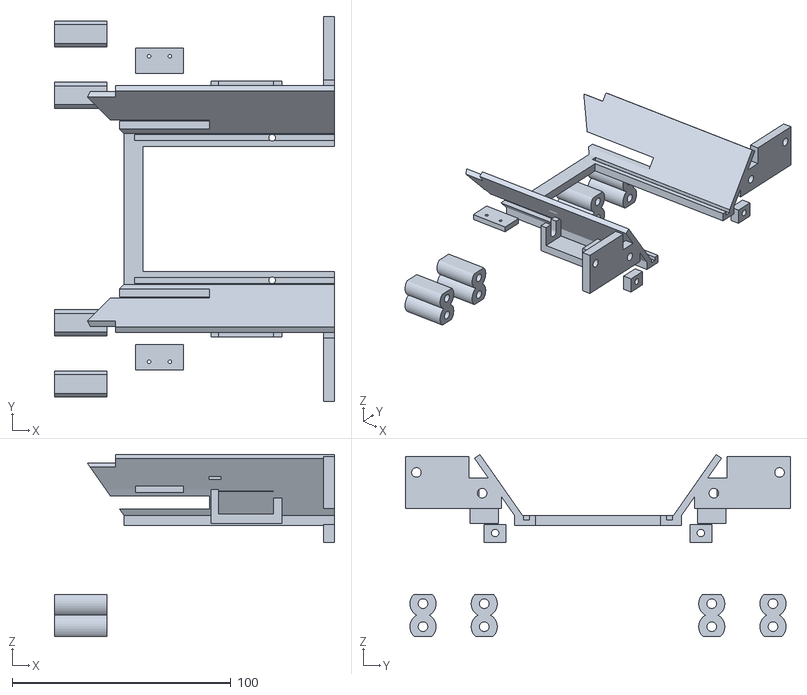
[picture p151: CAD file, 2026-11-13]
parts/box_funnel_half_tail_drawn/part.stl
128.0 x 176.0 x 83.2
