sparkiscool/noxen/parts/box_funnel_half_tail_room/part.stl

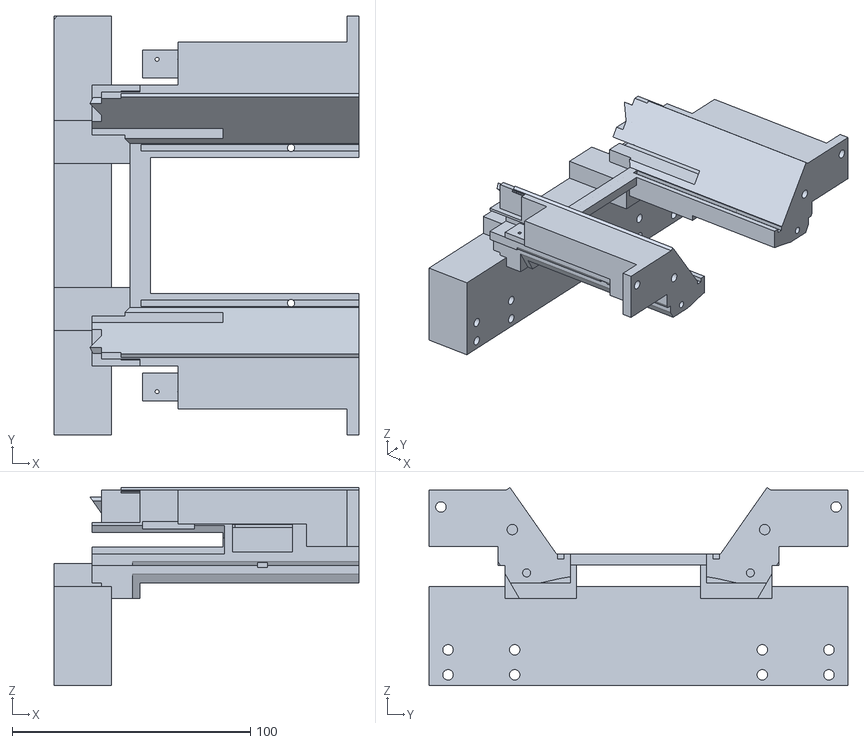
[picture p152: CAD file, 2026-11-13]
parts/box_funnel_half_tail_room/part.stl
128.0 x 176.0 x 83.2
