sparkiscool/noxen/parts/box_funnel_strips/part.stl

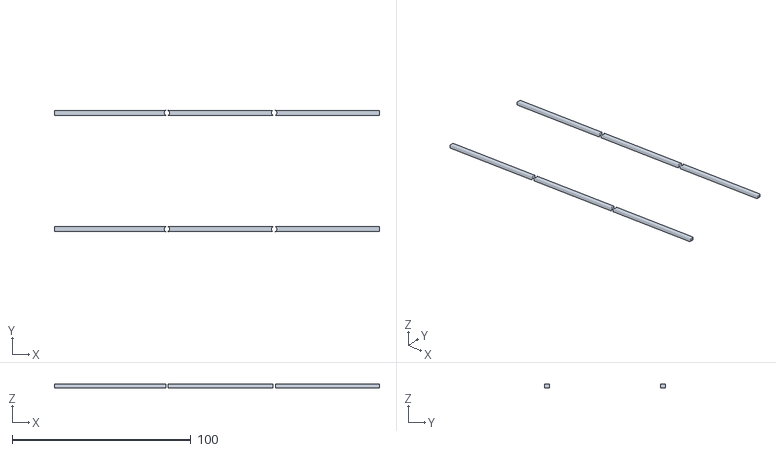
[picture p153: CAD file, 2026-11-13]
parts/box_funnel_strips/part.stl
182.0 x 68.0 x 2.00
