sparkiscool/noxen/parts/box_funnel_wall_nose/part.stl

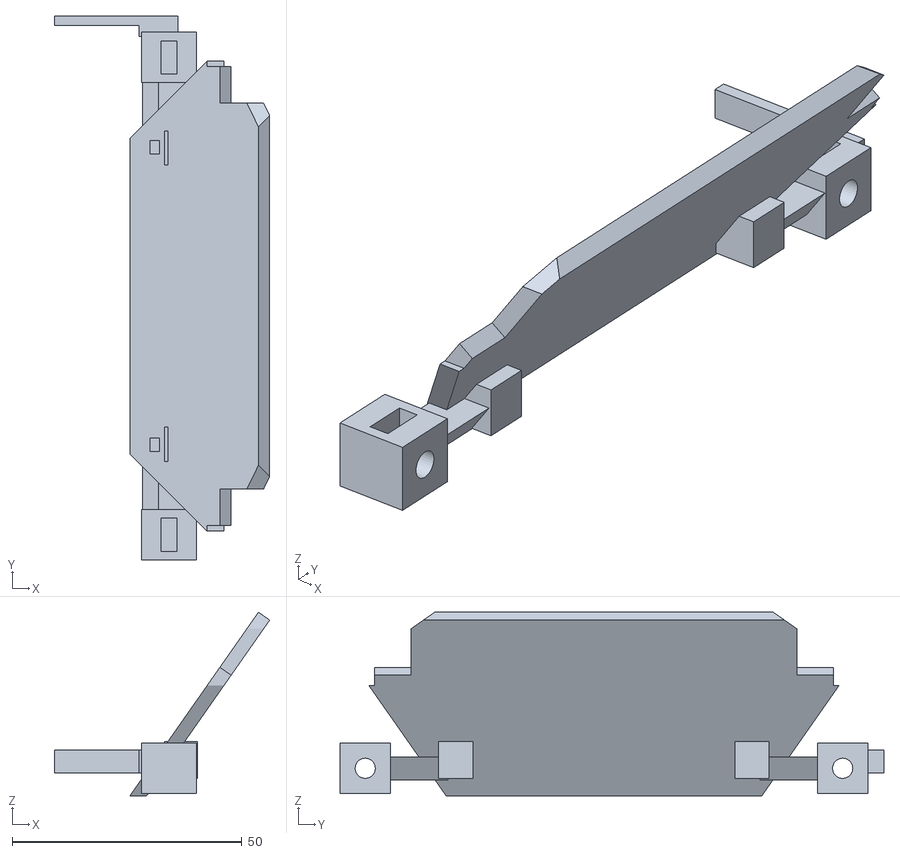
[picture p154: CAD file, 2026-11-13]
parts/box_funnel_wall_nose/part.stl
46.9 x 118.5 x 40.0
