sparkiscool/noxen/parts/box_latch7_overseer_cartridge/part.stl

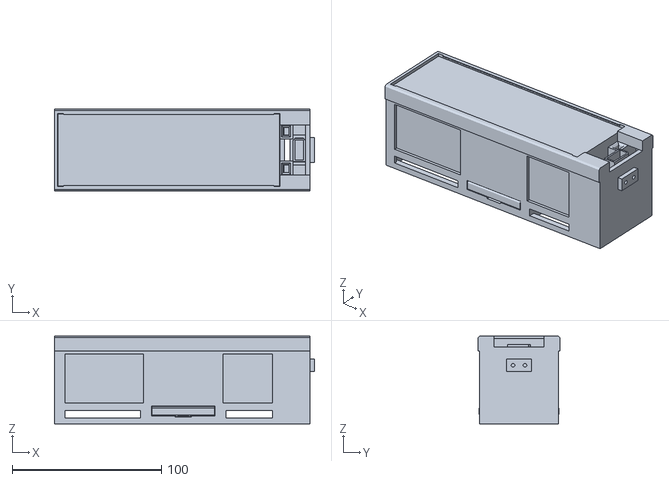
[picture p155: CAD file, 2026-11-14]
parts/box_latch7_overseer_cartridge/part.stl
174.0 x 55.0 x 58.6
