sparkiscool/noxen/parts/box_latch7_scout_cartridge/part.stl

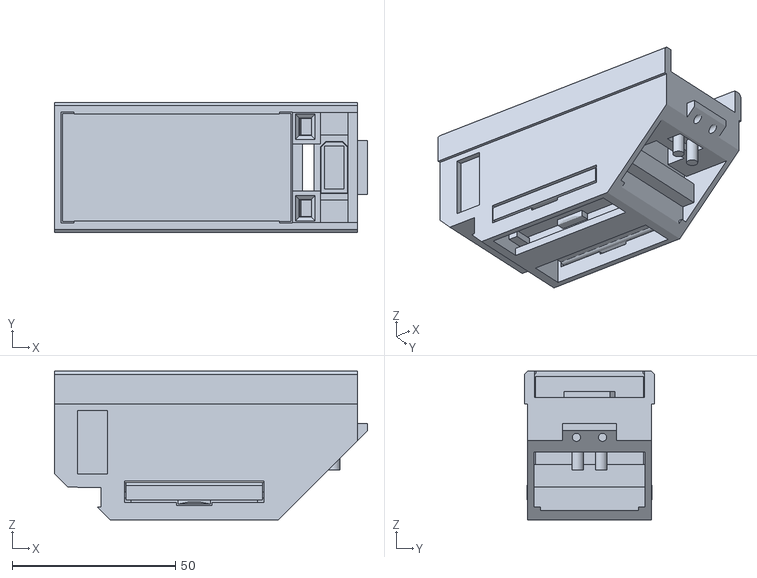
[picture p156: CAD file, 2026-11-14]
parts/box_latch7_scout_cartridge/part.stl
96.0 x 40.0 x 45.6
