sparkiscool/noxen/parts/box_latch7_scout_receiver/part.stl

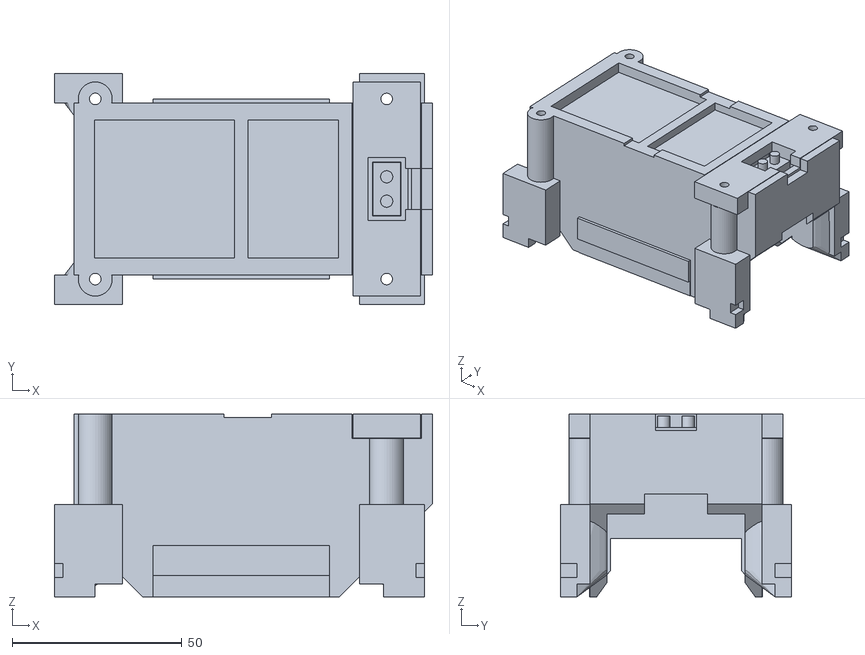
[picture p157: CAD file, 2026-11-14]
parts/box_latch7_scout_receiver/part.stl
111.4 x 68.0 x 53.9
