sparkiscool/noxen/parts/box_overseer_cage_shell_tubes/part.stl

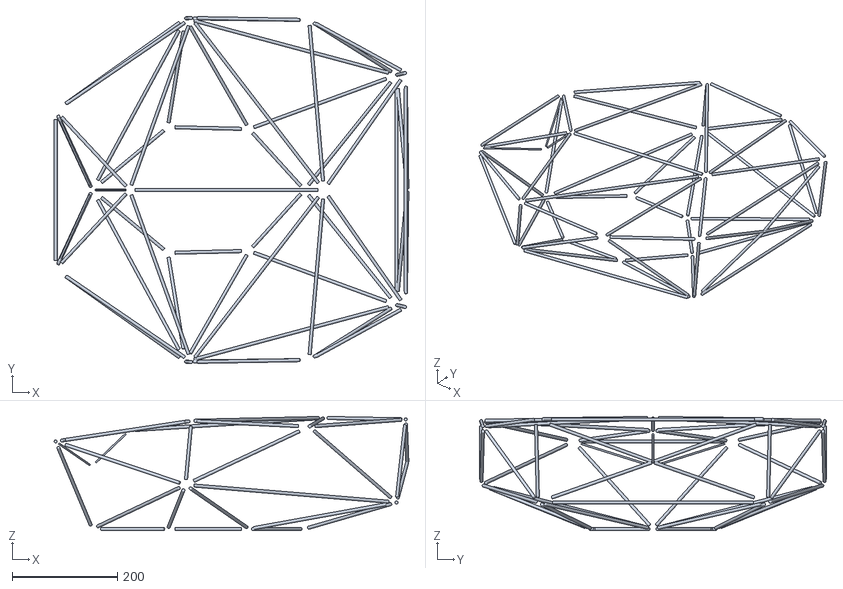
[picture p158: CAD file, 2026-11-03]
parts/box_overseer_cage_shell_tubes/part.stl
675.5 x 660.7 x 217.2
