sparkiscool/noxen/parts/box_overseer_camera_left/part.stl

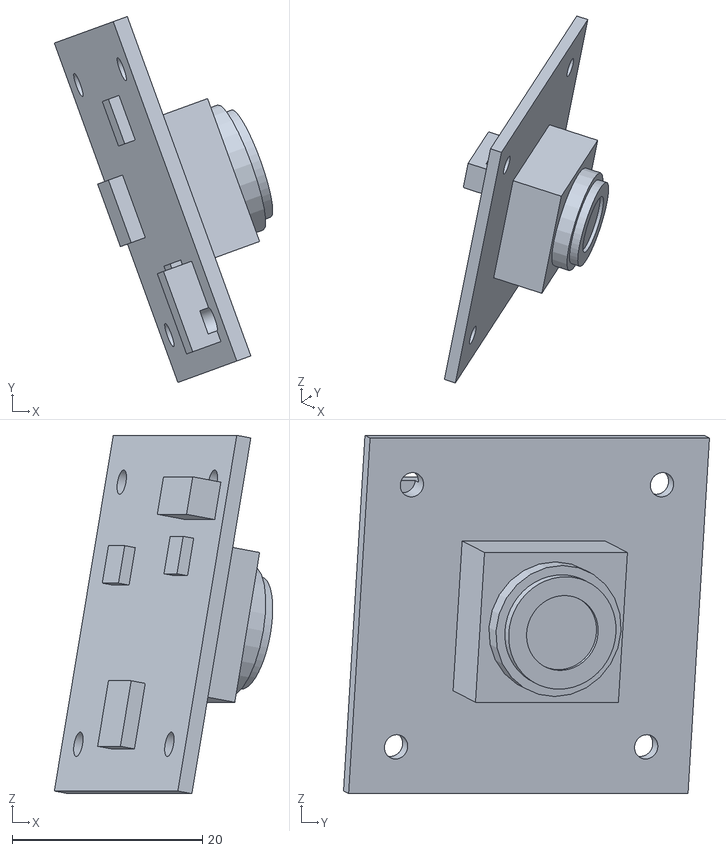
[picture p159: CAD file, 2026-10-30]
parts/box_overseer_camera_left/part.stl
23.0 x 38.5 x 37.7
