sparkiscool/noxen/parts/box_overseer_motor_1/part.stl

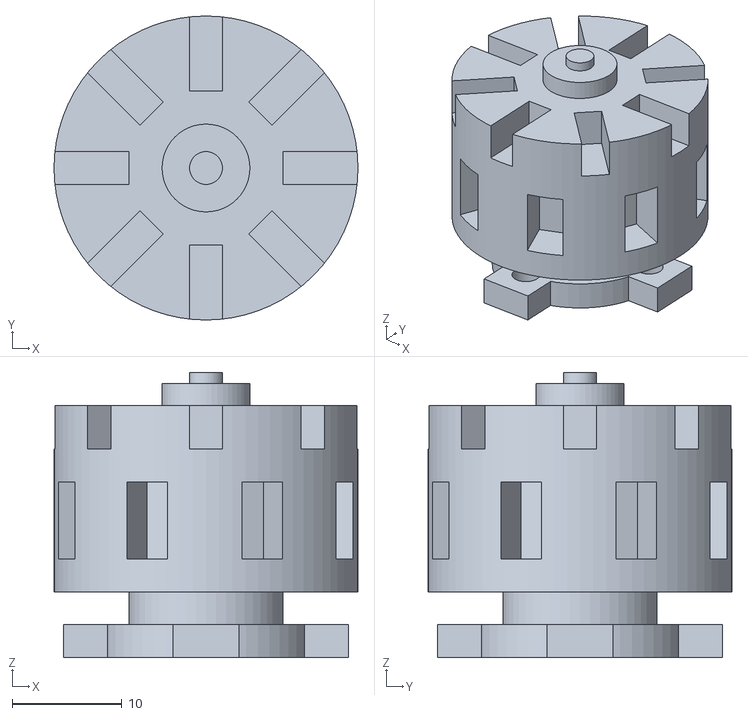
[picture p160: CAD file, 2026-10-30]
parts/box_overseer_motor_1/part.stl
27.7 x 27.7 x 26.0
