sparkiscool/noxen/parts/box_overseer_overseer_base/part.stl

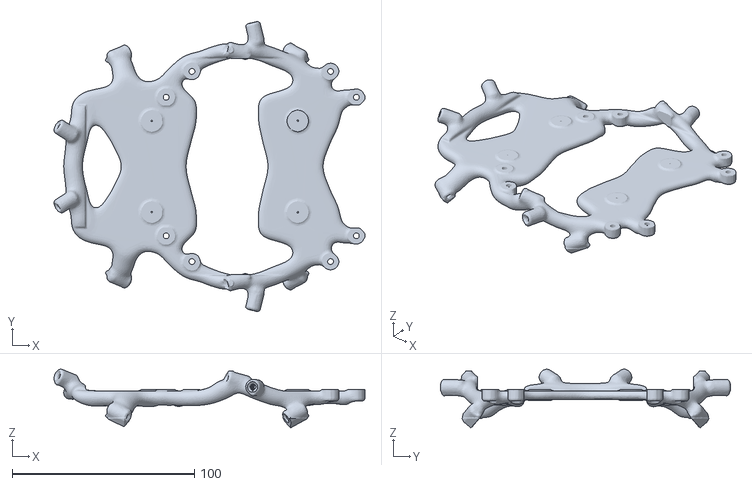
[picture p161: CAD file, 2026-11-03]
parts/box_overseer_overseer_base/part.stl
170.6 x 159.2 x 32.2
