sparkiscool/noxen/parts/box_overseer_overseer_battery_holder/part.stl

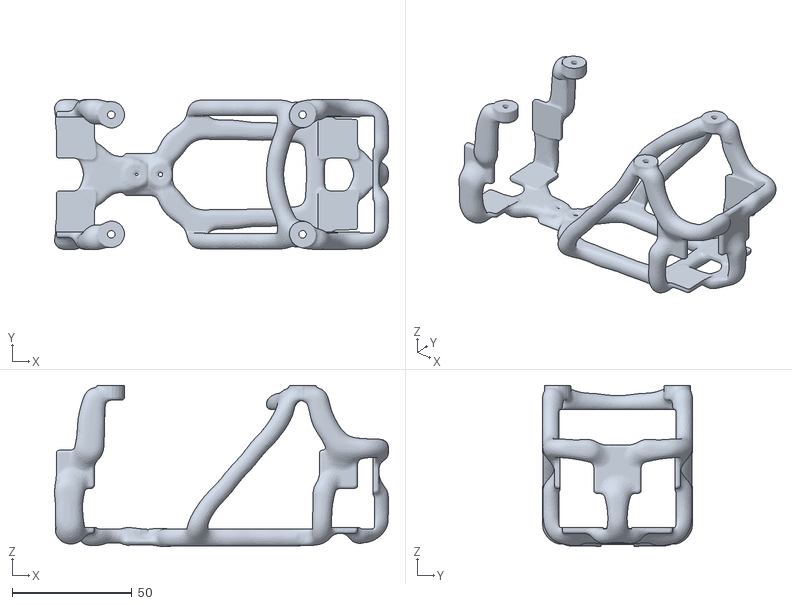
[picture p162: CAD file, 2026-11-08]
parts/box_overseer_overseer_battery_holder/part.stl
139.7 x 62.8 x 67.5
