sparkiscool/noxen/parts/box_overseer_overseer_head_mount/part.stl

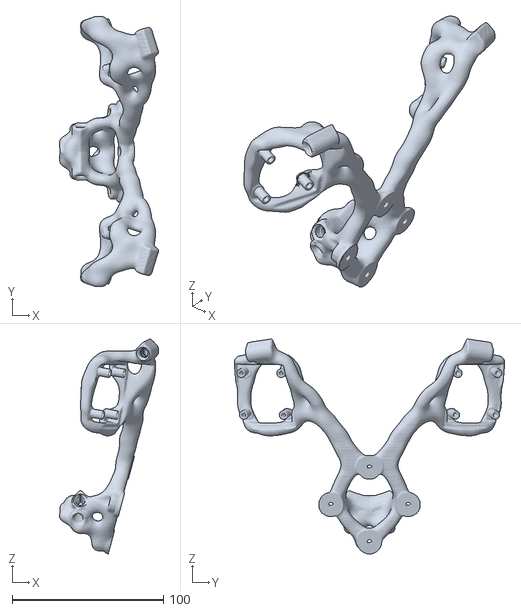
[picture p163: CAD file, 2026-11-03]
parts/box_overseer_overseer_head_mount/part.stl
65.5 x 178.5 x 142.0
