sparkiscool/noxen/parts/box_overseer_prop_1/part.stl

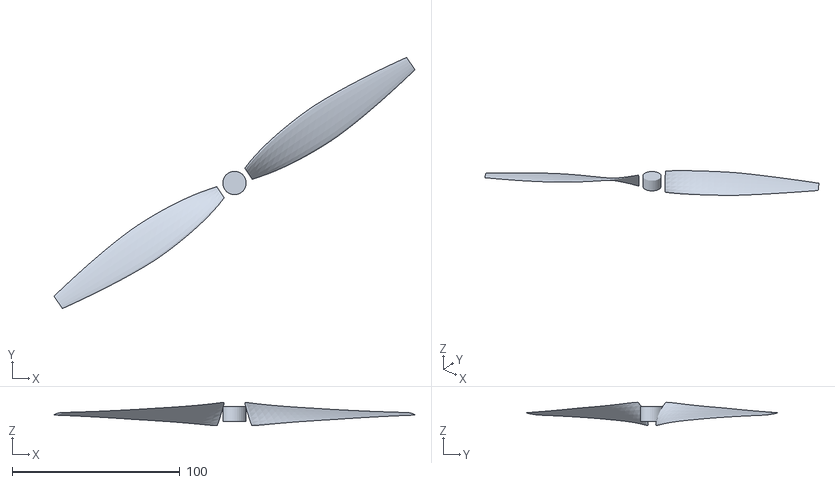
[picture p164: CAD file, 2026-11-03]
parts/box_overseer_prop_1/part.stl
215.3 x 149.8 x 14.0
