sparkiscool/noxen/parts/box_overseer_prop_2/part.stl

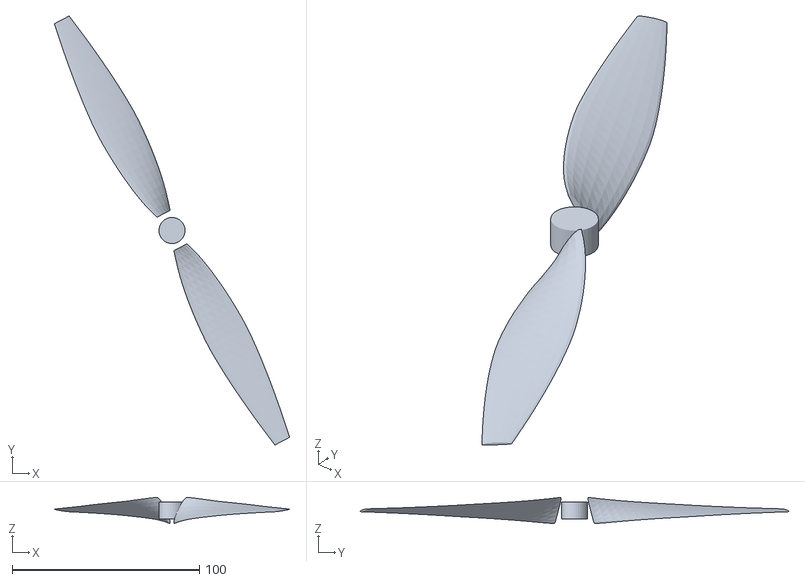
[picture p165: CAD file, 2026-11-03]
parts/box_overseer_prop_2/part.stl
125.7 x 229.2 x 14.0
