sparkiscool/noxen/parts/box_overseer_spokes_ties_head_rods/part.stl

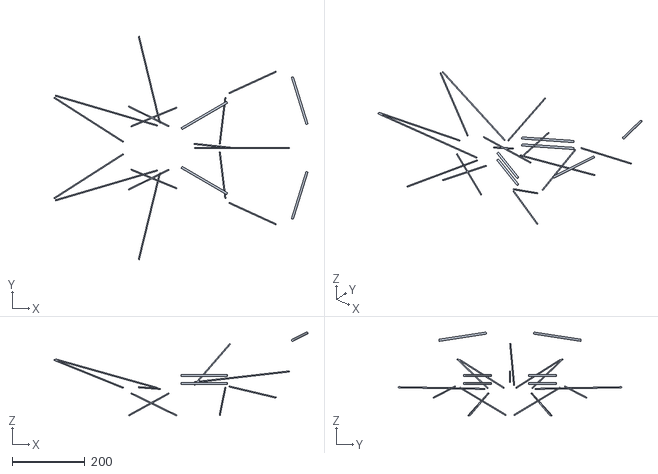
[picture p166: CAD file, 2026-11-03]
parts/box_overseer_spokes_ties_head_rods/part.stl
699.6 x 616.0 x 231.2
