sparkiscool/noxen/parts/box_overseer_top_plate/part.stl

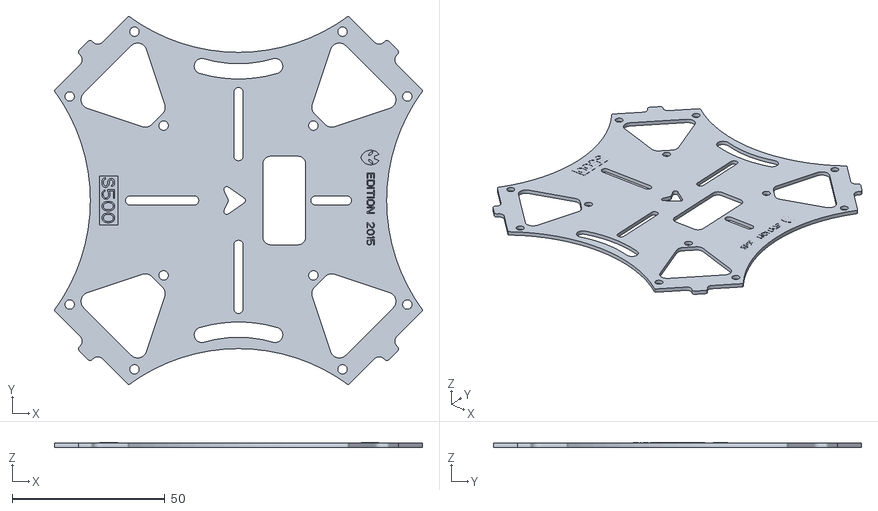
[picture p167: CAD file, 2026-10-28]
parts/box_overseer_top_plate/part.stl
120.5 x 120.5 x 1.60
