sparkiscool/noxen/parts/box_overseer_unitree_l2/part.stl

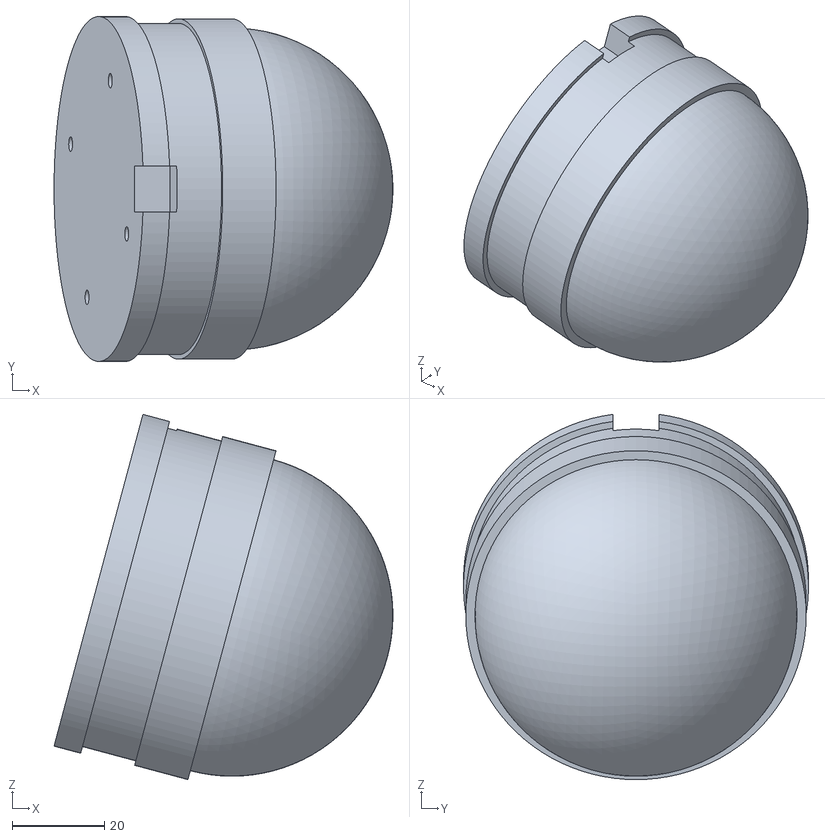
[picture p168: CAD file, 2026-10-30]
parts/box_overseer_unitree_l2/part.stl
73.7 x 75.0 x 79.4
