sparkiscool/noxen/parts/box_scout_camera/part.stl

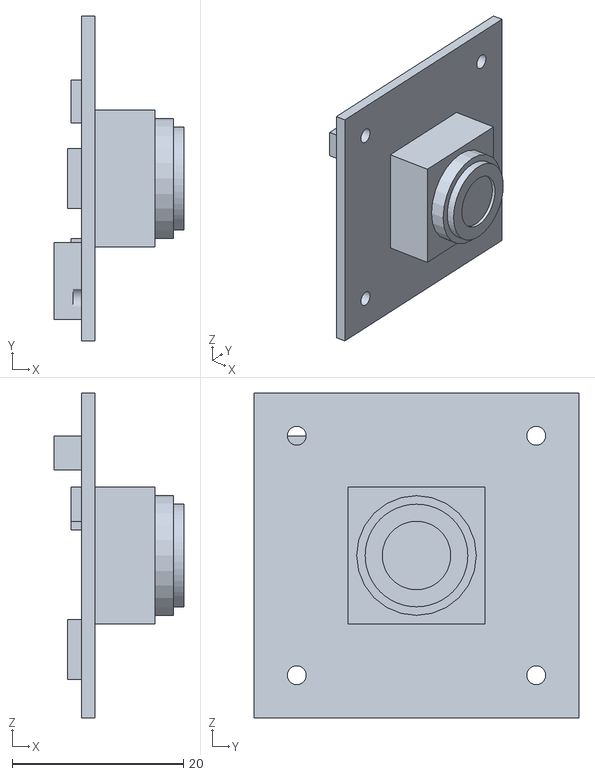
[picture p169: CAD file, 2026-11-08]
parts/box_scout_camera/part.stl
15.2 x 38.0 x 38.0
