sparkiscool/noxen/parts/box_scout_fc/part.stl

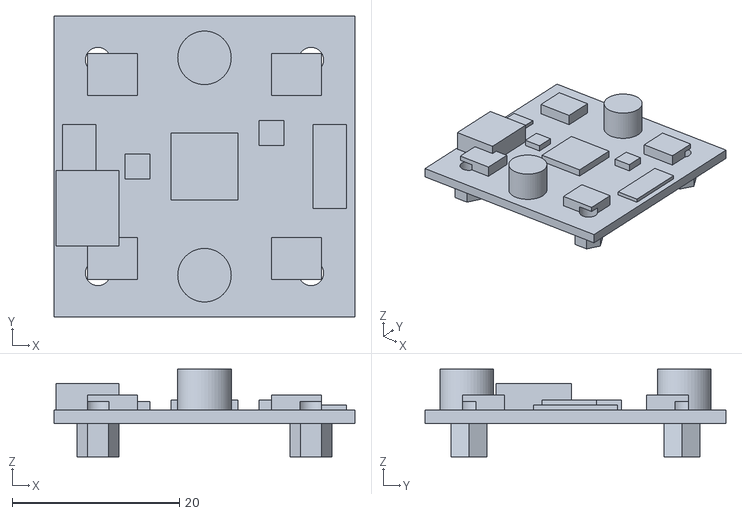
[picture p170: CAD file, 2026-11-08]
parts/box_scout_fc/part.stl
36.0 x 36.0 x 10.5
