sparkiscool/noxen/parts/box_scout_frame_plate_bee35_carbon/part.stl

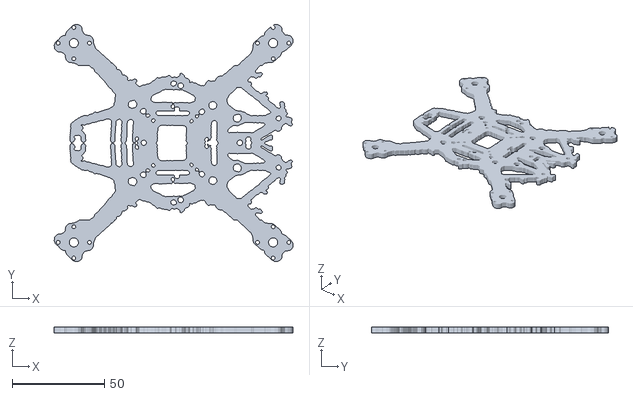
[picture p171: CAD file, 2026-11-03]
parts/box_scout_frame_plate_bee35_carbon/part.stl
129.8 x 128.5 x 3.50
