sparkiscool/noxen/parts/box_scout_scout_belly_skirt/part.stl

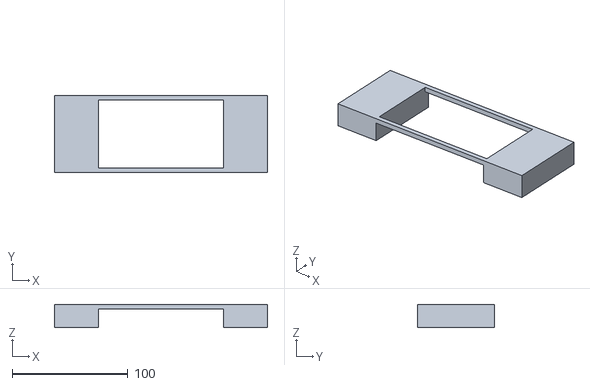
[picture p172: CAD file, 2026-11-03]
parts/box_scout_scout_belly_skirt/part.stl
184.0 x 66.8 x 20.0
