sparkiscool/noxen/parts/box_scout_scout_cage_v19/part.stl

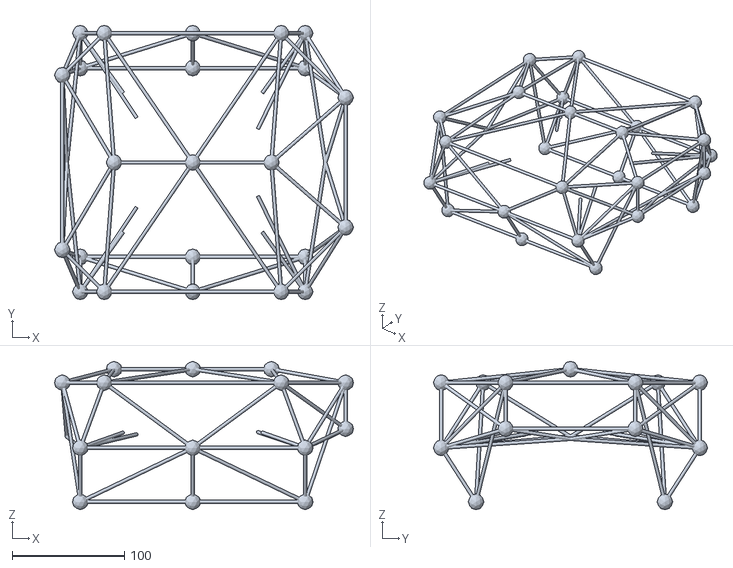
[picture p173: CAD file, 2026-11-08]
parts/box_scout_scout_cage_v19/part.stl
266.0 x 244.0 x 132.0
