sparkiscool/noxen/parts/box_scout_scout_motor_1/part.stl

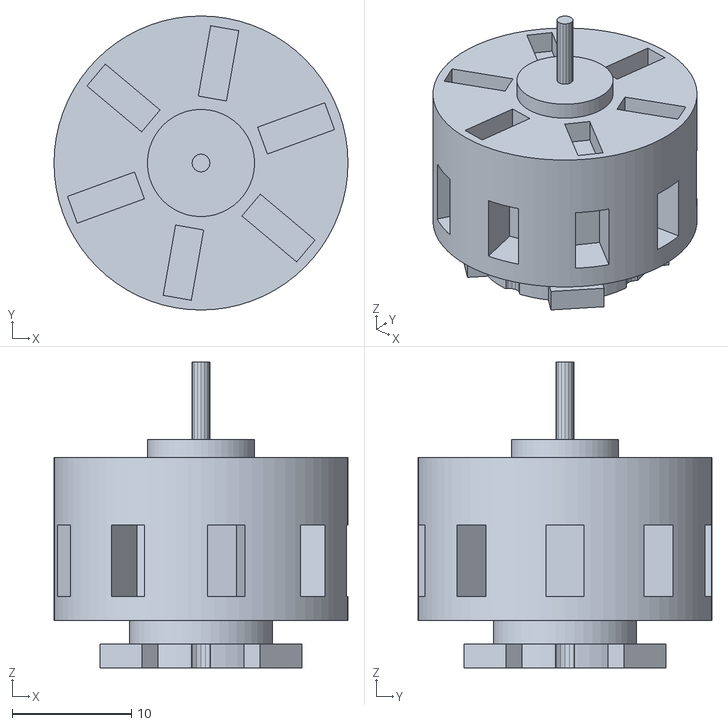
[picture p174: CAD file, 2026-11-03]
parts/box_scout_scout_motor_1/part.stl
24.7 x 24.7 x 25.7
