sparkiscool/noxen/parts/box_scout_scout_nose_unit/part.stl

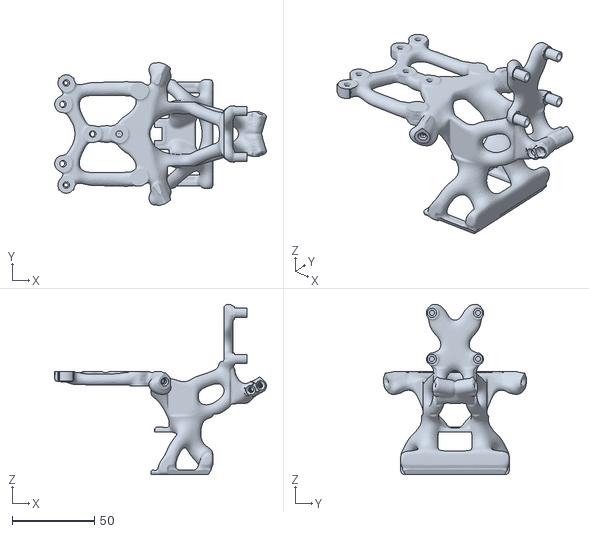
[picture p175: CAD file, 2026-11-08]
parts/box_scout_scout_nose_unit/part.stl
128.7 x 87.0 x 103.5
