sparkiscool/noxen/parts/box_scout_scout_nose_unit_room/part.stl

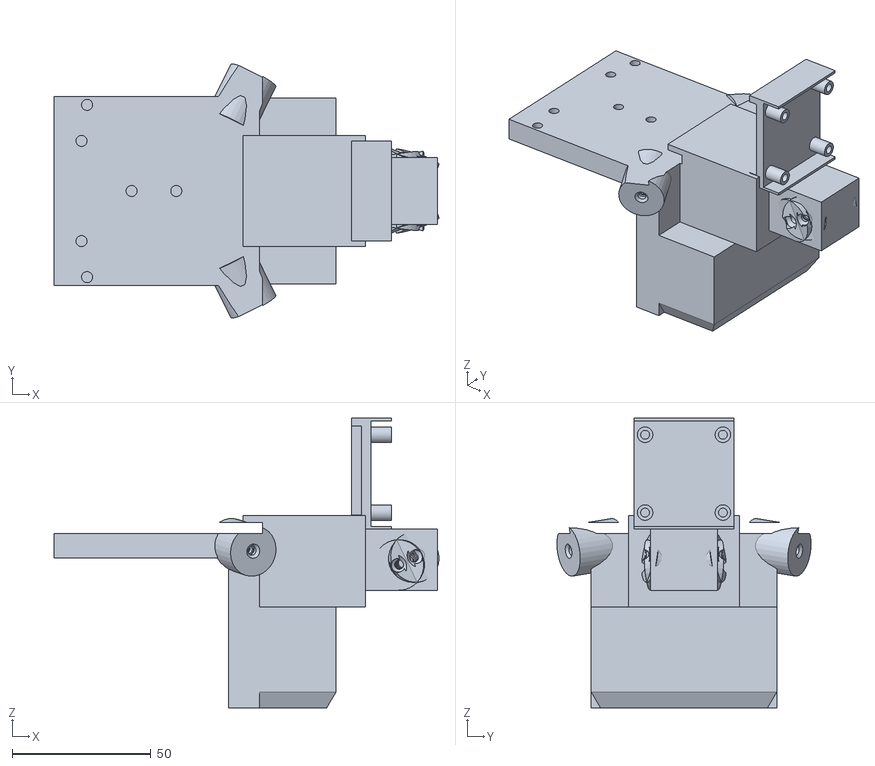
[picture p176: CAD file, 2026-11-08]
parts/box_scout_scout_nose_unit_room/part.stl
138.5 x 91.5 x 104.3
