sparkiscool/noxen/parts/box_scout_scout_prop_1/part.stl

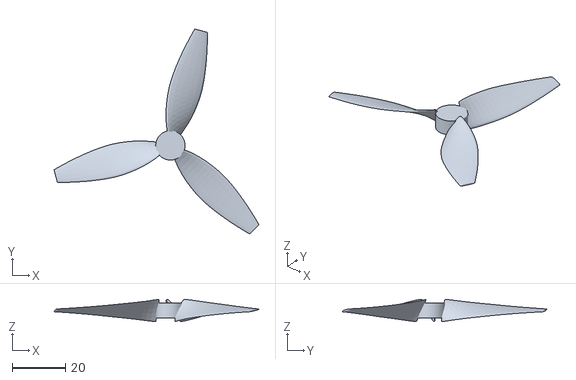
[picture p177: CAD file, 2026-11-03]
parts/box_scout_scout_prop_1/part.stl
76.7 x 76.7 x 8.38
