sparkiscool/noxen/parts/box_scout_scout_tail_unit/part.stl

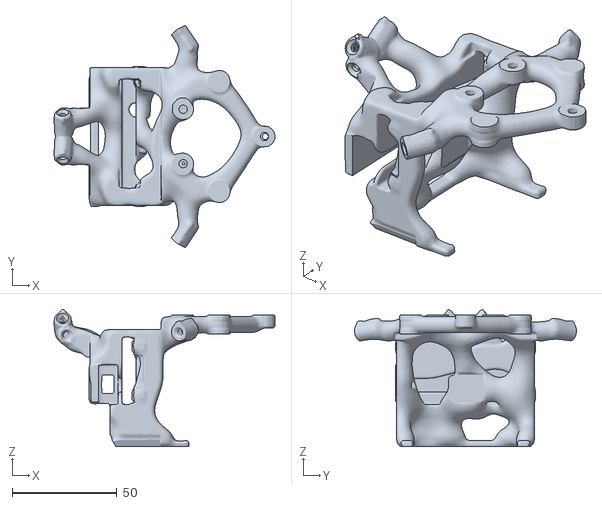
[picture p178: CAD file, 2026-11-08]
parts/box_scout_scout_tail_unit/part.stl
105.6 x 106.0 x 65.6
