sparkiscool/noxen/parts/box_scout_scout_tail_unit_room/part.stl

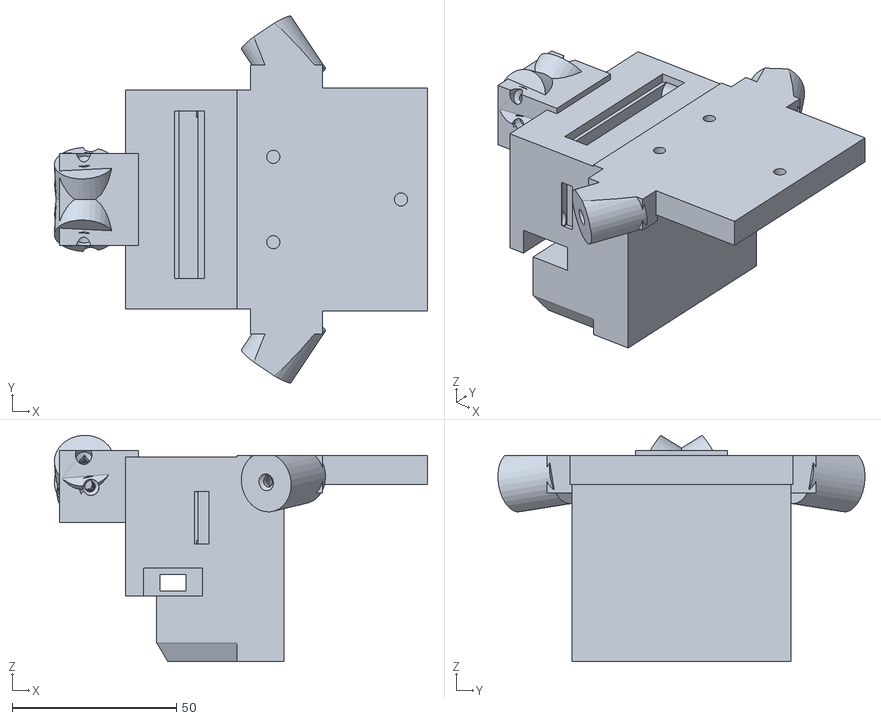
[picture p179: CAD file, 2026-11-08]
parts/box_scout_scout_tail_unit_room/part.stl
113.7 x 111.7 x 68.9
