sparkiscool/noxen/parts/box_stand2_base_l_drawn/part.stl

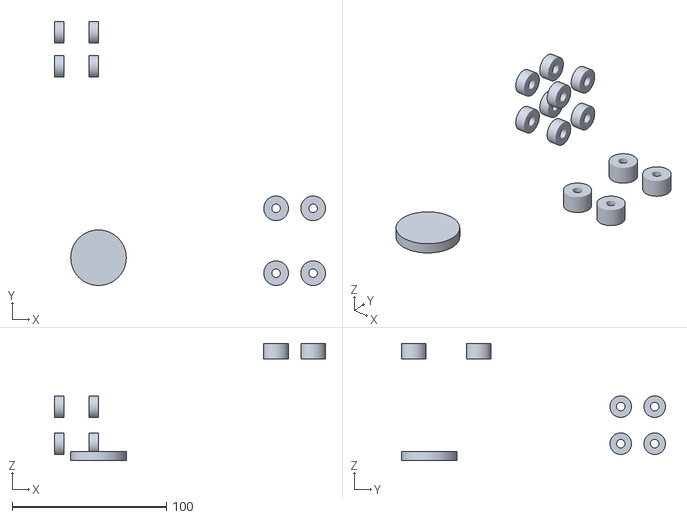
[picture p180: CAD file, 2026-11-14]
parts/box_stand2_base_l_drawn/part.stl
175.5 x 171.0 x 76.0
