sparkiscool/noxen/parts/box_stand2_base_l_room/part.stl

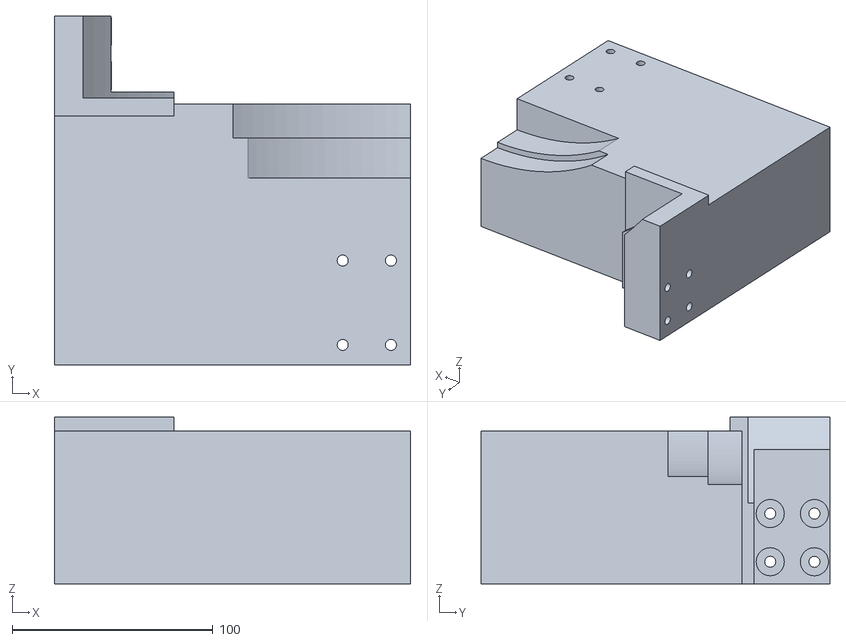
[picture p181: CAD file, 2026-11-14]
parts/box_stand2_base_l_room/part.stl
177.2 x 173.8 x 83.0
