sparkiscool/noxen/parts/box_stand2_foot/part.stl

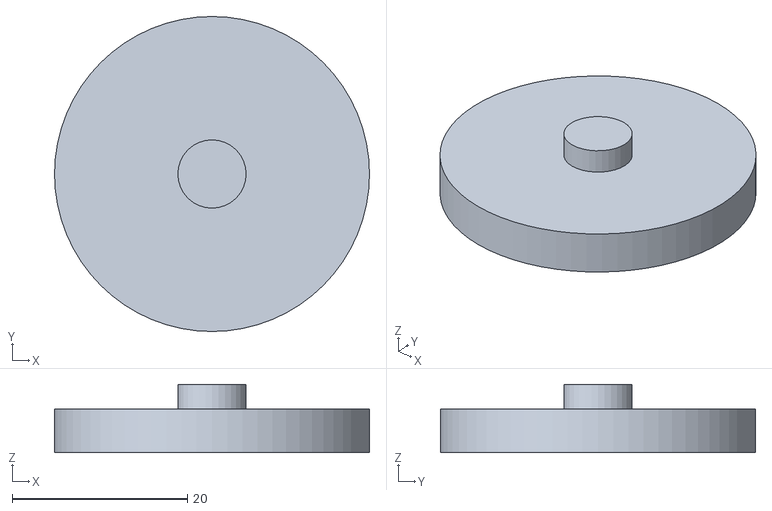
[picture p183: CAD file, 2026-11-14]
parts/box_stand2_foot/part.stl
36.0 x 36.0 x 7.80
