sparkiscool/noxen/parts/box_stand2_mast_drawn/part.stl

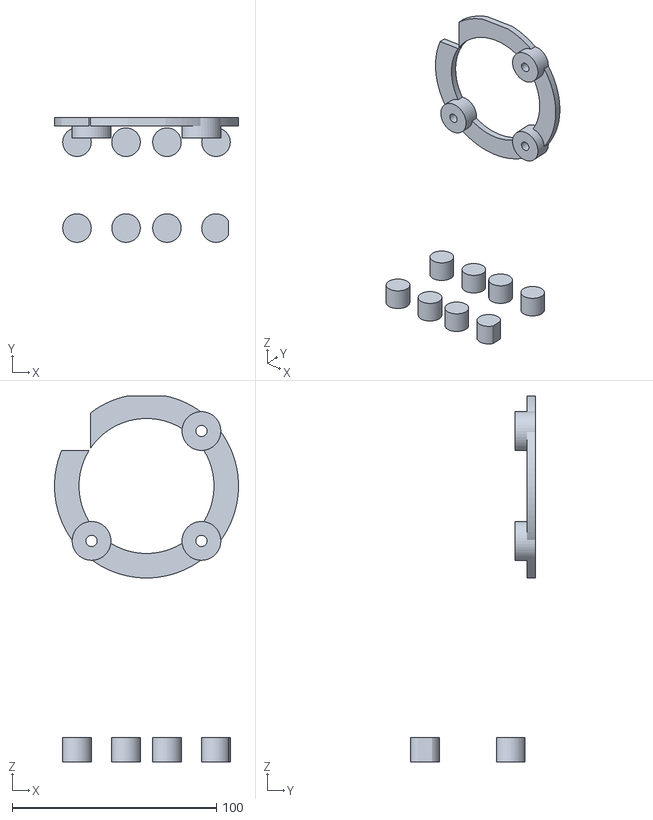
[picture p184: CAD file, 2026-11-14]
parts/box_stand2_mast_drawn/part.stl
90.0 x 61.0 x 179.0
