sparkiscool/noxen/parts/box_stand2_mast_room/part.stl

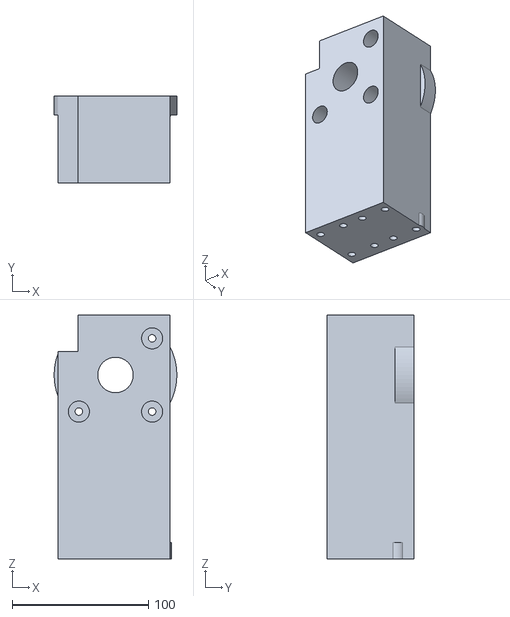
[picture p185: CAD file, 2026-11-14]
parts/box_stand2_mast_room/part.stl
90.0 x 64.0 x 179.0
