sparkiscool/noxen/parts/box_stand2_rail_l_drawn/part.stl

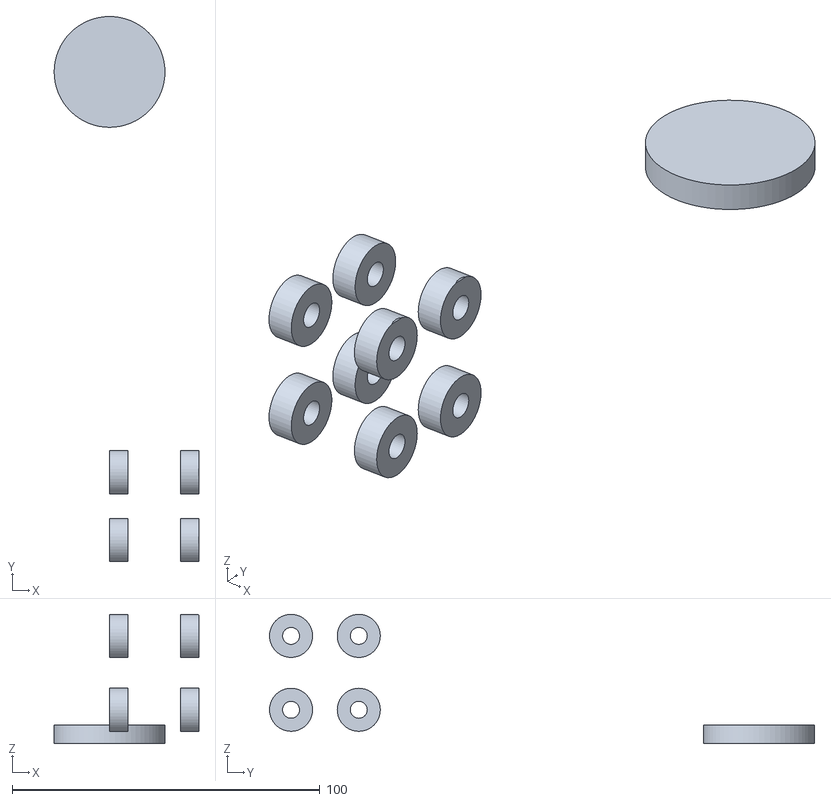
[picture p186: CAD file, 2026-11-14]
parts/box_stand2_rail_l_drawn/part.stl
47.0 x 177.0 x 42.0
