sparkiscool/noxen/parts/box_stand2_rail_l_room/part.stl

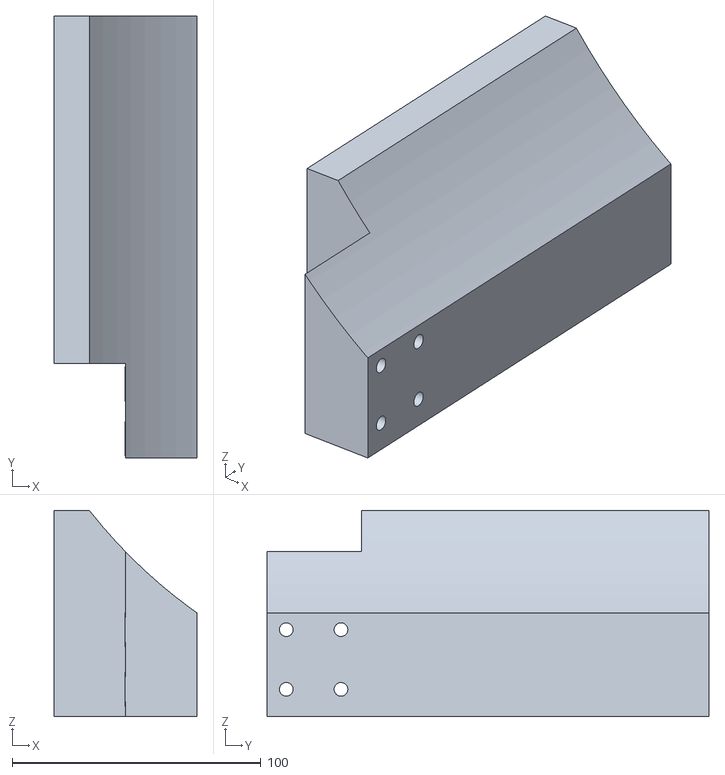
[picture p187: CAD file, 2026-11-14]
parts/box_stand2_rail_l_room/part.stl
57.5 x 177.8 x 83.0
