sparkiscool/noxen/parts/box_stand_bara/part.stl

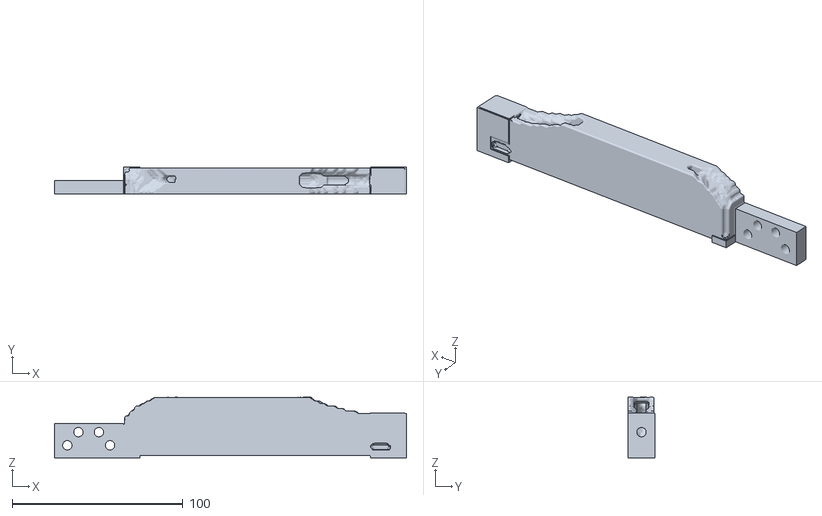
[picture p188: CAD file, 2026-11-03]
parts/box_stand_bara/part.stl
206.0 x 16.0 x 35.4
