sparkiscool/noxen/parts/box_stand_cradle_keel/part.stl

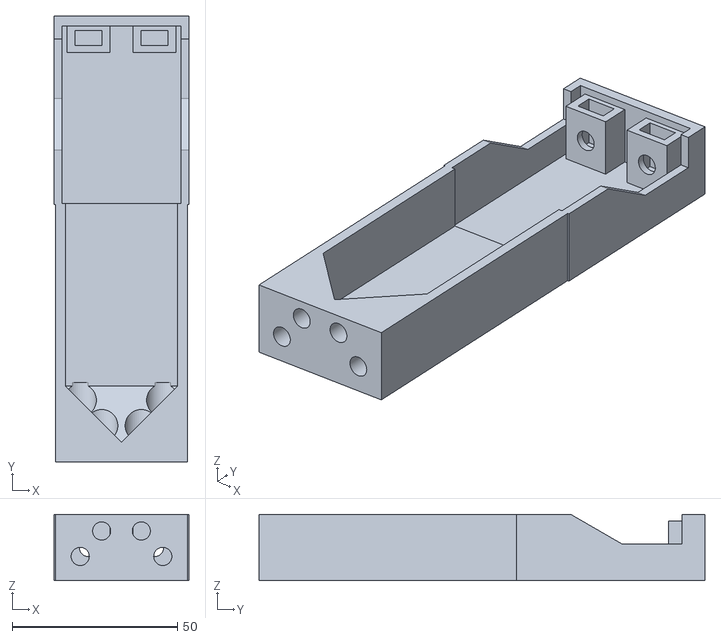
[picture p189: CAD file, 2026-11-14]
parts/box_stand_cradle_keel/part.stl
40.8 x 135.0 x 20.0
