sparkiscool/noxen/parts/box_stand_kb/part.stl

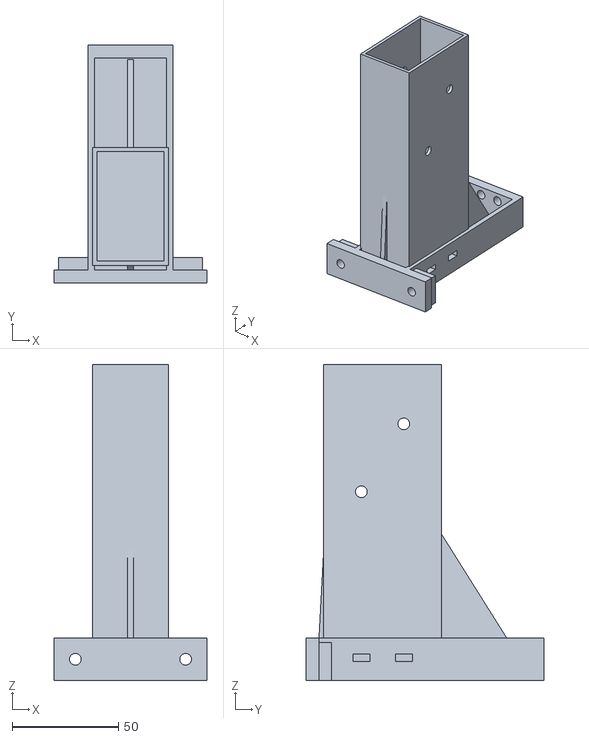
[picture p190: CAD file, 2026-11-03]
parts/box_stand_kb/part.stl
72.0 x 112.0 x 149.0
