sparkiscool/noxen/parts/box_stand_mast/part.stl

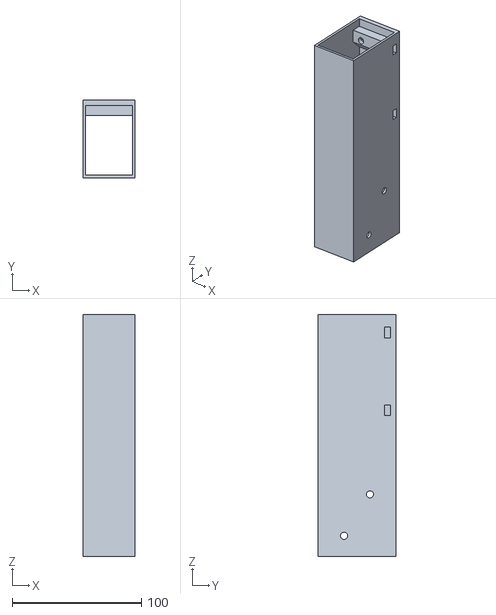
[picture p191: CAD file, 2026-11-14]
parts/box_stand_mast/part.stl
40.0 x 60.0 x 187.0
