sparkiscool/noxen/parts/box_stand_toe/part.stl

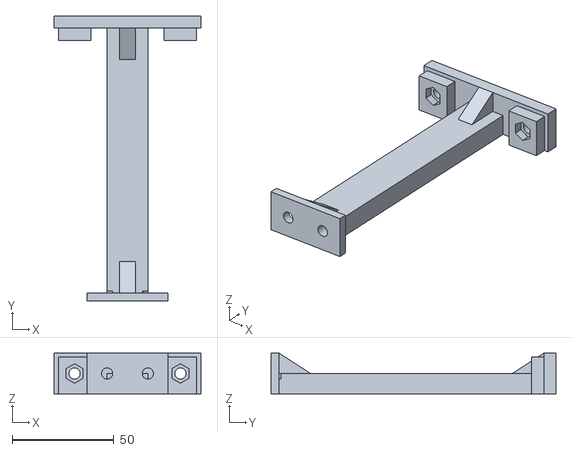
[picture p192: CAD file, 2026-11-14]
parts/box_stand_toe/part.stl
72.0 x 140.0 x 20.0
