sparkiscool/noxen/parts/buck_12_v/part.stl

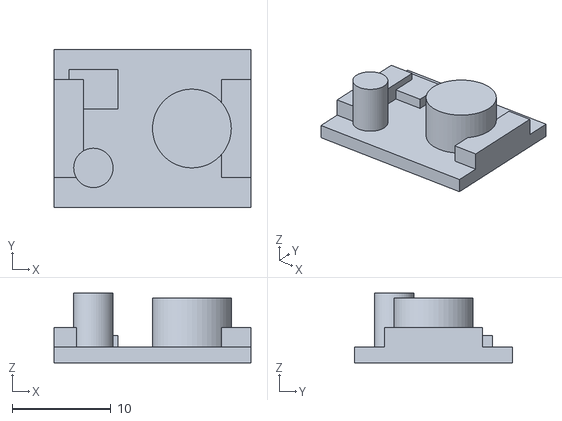
[picture p193: CAD file, 2026-10-30]
parts/buck_12_v/part.stl
20.0 x 16.0 x 7.10
