sparkiscool/noxen/(list of files, cad)

Other CAD files:
parts/arm_3/part.stl
parts/arm_4/part.stl
parts/box_arm_axlesb/part.stl
parts/box_arm_brg1/part.stl
parts/box_arm_bushb/part.stl
parts/box_arm_finga_b/part.stl
parts/box_arm_fingb_b/part.stl
parts/box_arm_gripb/part.stl
parts/box_arm_motor_b/part.stl
parts/box_arm_pin16_b/part.stl
parts/box_arm_railb/part.stl
parts/box_arm_rec60/part.stl
parts/box_arm_rec_120/part.stl
parts/box_arm_rec_180/part.stl
parts/box_arm_rec_210/part.stl
parts/box_arm_rec_30/part.stl
parts/box_arm_rec_60/part.stl
parts/box_arm_servo_b/part.stl
parts/box_arm_shaft_b/part.stl
parts/box_arm_tiesb/part.stl
parts/box_arm_wheelsb/part.stl
parts/box_funnel_wall_tail/part.stl
parts/box_latch7_overseer_receiver/part.stl
parts/box_overseer_bottom_plate/part.stl
parts/box_overseer_camera_right/part.stl
parts/box_overseer_motor_2/part.stl
parts/box_overseer_motor_3/part.stl
parts/box_overseer_motor_4/part.stl
parts/box_overseer_prop_3/part.stl
parts/box_overseer_prop_4/part.stl
parts/box_scout_scout_motor_2/part.stl
parts/box_scout_scout_motor_3/part.stl
parts/box_scout_scout_motor_4/part.stl
parts/box_scout_scout_prop_2/part.stl
parts/box_scout_scout_prop_3/part.stl
parts/box_scout_scout_prop_4/part.stl
parts/box_stand2_base_r_drawn/part.stl
parts/box_stand2_rail_r_drawn/part.stl
parts/box_stand2_rail_r_room/part.stl
archive/parts/box_arm_rec_210/part.stl
archive/parts/box_ctx_cartridge_v6/part.stl
archive/parts/box_ctx_receiver_v3/part.stl
archive/parts/box_scout_scout_cage_v16/part.stl
archive/parts/box_scout_scout_cage_v17/part.stl
archive/parts/box_scout_scout_cage_v18/part.stl
archive/parts/camera/part.stl
archive/parts/camera_mount_printed/part.stl
archive/parts/camera_mount_stop_collar_y/part.stl
archive/parts/cartridge_skid_closed_end_latch_tpu/part.stl
archive/parts/cartridge_skid_lead_end_latch_tpu/part.stl
archive/parts/cartridge_v6_strips_latch_tpu/part.stl
archive/parts/frame_plate_bee35_carbon/part.stl
archive/parts/mount_nose_legs_scout/part.stl
archive/parts/overseer_cage_node_17/part.stl
archive/parts/pack_4s_1500/part.stl
archive/parts/pack_xt60_plug/part.stl
archive/parts/receiver_lid_latch/part.stl
archive/parts/receiver_tpu_end_pieces_latch_e/part.stl
archive/parts/receiver_tpu_strips_latch/part.stl
archive/parts/scan_stick_base/part.stl
archive/parts/scan_stick_cam/part.stl
archive/parts/scan_stick_head/part.stl
archive/parts/scan_stick_thread_test/part.stl
archive/parts/scout_arm_clip_1/envelope.stl
archive/parts/scout_arm_clip_1/part.stl
archive/parts/scout_arm_clip_2/envelope.stl
archive/parts/scout_arm_clip_2/part.stl
archive/parts/scout_arm_clip_3/envelope.stl
archive/parts/scout_arm_clip_3/part.stl
archive/parts/scout_arm_clip_4/envelope.stl
archive/parts/scout_arm_clip_4/part.stl
archive/parts/scout_cage_node_p0_r0/part.stl
archive/parts/scout_cage_node_p1/part.stl
archive/parts/scout_cage_node_p2/part.stl
archive/parts/scout_cage_node_p3/part.stl
archive/parts/scout_cage_node_p4/part.stl
archive/parts/scout_cage_node_p5/part.stl
archive/parts/scout_cage_node_p6/part.stl
archive/parts/scout_cage_node_p7_r7/part.stl
archive/parts/scout_cage_node_pm0/part.stl
archive/parts/scout_cage_node_pm1/part.stl
archive/parts/scout_cage_node_rb/part.stl
archive/parts/scout_cage_node_rf/part.stl
archive/parts/scout_cage_node_rm/part.stl
archive/parts/scout_cage_node_s0/part.stl
archive/parts/scout_cage_node_s1/part.stl
archive/parts/scout_cage_v21/part.stl
archive/parts/scout_camera_mount/part.stl
archive/parts/scout_camera_mount_collar/part.stl
archive/parts/scout_nose_unit/envelope.stl
archive/parts/scout_nose_unit/part.stl
archive/parts/scout_prop_1/part.stl
archive/parts/scout_prop_2/part.stl
archive/parts/scout_prop_3/part.stl
archive/parts/scout_prop_4/part.stl
archive/parts/scout_tail_unit/envelope.stl
archive/parts/scout_tail_unit/part.stl
archive/parts/sensor_head_mount_printed_drawn_bolt_and/part.stl
archive/parts/sensor_head_mount_printed_drawn_seat_lug/part.stl
archive/parts/slider_y_latch/part.stl
archive/parts/spokes_bay_ties_core_ties_camera_guard/part.stl
archive/parts/spokes_ties_keels_braces_head_struts/part.stl
archive/parts/tail_bay_cables_scout_electronics_e/part.stl
archive/parts/tail_bay_carrier_scout_electronics_e/part.stl
archive/parts/tail_bay_mount_block_scout_electronics_e/part.stl
archive/parts/tie_saddle_printed/part.stl
archive/parts/tpu_feet/part.stl
archive/parts/xt60e1_m/part.stl
parts/box_arm8/view/box_arm8_a_blade_n.stl
parts/box_arm8/view/box_arm8_a_blade_p.stl
parts/box_arm8/view/box_arm8_a_blade_rods.stl
parts/box_arm8/view/box_arm8_a_blade_springs.stl
parts/box_arm8/view/box_arm8_a_booms.stl
parts/box_arm8/view/box_arm8_a_carriage.stl
parts/box_arm8/view/box_arm8_a_coupler.stl
parts/box_arm8/view/box_arm8_a_float_bolts.stl
parts/box_arm8/view/box_arm8_a_float_springs.stl
parts/box_arm8/view/box_arm8_a_halls.stl
parts/box_arm8/view/box_arm8_a_lift.stl
parts/box_arm8/view/box_arm8_a_mgn_block.stl
parts/box_arm8/view/box_arm8_a_mgn_rail.stl
parts/box_arm8/view/box_arm8_a_motor.stl
parts/box_arm8/view/box_arm8_a_nut.stl
parts/box_arm8/view/box_arm8_a_paddle.stl
parts/box_arm8/view/box_arm8_a_pads.stl
parts/box_arm8/view/box_arm8_a_pilots.stl
parts/box_arm8/view/box_arm8_a_screw.stl
parts/box_arm8/view/box_arm8_a_servo.stl
parts/box_arm8/view/box_arm8_a_thrust.stl
parts/box_arm8/view/box_arm8_a_ties.stl
parts/box_arm8/view/box_arm8_a_unit_body.stl
parts/box_arm8/view/box_arm8_a_wheels.stl
parts/box_arm8/view/box_arm8_b_blade_n.stl
parts/box_arm8/view/box_arm8_b_blade_p.stl
parts/box_arm8/view/box_arm8_b_blade_rods.stl
parts/box_arm8/view/box_arm8_b_blade_springs.stl
parts/box_arm8/view/box_arm8_b_booms.stl
parts/box_arm8/view/box_arm8_b_carriage.stl
parts/box_arm8/view/box_arm8_b_coupler.stl
parts/box_arm8/view/box_arm8_b_float_bolts.stl
parts/box_arm8/view/box_arm8_b_float_springs.stl
parts/box_arm8/view/box_arm8_b_halls.stl
parts/box_arm8/view/box_arm8_b_lift.stl
parts/box_arm8/view/box_arm8_b_mgn_block.stl
parts/box_arm8/view/box_arm8_b_mgn_rail.stl
parts/box_arm8/view/box_arm8_b_motor.stl
parts/box_arm8/view/box_arm8_b_nut.stl
parts/box_arm8/view/box_arm8_b_paddle.stl
parts/box_arm8/view/box_arm8_b_pads.stl
parts/box_arm8/view/box_arm8_b_pilots.stl
parts/box_arm8/view/box_arm8_b_rail.stl
parts/box_arm8/view/box_arm8_b_screw.stl
parts/box_arm8/view/box_arm8_b_servo.stl
parts/box_arm8/view/box_arm8_b_thrust.stl
parts/box_arm8/view/box_arm8_b_ties.stl
parts/box_arm8/view/box_arm8_b_unit_body.stl
parts/box_arm8/view/box_arm8_b_wheels.stl
parts/box_arm8/view/box_arm8_bay_0_cart.stl
parts/box_arm8/view/box_arm8_bay_0_recv.stl
parts/box_arm8/view/box_arm8_bay_0_saddle.stl
parts/box_arm8/view/box_arm8_bay_120_cart.stl
parts/box_arm8/view/box_arm8_bay_120_recv.stl
parts/box_arm8/view/box_arm8_bay_120_saddle.stl
parts/box_arm8/view/box_arm8_bay_30_cart.stl
parts/box_arm8/view/box_arm8_bay_30_recv.stl
parts/box_arm8/view/box_arm8_bay_30_saddle.stl
parts/box_arm8/view/box_arm8_bay_60_cart.stl
parts/box_arm8/view/box_arm8_bay_60_recv.stl
parts/box_arm8/view/box_arm8_bay_60_saddle.stl
parts/box_arm8/view/box_arm8_bay_m120_cart.stl
parts/box_arm8/view/box_arm8_bay_m120_recv.stl
parts/box_arm8/view/box_arm8_bay_m120_saddle.stl
parts/box_arm8/view/box_arm8_bay_m150_cart.stl
parts/box_arm8/view/box_arm8_bay_m150_recv.stl
parts/box_arm8/view/box_arm8_bay_m150_saddle.stl
parts/box_arm8/view/box_arm8_bay_m180_cart.stl
parts/box_arm8/view/box_arm8_bay_m180_saddle.stl
parts/box_arm8/view/box_arm8_bay_m210_cart.stl
parts/box_arm8/view/box_arm8_bay_m210_recv.stl
parts/box_arm8/view/box_arm8_bay_m210_saddle.stl
parts/box_arm8/view/box_arm8_bay_m30_cart.stl
parts/box_arm8/view/box_arm8_bay_m30_recv.stl
parts/box_arm8/view/box_arm8_bay_m30_saddle.stl
parts/box_arm8/view/box_arm8_bay_m60_cart.stl
parts/box_arm8/view/box_arm8_bay_m60_recv.stl
parts/box_arm8/view/box_arm8_bay_m60_saddle.stl
parts/box_arm8/view/box_arm8_bay_m90_cart.stl
parts/box_arm8/view/box_arm8_bay_m90_recv.stl
parts/box_arm8/view/box_arm8_bay_m90_saddle.stl
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
