sparkiscool/noxen/parts/rod_saw_guide/preview.png

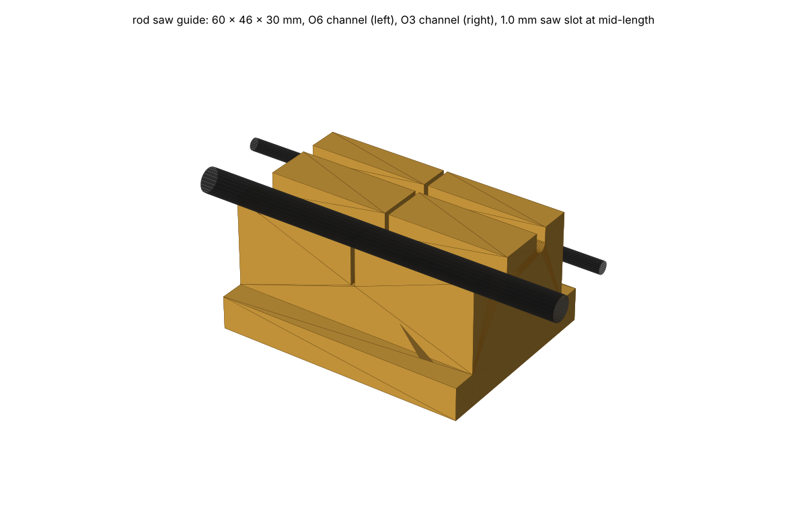
parts/rod_saw_guide/preview.png
