sparkiscool/noxen/parts/scout_node_lib.py

"""Scout cage node setups, one generator for every printed node (4 Nov, Spark: "generate the nodes for the cage"; 8 Nov: cage v21, the half cage, 19 nodes, 17 printed in 15 structures), after the
Overseer's parts/cage_node_lib.py (28 Oct: "nodes dont look like topology, sharp corners, not organic").

Drawn: ONLY the socket walls and floors (a collar of 3.0 round each bore, 3.0 floor behind it). Everything joining them is generated
inside a compact envelope (a strut round each member and a hub ball). The rods themselves are cuts through the whole envelope, and so
is the shared funnel swept over the whole descent (funnel_sweep): no node may grow toward the funnel's walls. No node lands: the half
cage (v21) stands on the base units' runners, so the skid nodes' landing faces, landing and ground-hit cases went with them (the
runners carry the ground hit now, parts/scout_units_lib.catch_cases).

Members of node k come from tools/scout_cage.py: the cage rods (every one 3.0 solid carbon: bore 3.2, 10 deep, 3.0 floor) and the
ties that end at k. Socket axis = the direction from the node centre to the member's far end; the bore starts NODE_R (7, the
cage model's sphere) from the centre, or further out where two members meet at a small angle so every bore clears its neighbours
by WALL (the rod is cut shorter by the same amount; check_members is exact). Every bore the coupon socket plus the
injection pattern (parts/socket_inject.py: a 0.5 annulus on 3 lands, a feed ring, a O2 fill port and a O1.5 vent out the side port_dir
chooses; Spark 5 and 8 Nov). NB and TB are printed into the nose and tail units, not here.

Loads (drone frame, N; frame model F = systems/scout.cage_loads.json node_loads, tools/scout_cage_loads.py): per member its axial
force as a pull-out along the socket axis and its side force across it as separate cases ("crash"), the longest rod pushed into its
socket as a combined case.
Supports: the sockets of the two members with the largest frame-model axial force (the stiffest load paths).
Run: parts/scout_cage_node_<key>/part.py -> setup(h) = make("<key>")."""
import json, os, sys
import numpy as np
from topo import Part
from topo.part import man
from parts.cage_node_lib import collar_shape, along, U, GROOVE_D, port_dir, PORT_R
from parts.socket_inject import injectable_socket_cuts, FEED_H

HERE = os.path.dirname(os.path.abspath(__file__))
ROOT = os.path.dirname(HERE)
sys.path.insert(0, os.path.join(ROOT, "tools"))
import scout_cage as sc                                   # noqa: E402

LOADS = json.load(open(os.path.join(ROOT, "systems", "scout.cage_loads.json")))["node_loads"]
P = {**sc.NODES, **sc.TIE_ROOTS}
KEYS = [k for k in sc.NODES if k not in sc.PRINTED]      # the 19 printed nodes, in sc.GROUPS printed structures (a pair closer than sc.MERGE_MM is one part)
BRIDGE_R = 6.0                                            # the room round a printed bridge between two merged nodes (O12, the engine keeps what the rod's load needs)
NODE_R = 5.0                                              # where a bore starts unless a neighbour forces it out (5 Nov: 7 -> 5, the collars 2 mm closer in, every strut 2 mm shorter; the cage model's sphere stays 7)
MAX_START = 25.0                                          # a bore pushed further out than this by a near-parallel neighbour makes the node a fork (5 Nov: the arm and yoke ties met
#   at each rail corner 2..13 deg apart, bores from 39..85 mm, nodes of 290k..586k cells; the yoke ties now end at the rail mid nodes)
WALL, FLOOR, STRUT_M = 3.0, 3.0, 4.0                        # 8 Nov (the Overseer's nodes the same): WALL 3.0 = 2.5 beyond the 0.5 injection annulus (7 Nov: at 2.0 every collar was 1.5 at its grooves, the audit's drawn_wall refuses it); FLOOR 3.0, the feed ring cuts 0.5 into it; STRUT_M 4.0 of room round the collar (3.0 with the 3.0 collars put PM0 / RM at 30 / 34 % drawn, the audit's limit)
LINING_BACK = FLOOR + 0.5                                 # where a socket's support / load region starts behind the bore floor; FLOOR + 0.5 reaches 0.5 into the room
#   behind the collar: a rigid disc the generated material is joined to (9 Nov, the v4 Ys: worst 0.27-0.32 at its rim in every one,
#   unmoved by +36 % budget). 0.0 = the bore only, where the rod bears (the v4 nodes); the v3 nodes keep their setups
BETWEEN_WALL = None                                       # the wall left between two near-parallel bores' grooves where they start; None = WALL
DRAWN_WALL = None                                         # the drawn collar's wall (a number, or a function of the member); None = WALL. The room, clearances and ports always use WALL, so a thinner
#   drawn wall (the v4 nodes, 9 Nov) leaves the engine the same strut to grow the root in where the load needs it
STRUT_BACK, KEEP_OFF = 0.0, 0.0                           # the strut's room ends STRUT_BACK short of the collar's mouth, the keep-out round the rod starts KEEP_OFF past it
#   (0, 0: both on the mouth plane, with the collar's end face; the v4 nodes move them off it, 10 Nov)
MOUTH_R, COLLAR_PAST = None, 0.0                          # MOUTH_R: a cut of this radius from each mouth plane out along the rod (other collars spared), so every
#   mouth is one exact cut face through collar and barrel alike; the collar is drawn COLLAR_PAST into it. None = off (the v3 nodes)
ROD_R, ROD_GAP = 1.5, 1.0                                # a passing rod's radius and the least gap to a collar's surface
BORE_R, DEPTH = 1.6, 10.0                                 # 3.0 rod: bore 3.2, 10 deep (coupons v2)
CAGE_CENTRE = (0.0, 0.0, 10.0)                            # ports point away from here (out of the cage) where the members allow
GN = 9.81e-3


def _raw_members(k, bridges=False):
    """the rods and ties that end at node k and get a socket there: the bridges (sc.BRIDGES, the rod to a node merged into the same
    printed structure) are printed, not socketed, but they still take their room in the hub (bridges=True: the socket-start rule
    counts them, so a bridged node's sockets sit where they did; 5 Nov: with P0-R0 bridged, P0-P1's bore came in from 17 to 8.5 and
    its collar's mouth landed in the K0-R0 brace rod)"""
    c = np.array(P[k], float); out = []
    for a, b in (sc.RODS if bridges else sc.RODS_CARBON) + sc.TIES:
        if k in (a, b):
            o = b if a == k else a
            out.append(dict(name=f"{a}-{b}", far=np.array(P[o], float), other=o if o in sc.NODES else None))
    for m in out:
        d = m["far"] - c; m["len"] = float(np.linalg.norm(d)); m["u"] = d / m["len"]; m["bore_r"], m["depth"] = BORE_R, DEPTH
    return out


def _seg_dist(a0, a1, b0, b1):
    """the least distance between two segments"""
    u, v = a1 - a0, b1 - b0; A, C = u @ u, v @ v
    best = 1e9
    for t in np.linspace(0, 1, 41):                         # sample one segment, project onto the other (exact enough at 1/40 of a rod)
        q = b0 + t * v; s_ = np.clip((q - a0) @ u / A, 0, 1)
        best = min(best, float(np.linalg.norm(a0 + s_ * u - q)))
    for s_ in np.linspace(0, 1, 41):
        q = a0 + s_ * u; t = np.clip((q - b0) @ v / C, 0, 1)
        best = min(best, float(np.linalg.norm(b0 + t * v - q)))
    return best


def _socket_starts():
    st = {}
    for k in sc.NODES:
        ms = _raw_members(k, bridges=True)
        for m in ms:
            s0 = NODE_R
            for o in ms:
                if o is m:
                    continue
                t = float(np.arccos(np.clip(m["u"] @ o["u"], -1.0, 1.0)))
                if t < 1e-6:
                    continue
                s0 = max(s0, (m["bore_r"] + o["bore_r"] + 2 * GROOVE_D + (WALL if BETWEEN_WALL is None else BETWEEN_WALL)) / (2.0 * np.sin(t / 2.0)))
            st[(k, m["name"])] = float(np.ceil(s0 * 10.0) / 10.0)
    return st


SOCKET_START = _socket_starts()


def members(k):
    out = _raw_members(k); loads = LOADS.get(k, {})
    for m in out:
        m["s0"] = SOCKET_START[(k, m["name"])]
        m["s0_far"] = SOCKET_START.get((m["other"], m["name"]), NODE_R) if m["other"] else NODE_R
        m["axial"] = loads.get(m["name"], {}).get("axial"); m["side"] = loads.get(m["name"], {}).get("side")
        m["moment"] = loads.get(m["name"], {}).get("moment", 0.0); m["moment_axis"] = loads.get(m["name"], {}).get("moment_axis", (0.0, 0.0, 0.0))
    return out


def check_members(k, log=print):
    c, ms, bad = np.array(P[k], float), members(k), []
    bridged = {f"{a}-{b}" for a, b in sc.BRIDGES}
    names = {m["name"] for m in ms}; loads = set(LOADS.get(k, {})) - bridged
    if names != loads:
        bad.append(f"frame model members differ: no load for {sorted(names - loads)}, no member for {sorted(loads - names)}")
    for m in ms:
        if m["other"] is None:
            continue                                      # a tie: its far end is a clip or a unit, which bores it itself
        back = [x for x in members(m["other"]) if x["name"] == m["name"]]
        if len(back) != 1:
            bad.append(f"{m['name']}: no socket at node {m['other']}"); continue
        if not np.allclose(back[0]["u"], -m["u"], atol=1e-9):
            bad.append(f"{m['name']}: the two sockets are not on one axis")
        if m["len"] - m["s0"] - m["s0_far"] < 2 * m["depth"] - 1e-6:
            log(f"  note: {m['name']} is {m['len']:.0f} long: its two {m['depth']} mm bores nearly meet")
    for i, a in enumerate(ms):
        for b in ms[i + 1:]:
            t = np.arccos(np.clip(a["u"] @ b["u"], -1, 1)); r = max(a["s0"], b["s0"])
            if 2 * r * np.sin(t / 2) < a["bore_r"] + b["bore_r"] + 2 * GROOVE_D + (WALL if BETWEEN_WALL is None else BETWEEN_WALL) - 1e-6:
                bad.append(f"{a['name']} / {b['name']}: {np.degrees(t):.0f} deg apart, bores overlap at {r:.1f} mm")
    for m in ms:                                              # a rod that passes this node must clear every collar (5 Nov: K0-R0 through P0-P1's mouth)
        a0, a1 = c + m["u"] * (m["s0"] - FLOOR), c + m["u"] * (m["s0"] + m["depth"])
        for i, j in sc.RODS + sc.TIES:
            if k in (i, j):
                continue
            gap = _seg_dist(a0, a1, np.array(P[i], float), np.array(P[j], float)) - (m["bore_r"] + WALL) - ROD_R
            if gap < ROD_GAP:
                bad.append(f"{m['name']}: the rod {i}-{j} passes {gap:.1f} mm from its collar (need {ROD_GAP}): move the socket out or re-route the rod")
    far = [f"{m['name']} from {m['s0']:.1f}" for m in ms if m["s0"] > NODE_R + 1e-6]
    if far:
        log(f"  sockets moved out so no bores overlap: {', '.join(far)} mm (others from {NODE_R})")
    for m in ms:
        if m["s0"] > MAX_START:
            bad.append(f"{m['name']}: its bore starts {m['s0']:.0f} mm out to clear a near-parallel neighbour (limit {MAX_START:.0f}): a fork, not a node; retarget one of the two members")
    if bad:
        raise ValueError(f"node {k}: " + "; ".join(bad))
    return ms


def verify_cuts(k, ms, cuts, log=print):
    import manifold3d as mf
    c = np.array(P[k], float)
    def inside(p):
        t = mf.Manifold.sphere(0.25, 8).translate(p.tolist()); return (cuts ^ t).volume() > 0.9 * t.volume()
    for m in ms:
        for s in (m["s0"] + 0.5, m["s0"] + m["depth"] / 2, m["s0"] + m["depth"] - 0.5):
            if not inside(c + m["u"] * s):
                raise ValueError(f"node {k}: {m['name']} bore not cut at {s:.1f} mm from the node centre")
        if inside(c + m["u"] * (m["s0"] - FLOOR / 2)):
            raise ValueError(f"node {k}: {m['name']} floor is cut")
        if "port_d" in m and not inside(c + m["u"] * (m["s0"] + FEED_H / 2) + m["port_d"] * (m["bore_r"] + WALL + 0.5)):
            raise ValueError(f"node {k}: {m['name']} injection port is not open through the collar wall")
    log(f"  members check: {len(ms)} sockets, every member lands in a bore of node {k}")


_SWEEP = {}


def funnel_sweep():
    """the shared funnel as the drone sees it over the whole descent (tools/seat_check.descent_states: the capture limits, heights every
    3..5), each state also shifted +-1.5 in x and y for margin, all unioned: a keep-out no node may grow into (4 Nov: the first descent
    gate on the node placeholders had the skid nodes' boxes in the funnel's y walls at the -y capture limit)"""
    if "m" not in _SWEEP:
        import manifold3d as mf, trimesh, seat_check as skc
        fun = man(trimesh.load(os.path.join(ROOT, "parts", "box_funnel", "part.stl")))
        copies = []
        for lab, ox, oy, hh in skc.descent_states("scout"):
            for dx, dy in ((0, 0), (1.5, 0), (-1.5, 0), (0, 1.5), (0, -1.5)):
                copies.append(fun.translate([-ox + dx, -oy + dy, -hh]))
        _SWEEP["m"] = mf.Manifold.batch_boolean(copies, mf.OpType.Add)
    return _SWEEP["m"]


def build(group, h, log=print):
    """one printed structure: the node(s) of group (a key, or sc.GROUPS' tuple of keys bridged together), each with its collars, struts and
    hub, a printed bridge's room between merged nodes"""
    import manifold3d as mf
    group = (group,) if isinstance(group, str) else tuple(group)
    collars, bores, keep, struts, allm = [], [], [], [], []
    for k in group:
        ms = check_members(k, log); c = np.array(P[k], float)
        for m in ms:
            ro = m["bore_r"] + WALL; s_end = m["s0"] + m["depth"]
            m["wall_d"] = WALL if DRAWN_WALL is None else (DRAWN_WALL(m) if callable(DRAWN_WALL) else DRAWN_WALL)
            collars.append(collar_shape(c, m["u"], m["s0"] - FLOOR, s_end + (COLLAR_PAST if MOUTH_R else 0.0), m["bore_r"], m["wall_d"]))
            keep.append(along(c, m["u"], s_end + KEEP_OFF, s_end + 60.0, m["bore_r"] + 0.6))
            m["ro"], m["s_end"], m["node"], m["c"] = ro, s_end, k, c
            allm.append(m)
        # the envelope: a strut round each member from the node's centre to its collar's mouth (STRUT_M of room round the collar) and a
        # hub ball at the centre, so the engine only decides how much of each strut to keep: a node, not a web (5 Nov, Spark: run 1's
        # nodes, grown in a ball to 56 mm across, were spindly blobs of webs between far-apart collars)
        struts += [along(c, m["u"], 0.0, m["s_end"] - STRUT_BACK, m["ro"] + STRUT_M) for m in ms]
        struts.append(mf.Manifold.sphere(NODE_R + WALL + STRUT_M, 48).translate(c.tolist()))
    bridge_u = {}
    for a, b in sc.BRIDGES:                                                     # the printed bridge between two merged nodes: its room, the whole span
        if a in group and b in group:
            ca, cb = np.array(P[a], float), np.array(P[b], float); d = cb - ca; L = float(np.linalg.norm(d))
            struts.append(along(ca, d / L, 0.0, L, BRIDGE_R)); bridge_u[a] = d / L; bridge_u[b] = -d / L
    env = U(struts)
    if MOUTH_R:                                                                 # the mouth cuts, each clear of every other collar by 0.5
        for m in allm:
            spare = [collar_shape(o["c"], o["u"], o["s0"] - FLOOR - 0.5, o["s_end"] + COLLAR_PAST + 0.5, o["bore_r"], o["wall_d"] + 0.5)
                     for o in allm if o is not m]
            slab = along(m["c"], m["u"], m["s_end"], m["s_end"] + 60.0, MOUTH_R, 64)
            keep.append(slab - U(spare) if spare else slab)
    # resin injection ports (Spark 5 Nov): one O2 channel per socket from the bore 1.5 above its floor out through the collar wall and the
    # strut, as near outward from the cage as the members allow (none within 40 deg), its channel clear of the other collars
    ports = []
    for m in allm:
        k, c = m["node"], m["c"]
        others = [o["u"] for o in allm if o["node"] == k and o is not m] + ([bridge_u[k]] if k in bridge_u else [])
        blockers = [(o["c"] + o["u"] * (o["s0"] - FLOOR), o["c"] + o["u"] * o["s_end"], o["ro"]) for o in allm if o is not m]
        prefer = c - np.array(CAGE_CENTRE, float); prefer /= np.linalg.norm(prefer)
        m["port_d"] = port_dir(m["u"], prefer, others, blockers, origin=c + m["u"] * (m["s0"] + FEED_H / 2), clear_r=PORT_R + 0.5, log=log)
        bores += injectable_socket_cuts(c, m["u"], m["s0"], m["depth"], m["bore_r"], port=m["port_d"])   # bore, grooves, lead-in, crown + the injection pattern (parts/socket_inject.py:
        #   0.5 annulus with 3 lands, feed ring 0.5 into the floor, O2 fill port and O1.5 vent 40 out on the side port_dir chose; the Overseer's nodes the same, 8 Nov)
    drawn = U(collars); cuts = U(bores + keep + [funnel_sweep()])   # the funnel's sweep: no growth toward it
    for k in group:
        verify_cuts(k, [m for m in allm if m["node"] == k], cuts, log)
    p = Part(sc.group_id(group), h, drawn, cuts, env, build="+z", material="PCTG")   # printed in PCTG (CLAUDE.md 8 Nov), topo/material.py E numbers until a coupon
    sup = [m for k in group for m in sorted([x for x in allm if x["node"] == k], key=lambda m: -m["axial"])[:2]]   # the two stiffest members at EACH node (7 Nov: with two for the pair, every pull at the other node ran through the bridge: P2+P3 1.40 in the bridge)
    lining = lambda m, grow=1.0: along(m["c"], m["u"], m["s0"] - LINING_BACK, m["s_end"], m["bore_r"] + grow)
    p.support("default", U([lining(m, 1.4) for m in sup])); held = {(m["node"], m["name"]) for m in sup}
    log(f"  supports: {sorted(n for _, n in held)}")
    for m in allm:
        if (m["node"], m["name"]) in held:
            continue
        p.load_multi(f"frame {m['name']} axial {m['axial']:.0f} N (pull-out)", [(lining(m), m["axial"] * m["u"])], cls="crash")
        side = np.cross(m["u"], [0, 0, 1.0] if abs(m["u"][2]) < 0.9 else [1.0, 0, 0]); side /= np.linalg.norm(side)
        if not m.get("moment"):
            p.load_multi(f"frame {m['name']} side {m['side']:.1f} N", [(lining(m), m["side"] * side)], cls="crash")
            continue
        # 14 Nov: the rod's end moment (frame model, N mm) as a couple across the bore: the lining in thirds, the side force a third on each
        # and in the moment's plane, +Fc on the mouth third, -Fc on the floor third (Fc = M x u / lever, the thirds' centres apart); both signs
        a0, a1 = m["s0"] - LINING_BACK, m["s_end"]; L3 = (a1 - a0) / 3.0
        th = [along(m["c"], m["u"], a0 + i * L3, a0 + (i + 1) * L3, m["bore_r"] + 1.0) for i in range(3)]
        Fc = np.cross(m["moment"] * np.asarray(m["moment_axis"], float), m["u"]) / (2.0 * L3)
        w = Fc / np.linalg.norm(Fc) if np.linalg.norm(Fc) > 1e-6 else side
        for sg, lab in ((1, "+"), (-1, "-")):
            F = sg * m["side"] * w; c_ = sg * Fc
            p.load_multi(f"frame {m['name']} side {m['side']:.1f} N + end moment {m['moment']:.0f} N mm ({lab})",
                         [(th[0], F / 3 - c_), (th[1], F / 3), (th[2], F / 3 + c_)], cls="crash")
    L = max(allm, key=lambda m: m["len"])
    if (L["node"], L["name"]) not in held:
        sd = np.cross(L["u"], [0, 0, 1.0] if abs(L["u"][2]) < 0.9 else [1.0, 0, 0]); sd /= np.linalg.norm(sd)
        p.load_multi(f"crash 35 g through the longest rod {L['name']} ({L['len']:.0f} mm), axial + side", [(lining(L), -L["axial"] * L["u"] + L["side"] * sd)], cls="crash")
    return p


def make(group):
    return lambda h: build(group, h)


MEMBER_MM = 6.25                                          # the engine's member floor at the gate's 2.0 mm erosion (topo.layout.gate_member_mm: 2 x 2.0 + 2.25)


def skeleton_cm3(group):
    """the least generated volume that joins every collar of the structure: a member of MEMBER_MM from the node's centre to each
    collar's mouth, the members' overlap at the centre (the first NODE_R of all but one) taken out, plus a bridge of the same
    section between merged nodes"""
    group = (group,) if isinstance(group, str) else tuple(group)
    A = np.pi * (MEMBER_MM / 2) ** 2; v = 0.0
    for k in group:
        ms = members(k)
        v += A * (sum(m["s0"] + m["depth"] for m in ms) - (len(ms) - 1) * NODE_R)
    for a, b in sc.BRIDGES:
        if a in group and b in group:
            v += float(np.linalg.norm(np.array(P[a], float) - np.array(P[b], float))) * A
    return v / 1000.0


def spec_for(group):
    """SPEC per structure (8 Nov, the Overseer's node rules): limit 0.3 (printed PETG broke at 0.30 of the engine's strength on the arms,
    so 0.3 is the real margin) and the budget x1.4 with it: 1.54 x the skeleton (5 Nov: 1.1 x; at a flat 2 cm3 the strut singles came in
    half-filled with flakes and an unjoined collar; the budget a node needs is what its members weigh at the gate's 6.25 floor). No node
    of the half cage lands (v20's skid nodes took the ground hit at limit 0.2 and twice the budget). h 1.0 a single, 1.2 a pair (a 57 mm
    pair was 230k cells at 1.0). Never settings=dict(min_member_mm): it clashes with the run's own argument; the layout lifts the member
    to 6.25 on its own."""
    group = (group,) if isinstance(group, str) else tuple(group)
    return dict(h=1.0 if len(group) == 1 else 1.2, gen_cm3=round(1.1 * 1.4 * skeleton_cm3(group), 1), max_worst=0.3)


SPEC = dict(h=1.0, gen_cm3=2.0, max_worst=0.5)            # the flat spec of the 5 Nov strut run (kept for the record; the parts use spec_for)
