sparkiscool/noxen/tools/scout_v4_shape.py

"""Scout v4, the shape design (8 Nov, Spark: "we are going to start on scout v4, should have new props meaning we are no longer using
the bee35 plate and will be printing everything ourselves with pctg, we also need to make sure it still fits inside the landing
funnel for the battery swapper, lets first create a shape design for that"). A layout of envelopes and bought parts, not engine
setups: what sits where, how big the printed frame is, and that it seats in the shared funnel. Drone frame = the seat frame of
tools/seat_envelope.py (x nose, y left, z up; the receiver's bottom at z -44.3 on the funnel's ledge).

What sets the shape, and only this:
  props    Gemfan Hurricane SL 5125, 5.1 in (O129.4, r 64.7; systems/dimensions.md A, Spark 8 Nov) on the same EMAX ECO II 2004
           motors, hubs at (+-74.3, +-74.3): the 3520's 19.2 tip gap kept between neighbours (2 x 74.3 - 129.4), wheelbase 210
  frame    printed PCTG, no bought plate: a deck where the Bee35 was (underside z 18.5, the units bolt up into it as they did into
           the plate), 6 thick (E, until the engine sizes it), four arms out to motor pods at the hubs; the motors on the pods, the
           prop plane DECK_TOP + 19.2 (the 2004's listing height, as on v3)
  battery  unchanged, so the swapper takes the v3 pack: the Overseer receiver v3 under the deck, the cartridge v6 and the 4S 1500
           in it, at the v3 place in the seat frame (x -51.3..54.3, |y| 32.8, z -44.3..9.6)
  funnel   the shared funnel seats the Scout on its receiver alone (9 Nov, Spark: "seat the scout on the receiver alone"; the box
           session moves the funnel's end walls in): below z -4.3 nothing outside the 55 deg faces rising from the receiver's outline
           (zmin_walls_in + 2). So no runners or keel: the base (one body with the deck, 9 Nov) is the yokes over the receiver (the FC,
           the Radxa, the XR2, the DRV8833 under the deck), a nose block and the flow sensor's pod, a tail tray (the UBEC); four TPU feet on the receiver's bottom corners are the foot on flat
           ground and four bare pads meet the box's keep-alive probes. Gate: tools/seat_check.py scout_v4 --descent (walls in)
  camera   ONE camera (9 Nov, Spark: the probe is the front camera too, colour; bought: the Arducam 12MP autofocus USB camera,
           B0FLX58WKZ): 1/2.43" colour, IR-cut, AF 3.95 mm f/1.8 focusing 10 cm to inf (settable over UVC), 75 D / 61 H / 50 V deg,
           MJPG 4608 x 2592 at 15 fps, 1080p at 30, USB 2.0 UVC (the Radxa Zero 3W's Linux takes it with no driver); 45 g in its
           metal case, flown without it (the bare board ~32 square and ~12 g: E, measure on arrival). On an SG90 tilt servo, parked
           on the probe's throat, it is the front camera, its frame clear of every rod and disc; rolled out it is the ceiling probe
  probe    the mast is two 19 mm steel tape blades with their curves facing (a lens-shaped tube, the spacecraft bi-STEM idea: each
           braces the other's easy fold), 0.15 m out (Spark 9 Nov: as short as is safe; was 0.3), 19 mm blades (Spark 9 Nov: "as safe as possible", was 10); both blades and the 8-way flat cable between them wind on one spool (axis y,
           O34) under the roof where the FC sat; an N20 300 rpm with encoder lies in a pocket in the deck, under the props' keep-out
           band, and turns the spool through a printed 15 / 40 T pair (module 0.8); the flat cable reaches the fixed side through a
           300 mm clock-spring spiral in a drum beside the spool (no slip ring); the blades leave the spool's +x side through a 30
           mm throat that forms the lens, up beside the roof's middle node (a ring, r 22..34), the mast's axis at x 17.5
  flow     MTF-02P in the nose runner's window looking down, as v3 (70, 0, -24.5)
  tail     Radxa Zero 3W, UBEC, XR2 in the tail unit's bay over the tail runner, as v3; the FC on top of the deck at the centre
  cage     a half cage of 3.0 carbon rods only (Spark 8 Nov: keep the 3 mm, the cage's structure first, nodes later). Every rod
           12 from the swept discs (r 64.7 + 4, z prop plane +- 4): the octagon ring tangent to that keep-out (flats at |x|, |y|
           155, chamfers on |x| + |y| = 262.7) at z 61 (13 over the sweep); a FLAT roof in the ring's plane: a spine on y 0 and a
           hoop on x 0 (never over a disc) with the nose and tail triangles from RF / RB at x +-130 (at x 90 they crossed the front
           discs); a V up to the ring at each end and a fan at each side from four bottom nodes at z 12 in the flats' planes (every
           point there 12 from the discs). How the cage holds the core, with no long printed outriggers (8 Nov, Spark: "the solids
           that extend out do not seem optimal at all"): rods rising past the props can only stand in the flats' planes, and rods
           from the body out to them only in the strips between the discs (x 0 and y 0), so each side node S0 / S1 hangs on a rod
           triangle on x 0 to two sockets on a small lug on the deck's side (0, +-40, z 22 and -10, beside the receiver), the tail
           node TB on a triangle on y 0 to the deck's tail end (-60, 0, 21) and the tail runner's end (-90.5, 0, -2), and the nose
           node NB sits on a stub of the base out to the front flat (a rod triangle there put one rod at 0.84 x Euler). Why (frame model, frame_check): on ties under the arm tips (v21's way) the 35 g load went through level rods in
           bending (31 mm, 2 rods over Euler); a ridge 12 over the ring took the upside-down hit alone (1.3 x Euler); the four
           printed outriggers of the first try passed (1.0 mm) but put 115 mm spars and a tail boom on the frame, modelled rigid.
           Bottom open, the Scout lands on the runners
Writes parts/scout_v4_<part>/part.stl (one folder per v4 part, build_site: a folder belongs to one drone), systems/scout_v4.assembly.json
and prints the checks. Run: python tools/scout_v4_shape.py
"""
import json, math, os, sys
import numpy as np, trimesh

ROOT = os.path.dirname(os.path.dirname(os.path.abspath(__file__)))
sys.path.insert(0, os.path.join(ROOT, "tools"))

# ---- props, motors, frame ---------------------------------------------------------------------------------------------------
PROP_D, HUB = 129.4, 74.3                       # Gemfan 5125 (dimensions.md A), hubs at (+-HUB, +-HUB)
PROP_R = PROP_D / 2
MOTORS = [(HUB, -HUB), (-HUB, HUB), (HUB, HUB), (-HUB, -HUB)]   # PX4 quad X: motor 1 front right, 2 rear left, 3 front left, 4 rear right
DECK_Z0, DECK_T = 18.5, 6.0                     # the deck's underside where the Bee35's was; 6 thick (E)
DECK_TOP = DECK_Z0 + DECK_T
MOTOR_H = 19.2                                   # ECO II 2004: arm top to the prop hub face (listing, E; dimensions.md C)
Z_PROP = DECK_TOP + MOTOR_H                     # 43.7
R_KEEP, Z_SWEEP = PROP_R + 4.0, 4.0             # the disc grown 4 and swept +-4 (the cage rule's disc, as v3)
KEEP = 12.0                                      # every rod 12 from the swept disc
DECK = (-60.0, 60.0, 40.0)                       # the deck's body: x0, x1, |y| (E), arms from its corners to the pods
ARM_W, POD_R = 18.0, 15.0                        # arm width, motor pod radius (the 2004's base O27 + 1.5)
UBEC_LO = (-70.5, -11.0)                           # 11 Nov (run of 0dd1778: BT-TB 0.76, the room filled solid 0.255): the UBEC lay across the tail tray at BT's own
                                                   # height (z 0.3..8.3, |y| 30.5) and its leads cut the 3 mm beside it: BT's 581 N had 4.5 mm of room behind its floor.
                                                   # Now it hangs under the tray in a pod (z -11..-3, its bottom on zmin_walls_in + 2 at x -70.5 with 2 to spare), open below
FC_X, FC_Z0, UBEC_YC = (18.5, 54.5), 10.0, 0.0     # 11 Nov: FC clear of the turret bosses at x 13 (r 5) and of the room behind DN (run a25e31d: 0.95 there with the FC at x 66.5)       # 9 Nov: the FC hangs under the deck over the receiver (x 15.5..51.5, z 10..20.5); the UBEC across the tail tray
BED = 89.3                                       # 9 Nov (Spark: deck, arms, pods and base as ONE body): the body inside |x|, |y| <= 89.3, the A1 mini's 180 less 1.4
# ---- the v3 base and the battery, unchanged ---------------------------------------------------------------------------------
BX = 1.3                                          # 9 Nov (Spark: "the center of gravity ... perfectly centered"): everything under the deck (receiver, cartridge, pack, base,
                                                  # FC, flow, tail electronics) moved along x as one group, to put the Scout's CG on the thrust centre; the funnel moves with the receiver
SEAT_Z, CX, SEAT_L, SEAT_W, RUN_H, CH = -44.3, 1.5 + BX, 184.0, 66.8, 20.0, 4.0
# ---- camera, cage --------------------------------------------------------------------------------------------------------------
TILT = math.radians(15.0)                         # the parked default: 15 deg up (the 61 deg tall view clears the nose ring and RF from 10 deg; the servo tilts -20..+90)
HFOV, VFOV = math.radians(61.0 / 2), math.radians(50.0 / 2)   # Arducam 12MP autofocus USB (B0FLX58WKZ): 75 D / 61 H / 50 V deg (listing)
# ---- 12 Nov (Spark: "only have me do what is absolutely necessary ... if we are testing with a coupon we can find what works that
# way"): no measurements. Every number below is an estimate (E, source given) or one of the coupon's three choices; Spark reads the
# coupon (parts/scout_v4_probe_coupon) and reports e.g. "D2 B1 A3 G2 M1 T2 C2": set COUPON_PICK, rerun the drawn makes and the parts.
COUPON = dict(
    D=((3.0, 2.5), (3.1, 2.6), (3.2, 2.7)),   # the pinion's D bore (diameter, across the flat) on the N20's 3.0 / 2.5 shaft: the one that presses on firm
    B=(6.00, 6.05, 6.10),                     # the MR63ZZ's seat in the roller (14 Nov: dropped, no bearings; kept as the printed coupon's record)
    A=(3.3, 3.4, 3.5),                        # the spool's bore on the M3 axle: the smallest that turns free with no wobble
    G=(20.8, 20.9, 21.0),                     # the gear pair's centres: the first that turns smoothly with no tight spot
    M=(14.0, 15.5, 17.0),                     # the spool's hub r; its mandrel is 0.9 of it (r 12.6 / 14.0 / 15.3: below 90 % of yield at the hub when the mandrel leaves no curl); the smallest that leaves no curl
    T=(25.4, 15.0, 12.7),                     # the blades' cup radius (a 19 mm blade: 1.8 / 3.4 / 4.3 deep): the narrowest throat the two blades and the ribbon pass with no binding
    C=(18.0, 20.0, 22.0),                     # the camera case's depth front to back without the lens: the narrowest gap the case drops into
)
COUPON_PICK = dict(D=(3.3, 2.8), A=1, G=2, M=1, T=1, C=(12.0, 18.0))   # 14 Nov, Spark printed the coupon (print-scout_v4_probe_coupon.stl, 0589981; M by coupon):
# D1, D2 would not go on, D3 too hard to press home: one step past D3, 3.3 / 2.8 (printed holes come out small on the A1 mini). B: dropped, no
# bearings (the roller turns on its M3 axle in an A1 bore, PCTG on steel). A: all three slide on free; A1 3.3, the snuggest, for the spool and
# the roller. M: no curl on any mandrel; M1, hub r 14. T: all three pass; T1, the narrowest throat (R 25.4). C: the case fits all three gaps
# (under ~18 deep; the listing gives none): the cradle holds it by the back plate's four M2s, nothing fits its depth, drawn for 12..18.
# G: not yet tried (no spool / pinion printed): G2 20.9, 0.1 over the standard 20.8 for teeth that print fat; Spark checks the mesh on the bench.
# A pick is a 1-based index into COUPON or an explicit size (a number or a tuple).


def pick(k):
    v = COUPON_PICK[k]
    return COUPON[k][v - 1] if isinstance(v, int) else v


BLADE_T = 0.13            # E: Topzone 3/4 in blade (B00ZMHXV4I, not listed); tape patents give 0.0045..0.0060 in (0.11..0.15); the margins are checked over 0.10..0.15
CUP_R = pick("T")         # the coupon's throat T (patents: 12.7..25.4)
CABLE_T = 0.81            # E: 30 AWG PTFE, MIL-W-16878/4 type E, OD 0.032 in (Remington's kit listings; was 0.6 assumed): the ribbon's thickness
CABLE_W = 6 * CABLE_T     # six wires side by side: 4.9 wide
STACK = 2 * BLADE_T + CABLE_T                     # A, the ribbon, B: 1.07 a turn
COIL = 1.6 * STACK                                # 1.6 turns for the 150 on hub r 14 (tools/probe_mast_sim.py wound): 1.72 over the hub
FIGHT = (BLADE_T + CABLE_T) * 2 * math.pi * 1.6  # A pays out this much more than B (the ribbon between them): 9.5 (was 7.5 with the 0.6 ribbon)
N20_STALL = 2.2 * 9.81 * 10                       # E: N20 6 V 100 rpm stall 2.2 kg cm, 0.67 A (Zbotic N20-6V-100 listing; 1.5..2.2 across vendors): 216 N mm at the shaft
SPOOL_STALL = N20_STALL * 40 / 12 * 0.85          # 612 N mm at the spool through 40 / 12 (85 %): the turret's tape-tension case; the stroke needs 100..292 (t 0.10..0.15, R 12.7..25.4, mu 0.05..0.4)
LENS_HALF = CUP_R - math.sqrt(CUP_R ** 2 - (19.0 / 2) ** 2) + BLADE_T + CABLE_T / 2 + 0.4   # half the lens's thickness along x (the cup's sag, a blade, half the ribbon, 0.4): 3.87 at T2
CAM_DEPTH = pick("C")                                              # (12, 18): the coupon's C, the case is under ~18 deep; no listing gives it, Spark measures nothing
CAM = dict(case=(1.5, 1.5 + CAM_DEPTH[1]), side=36.0, lens=(1.5 + CAM_DEPTH[1], 3.0 + CAM_DEPTH[1], 6.0), fit=0.45, wall=2.2, sleeve=CAM_DEPTH[0], lip=3.0)
# 14 Nov (design chat: the case has no back holes, only one threaded side hole a side for its bracket): the cradle is a square sleeve round the
# case's four sides (36 + 2 x 0.45 inside), its front rim's lip fixed at case[1] so the lens never moves with the depth; the sleeve runs 12 back
# (the shallowest case), a deeper one stands out behind it to case[0]; the case's own side screws clamp it through a slot along each side
LENS_OFF = 3.0 + CAM_DEPTH[1]                                     # the lens window ahead of the tilt axis: fixed by the lip, any depth
PROBE_DX = 0.0                                                    # the whole probe (turret, mast, head) and RM moved along x to put the Scout's CG on the thrust centre
MAST_X = pick("M") + 1.1 + PROBE_DX                                          # the mast's axis (x, 0): the stack's tangent off the wound spool (r 14..15.4, mean + half the stack), inside the roof's ring node
REACH = 150.0                                                     # the mast's roll-out (9 Nov, Spark: "shorten the distance where it's as safe as possible"; was 300)
# the head (9 Nov, Spark: "show how it can nod ... a led light for the camera, build out the actual mechanism"): a clip on the blades' tip,
# a base plate, an SG90 on its side on the +y bracket driving the tilt cradle through its horn, an idler pin in the -y bracket; the cradle
# carries the camera board on four M2 posts, the lens hood, the VL53L0X over the board and two 5 V COB LED bars beside the lens
HEAD = dict(clip=14.0, plate=3.0, dx=-7.5, ay=-3.8, az=45.0, range=(-20.0, 90.0))   # tilt axis along y at x MAST_X + dx, y ay, z = throat top + az (+ the length out); dx, ay put the head's CG over the mast
# the probe's turret (9 Nov, Spark: "do the double blade ... make the design for the mast itself fully"): under the roof, where the FC sat
BLADE_W = 19.0                                                    # tape blade width (9 Nov, Spark: "as safe as possible", 3/4 in; was 10): ~3.5x the fold moment (E)
SPOOL = dict(c=(PROBE_DX, 41.0), r=pick("M") + 1.9, hub=pick("M"), y0=-11.7, y1=11.7)  # 9 Nov, the mast sims (tools/probe_mast_sim.py): hub O28 (was O20: von Mises 1574 MPa at r 10 opposite sense, 1283 at r 14), 1.6 turns of the stack (A, the 0.6 ribbon, B) to O30.8, O31.8 flanges, 23.4 wide; axis y at x 0, z 41 (its flanges 0.6 over the deck)
ROLLER = dict(ang=-30.0, r=4.0, gap=0.0, w=19.0, F=(12.0, 7.8), bore=pick("A"), mu=0.25)   # the coil's pressure roller 30 deg before the exit (the sims: with the mast pushed, nothing but a friction lock holds the outer turn;
                                                  # 8 N locks a 2.4 N push at mu 0.3). 14 Nov (coupon, no bearings): an O8 printed tube turning on its M3 axle in an A1 3.3 bore (2.35 wall), PCTG on steel mu 0.25 E (roller_drag()); the axle in radial slots, two 4 x 0.5 x 15 springs, 12 N on the full coil, 7.8 empty
GEAR = dict(spool_t=40, pinion_t=12, m=0.8, y=(11.7, 14.7), c=pick("G"))      # printed spur pair, module 0.8, 40 / 12 on 20.8 centres: the N20 sits under the spool (9 Nov: outboard along +y it ran through the DS0 lug socket); ~1.5 s for the 150 mm, 3.3x its torque
N20_FACE = GEAR["y"][0] - 2.9                                    # the N20's gearbox face (y): 2.9 short of the pinion, the turret's 2.6 face plate between (9 Nov audit: 1.6 was too thin)
DRUM = dict(r=9.0, y0=-17.7, y1=-11.7)   # 10 Nov turret run 6: r 11 put the drum's ring in the head-first path (0.34); the 0.6 ribbon's 3.5 turns of room need r ~8.2                        # the drum on the spool's -y side: the camera cable's loose coil, 3.5 turns of room for the spool's ~2.2
MOTOR = dict(x=6.0, y0=-17.3, y1=9.7, z0=15.2, z1=25.2)           # N20 6 V 100 rpm (B07MZH851L; the 300 rpm stalled at ~140 N mm on the spool, the coil's own unwind is ~100 + friction): under the spool and the drum, facing +y, in a pocket through the deck
THROAT = dict(x0=MAST_X - 4.0, x1=MAST_X + 4.0, y=11.0, z0=41.0, z1=73.0)   # the 32 mm guide from the coil's tangent: the stack re-forms into the lens in it (tools/probe_mast_fe.py) and it grips the mast's base
AXIS = np.array([MAST_X + HEAD["dx"], HEAD["ay"], THROAT["z1"] + HEAD["az"]])   # the tilt axis parked
LENS = AXIS + LENS_OFF * np.array([math.cos(TILT), 0.0, math.sin(TILT)])
CAM_F, CAM_U, CAM_R = np.array([math.cos(TILT), 0, math.sin(TILT)]), np.array([-math.sin(TILT), 0, math.cos(TILT)]), np.array([0, 1.0, 0])
FLAT = HUB + R_KEEP + KEEP                       # 155.0: the ring's flats
CH_LINE = 2 * HUB + (R_KEEP + KEEP) * math.sqrt(2)   # 262.7: the corner chamfers |x| + |y| = CH_LINE
ZR, ZB, XR = 61.0, 12.0, 130.0                    # ring and flat roof, the bottom nodes, the roof's nose / tail apex
ZR = max(ZR, Z_PROP + Z_SWEEP + 13.0)
ZF = 2.7                                         # the bottom nodes on the bolt forks (14 Nov: seat_check --descent with their real meshes, 0 crossings)
YC = CH_LINE - FLAT                              # 107.7: where a flat meets a chamfer
FORK_X = (49.58, -36.35)                         # 14 Nov (the bolt forks): the side forks' sockets at the receiver bolts' x (REC_BOLTS + BX, checked below)
NODES = {
    "R0": (FLAT, YC, ZR), "P1": (YC, FLAT, ZR), "P2": (-YC, FLAT, ZR), "P3": (-FLAT, YC, ZR),                               # the ring's eight corners (left half, nose -> tail)
    "P4": (-FLAT, -YC, ZR), "P5": (-YC, -FLAT, ZR), "P6": (YC, -FLAT, ZR), "R7": (FLAT, -YC, ZR),                           # right half
    "RF": (XR, 0, ZR), "RM": (PROBE_DX, 0, ZR), "RB": (-XR, 0, ZR), "RS0": (0.0, XR, ZR), "RS1": (0.0, -XR, ZR),            # the flat roof: a cross from RM to four apexes 25 in from the ring (9 Nov: the same on all four sides)                                                              # the flat roof's spine
    "TB": (-FLAT, 0, ZF), "S0": (0.0, FLAT, ZF), "S1": (0.0, -FLAT, ZF),                                                    # the bottom nodes in the flats' planes, at ZF (14 Nov, the bolt forks)
    "NB": (FLAT, 0, ZF),                                                                                                     # the nose node
    # 14 Nov, the architecture review's "bolt forks" (the design chat; runs of 13 Nov, scout_v4_frame_vh / vl): each bottom node is held by a
    # horizontal fork of two 3.0 rods to sockets at z 11 beside the receiver's 4 bolts, in the frame's layers; the 8 D / B rods and their vertical
    # triangles are gone (the end crash's couple through 17 mm deep, 80 mm long triangles had read 550-700 N per socket; the forks ~180 N)
    "BN0": (75.5, 23.0, 11.0), "BN1": (75.5, -23.0, 11.0), "BT0": (-75.5, 23.0, 11.0), "BT1": (-75.5, -23.0, 11.0),
    "SA0": (FORK_X[0], 40.0, 11.0), "SA1": (FORK_X[0], -40.0, 11.0), "SB0": (FORK_X[1], 40.0, 11.0), "SB1": (FORK_X[1], -40.0, 11.0),
}
PRINTED = ("BN0", "BN1", "BT0", "BT1", "SA0", "SA1", "SB0", "SB1")
ROOTS = {}
TIED = ("RM",)                                    # nodes tied to the core through the probe's turret: RM's ring and the throat's top collar print as one (9 Nov: 2.1 -> ~1 mm worst, the roof's centre held)
NODE_PARTS = [k for k in NODES if k not in PRINTED and k not in TIED]               # the generated cage nodes (parts/scout_v4_node_<k>, parts/scout_v4_node_lib.py)
RODS = [("R0", "P1"), ("P2", "P3"), ("P4", "P5"), ("P6", "R7"),   # the ring, open at the nose and tail flats (9 Nov: with RM tied to the turret the two 215 mm flats only carried a head-first crash, which buckled them; dropped, -0.43 m)
        ("RF", "R0"), ("RF", "R7"), ("RF", "RM"), ("RM", "RB"), ("RB", "P3"), ("RB", "P4"), ("RM", "RS0"), ("RM", "RS1"), ("RS0", "P1"), ("RS0", "P2"), ("RS1", "P5"), ("RS1", "P6"),                                 # the flat roof: nose and tail triangles, spine, hoop
        ("NB", "R0"), ("NB", "R7"), ("TB", "P3"), ("TB", "P4"),                                                                                            # the end Vs (the camera's window stays clear between them)
        ("S0", "P1"), ("S0", "P2"), ("S1", "P6"), ("S1", "P5"),                                                              # the side fans
        ("BN0", "NB"), ("BN1", "NB"), ("BT0", "TB"), ("BT1", "TB"), ("SA0", "S0"), ("SB0", "S0"), ("SA1", "S1"), ("SB1", "S1")]   # the forks that hold the bottom nodes
TIES = []
LUG = (8.0, 36.0, 44.0, -15.5)                   # the deck's side lugs: |x| 8, |y| 36..44 (3.2 outside the receiver), down to z -14 (over the funnel's y walls, -16.3)
ROD_G_MM, NODE_G = 0.011, 6.0                    # 3.0 carbon rod; a printed PCTG node (v21 run: 5..13 g, E)
PCTG = 1.23e-3                                   # g / mm3


def P(k):
    return np.array({**NODES, **ROOTS}[k], float)


def disc_dist(p):
    best = 1e9
    for mx, my in MOTORS:
        dr = max(0.0, math.hypot(p[0] - mx, p[1] - my) - R_KEEP)
        dz = max(0.0, (Z_PROP - Z_SWEEP) - p[2], p[2] - (Z_PROP + Z_SWEEP))
        best = min(best, math.hypot(dr, dz))
    return best


def in_view(p, lens=LENS):
    d = np.asarray(p, float) - lens; f, r, u = d @ CAM_F, d @ CAM_R, d @ CAM_U
    return f > 0 and abs(math.atan2(r, f)) < HFOV - math.radians(2) * 0 and abs(math.atan2(u, f)) < VFOV


def seg(a, b, n=80):
    a, b = np.asarray(a, float), np.asarray(b, float)
    return a + (b - a) * np.linspace(0, 1, n)[:, None]


def box(x0, x1, y0, y1, z0, z1):
    m = trimesh.creation.box(extents=[x1 - x0, y1 - y0, z1 - z0]); m.apply_translation([(x0 + x1) / 2, (y0 + y1) / 2, (z0 + z1) / 2]); return m


def cyl(x, y, z0, z1, r, n=48):
    m = trimesh.creation.cylinder(radius=r, height=z1 - z0, sections=n); m.apply_translation([x, y, (z0 + z1) / 2]); return m


def rod(a, b, r=1.5):
    return trimesh.creation.cylinder(radius=r, segment=[np.asarray(a, float), np.asarray(b, float)], sections=12)


def union(ms):
    import manifold3d as mf
    out = None
    for m in ms:
        mm = mf.Manifold(mf.Mesh(np.asarray(m.vertices, np.float32), np.asarray(m.faces, np.uint32)))
        out = mm if out is None else out + mm
    t = out.to_mesh(); return trimesh.Trimesh(np.asarray(t.vert_properties)[:, :3], np.asarray(t.tri_verts), process=False)


def frame():
    """the printed deck: the body plate, four arms from its corners to the pods, the pods, a lug down each side for the side
    triangles' sockets (an envelope: the engine sizes it)"""
    x0, x1, yb = DECK
    parts = [box(x0, x1, -yb, yb, DECK_Z0, DECK_TOP)]
    for mx, my in MOTORS:
        a = np.array([np.sign(mx) * 30.0, np.sign(my) * 30.0]); b = np.array([mx, my]); d = b - a; L = float(np.linalg.norm(d))
        arm = box(-L / 2, L / 2, -ARM_W / 2, ARM_W / 2, DECK_Z0, DECK_TOP)
        T = np.eye(4); c, s = d / L
        T[:2, :2] = [[c, -s], [s, c]]; T[:2, 3] = (a + b) / 2
        arm.apply_transform(T); parts.append(arm)
        parts.append(cyl(mx, my, DECK_Z0, DECK_TOP, POD_R))
    lx, ly0, ly1, lz = LUG
    for s in (1, -1):                                                # the side lugs: the two sockets of each side triangle
        parts.append(box(-lx, lx, *sorted((s * ly0, s * ly1)), lz, DECK_Z0 + 0.5))
    parts.append(base())                                             # 9 Nov: the base is part of the same body (Spark: "design the whole thing ... as one body")
    import manifold3d as mf
    b = union(parts)
    bm = mf.Manifold(mf.Mesh(np.asarray(b.vertices, np.float32), np.asarray(b.faces, np.uint32))) ^ mf.Manifold.cube([2 * BED, 2 * BED, 200.0]).translate([-BED, -BED, -100.0])
    t = bm.to_mesh(); return trimesh.Trimesh(np.asarray(t.vert_properties)[:, :3], np.asarray(t.tri_verts), process=False)


def zmin_walls_in(x):
    """the funnel with its end walls in (the box session, 9 Nov; Spark: "seat the scout on the receiver alone"): below z -4.3 nothing
    outside the 55 deg faces that rise from the receiver's outline; the lowest z a part may reach at x (add 2 margin)"""
    d = abs(x - 1.45 - BX) - 52.8
    return SEAT_Z if d <= 0 else min(-4.3, SEAT_Z + 1.428 * d)


def base():
    """v4 base on the receiver-only seat, now the under-deck part of the one body (9 Nov). The yokes over the receiver (its top z 9.6
    to the deck), where the FC, the Radxa, the XR2 and the DRV8833 hang under the deck (the nose bay is gone: with the nose sockets'
    collars inside the A1 mini's 180 there is no room for the FC between DN and BN); the nose block (x 55.6..89.3, |y| 26) for DN /
    BN and the flow sensor's pod under it (its bottom at -19.1, the rule's -21.1 + 2); the tail tray (x -89.3..-50, z -2.3 up) for DT /
    BT, the UBEC's pod under it (11 Nov); every bottom on zmin_walls_in + 2"""
    lo, hi = np.array([-51.3 + BX, -32.8, -44.3]), np.array([54.3 + BX, 32.8, REC_TOP])   # the receiver v3 (C), not drawn
    parts = [box(lo[0], hi[0], -DECK[2], DECK[2], hi[2], DECK_Z0 + 0.5),             # the yokes over the receiver, the deck's width
             box(hi[0], BED, -26.0, 26.0, -2.3, DECK_Z0 + 0.5),                      # the nose block
             box(hi[0], 71.8, -12.0, 12.0, -19.1, -2.0),                             # the flow sensor's pod (open below: its window)
             box(-BED, lo[0], -34.0, 34.0, -2.3, DECK_TOP),                          # the tail tray
             box(UBEC_LO[0] - 2.5, UBEC_LO[0] + 19.5, -33.0, 33.0, UBEC_LO[1], -2.0),  # the UBEC's pod under it (open below)
             ]
    return union(parts)


def place(src, rot=None, lo=None, yc=0.0):
    """a bought part's mesh, turned (axis, deg) about its centre, then moved so its bounds' low corner is lo (x, z) and centred on yc"""
    m = trimesh.load(os.path.join(ROOT, "parts", src, "part.stl"), force="mesh")
    if rot:
        c = m.bounds.mean(0); m.apply_transform(trimesh.transformations.rotation_matrix(math.radians(rot[1]), rot[0], c))
    b = m.bounds
    m.apply_translation([lo[0] - b[0][0], yc - (b[0][1] + b[1][1]) / 2, lo[1] - b[0][2]])
    return m


FLOW_LO = (64.0, -6.8)                                                              # the flow sensor's low corner (x, z): x 64..80 past latch v7's receiver room (x 63.1), its bottom 0.6 over the walls-in funnel + 2 at x 80
REC_BOLTS = [(48.28, 26.55), (48.28, -26.55), (-37.65, 26.55), (-37.65, -26.55)]   # the receiver's 4 bolt bosses (receiver v3, C), drone frame before BX
assert all(abs(FORK_X[i] - (REC_BOLTS[2 * i][0] + BX)) < 0.01 for i in (0, 1)), "the side forks sit at the receiver bolts' x"
REC_TOP = 9.6                                                                       # the receiver's top: the base's yokes sit on it
BATTERY_SET = (266.5, (-3.47, -0.01, -15.93))                                       # 9 Nov (Spark: "get rid of the battery mechanism, leave 4 bolts for it to mount
                                                                                    # to"): the receiver 60, cartridge 30, pack 165, XT60 10, feet and pads 1.5 are not drawn;
                                                                                    # they fly on the 4 bolts, so their mass at their CG (x + BX) stays in the balance and frame model


def receiver_bolts():
    """the battery's receiver held like the Overseer's (9 Nov, Spark: "just like the overseer make the bottom of the battery mounted with
    4 screws"): 4 M3 up from below through the receiver's O3.4 boss holes into M3 x 5.7 heat-set inserts in the base's yokes (O4 x 6
    holes in O10 bosses, wall >= 3); the screws' length is set by the receiver's boss (M3 x 12 E: measure), their heads reached from below"""
    out = []
    for x, y in REC_BOLTS:
        out.append(cyl(x + BX, y, REC_TOP - 7.0, REC_TOP + 5.0, 1.5, 16))            # the M3 screw, 12 long, head down inside the receiver's boss
        out.append(cyl(x + BX, y, REC_TOP - 7.0, REC_TOP - 5.0, 2.75, 16))           #   its head O5.5 x 2 (low-profile button)
        out.append(cyl(x + BX, y, REC_TOP, REC_TOP + 5.7, 2.0, 16))                  # the M3 x 5.7 heat-set insert in the yoke
    return trimesh.util.concatenate(out)


def pads():
    """on the receiver's bottom (the box session's numbers, 9 Nov): four TPU feet at its corners in |y| 21..23.5 (clear of the ledges'
    skirt at 25 and the cartridge's path), reaching z -47.5 so they are the foot on flat ground, and four bare contact pads O6 at
    (1.5 +- 30, +-29.5) for the box's keep-alive and seat probes in the ledges"""
    feet = [box(x0 + BX, x0 + BX + 8.0, *sorted((s * 21.0, s * 23.5)), -47.5, SEAT_Z) for x0 in (-50.0, 45.0) for s in (1, -1)]
    contacts = [cyl(CX + dx, s * 29.5, SEAT_Z - 0.2, SEAT_Z, 3.0, 24) for dx in (-30.0, 30.0) for s in (1, -1)]
    return trimesh.util.concatenate(feet), trimesh.util.concatenate(contacts)


def prop(mx, my):
    """the swept disc (0.8 thick) and a 3 blade sketch, the hub"""
    disc = cyl(mx, my, Z_PROP - 0.4, Z_PROP + 0.4, PROP_R, 96)
    blades = []
    for k in range(3):
        a = math.radians(120 * k + (30 if mx * my > 0 else -30))
        b = box(0, PROP_R - 1, -6.0, 6.0, -1.2, 1.2); b.apply_transform(trimesh.transformations.rotation_matrix(a, [0, 0, 1])); b.apply_translation([mx, my, Z_PROP])
        blades.append(b)
    return disc, union(blades + [cyl(mx, my, Z_PROP - 3, Z_PROP + 3, 7.0)])


def moved(src, dx=0.0, dy=0.0, dz=0.0):
    m = trimesh.load(os.path.join(ROOT, "parts", src, "part.stl"), force="mesh"); m.apply_translation([dx, dy, dz]); return m


def _xz(poly, y0, y1):
    """a shapely polygon drawn in the (x, z) plane, extruded along y from y0 to y1"""
    m = trimesh.creation.extrude_polygon(poly, y1 - y0)
    m.apply_transform(trimesh.transformations.rotation_matrix(math.pi / 2, [1, 0, 0]))   # (x, y, z) -> (x, -z, y)
    m.apply_translation([0, y1, 0])
    return m


def gear(teeth, m, cx, cz, y0, y1):
    """a spur gear, module m: trapezoid teeth from the root to the tip circle"""
    from shapely.geometry import Polygon
    rp = teeth * m / 2; ra, rf = rp + m, rp - 1.25 * m; pts = []
    for k in range(teeth):
        a = 2 * math.pi * k / teeth; w = 2 * math.pi / teeth
        for da, r in ((-0.5 * w, rf), (-0.22 * w, rf), (-0.12 * w, ra), (0.12 * w, ra), (0.22 * w, rf)):
            pts.append((cx + r * math.cos(a + da), cz + r * math.sin(a + da)))
    return _xz(Polygon(pts).buffer(0), y0, y1)


def cyl_y(r, x, z, y0, y1, n=32):
    return trimesh.creation.cylinder(radius=r, segment=[(x, y0, z), (x, y1, z)], sections=n)


def head_parts(split=False):
    """the head at the identity pose = parked, tilted TILT up (9 Nov compact). Fixed to the blades' tip: clip, base plate, the idler's
    bracket (-y) and the SG90's (+y), both tight to the cradle, and the SG90. Tilting about AXIS (y): the cradle (back plate, two side
    walls gripping the case, the horn's boss, the idler: an M3 screw), the camera in its case; the LED bars stuck on the case's top and
    bottom faces (the metal case is their heat sink), so they nod with it and need no fins"""
    hz, ax, az = THROAT["z1"], AXIS[0], AXIS[2]
    pz = hz + HEAD["clip"] + HEAD["plate"]                                           # the base plate's top
    c = CAM; h = c["side"] / 2; w = h + 2.0                                           # the cradle's side walls just outside the case
    ay = HEAD["ay"]
    sv = w + 3.0                                                                      # the SG90's output face: horn 1.5 + spline 1.5 off the wall
    clip = box(MAST_X - 5.5, MAST_X + 5.5, -BLADE_W / 2 - 2.0, BLADE_W / 2 + 2.0, hz, hz + HEAD["clip"])   # the clip round the two blades' tip
    fixed = [box(min(ax - 17.0, MAST_X - 5.5), max(ax + 8.0, MAST_X + 5.5), -w - 4.0, sv + 14.0, hz + HEAD["clip"], pz),   # the base plate, over the clip, under the servo and the brackets
             box(ax - 5.0, ax + 5.0, -w - 4.0, -w - 1.5, pz, az + 2.0),              # -y bracket, the idler's
             cyl_y(4.0, ax, az, -w - 4.0, -w - 1.5),                                  #   its boss
             box(ax - 17.0, ax + 8.0, sv + 11.5, sv + 14.0, pz, az - 6.25),           # +y bracket under the SG90's tabs
             box(ax - 16.4, ax + 6.0, sv, sv + 22.8, az - 6.25, az + 6.25),           # SG90 body 22.4 x 12.5 x 22.8 (typical drawing, E), shaft on the axis, facing -y
             box(ax - 21.2, ax + 11.6, sv + 6.0, sv + 8.5, az - 6.25, az + 6.25),    #   its mounting tabs (32.8 across, DORHEA listing)
             cyl_y(2.4, ax, az, w + 1.5, sv, 16)]                                     #   the spline
    fixed = [m.apply_translation([0, ay, 0]) for m in fixed] + [clip]
    f0, si, so = c["case"][1], h + c["fit"], h + c["fit"] + c["wall"]
    sl = trimesh.util.concatenate([box(f0 - c["sleeve"], f0, -so, so, si, so), box(f0 - c["sleeve"], f0, -so, so, -so, -si),
                                   box(f0 - c["sleeve"], f0, si, so, -si, si), box(f0 - c["sleeve"], f0, -so, -si, -si, si),
                                   box(f0, f0 + 4.0, si - c["lip"], so, -si + c["lip"], so + 3.0), box(f0, f0 + 4.0, -so, -si + c["lip"], -si + c["lip"], so + 3.0),
                                   box(f0, f0 + 4.0, -so, so, si - c["lip"], so + 3.0), box(f0 - c["sleeve"], f0, -so, so, so, so + 3.0)])   # 14 Nov: the sleeve, its lip (top and upper sides) and the generated room's reach over and ahead of it (parts/scout_v4_cradle env)
    t = [sl,
         box(-6.0, f0 - c["sleeve"] + 0.5, -so, -si, -10.0, 10.0), box(-6.0, f0 - c["sleeve"] + 0.5, si, so, -10.0, 10.0),   # the side walls on back to the axis (drawn)
         cyl_y(7.0, 0.0, 0.0, w, w + 1.5),                                            # the SG90's horn, screwed to the +y wall
         cyl_y(1.5, 0.0, 0.0, -w - 4.0, -w, 12),                                      # idler: an M3 screw (-y) into the bracket's boss
         box(c["case"][0], c["case"][1], -h, h, -h, h),                               # the camera in its metal case
         trimesh.creation.cylinder(radius=c["lens"][2], segment=[(c["lens"][0], 0, 0), (c["lens"][1], 0, 0)], sections=32)]   # its lens window
    f = c["case"][1]
    leds = [box(f - 8.0, f, -12.5, 12.5, h, h + 1.2), box(f - 8.0, f, -12.5, 12.5, -h - 1.2, -h)]   # Clearhill 5 V COB, 25 x 8 each, on the case's top and bottom fronts
    pose = trimesh.transformations.rotation_matrix(-TILT, [0, 1, 0]); pose[:3, 3] = AXIS            # AXIS carries ay
    tilt = trimesh.util.concatenate(t); tilt.apply_transform(pose)
    led = trimesh.util.concatenate(leds); led.apply_transform(pose)
    if split:                                                                         # the page's parts: printed frame, bought SG90, printed cradle, bought camera
        frame_ = trimesh.util.concatenate(fixed[:4] + fixed[7:]); servo = trimesh.util.concatenate(fixed[4:7])
        cradle = trimesh.util.concatenate(t[:4]); cam = trimesh.util.concatenate(t[4:])
        cradle.apply_transform(pose); cam.apply_transform(pose)
        return dict(head_frame=frame_, probe_servo=servo, cradle=cradle, probe_tilt=cam, probe_leds=led)
    return trimesh.util.concatenate(fixed), tilt, led


def roller_drag(mu=None):
    """14 Nov (no bearings): the roller's journal friction on its M3 axle, seen at the spool. The tube turns on the steel axle in its
    A1 bore: torque mu F r_bore on the tube, a drag of that over the tube's r where it rolls on the coil, times the coil's r on the spool.
    Against the stroke's 100..292 N mm (tools/probe_mast_sim.py stroke_case) and the N20 100 rpm through 40 / 12 at 85 %: 417..612 (E)"""
    mu = ROLLER["mu"] if mu is None else mu
    out = {}
    for nm, F, rc in (("full", ROLLER["F"][0], SPOOL["hub"] + COIL), ("empty", ROLLER["F"][1], SPOOL["hub"] + 0.15)):
        out[nm] = mu * F * ROLLER["bore"] / 2 / ROLLER["r"] * rc
    need = 292.0 + max(out.values()); lo = N20_STALL * 1.5 / 2.2 * 40 / 12 * 0.85
    return dict(drag=out, need=need, margin=(lo / need, SPOOL_STALL / need))


def tilt_sweep():
    """the cradle swept over the servo's range: its least gap over the base plate (2 deg steps), and whether any of it enters the SG90
    or the idler bracket (vertex in box; the coupler and the pin, which run into them on the axis, excepted)"""
    _, tilt, led = head_parts()
    v0 = np.vstack([tilt.vertices, led.vertices]) - AXIS
    hz, ax, az = THROAT["z1"], AXIS[0], AXIS[2]; pz = hz + HEAD["clip"] + HEAD["plate"]
    worst, hit = 1e9, []
    for d in np.arange(HEAD["range"][0], HEAD["range"][1] + 0.1, 2.0):
        R = trimesh.transformations.rotation_matrix(-(math.radians(d) - TILT), [0, 1, 0])[:3, :3]
        v = v0 @ R.T + AXIS
        worst = min(worst, float((v[:, 2] - pz).min()))
        off_axis = np.hypot(v[:, 0] - ax, v[:, 2] - az) > 7.5
        w = CAM["side"] / 2 + 2.0
        yy = v[:, 1] - HEAD["ay"]
        servo = (v[:, 0] > ax - 21.2) & (v[:, 0] < ax + 11.6) & (yy > w + 3.0) & (np.abs(v[:, 2] - az) < 6.25)
        brk = (np.abs(v[:, 0] - ax) < 5.0) & (yy < -w - 1.5) & (v[:, 2] < az + 2.0)
        if (off_axis & (servo | brk)).any():
            hit.append(int(d))
    return round(worst, 1), hit


def probe():
    """the ceiling probe (9 Nov). Turret, under the roof's middle node where the FC sat: the spool (axis y) with its 40 T gear, the 15 T
    pinion on the N20 in a pocket in the deck, the clock-spring spiral that carries the flat cable to the fixed side, the 30 mm throat
    the two blades leave through (forming their lens) and the housing's two side plates; M3 screws are the spool's and the idler's axles. Returns {name: mesh}"""
    from shapely.geometry import Point, LineString, Polygon
    (cx, cz), r = SPOOL["c"], SPOOL["r"]; t = THROAT
    y0, y1 = SPOOL["y0"], SPOOL["y1"]
    spool = [cyl_y(SPOOL["hub"], cx, cz, y0 + 1.2, y1 - 1.2, 48), cyl_y(r, cx, cz, y0, y0 + 1.2, 48), cyl_y(r, cx, cz, y1 - 1.2, y1, 48),
             cyl_y(SPOOL["hub"] + COIL, cx, cz, -BLADE_W / 2, BLADE_W / 2, 48),                     # the stack (A, the ribbon, B) wound on the hub, 1.6 turns
             gear(GEAR["spool_t"], GEAR["m"], cx, cz, *GEAR["y"]), cyl_y(1.5, cx, cz, DRUM["y0"] - 2.0, GEAR["y"][1] + 3.0, 12)]   # 40 T and its M3 axle
    pz = cz - GEAR["c"]
    pinion = gear(GEAR["pinion_t"], GEAR["m"], cx, pz, *GEAR["y"])
    g0 = N20_FACE                                                                     # the gearbox's face, 2.9 short of the pinion (room for the turret's 2.6 face plate)
    motor = [box(cx - 6.0, cx + 6.0, g0 - 10.0, g0, pz - 5.0, pz + 5.0),                        # Augiimor N20 6 V 300 rpm: gearbox 12 x 10 x 10 (37 total - can 17 - shaft 10), facing +y
             cyl_y(6.0, cx, pz, g0 - 27.0, g0 - 10.0, 24),                             # can O12 x 17, under the spool and the drum
             cyl_y(1.5, cx, pz, g0, g0 + 10.0, 12)]                                    # 3 mm D shaft: through the pinion, its tip in the +y plate's bearing hole
    th = np.linspace(0, 2 * math.pi * 3.5, 400); rr = 4.0 + (DRUM["r"] - 1.5 - 4.0) * th / th[-1]
    spiral = LineString([(cx + a * math.cos(b), cz + a * math.sin(b)) for a, b in zip(rr, th)]).buffer(1.1)
    drum = [_xz(spiral, DRUM["y0"] + 1.0, DRUM["y1"] - 1.0), cyl_y(4.0, cx, cz, DRUM["y0"] + 0.5, DRUM["y1"] + 0.5, 24)]           # the camera's own USB cable in a loose coil (2.5 turns of room, ~1.5 used)
    feed = [box(MAST_X + sg * 1.6 - 0.2, MAST_X + sg * 1.6 + 0.2, -BLADE_W / 2, BLADE_W / 2, cz, t["z0"] + 2.0) for sg in (1, -1)]   # the blades from the spool up into the throat
    yp, ym = GEAR["y"][1] + 0.8, DRUM["y0"] - 0.8
    rd = DRUM["r"] + 1.0; rg = max(r, (GEAR["spool_t"] / 2 + 1) * GEAR["m"]) + 0.5
    side_d = Polygon([(cx - rd, 24.5), (cx + rd, 24.5), (cx + rd, cz), (cx - rd, cz)]).union(Point(cx, cz).buffer(rd, 64))   # the -y plate: only the drum is there
    side_g = Polygon([(cx - rg, 24.5), (cx + rg, 24.5), (cx + rg, cz), (cx - rg, cz)]).union(Point(cx, cz).buffer(rg, 64))   # the +y plate: carries the axle
    housing = [_xz(side_g, yp, yp + 1.2), _xz(side_d, ym - 1.2, ym),
               box(cx - rg, t["x1"], ym - 1.2, yp + 1.2, 24.5, 26.0),                        # floor on the deck
               cyl_y(DRUM["r"] + 1.0, cx, cz, ym, DRUM["y0"], 48),                      # the drum's cover
               box(t["x0"], t["x1"], -t["y"], t["y"], t["z0"], t["z1"]),                 # the throat
               trimesh.creation.annulus(r_min=t["x1"] - cx + 1.0, r_max=22.0, height=8.0).apply_translation([cx, 0, ZR])]   # its top collar out to RM's ring: one print with the node
    rr = SPOOL["hub"] + COIL + ROLLER["r"]; a = math.radians(ROLLER["ang"])                         # the pressure roller on the full coil
    roller = [cyl_y(ROLLER["r"], cx + rr * math.cos(a), cz + rr * math.sin(a), -ROLLER["w"] / 2, ROLLER["w"] / 2, 24),
              cyl_y(1.5, cx + rr * math.cos(a), cz + rr * math.sin(a), -ROLLER["w"] / 2 - 3.0, ROLLER["w"] / 2 + 3.0, 12)]
    for sy in (-1, 1):                                                                # its two springs, radial, beyond the tube's ends
        e = np.array([cx + (rr + 2.0) * math.cos(a), 0, cz + (rr + 2.0) * math.sin(a)]); f = np.array([cx + (rr + 13.0) * math.cos(a), 0, cz + (rr + 13.0) * math.sin(a)])
        e[1] = f[1] = sy * (ROLLER["w"] / 2 + 1.6)
        roller.append(trimesh.creation.cylinder(radius=2.0, segment=[e, f], sections=12))
    return dict(probe_turret=trimesh.util.concatenate(housing), probe_spool=trimesh.util.concatenate(spool), probe_pinion=pinion, probe_roller=trimesh.util.concatenate(roller),
                probe_motor=trimesh.util.concatenate(motor), probe_drum=trimesh.util.concatenate(drum), probe_feed=trimesh.util.concatenate(feed),
                **head_parts(split=True))


MAST_STUB = 1.0                                   # the mast's mesh: 1 mm of the two blades above the throat; the page's timeline
                                                  # (tools/scout_v4_timeline.py) stretches it to the length rolled out and lifts the head


def mast():
    """the two blades as they leave the throat, curves facing: a lens BLADE_W wide across the drone (y), each blade bowed 2.5 out along x
    (the blades' width runs along the spool's axis; thickness drawn 0.4 to be seen)"""
    from shapely.geometry import Polygon
    hw = BLADE_W / 2; ys = np.linspace(-hw, hw, 21); bow = 2.5 * (1 - (ys / hw) ** 2)
    out = []
    for sg in (1, -1):
        ring = [(MAST_X + sg * b, y) for y, b in zip(ys, bow)] + [(MAST_X + sg * (b - 0.4), y) for y, b in zip(ys[::-1], bow[::-1])]
        m = trimesh.creation.extrude_polygon(Polygon(ring).buffer(0), MAST_STUB); m.apply_translation([0, 0, THROAT["z1"]])
        out.append(m)
    return out


HUB_RING = 34.0                                   # the roof's middle node RM is a ring (r 22..34) round the probe's throat (its corners at r 20.2): its four rods end in its sides at r 34
RM_MOUTH = {"RF": 33.0, "RB": 26.0, "RS0": 29.0, "RS1": 34.0}   # 10 Nov (the turret's run: 0.72 at RM-RB, 1.01 on 9 Nov, with every mouth at r 34): each socket's mouth as near
                                                  # as its neighbours allow: RF clear of the throat's slot (the mast at x 15.1), RB over the spool, RS0 past the 40 T gear, RS1 past the drum's end


def cage():
    def cut(i, j):                           # each rod stops 3 inside its nodes' spheres (two in-line rods through a node must not share an end
        a, b = P(i), P(j); u = (b - a) / np.linalg.norm(b - a)   # ring: the page's mesh cleanup welds them and drops the body, 7 Nov), and at
        bi = RM_MOUTH[j] if i == "RM" else 3.0                   # the turret's socket mouths at RM
        bj = RM_MOUTH[i] if j == "RM" else 3.0
        return a + u * bi, b - u * bj
    rods = [rod(*cut(i, j)) for i, j in RODS + TIES]
    nodes = [trimesh.creation.icosphere(subdivisions=1, radius=5.0).apply_translation(P(k)) for k in NODES if k not in PRINTED and k != "RM"]
    nodes += [trimesh.creation.icosphere(subdivisions=1, radius=4.6).apply_translation(P(k)) for k in PRINTED]   # the sockets printed into the frame and the base (their collars, O9.2)
    ring = trimesh.creation.annulus(r_min=22.0, r_max=HUB_RING, height=8.0); ring.apply_translation(P("RM"))
    nodes.append(ring)                                                                   # RM: the ring node the turret's throat passes through
    return trimesh.util.concatenate(rods), trimesh.util.concatenate(nodes)


def frame_check(core_g, write=True, core_cg=(0.0, 0.0, 0.0)):
    """the Scout's frame model (tools/scout_cage_loads.py, the standard cases: 35 g crash on the hull face the CG ray leaves through, 14
    directions, landing and rough landing 6 g on the runners) on these tables: the core one rigid body at the origin with the
    sockets printed into the frame and the base and the runner corners stiff to it"""
    import io, contextlib, scout_cage as sc, scout_cage_loads as sl
    sc.NODES, sc.RODS, sc.TIES, sc.TIE_ROOTS = dict(NODES), list(RODS), list(TIES), dict(ROOTS)
    sc.PRINTED = {k: "frame" for k in PRINTED + TIED}
    sc.BASE = {"G0": (CX + SEAT_L / 2, SEAT_W / 2, SEAT_Z), "G1": (CX - SEAT_L / 2, SEAT_W / 2, SEAT_Z), "G2": (CX - SEAT_L / 2, -SEAT_W / 2, SEAT_Z), "G3": (CX + SEAT_L / 2, -SEAT_W / 2, SEAT_Z)}
    sc.BRIDGES = []; sc.GROUPS = sc._groups(); sc.GROUP_OF = {k: g for g in sc.GROUPS for k in g}; sc.RODS_CARBON = list(RODS)
    sl.core_mass = lambda: (core_g, np.asarray(core_cg, float))   # 13 Nov (the architecture review): the core's real CG, not the origin
    with contextlib.redirect_stdout(io.StringIO()):
        s_, rec = sl.run(nodes=sc.NODES, rods=sc.RODS, ties=sc.TIES, dry=True, log=lambda *a: print(*a))
    w = max(rec["cases"], key=lambda r: r["deflection_mm"])
    eu = max(rec["rods"].items(), key=lambda kv: kv[1]["euler"]); mo = max(rec["rods"].items(), key=lambda kv: kv[1]["moment"])
    out = dict(mode_hz=rec["modes_hz"][0], deflection=(w["deflection_mm"], w["name"]), euler=(eu[1]["euler"], eu[0]), moment=(mo[1]["moment"], mo[0]),
               pull=max(v["tension"] for v in rec["rods"].values()))
    sc.BASE["HD"] = (float(AXIS[0]), 0.0, float(head_parts()[1].bounds[1][2]))      # the parked head's top: the Scout's highest point, rigid to the core through the throat
    with contextlib.redirect_stdout(io.StringIO()):
        s_, rh = sl.run(nodes=sc.NODES, rods=sc.RODS, ties=sc.TIES, dry=True, log=lambda *a: print(*a))
    wh = max(rh["cases"], key=lambda r: r["deflection_mm"]); muh = max(rh["rods"].items(), key=lambda kv: kv[1]["moment"]); euh = max(rh["rods"].items(), key=lambda kv: kv[1]["euler"])
    out["head_first"] = dict(deflection=wh["deflection_mm"], euler=(euh[1]["euler"], euh[0]), moment=(muh[1]["moment"], muh[0]),
                             head_N=max(-(c["reactions"].get("HD") or 0) for c in rh["cases"]))
    del sc.BASE["HD"]
    nl = {}                                                                         # the nodes' topology loads: per node and member, the worse of the standard and the head-first runs
    for r in (rec, rh):
        for k, mm in r["node_loads"].items():
            for nm, v in mm.items():
                o = nl.setdefault(k, {}).get(nm)
                if o is None or v["axial"] > o["axial"] or v["side"] > o["side"] or v["moment"] > o["moment"]:
                    mo = v if o is None or v["moment"] >= o["moment"] else o                  # 14 Nov: the end moment and its axis from the run where it is larger
                    nl[k][nm] = dict(axial=max(v["axial"], o["axial"] if o else 0), side=max(v["side"], o["side"] if o else 0), N=v["N"], case=v["case"], tag="F",
                                     moment=mo["moment"], moment_axis=mo["moment_axis"], moment_case=mo["moment_case"])
    out["node_loads"] = nl                                                          # write=False (13 Nov): a frame variant's own cage, in memory only
    rods = {}                                                                       # per rod: the worse of the two runs (L, Pcr with the 3.0 rod, compression, tension)
    for r in (rec, rh):
        for k, v in r["rods"].items():
            o = rods.setdefault(k, dict(L=v["L"], Pcr=v["Pcr"], compression=0.0, tension=0.0, moment=0.0))
            o["compression"] = max(o["compression"], v["compression"]); o["tension"] = max(o["tension"], v["tension"]); o["moment"] = max(o["moment"], v["moment"])
    out["rods"] = rods
    if not write:
        return out
    json.dump(dict(note="Scout v4 frame model (tools/scout_v4_shape.py frame_check): per node and member the worse of the standard cases and the head-first crash", node_loads=nl),
              open(os.path.join(ROOT, "systems", "scout_v4.cage_loads.json"), "w"), indent=1)
    hn = int(math.ceil(out["head_first"]["head_N"] / 10.0) * 10)                    # the probe's setups read the head-first load from here (9 Nov: it was 230 by hand, the model gives ~250)
    json.dump(dict(note="Scout v4 frame model: the parked head's contact force in the head-first crash, rounded up to 10 N; read by the probe's turret, head frame and cradle", head_first_N=hn),
              open(os.path.join(ROOT, "systems", "scout_v4.head_load.json"), "w"), indent=1)
    return out


def checks(meshes):
    out = {}
    worst = (1e9, "")
    for nm, m in meshes.items():
        if nm in ("box_ctx_scout_receiver_v3", "box_ctx_scout_cartridge_v6", "pack_4s_1500", "pack_xt60_plug", "receiver_feet", "receiver_contacts") or nm.startswith(("prop_", "blades_")):
            continue
        v = np.asarray(m.vertices); v = v[v[:, 2] < -4.3]
        for p in v[::3]:
            d = p[2] - (zmin_walls_in(p[0]) + 2.0)
            if d < worst[0]:
                worst = (round(float(d), 1), f"{nm} at x {p[0]:.0f}, z {p[2]:.1f}")
    out["walls-in funnel"] = (("clear by %s" % worst[0]) if worst[0] >= 0 else f"CROSSES by {-worst[0]}", worst[1] or "nothing below z -4.3")
    gaps = [math.dist(MOTORS[a], MOTORS[b]) - PROP_D for a in range(4) for b in range(a + 1, 4)]
    out["tip gap"] = (round(min(gaps), 1), "neighbour props, tip to tip (3520 on v3: 19.1)")
    worst = (1e9, "")
    for i, j in RODS + TIES:
        pts = seg(P(i), P(j))
        d = min(disc_dist(p) for p in pts)
        if d < worst[0]:
            worst = (round(d, 1), f"{i}-{j}")
    out["rods to discs"] = (worst[0], f"{worst[1]} (need {KEEP:.0f})")
    blk = [f"{i}-{j}" for i, j in RODS + TIES if any(in_view(p) for p in seg(P(i), P(j)))]
    out["camera view"] = ("clear" if not blk else "BLOCKED by " + ", ".join(blk), f"the probe head parked: {math.degrees(2 * HFOV):.0f} x {math.degrees(2 * VFOV):.0f} deg from lens ({LENS[0]:.0f}, 0, {LENS[2]:.0f}), {math.degrees(TILT):.0f} deg up")
    disc_pts = [np.array([mx + PROP_R * math.cos(a), my + PROP_R * math.sin(a), Z_PROP]) for mx, my in MOTORS for a in np.linspace(0, 2 * math.pi, 90)]
    out["props in view"] = ("none" if not any(in_view(p) for p in disc_pts) else "IN VIEW", "the disc rims")
    for nm, ids in (("probe head", ("head_frame", "probe_servo", "cradle", "probe_tilt", "probe_leds")), ("probe turret", ("probe_turret", "probe_spool", "probe_pinion", "probe_motor", "probe_drum", "probe_feed", "probe_roller"))):
        v = np.vstack([np.asarray(meshes[k].vertices) for k in ids])
        out[f"{nm} to discs"] = (round(min(disc_dist(p) for p in v), 1), "need 12")
    rods_m, nodes_m = cage()
    nodes_x = trimesh.util.concatenate([trimesh.creation.icosphere(subdivisions=1, radius=7.0 if k in PRINTED else 5.0).apply_translation(P(k)) for k in NODES if k not in TIED])
    clash = []
    for k in ("probe_turret", "probe_spool", "probe_pinion", "probe_motor", "probe_drum", "probe_feed", "probe_roller", "head_frame", "probe_servo", "cradle", "probe_tilt", "probe_leds"):
        for nm, o in (("nodes", nodes_x if k == "probe_turret" else nodes_m), ("rods", rods_m)):   # the turret's collar and RM's ring are one print
            if o.contains(meshes[k].vertices).any() or (meshes[k].is_watertight and meshes[k].contains(o.vertices).any()):
                clash.append(f"{k} x cage {nm}")
    out["probe vs cage"] = ("clear" if not clash else "CLASH: " + ", ".join(clash), "every probe part against the cage's nodes, sockets and rods (parked)")
    rd = roller_drag(); r4 = roller_drag(0.4)
    out["roller drag"] = (f"{rd['drag']['full']:.1f} N mm at the spool (mu {ROLLER['mu']}; {r4['drag']['full']:.1f} at 0.4)", f"the O{2 * ROLLER['r']:.0f} roller on its M3 axle, no bearings: the stroke's worst 292 + it = {rd['need']:.0f} against the N20's 417..612, {rd['margin'][0]:.2f}..{rd['margin'][1]:.2f}x ({r4['margin'][0]:.2f}x at mu 0.4)")
    gap, hit = tilt_sweep()
    out["head tilt sweep"] = (f"clear, {gap} over the base plate" if gap > 0 and not hit else f"HITS at {hit} deg, gap {gap}", f"the cradle, camera and LED bars over {HEAD['range'][0]:.0f}..+{HEAD['range'][1]:.0f} deg")
    for nm in ("frame",):
        v = np.asarray(meshes[nm].vertices); top = v[:, 2].max()
        out[f"{nm} to discs"] = (round(min(disc_dist(p) for p in v if p[2] > DECK_Z0 - 7), 1), f"top z {top:.1f}; the props sweep down to {Z_PROP - Z_SWEEP:.1f}")
    return out


def write():
    meshes = {}
    meshes["frame"] = frame()                                                        # 9 Nov: deck, arms, pods, lugs and the base in one body (parts/scout_v4_frame)
    for k, (mx, my) in enumerate(MOTORS, 1):
        sx, sy = np.sign(mx), np.sign(my)
        meshes[f"motor_{k}"] = moved("scout_motor_" + str(k), sx * (HUB - 54.1), sy * (HUB - 54.1), DECK_TOP - 22.0)
        meshes[f"prop_{k}"], meshes[f"blades_{k}"] = prop(mx, my)
    meshes.update(probe())
    meshes["probe_mast_a"], meshes["probe_mast_b"] = mast()
    meshes["scout_flow_mtf_02p"] = place("scout_flow_mtf_02p", rot=([0, 0, 1], 90), lo=FLOW_LO)   # turned 90 deg, forward of latch v7's receiver room (14 Nov)
    # 9 Nov (one body, the nose bay gone): the FC and the Radxa hang under the deck over the receiver on posts (inserts in the deck),
    # the XR2 and the DRV8833 flat on tape lands beside the FC, the UBEC on the tail tray's floor across the drone
    meshes["fc"] = place("fc", lo=(FC_X[0], FC_Z0))                                  # 36 square, component side up, its posts down from the deck
    meshes["radxa_zero_3w"] = place("radxa_zero_3w", rot=([0, 1, 0], 90), lo=(-73.9, 10.4), yc=0.0)
    meshes["radxa_zero_3w"].apply_transform(trimesh.transformations.rotation_matrix(math.pi / 2, [0, 0, 1], meshes["radxa_zero_3w"].bounds.mean(0)))   # 65 along x
    meshes["radxa_zero_3w"].apply_translation([-73.9 - meshes["radxa_zero_3w"].bounds[0][0], 0, 0])   # 11 Nov: its front 0.4 off the turret's N20 cheeks (x -8.5)
    meshes["ubec"] = place("ubec", lo=UBEC_LO, yc=UBEC_YC)                           # 61 along y, hung under its land below the tail tray (11 Nov)
    meshes["xr2"] = place("xr2", rot=([0, 0, 1], 90), lo=(4.0, 10.0), yc=28.5)        # flat, 34.5 x 13 x 4, under its land at +y
    meshes["xr2"].apply_transform(trimesh.transformations.rotation_matrix(math.pi / 2, [1, 0, 0], meshes["xr2"].bounds.mean(0)))
    meshes["xr2"].apply_translation([0, 0, 10.0 - meshes["xr2"].bounds[0][2]])
    meshes["drv8833"] = box(4.0, 22.5, -38.8, -22.8, 10.0, 13.0)                     # KOOBOOK DRV8833 18.5 x 16 (listing), ~3 thick E, flat under its land at -y
    # the battery mechanism (receiver, cartridge, pack, its feet and pads) is not part of this design: it mounts on receiver_bolts
    meshes["receiver_bolts"] = receiver_bolts()
    meshes["cage_rods"], _ = cage()
    for k in NODE_PARTS:                                                             # the 16 generated cage nodes: a sphere until the run lands
        meshes[f"node_{k.lower()}"] = trimesh.creation.icosphere(subdivisions=1, radius=6.0).apply_translation(P(k))
    for nm, m in meshes.items():
        d = os.path.join(ROOT, "parts", f"scout_v4_{nm.replace('box_ctx_scout_', '').replace('scout_', '')}"); os.makedirs(d, exist_ok=True)
        if os.path.exists(os.path.join(d, "result.json")) or os.path.exists(os.path.join(d, "make.py")):   # a generated part whose run has landed, or a drawn part (make.py): its part.stl is its own, never overwritten
            meshes[nm] = trimesh.load(os.path.join(d, "part.stl"), force="mesh"); continue
        m.export(os.path.join(d, "part.stl"))
    return meshes


def core_of(frame_g=None):
    """the frame model's core (13 Nov, the architecture review): every assembly row but the cage's rods and the node parts (the frame model
    adds its own NODE_G per node: they were counted twice) plus the battery set on its bolts, at its real CG (each row's mesh centre; the
    frame model had the origin): (g, cg). frame_g: the frame's mass in place of its row (a variant's own setup mass)"""
    rows = json.load(open(os.path.join(ROOT, "systems", "scout_v4.assembly.json")))["parts"]
    g, s_ = 0.0, np.zeros(3)
    for r in rows:
        if "cage" in r["id"] or r["id"].startswith("scout_v4_node_"):
            continue
        mg = frame_g if (frame_g is not None and r["id"] == "scout_v4_frame") else r["mass_g"]
        f = os.path.join(ROOT, r["mesh"])
        try:
            t = trimesh.load(f, force="mesh"); c = t.center_mass if (t.is_watertight and abs(t.volume) > 1e-6) else t.bounds.mean(0)
        except Exception:
            c = np.zeros(3)
        g += mg; s_ += mg * np.asarray(c)
    bc = np.array(BATTERY_SET[1]) + [BX, 0, 0]
    g += BATTERY_SET[0]; s_ += BATTERY_SET[0] * bc
    return g, s_ / g
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
