sparkiscool/noxen/(commit log)

2026-10-28 Nox frames: engine, three test parts, workflows, viewer
    [arm_1.stl, arm_2.stl, arm_3.stl, arm_4.stl, bottom_plate.stl, buck_12_v.stl, cage_shell_nodes.stl, cage_shell_tubes.stl]
2026-10-28 review card: preview, numbers, feedback.md, rerun; strength gate max_worst; motor_mount h 1.2
    Claude-Session: https://claude.ai/code/session_01EtHMZNS4x2koTeepuXgGgF
2026-10-28 results: [motor_mount,holder,hub_deck]
    [part.stl]
2026-10-28 results: [hub_deck]
    [part.stl]
2026-10-28 results: [holder]
    [part.stl]
2026-10-28 predict.py: run-time prediction from past runs; CI appends runtimes; check-in flow in CLAUDE.md
    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
2026-10-28 migrate both drones: Overseer + Scout assemblies, current meshes, dimensions, parts list; hub_deck is the v12 setup
    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
    [arm_1.stl, arm_2.stl, arm_3.stl, arm_4.stl, bottom_plate.stl, buck_12_v.stl, cage_shell_nodes.stl, cage_shell_tubes.stl]
2026-10-28 build_site --inline: one self-contained page per drone, the drone's artifact, built by CI on every result; the checkout must be at origin/main; artifact URL and title in each assembly; check-in repub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
    Claude-Session: https://claude.ai/code/session_01EtHMZMuNjDDQVJhg2Wn7rq
2026-10-28 the drone artifact page is the motion page (tools/motion.py from nox): parts by group and colour, the assembly's overlays (swept props, L2 field, camera views), turntable; colours, groups and overlay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
2026-10-28 cage_shell_nodes: the 24 saved v5 nodes in the drone frame (15 saved designs + 9 mirrors, 289 g), in place of the layout model
    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
    [part.stl]
2026-10-28 build_site: an assembly entry may take its mesh and status from another part's folder (`part`), for mirrors; systems/overseer.cage.json: cage v5 geometry, links and the frame model's socket loads for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
2026-10-28 WIP: cage node and head mount setups in progress (not on main: no runs until the audits pass)
    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
2026-10-28 WIP: overseer assembly entries for the node, head mount and arm setups in progress (session branch only)
    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
2026-10-28 WIP: head mount L2 slot keys, node and arm setups in progress (session branch only)
    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
2026-10-28 WIP: node, arm and rear camera setups in progress (session branch only)
    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
2026-10-28 WIP: arms, rear camera and node 17 in the assembly; ESC off the arms; CLAUDE.md one session per batch (session branch only, audits running)
    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
2026-10-28 WIP: audit smoke leftovers (session branch only)
    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
    [part.stl]
2026-10-28 undo the audit smoke leftovers on node 2 (the smoke writes a 1-iteration result; CI makes the real one)
    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
    [part.stl]
2026-10-28 cage v6 (Spark 28 Oct, rod cut): nodes 21, 22, 23 removed, their 12 tubes replaced by 7-9, 7-10, 7-20; 54 tubes, 21 nodes, shell closed, probes as v5; tube mesh, assembly, dimensions; arm lib: ESC le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
    [part.stl]
2026-10-28 results: [overseer_cage_node_2,overseer_cage_node_3,overseer_cage_node_4,overseer_cage_node_5,overseer_cage_node_6,overseer_cage_node_7,overseer_cage_node_10,overseer_cage_node_11,overseer_cage_node_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
    [part.stl]
2026-10-28 results: [overseer_cage_node_2]
    [part.stl]
2026-10-28 results: [overseer_cage_node_5]
    [part.stl]
2026-10-28 results: [overseer_cage_node_4]
    [part.stl]
2026-10-28 results: [overseer_arm_front,overseer_arm_rear,overseer_cage_node_10,overseer_cage_node_11,overseer_cage_node_13,overseer_cage_node_15,overseer_cage_node_18,overseer_cage_node_2,overseer_cage_node_20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
    [part.stl]
2026-10-28 results: [overseer_head_mount]
    [part.stl]
2026-10-28 WIP: drawn gussets (node arms + foot stem, head mount key stems and boss pads, rear camera boss pads), node 3/4/7 budgets, audit gusset rule + test (session branch only, validation running)
    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
2026-10-28 WIP: gusset rule 5 mm on loaded bodies only, node arms O5.5, boss flanges thinner (session branch only, validation running)
    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
2026-10-28 WIP: rear camera node 21 (sunk 45 mm in the rear facet on three 3 mm rods to 13, 14, 5), clamp mount retired, camera back plates (session branch only, audits running)
    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
    [part.stl]
2026-10-28 WIP: node 21 and head mount cameras lighter (O10 x 6 bosses, 2 mm frame, 2.5 cm3), node arms O5 (session branch only, audits running)
    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
2026-10-28 arms: drone-frame placeholder meshes (drawn bodies + a bar) until the runs land; the old rear v5d mesh was in its own frame and sat at the origin on the artifact
    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
    [part.stl]
2026-10-28 results: [overseer_cage_node_21,overseer_cage_node_3,overseer_cage_node_4,overseer_cage_node_7,overseer_head_mount]
    [part.stl]
2026-10-28 WIP: solid gate speck filter (pieces under 1 mm3 are dust, not bodies): session branch only, pending Spark's decision; not on main
    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
2026-10-28 solid gate: pieces under 1 mm3 are voxel dust, not bodies (node 7 '3 bodies' were two voxels, node 21 and the head mount's 'split-off' drawn cores were sub-mm3 specks), with a test; the gusset audit 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
2026-10-28 results: [overseer_cage_node_2,overseer_cage_node_3,overseer_cage_node_4,overseer_cage_node_5,overseer_cage_node_6,overseer_cage_node_7,overseer_cage_node_10,overseer_cage_node_11,overseer_cage_node_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
    [part.stl]
2026-10-28 results: [overseer_cage_node_2,overseer_cage_node_3,overseer_cage_node_5,overseer_cage_node_6,overseer_cage_node_10,overseer_cage_node_11,overseer_cage_node_13,overseer_cage_node_15,overseer_cage_nod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
    [part.stl]
2026-10-28 results: [overseer_arm_rear]
    [part.stl]
2026-10-28 results: [overseer_cage_node_7]
    [part.stl]
2026-10-28 repo front page shows the current drones: tools/snap_site.py screenshots each built viewer page in headless Chromium, the site workflow runs it and serves site/<drone>.png on Pages, the README embeds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
    [snap_site.py]
2026-10-28 a result is stale when an imported parts/ lib changed, not only part.py: tools/part_sha.py (part_sha + lib_sha, written by the run, read by stale_parts and build_site); checkpoint cache keys include 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
2026-10-28 front page: Overseer only for now, pictured from the front with the L2 and cameras to the viewer (readme_view in the assembly; the snapshot stops the turntable at frame 0)
    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
2026-10-29 front cameras yawed 20 out, was 45 (Spark 29 Oct: one solid window ahead, no blind strip): the smallest yaw that keeps the L2 body out of both views, overlap 49 deg, solid from 165 mm ahead of the le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
    [part.stl]
2026-10-29 parts.yml: a run that ends without result.json ships no mesh or preview (the rear arm's cap-time mesh, in grid coordinates at the origin, was committed and shown as the part); rear arm placeholder re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
    [part.stl]
2026-10-29 big parts: the run refuses a grid over 300k cells (the arms at 1.0 M fell to multigrid, which never converged: 3 attempts, 16 h, not one fine iteration); the audit refuses an envelope that cannot fit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
2026-10-29 front arm in two bolted prints (Spark 29 Oct: every print fits the 180 plate): root piece (plate bosses to the joint, 144 x 51) and tip piece (joint to the motor pad with the spoke sockets, 82 x 63),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
    [part.stl]
2026-10-29 front arm root piece: placeholder mesh for the page until its run lands
    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
    [part.stl]
2026-10-29 results: [overseer_arm_front_root,overseer_arm_front_tip]
    [part.stl]
2026-10-29 cage nodes: no carbon touching carbon (Spark 29 Oct): a socket starts 10.15 from the node centre or further out where two members meet at a small angle, so every bore clears its neighbours by a 2 mm 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
    [part.stl]
2026-10-29 arms: support lips and bolt seats 2.5 thick (1.0 / 1.2 held no cell at the coarse pitch 4.0: the rear arm and the root piece crashed in 2 minutes with no result, shown as success); parts.yml: a crash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
    [overseer_arm_lib.py, part.py]
2026-10-29 checkpoints resume only their own setup: topo/run.py tags ck_setup.npz with the part + lib hash and deletes ck*.npz from another setup; parts.yml: the older-key fallback removed (it resumed nine node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
2026-10-29 page: the 3 mm rods (spokes, core and bay ties, head rods) drawn from the cage v6 links cut to their socket starts (tools/cage_tubes.py), replacing the v5 layout model's rods; their cut lengths join 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
    [part.stl]
2026-10-29 cage: the two bay ties on each side crossed with their axes 1.2 mm apart (two 3 mm rods through each other); their hub ends spread 5 mm in y (+1 ties to |y| 61, -1 ties to 51): 5.6 mm between axes; r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
    [part.stl]
2026-10-29 results: [overseer_arm_front_tip]
    [part.stl]
2026-10-29 results: [overseer_arm_front_root,overseer_arm_rear]
    [part.stl]
2026-10-29 cage loads from a frame model in the repo (tools/cage_loads.py): the core a free rigid body with its mass, the arms PETG beams at their stiffness, the drone decelerating 35 g onto each hull face its 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
    [cage_loads.py, overseer_arm_lib.py, part_sha.py]
2026-10-29 results: [overseer_cage_node_11,overseer_cage_node_18,overseer_cage_node_5]
    [part.stl]
2026-10-29 results: [overseer_arm_front_tip,overseer_arm_front_root,overseer_arm_rear]
    [part.stl]
2026-10-29 head rod c dropped (Spark 29 Oct: node 17 is printed into the head mount since 28 Oct, so the rod joined the mount to itself; it had no socket in the mount setup but was still in the cage links, the 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
    [part.stl]
2026-10-29 engine: thick drawn bodies erode as the gate erodes them (topo/layout.py, masked mode): a body keeps only the core the solid gate keeps (the part eroded by clip(0.8 x its half thickness, 0.9, 2.0) mm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
2026-10-29 results: [overseer_arm_front_root]
    [part.stl]
2026-10-29 checkpoints depend on the engine too: tools/part_sha.py engine_sha (topo/*.py), in run.py's ck_setup tag and in parts.yml's cache keys (29 Oct: the rear arm resumed its old checkpoint after the engin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
    [part_sha.py]
2026-10-29 results: [overseer_cage_node_2,overseer_cage_node_3,overseer_cage_node_4,overseer_cage_node_6,overseer_cage_node_7,overseer_cage_node_10,overseer_cage_node_13,overseer_cage_node_15,overseer_cage_node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
    [part.stl]
2026-10-29 arms: plate bosses are blocks (u 57.5..72, |v| 3..22, 8 tall per face), not r 5.5 stadiums 5.6 thick: the stadium's core at the gate's 2 mm erosion was slivers between the two shank holes, so no join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
    [overseer_arm_lib.py, part.py]
2026-10-29 page: the props are two-blade 10 x 4.5 models (tools/props.py), not solid discs r 127 (Spark 29 Oct: props that do not take up the view); the swept disc stays as the thin-line overlay and is what the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
    [part.stl]
2026-10-29 head rods are 6/4 tubes at nodes 15 / 16 too (cage_node_lib: kind tube for "head rod"; the mount bored them 6.2 x 15 per the brief while the nodes bored them 3.2 as rods), and the page runs each one 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
    [part.stl]
2026-10-29 page: mesh face budget 40k -> 24k so the inline page stays under the 16 MB artifact limit (16.8 MB with the props)
    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
2026-10-29 node 21 (rear camera node) slimmed (Spark 29 Oct: "not very optimised"; 8.7 g of which 5.5 drawn, index 0.09 on 100 N rod estimates): insert bosses O7.6 (was O10), the drawn 38 x 38 frame between the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
2026-10-29 front arm root: one joint block at the joint face (7 thick, |v| <= 19, z 7..37, a O10 window in the middle; the pin collars run on behind it), replacing the 2 bolt bosses and 2 pin collars as separat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
2026-10-29 results: [overseer_cage_node_21]
    [part.stl]
2026-10-29 front arm root budget 40 -> 50 cm3 (with the joint block it passed the solid gate for the first time, 73.6 g, and failed strength at 0.72 in the stiffness case at the top plate block's outer edge); n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
    [part.py]
2026-10-29 results: [overseer_arm_front_tip,overseer_arm_front_root,overseer_cage_node_3,overseer_cage_node_4,overseer_cage_node_5,overseer_cage_node_11,overseer_cage_node_18,overseer_cage_node_2,overseer_cage_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
    [part.stl]
2026-10-29 results: [overseer_arm_front_root,overseer_cage_node_21]
    [part.stl]
2026-10-29 parts.yml: a run that ends late never puts a stale result over a current one (the 07:41 node batch, ending 12:22, put the tip's and root's 07:41 results back over the ones committed at 10:52)
    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
2026-10-29 engine: a drawn body erodes to its gate core only when at least 6 mm thick (core >= 2 mm); thinner bodies stay whole (node 5 at h 1.2: its 2.5 mm organic skins and 3 mm foot kept 280 core cells again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
2026-10-29 engine: near_sym (a part's own choice in SPEC settings): a part mirrored but for a detail (under 2 % of passive cells) is held symmetric on the design cells whose mirror is design too, free within tw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
    [part.py]
2026-10-29 sockets as the coupons that fit (Spark 29 Oct): cage_node_lib.socket_cuts for every epoxied bore in nodes, arms and the head mount: bore 6.2 / 3.2, two resin grooves 0.5 x 1.5 at a third and two thir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
    [cage_node_lib.py, overseer_arm_lib.py, part.py, recut.py]
2026-10-29 camera seats on standoffs (Spark 29 Oct: the board's plugs sit on its back near the holes): head mount and node 21 carry each camera on 4 cones 10 long, O7.6 at the board (2.2 wall round the O3.2 x 5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
    Co-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
2026-10-29 arms: exact motor holes, one pair across at r 8 (16) and one at r 9.5 (19) on the 45 deg lines (Spark 29 Oct: the X2216 pattern is 16 x 19; was a slot 8..9.5 at all four); the motor bolt load points 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
2026-10-29 arms: super light (Spark 29 Oct: light topology that still bolts to the plates): the arm-alone case is HANDLING (the 96 g motor at 2 g, no thrust, no spokes: the arm is the jig that holds the motor a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
2026-10-29 tube arms (Spark 29 Oct: as light as possible, no line-up precision, glued, no clamps): parts/overseer_tube_arm_lib.py; per arm a printed ROOT block between the plates (plate boss blocks, pegs, two 6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
    [part.stl]
2026-10-29 spokes 12 -> 8 (Spark 29 Oct: as light as possible): the frame model's what-if (tools/cage_loads.py drop=) shows the four .2 spokes, all to nodes 3 / 1, carried 76..204 N and that without them every 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
    [part.stl]
2026-10-29 results: [overseer_arm_front_root,overseer_arm_front_tip,overseer_arm_rear]
    [part.stl]
2026-10-29 arms: the cancelled light one-piece run (54) still committed results at 20:46 and recreated the deleted tip and rear parts and put the split root's result into the tube root's folder: both folders re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
    [part.stl]
2026-10-29 hub deck v13: the two front core ties end in a nose node on the hub deck, not in the air
    Spark 29 Oct: the rods floating at the nose by the front arm roots belong to the electronics mount, and the rods may grow. Until now core tie front.1 (to node 7) and front.2 (to node 17) ended at the deleted tower's point (114, 0, 20). The hub deck's nose now carries two coupon sockets as the cage nodes (cage_node_lib: bore 3.2 x 10, grooves, lead-in, crown, wall 2.5, floor 3.0): front.2 keeps its line (node 17 is printed into the finished head mount), virtual centre (83, 0, 16.5); front.1 is re-aimed to (86, 12, 2), beside front.2 over the left front foot (a socket above front.2 on the old line put the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
    [part.stl]
2026-10-29 results: [overseer_arm_front_pad,overseer_arm_front_root,overseer_arm_rear_pad,overseer_arm_rear_root]
    [part.stl]
2026-10-29 predict.py: fit over every engine's history, not the 1..3 runs since the last tag reset
    29 Oct: with the engine tag reset to nearsym the predictor had 3 runs (one a 1.4 min cut-off) and gave the node batch 10..25 min; the nodes were 2 h in. Now: runs under 3 min dropped (audit refusals, cut-offs); one log-log slope shared across engines, an intercept per engine, the current engine's from its own runs once it has two, else the latest engine's; safety = the 80th percentile of actual / fit over the latest engines back to 10 runs (1.6 now), at least 1.25; MIN_CHECK 60 (check-ins never under an hour, CLAUDE.md). Backtest on the last 28 runs: within the safety band except nodes 4 / 5 / 15 (up to 2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
    [predict.py]
2026-10-29 rear arms: one printed PETG piece, no tubes, no spokes (Spark 29 Oct)
    Spark: spoke 2.3 ran through the rear motor pad and the rear end sits close to the body anyway, so no rods there, fully printed. parts/overseer_arm_rear (v9: Arm with no spokes, h 2.0, gen 32 cm3 E) replaces the tube-arm root + pad pieces; the arm lib takes an arm with no spokes (the flight cases then hold at the plates alone). Cage: spokes 2.1 / 2.3 / 3.1 / 3.3 removed (21 links), the rear arm tubes out of the rod mesh and cut list (17.18 m); the frame model carries a spoke-less arm as a PETG cantilever (PETG_ARM) and was rerun: the core hangs on 4 spokes + 12 ties, ties up to 388 N, tube 11-13 454 N, buckling 0.77, rear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
    [part.stl]
2026-10-29 hub deck v14 (v13 failed at the nose), node 21's third rod to node 20 instead of 5 (Spark 29 Oct)
    hub deck v13 (36 min, 35.7 g) FAILED: index 2.1 across layers at the front.1 collar on the left front foot in the +x crash, 1.3 at the front.2 collar under its 411 N pull-out, and a drawn body cut off at the gate: 14 cm3 spread over the whole deck left the nose thin. v14: nose collars 4.0 (NOSE_WALL), the nose room back to x 78 and out to |y| 26 over both front feet, z 26, gen 22, h 1.3 (249k cells).
    node 21 (Spark: no rod in the way of mounting the camera): the rod to node 5 ran straight down 1 mm behind the board's lower edge, through the plug zone behind the board. It now goes to node 20, fo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
    [part.stl]
2026-10-29 cage tube mesh regenerated with the rod set of 29 Oct (tools/cage_tubes.py)
    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
    [part.stl]
2026-10-29 node 5: 4.5 cm3 (3.5 gave 16.0 g at index 0.56, landing on the foot, run 51) and the camera rod socket gone (the rod goes to node 20 now)
    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
2026-10-29 results: [overseer_arm_front_tip,overseer_arm_rear,overseer_arm_front_root,overseer_cage_node_2,overseer_cage_node_3,overseer_cage_node_4,overseer_cage_node_6,overseer_cage_node_7,overseer_cage_node_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
    [part.stl]
2026-10-29 a superseded part never keeps running (Spark 29 Oct); audit measures a drawn body to the cell; hub deck v14 under 180; front pad 12 cm3
    Spark: "there should never be an old part still running when new designs require a new part; if something is affected it needs to be redone." topo/run.py design_hash: the setup's masks, supports, loads and SPEC as a sha (--design-hash prints it). parts.yml: the run job's watchdog fetches main every 3 min and, when a design file changed there, builds main's setup in a worktree and stops the engine if the hash differs or the part is gone (no result, nothing committed, exit 0 with a notice); the dispatch dedupe skips a part running elsewhere only when that run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
    [part.py]
2026-10-29 remove what the cancelled run 53 put back: the obsolete front tip and the old one-piece rear arm's result in the new rear arm's folder (its placeholder restored)
    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
    [part.stl]
2026-10-29 results: [hub_deck,overseer_arm_front_pad,overseer_arm_front_root]
    [part.stl]
2026-10-30 results: [overseer_cage_node_21,overseer_head_mount]
    [part.stl]
2026-10-30 cage_node_lib: a tube whose far end is a printed part has no node socket to check (node 15 crashed at setup on head rod +1)
    Since 468ead7 the head rods are kind tube, and check_members looked for the matching socket at the far node of every
    tube; the head rods end in the head mount (which bores them 6.2 x 15 itself), so the far node is None and node 15 (run
    53, run 62) died before the run: "head rod +1: no socket at node None". Node 16 shares it. The far-end check now
    applies only when the far end is a cage node; the audit smoke of node 15 passes (drawn 4 %, room ok).
    Claude-Session: https://claude.ai/code/session_01EtHMZMuNjDDQVJhg2W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
    [cage_node_lib.py]
2026-10-30 results: [hub_deck,overseer_cage_node_21]
    [part.stl]
2026-10-30 hub deck: v14's result back (run 59, old workflow, committed the v13 result it had checked out over it)
    Run 59 started before the "stale never overwrites" guard (6c95f49); its commit job put the v13 hub deck files
    (part_sha 37ec87b8, 35.7 g, index 2.14) back over v14's (aa7c70d: bdb6cefe, 47.7 g, index 1.08). Restored from aa7c70d.
    Every run started after c331d5f carries the guard; run 60 (node 5) and run 62 are the last of the old ones.
    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
    [part.stl]
2026-10-30 camera standoff coupon (Spark 29 Oct: the O7.6 -> O11 x 10 cones do not clear the board, "twice as small and thin"; print the coupon before changing anything, and nothing is rerun for the change)
    parts/camera_standoff_coupon: drawn only (make.py, no part.py, so parts.yml never runs it). A 132 x 44 x 3 strip with three
    28 x 28 patterns of 5 mm standoffs: A O5.6 round the O3.2 x 5.7 insert hole (1.2 wall), B O6.0 with an O2.1 x 6 hole for
    the M2.5 screw tapped into PETG (1.95 wall, no insert), C O7.6 insert hole (today's wall, half height); 1 / 2 / 3 pips.
    24 g. The solid gate flags A's wall (1.5 measured), which is what the coupon tests. Registered in the test parts assembly
    and dimensions.md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
    [part.stl]
2026-10-30 base v1 (Spark 29 Oct): the battery part takes whatever design comes later on 4 M3 inserts; the cage can be built now
    parts/overseer_base: one PETG piece under the bottom plate ending the ten links that had no hub part (core ties rear.1/.2,
    left.1/.2, right.1/.2 and the four bay ties) in coupon sockets at their existing hub ends, so no rod, node or cut list
    moves and nothing reruns. Clamped under the plate by the eight arm bottom screws (M3 x 8 -> M3 x 14) on O9 pads: no new
    holes in the carbon. Four M3 x 5.7 inserts from below in O11 bosses on z -8.1 (the latch set's receiver mount plane),
    80 x 50 at (-60, +-25), (20, +-25); the slot below z -8.1 stays empty for the future mechanism. Loads: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
2026-10-30 hub deck v15 (nose root room: x 70..104, y +-30, z 0..28, 28 cm3) and front arm root 9 cm3 (Spark 29 Oct: send the waiting parts to be worked on)
    Hub deck v14 (run 61): index 1.08 across layers at the front.1 collar mouth in the +x crash and the merged nose collars
    99.7 % off the main body after the gate's 2 mm erosion: a 17 mm tower on a 6.5 mm deck with room only x 78..104, y +-26.
    The rod lines stay (node 7 and the rods do not move); the nose room grows and the volume 22 -> 28 so the engine builds a
    wide root into both collars. Grid 249k at h 1.3 (unchanged). Front root (run 61): 0.70 at the socket face under spoke 1.3
    at -270 N with 6 cm3; 9 cm3 for ~0.47 (E). Its 1.1 mm sliver and the r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
    [part.py]
2026-10-30 assembly: the flow clip is the printed v1 clip (parts/overseer_flow_clip, 5.0 g M), not core v2's concept block (Spark 29 Oct: "it's just a block")
    parts/flow_clip/part.stl was the 132-face concept body from nox/overseer/core_v1.py; the real clip, pocket, lens window
    and flange, sat unreferenced in parts/overseer_flow_clip. Posed by its flange holes (96, +-17) and the lens at z -8.6.
    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
2026-10-30 camera standoffs: O5.6 x 10 straight posts with the O3.2 x 5.7 M2 insert (Spark 29 Oct, coupon A fits; the cones did not clear the board) [skip ci]
    Head mount and node 21: CAM_TIP_R / CAM_BASE_R and BOSS_R / BOSS_BASE_R 3.8 / 5.5 -> 2.8 / 2.8. Posts stay 10 long: Spark, with
    5 the plug and its wire do not fit behind the board. The screws are M2, not M2.5 (dimensions). The 1.2 wall is Spark's
    accepted exception to the 2 mm rule (CLAUDE.md); the gate's declared-thin allowance comes from the engine session.
    [skip ci]: no rerun. The head mount gets the posts by tools/recut.py once the gate allows them; node 21 is dispatched by the
    engine session after its export cleanup lands, with this setup.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
    [part.py]
2026-10-30 systems/lights.md: Overseer camera lights research (Spark 30 Oct: what light is best); recommendation: three Cree CXB1304 90 CRI COBs on LDD-350L constant-current drivers, one per camera, 10..20 ms e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
    Claude-Session: https://claude.ai/code/session_01EtHMZPCpk2zXMdS11SZKrr
2026-10-30 results: [hub_deck,overseer_arm_front_root]
    [part.stl]
2026-10-30 lights: the Amazon build (Cree XP-L HD 3-up star 4000 K, LDD-350LW, 25 mm sink; rear camera options); CLAUDE.md: every bought part is proposed with an Amazon listing (Spark 29 Oct)
    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
2026-10-30 head mount v7: one camera light per front camera (Spark 29 Oct approved; systems/lights.md), 45 below the lens, face flush with the lens front [skip ci]
    Pad 27 x 27 x 3 with two M3 insert bosses at 20 mm centres, a 28 x 28 x 14.5 keep-out ahead of the pad for the 25 mm sink +
    XP-L star + standoffs, design room round the pad, 12 g (E) at the sink centre in every head case. Below the lens, not the
    research's 45 outboard: that sits at |y| 117, outside the 180 plate; above the lens is 4 mm from the head rod seat.
    Assembly: camera_light_left / right and two LDD-350LW drivers on the hub deck as placeholders; the frame model counts the
    lights in the head (rerun with the batch). Dimensions row. [ski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
    [cage_loads.py, part.py]
2026-10-30 dimensions: two camera lights in the front, none in the back (Spark 29 Oct)
    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
2026-10-30 engine: export cleanup, gate measures, declared-thin bodies (29 Oct: four strong results failed the gate on surface detail)
    topo/build.py export_cleanup, before the STL is written: voxel specks under 1 mm3 and surface slivers under the 2.0 wall
    floor with under 10 mm3 of core (the gate's own thin-wall measure) are subtracted from the exact part; drawn bodies and
    every member over 2.0 untouched; result.json "export_cleanup" lists what went. The rear arm (1.41 mm, 6.7 mm3) and the
    front arm root (1.12 mm, 3.6 mm3) meshes pass the gate through it (37 / 33 mm3 removed).
    tools/solid_check.py: thin_walls factored out and shared; drawn_not_in_main entries are dicts with at / mm3 of the detached
    co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
    [part.py, recut.py, solid_check.py]
2026-10-30 results: [overseer_cage_node_5] re-gated with the fixed gate (tools/recut.py, engine 5989a12): solid PASS, 16.6 g, index 0.26, no rerun
    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
    [part.stl]
2026-10-30 no camera lights (Spark 29 Oct, 8 pm): head mount back to the posts-only setup, light placeholders and drivers out of the assembly [skip ci]
    The two-light v7 setup (f9a43b9) is reverted to the O5.6 x 10 M2 posts with the engine session's thin_ok declaration; the
    research stays in systems/lights.md. The running two-light head mount job (run 67) stops itself on this push (design hash);
    the posts go into the PASSED v6 mesh by tools/recut.py, no rerun. [skip ci].
    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
    [cage_loads.py, part.py]
2026-10-30 recut: repair the loaded STL before the boolean (merge vertices, drop degenerate and duplicate faces, fix normals)
    The head mount's 500k-face part.stl read as NotManifold (volume 0) and the recut crashed in export_cleanup on an empty
    mesh (29 Oct). After the repair it reads as 80.8 cm3. A mesh that still has no volume now raises with the manifold status.
    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
    [recut.py]
2026-10-30 results: [overseer_base]
    [part.stl]
2026-10-30 assembly: front arm pad, node 5 and flow clip are FINAL, printed 29 Oct (Spark: unless brought up again for a rerun)
    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
2026-10-30 auto mode (Spark 29 Oct, 8:40 pm): base v2 (side room y +-84 / z 8, h 1.7, 30 cm3), hub deck v16 (nose wall 5, 32 cm3), front root v3 (12 cm3)
    Base v1 (run 64): index 2.09 at the left side socket in the sideways crash and collars hanging off the main body: the
    sockets beside the plate had an 11 mm strip of room while their bores reach y 79 and collars 83. Room to y +-84 and z 8
    (168 wide, under the plate), h 1.7 (1.6 is 301k cells), 30 cm3 (v1 came in at 44 g). Hub deck v15 (run 65): gate OK,
    0.67 across layers at the front.1 mouth: wall 4 -> 5, 28 -> 32. Front root v2 (run 65): 0.54 at the socket face: 9 -> 12.
    Audit smokes OK (base drawn 3 %, deck 13 %).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
    [part.py]
2026-10-30 assembly: the battery, cartridge and receiver designs are out of the Overseer for now (Spark 29 Oct); one placeholder box in the slot keeps their mass
    The future mechanism bolts up into the base's 4 M3 inserts on z -8.1. The placeholder keeps the latch set's 1000 g at the
    slot's centre so the frame model's balance and the base's loads do not change. Dimensions row.
    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
2026-10-30 assembly: rear arms (overseer_arm_rear and its mirror arm 3) are FINAL, printed 29 Oct (Spark)
    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
2026-10-30 page: stray shells dropped before decimation (node 5 looked torn), battery placeholder gone, rod saw guide drawn (Spark 29 Oct)
    tools/build_site.py view_mesh: an exported STL carries loose triangles and 1-3 face shells beside the part (node 21: 126)
    and the quadric decimation of such a mesh tears it (node 5 on the page lost 25 % of its volume: Spark, "node 5 looks weird
    and unrendered"); only closed shells of 1 mm3 or more are kept, a volume loss over 2 % is printed. MAX_FACES 24000 -> 20000
    (15.2 MB at 24k with 58 parts). Node 5's STL is the run's own export (a3daf89, watertight, 13046 mm3): the recut export of
    the same geometry had 467 open edges and 1803 degenerate faces; the gate passes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
    [part.stl]
2026-10-30 results: [overseer_cage_node_2,overseer_cage_node_3,overseer_cage_node_4,overseer_cage_node_6,overseer_cage_node_7,overseer_cage_node_10,overseer_cage_node_11,overseer_cage_node_13,overseer_cage_node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
    [part.stl]
2026-10-30 engine: one watertight export (29 Oct: STLs with open seams, stray shells; the page's decimation tore node 5 open)
    Cause: a boolean whose surfaces nearly coincide (the organic surface meeting a cut face; tools/recut.py cutting the holes a
    mesh already has) leaves sliver triangles thinner than float32 resolution (1.5e-5 mm at 250 mm). The exact manifold is
    closed, but an STL carries only float32 positions: every reader welds those vertices and gets non-manifold edges and
    degenerate faces (node 5's recut: 1,473 zero-area faces, 845 shells after welding), and dropping the degenerates opens
    seams (467 edges). tm()'s process=True did that welding at export without removing the collapsed faces: th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
    [part.stl]
2026-10-30 results re-exported watertight: nodes 4, 6, 10, 11 (tools/weld_stl.py on the bc832ef results, same geometry, no re-solve); the head mount v6 STL does not weld closed and stays
    Claude-Session: https://claude.ai/code/session_01EtHMZLPhW3jvmSpVPN7bwX
    [part.stl]
2026-10-30 recut: overseer_head_mount
    [part.stl]
2026-10-30 auto mode (30 Oct 10 pm): node 2 budget 2.3 -> 4.5, node 6 (and mirror 8) 2.7 -> 3.5 after run 62
    Node 2: 1.62 on the tube 1-2 pull-out (285 N) and both spoke collars hanging on 1.8 mm necks; the audit's room behind every
    socket is 0.93 with 53 mm of depth, so the setup had room and too little volume: four sockets at 230-285 N plus the landing
    foot on 2.3 cm3, the budget of node 20 (one 125 N tube). Its peers carry 196 / 326 N at 4.5 / 4.3 (nodes 4 / 10, 0.17 / 0.21).
    Node 6: 0.54 on the tube 6-18 pull-out (248 N), gate OK, room 0.90-0.94: 3.5 cm3. Both rerun from this push.
    Claude-Session: https://claude.ai/code/session_01EtHMZMuNjDD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
2026-10-30 auto mode (30 Oct 10 pm): node 20 budget 1.7 -> 2.5 (the fixed gate: a collar cluster on a 1.8 mm neck)
    Re-gated with the fixed gate: nodes 18 and 21 pass; node 20 fails on a neck, its collar cluster at (-157, 0, 110) joined by
    6 mm2 (483 mm3 hanging). Strength was 0.36. Same cause as node 2: the budget leaves the web to the collar under the wall floor.
    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
    [part.py]
2026-10-30 results: [overseer_cage_node_15]
    [part.stl]
2026-10-30 results: [overseer_arm_front_root, hub_deck] (run 69's artifacts; its commit job waits for the base)
    Front root v3 (12 cm3): PASS, 29.7 g, 0.26 in the cage crash through the tubes (v2 0.54). Hub deck v16 (nose wall 5, 32 cm3):
    PASS, 62.8 g, 0.37 in crash 0 + frame ties at the front.1 mouth (v15 0.67). Both finished before 04:30 UTC but parts.yml
    commits a run's results only when every job of the run is done, and the base v2 in the same run has ~8 h to go.
    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
    [part.stl]
2026-10-30 parts.yml: a finished part's result is committed by its own job; cage_loads: the pack mass without a mesh
    parts.yml: the commit job waits for the run's slowest part (30 Oct: the base's 8 h held the front root v3 and hub deck v16
    results all night; I placed them from the run's artifacts by hand). Each run job now commits its own result as soon as it
    has one, with the commit job's stale rule and a push retry; never fails the job; the commit job stays for the leftovers
    and predict --update.
    tools/cage_loads.py: PACK_G 750 g at (-20, 0, -42) added to the core mass (the battery placeholder mesh left the assembly
    29 Oct; without it the frame model dropped the pack from every crash case). Checked,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
    [cage_loads.py]
2026-10-30 results: nodes 18 and 21 re-gated PASS with the fixed gate; node 15 welded watertight; run-62 nodes read current again
    Nodes 18 and 21: result.json carries the fixed gate's verdict (tools/solid_check.py 5989a12) instead of the old gate's FAIL;
    meshes and strength untouched (node 21's rerun with the O5.6 posts is dispatched separately). Node 15: tools/weld_stl.py,
    106k -> 81k faces, watertight. Nodes 3, 4, 7, 10, 11, 13, 15, 18 were flagged stale by lib_sha because cage_node_lib
    b8c3795 (00:22 UTC) added two lines to check_members, a validation that changes no geometry, load or cut; their lib_sha is
    restamped to the current lib with a "lib_restamp" record naming the change, so the page shows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
    [part.stl]
2026-10-30 results: [hub_deck,overseer_arm_front_root,overseer_base]
    [part.stl]
2026-10-30 engine: the coarse stage falls back to a cold fine start; a crashed run uploads nothing; node 21's re-gated result restored
    Run 67 (30 Oct 03:00, node 21 with the O5.6 posts): the 2h warm-start grid could not carry the setup (Pardiso -4 on the
    full solid, then "zero compliance ... the load sits on fixed nodes" for the camera +-x cases and the post ties: at h 2.0 the
    1.2 mm post walls vanish into the plug keep-out) and the run died in 12 s. topo/run.py: a ValueError from the coarse Layout
    skips the warm start and the fine layout starts cold; the coarse stage is a speed-up, not the result.
    parts.yml: the checked-out result.json / part.stl / preview.png are removed before the engine runs, so a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
2026-10-30 results: [overseer_cage_node_20]
    [part.stl]
2026-10-30 auto mode (30 Oct 11 pm): base v3, side rails x -95..45 (run 69: 1.54 on the left edge short of the bay tie socket)
    Run 69 (v2, 30 cm3, h 1.7): PASS the gate, 51.9 g, index 1.54 in crash 7 + frame ties at (-55, 55, -8.5): the left edge
    between the left.1/.2 sockets (hub ends at x 0, y 59) and the bay tie -1+1.2 socket (x -90, y 56). The v2 side rails ran
    x -45..45 only, so the rail ended 45 mm short of that socket and its load crossed the 16 mm under the plate edge. The rails
    now run x -95..45 on both sides (room before volume; 30 cm3 kept). Smoke at h 1.7: 279,552 cells (unchanged bounding box),
    design 77k cells (was 68k), audit passed, drawn 2.9 %.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
    [part.py]
2026-10-30 flow clip v2 from MicoAir's MTF-02P drawing (Spark 30 Oct 1 am: v1's plug gap too small, lens window misses the sensors)
    The MTF-02P (21.6 x 16 x 6.5, micoair.com dimension drawing read 30 Oct) has its flow lens and both ToF windows at one end
    of the board, on opposite sides of the centreline (lens 6.8 from that end and 2.5 off-centre one way, ToF windows 5.1 / 8.5
    from the end and 4.3 off the other way), and the SH1.0-4P socket centred on the short edge, overhanging it ~1 mm. v1's
    window was centred on the pocket and its plug slot narrower than the plug.
    parts/overseer_flow_clip/make.py (drawn, replaces the core-session STL): pocket 22.2 x 16.6 at (94, 0), board back on the
    plate underside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
    [part.stl]
2026-10-30 rod saw guide v2 (Spark 30 Oct 1 am: the best tool, researched): kerf inserts, band grooves, chained stop rails, locking stop
    Research (clearwatercomposites, carbonfibertubes.net, ridegearlab, GTA forum; MakerWorld tube jigs, jewellers' mitre jigs):
    carbon splinters when one side moves before the cut is through, so the rod is held both sides of the blade; a metal vice cracks
    the wall, so the jig is held and the rod is banded; an abrasive blade beats teeth (32 TPI the fallback); the blade wears the
    slot, so the kerf guide is a replaceable insert; a sliding stop with a lock for repeat cuts.
    parts/rod_saw_guide/make.py -> print/body, insert_k06 / k10 / k15, rail, stop (.stl), part.stl the asse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
    [body.stl, insert_k06.stl, insert_k10.stl, insert_k15.stl, part.stl, rail.stl, stop.stl]
2026-10-30 rod saw guide v3, no clamp (Spark 30 Oct): snap clip zones hold the rod, feet instead of a vice, a wedge instead of the screw
    The body stands on a 60-wide base with four recesses for stick-on rubber feet. Two 14 mm clip zones near the ends hold the rod
    on both sides of the blade without any clamp: the channel mouth is 0.5 narrower than the rod with a 45 deg lead-in and the
    walls beside it are relieved into 2.0 mm fingers (1.0 slots, 10 deep) that flex ~0.25 each (about 14 N per finger, 15 MPa, C).
    The stop locks with a 6 deg printed wedge in a slot beside the rail; no insert, no screw. Kerf inserts and chained rails as v2.
    Claude-Sess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
    [body.stl, part.stl, stop.stl, wedge.stl]
2026-10-30 rod saw guide v4, one piece (Spark 30 Oct: "it needs to be one piece")
    One PETG block, 100 x 34 x 30 on a 60 x 8 base, 145 g: the O6 and O3 channels, two snap clip zones near the ends (mouth 0.5
    under the rod, 45 deg lead-in, 2.0 fingers on 1.0 relief slots) that hold the rod on both sides of the blade without a clamp,
    a 1.0 saw slot at mid-length (KERF in make.py for other blades), ticks every 10 mm from the blade on both top edges, four
    recesses for stick-on rubber feet. The v2/v3 inserts, rails, stop and wedge are gone (print/ removed).
    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
    [body.stl, insert_k06.stl, insert_k10.stl, insert_k15.stl, part.stl, rail.stl, stop.stl, wedge.stl]
2026-10-30 rod saw guide v4.1: flat bottom, taped to the bench (Spark 30 Oct); the rubber-foot recesses are gone
    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
    [part.stl]
2026-10-30 page: real colours (Spark 30 Oct 1 am): printed parts clear translucent, props, motors, plates and cameras black
    tools/motion.py part(..., opacity=None) carried to the page; motion_template.html: a part with opacity < 1 gets a translucent,
    glossier material (clear PETG); build_site passes the assembly's "opacity". systems/overseer.assembly.json: every PETG part
    #eef2f5 at 0.55, props / motors / cameras / plates #1c1c1c; carbon rods and the electronics as they were.
    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
2026-10-30 auto mode (30 Oct 1:30 am): base v4, 45 cm3 (v3: 1.55 at the bay tie socket end, the same spot as v2 with the rails added)
    Run 75 (v3, rails x -95..45, 30 cm3): gate PASS, 51.3 g, 1.55 in the bay tie -1+1.2 pull-out (488 N) at (-60, 54, -7), mirrored
    1.51, crash 7 / 9 at 1.49 / 1.46 beside it. v2 failed at (-55, 55, -8.5) with 1.54: the extra room moved nothing, so the setup
    has room and too little material round the socket ends (30 cm3 spread over a 380 cm3 room, 8 %). Volume 30 -> 45; node 5's
    history (3.5 -> 4.5 cm3 halved its index) puts the result near 0.45 (E). Grid and audit unchanged (h 1.7, 280k cells).
    Claude-Session: https: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
    [part.py]
2026-10-30 page: the bought parts drawn as they really are (Spark 30 Oct 1:40 am: the rear camera's angle, accurate electronics)
    tools/bought_meshes.py writes parts/<id>/part.stl in drone coordinates from the dimensions rows and the makers' drawings:
    DECXIN 2633V2 cameras (board, holder, M12 barrel and ring, plug) at the head mount's two poses and on node 21 looking back and
    40 deg down (the rear camera was an axis-aligned box); the FC stack (55A 4-in-1 under the MicoAir743-Lite on M3 posts, 45 deg);
    the ESC cap; the Pi 5 with its ports, GPIO and chips plus the Active Cooler as its own aluminium part; UBEC, buck, XR2; the
    MTF-02P as its drawing (ToF block, lens module, socket, face down); SunnySky X221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
    [part.stl]
2026-10-30 page: the boards are black PCBs (Spark 30 Oct), no green
    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
2026-10-30 engine: material no support reaches leaves the model and its loads move to the root; necks under declared-thin posts (brief 4)
    A. Head mount run 74 (h 2.5) died in the fine layout: "zero compliance of the full solid" for the camera cases. Not loads
    on fixed nodes: the O5.6 / 1.2-wall posts voxelise into cell chains that break at h 2.5, the post tips with the load faces
    float, the stiffness matrix is singular (Pardiso -4, the LU fallback gives nothing) and the compliance reads as zero.
    topo/layout.py floating_cells: cells not face-connected to any cell a support touches are left out of the model (logged:
    how many, drawn / design, where); a load on nodes no carried cell touches moves to the ne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
    [recut.py, solid_check.py]
2026-10-30 page: wires red and black (Spark 30 Oct): the wire runs split into two parts, every other lead red
    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
    [part.stl]
2026-10-30 dimensions: Fasteners row (Spark 30 Oct 2 am): the arm bolts are through-bolts, M3 x 50 / 55 with clearance drilled in the far plate; the full screw, nut and insert list
    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
2026-10-30 results: [overseer_cage_node_2,overseer_cage_node_6]
    [part.stl]
2026-10-30 page: the sensor fields as translucent solids, the prop rings gone (Spark 30 Oct 2 am)
    L2 half-sphere (90 deg mode, r 220) and the three camera frustums (the two head cameras and node 21's) as translucent solids
    in the views group; the yellow swept-prop rings are no longer drawn (the disc keep-out stays in the cage file).
    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
    [build_site.py]
2026-10-30 head mount: the v6 mesh back on the page while run 77 reruns it (the recut export was not watertight and tore on the page)
    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
    [part.stl]
2026-10-30 page: printed parts less translucent, 0.55 -> 0.8 (Spark 30 Oct)
    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
2026-10-30 dimensions: base v4 result (3.65 at the bay tie sockets: the hub ends are 4 mm too high for a collar under the plate); no v5 until Spark decides
    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
2026-10-30 assembly: front arm roots (overseer_arm_front_root and mirror arm_4_root) are FINAL, printed (Spark 30 Oct)
    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
2026-10-30 cage: the four bay tie hub ends at z -9.0 (Spark 30 Oct 8:15 am, after base v4): a full socket collar under the plate
    Base v4 (45 cm3) gave 3.65 at the bay tie sockets: their hub ends sat at z -5.1 under a plate whose underside is -2.1, so the
    6.2 bore had no wall on top. The ends drop 3.9 mm; the base's collar (r 3.1 + 2.5) now ends 1.3 under the plate. Cut list and rod
    mesh regenerated (bay ties 136.6 / 148.4 mm). Nodes 3 and 4 (mirrors 1, 0) rerun for the new rod directions; the frame model is
    not rerun (under 4 mm / 1.2 deg). Base v5 is the v4 setup on the new ends.
    Claude-Session: https://claude.ai/code/session_01EtHMZMuNjDDQVJhg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
    [part.stl]
2026-10-30 page: the Unitree L2 drawn round (Spark 30 Oct): O75 flange, O72 body, domed head to 65, M3 holes on O51, cable notch; it was a 75 box with a dome
    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
    [part.stl]
2026-10-30 nodes 3 and 4: rerun for the lowered bay tie hub ends (their results predate setup_sha and read current under the file rule, so the dispatch skipped them)
    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
    [part.py]
2026-10-30 setup-sha cache keyed on the data the setup reads too (30 Oct: lowered hub ends in overseer.cage.json, nodes 3 and 4 read as current)
    tools/part_sha.py: parts/<name>/setup.json is keyed on part_sha + lib_sha + data_sha, where data_sha hashes every
    systems/*.json but runtimes.json (cage_node_lib reads overseer.cage.json for every node's socket directions and loads) and
    the part's inputs/ files; a change there recomputes the setup sha, so a result solved from the old cage model reads stale.
    `python tools/part_sha.py --refresh` always recomputes (a refresh that trusts the cache is not a refresh); parts.yml's
    commit job uses it. Every cache recomputed with the new key. t_setup_sha: a changed val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
    [part_sha.py]
2026-10-31 base v6 (Spark 30 Oct 5:30 pm): side zones beside the slot drop to z -26 (y 34..59 both sides, x -95..40)
    v5 gave 2.22 in crash 7 at (-69, 43, -9): the side strip beside the pack slot
    was 16 mm deep and carried the 750 g pack into the bay tie sockets. Room only,
    volume 45 kept, slot untouched. Audit OK at h 2.5; grid at 1.7 unchanged
    (the socket collars already set it to z -26.5, 280k cells).
    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
    [part.py]
2026-10-31 results: [overseer_cage_node_3]
    [part.stl]
2026-10-31 base v7 (Spark 30 Oct 8:30 pm): v5's room, material 45 -> 60 cm3
    v6 (side zones to z -26) gave 3.03 at the v5 spot (-69, +-45, -8.3), worst in the
    bay tie -1 pull-out alone; the deeper room spread the volume away from it. The
    v6 boxes are removed (nothing deeper toward the battery) and the volume rises.
    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
2026-10-31 FC mount v1 (Spark 30 Oct 9 pm): one stack bolt does not go into the top plate
    Measured on the top plate mesh: the 45-deg stack puts its 30.5 holes on the axes at
    r 21.57; -X and +-Y fall in the 3.0 slots, +X lands on the web between the centre
    cutout and the +X slot. A drawn PETG ring carries the stack on 4 heat-set insert
    bosses (M3 x 20 stack bolts) and bolts to the plate through the 4 slots at r 32
    (M3 x 8 flush, nuts under). Stack 5 mm higher, pose updated. 12.9 g, gate PASS.
    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
    [part.stl]
2026-10-31 node 21: a drawn bar joins the roots of the top two camera standoffs (Spark 30 Oct 10 pm: they hang on a tiny amount of material)
    Bar 5 deep behind the plug zone (s -13..-8; plugs 0..-8), 5.6 tall, across both top posts; budget 2.0 -> 2.5 cm3 so the
    body grows into it. Audit smoke OK (drawn 6 %, room ok).
    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
2026-10-31 head mount v8 (Spark 30 Oct 11 pm): the L2 positioning keys removed
    The 4 keys (O60 circle at the body axes, from the manual's p8) do not match the unit,
    whose slots sit right outside the screw holes; the 4 M3 locate the L2. Keys, stems and
    bars gone, the field cut no longer spares them. v7 also grew a dead-end branch at
    (373, 30, 83), 16 mm from any drawn body (skeleton endpoint check); this rerun gets a
    fresh layout.
    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
    [part.py]
2026-10-31 flow clip v3 (Spark 31 Oct): sensor flat on its back, flat roof to the bottom plate, open to the ground
    2.5 roof on the plate underside, board back taped on it (z -4.6), walls 2.5 round the
    22.2 x 16.6 pocket to z -11.6, no floor; plug notch and flanges as v2. 4.1 g, gate PASS.
    The page's MTF-02P mesh drops to the roof.
    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
    [part.stl]
2026-10-31 head mount v8: the dead-end lobe at (375, 32, 82) cut off the mesh (Spark 31 Oct: no horn knobs, keep v8, no rerun)
    Skeleton endpoint 13.5 mm from any drawn body; box x 360..377, y 25..40, z 75..89
    removes 0.34 cm3 with no drawn material in it. One body, watertight; the gate's
    findings unchanged (the 8 declared camera posts).
    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
    [part.stl]
2026-11-01 head mount v9: L2 bolts as a diamond so the mount mirrors about y; cable slot on one side
    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
2026-11-01 page: click a part to name it; a rod shows its member and cut length (mm and in)
    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
2026-11-02 rod cuts: the 5 members into the head mount run to its socket floors (tubes 15/16/18/19-17 +11.4, core tie front.2 +7.2)
    Node 17 is the head mount, whose bores bottom 3.0 from the node centre; the cut list used the cage node socket start (14.4 / 10.2).
    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
    [part.stl]
2026-11-02 head socket adapter: 3 mm rod into a 6.2 x 15 head mount socket (drawn; sleeve wall 1.4, gate thin-wall fail pending Spark)
    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
    [part.stl]
2026-11-02 head socket adapter: for tubes 15-17 / 16-17 built as 3 mm rods, 4 (both ends)
    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
2026-11-02 head socket adapter: for head rods +1 / -1 (not tubes 15/16-17), 4 (both ends)
    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
2026-11-03 injectable socket: design (parts/socket_inject.py) and a print coupon (parts/inject_coupon); not yet in any part
    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
    [part.stl]
2026-11-03 scout page: internals only, the Scout's own motors, props and flow sensor; a part folder belongs to one drone
    The Scout assembly had placed the Overseer's folders since the 28 Oct migration:
    cage_shell_tubes and cage_shell_nodes (the Overseer cage v5/v6 tube mesh and its
    24 saved nodes), motor_1..4 (SunnySky X2216 at the Overseer's motor positions),
    prop_1..4 (10 x 4.5 props at z 82) and flow_mtf_02p (on the Overseer's flow
    clip), so the Scout page showed the Overseer's cage, motors and props on the
    Scout's plate (Spark 3 Nov: "this is not what the scout cage looks like").
    - systems/scout.assembly.json: the cage parts (shell tubes and nodes, rods and
    ties, tie saddle), the camera mount v1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
    [part.stl]
2026-11-03 battery holder v1 setup: Zeee 4S 5200 on the base's 4 M3 inserts, slides in from the tail, snap tab, no strap
    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
    [part.py]
2026-11-03 battery holder: tab root 8 in the floor (audit: boxed in), hook load on the hook and tab end
    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
2026-11-03 page: views framed to the drone's size; Scout camera row: M2 screws and the coupon posts (the Overseer's finding)
    - tools/build_site.py: the five views were placed for the Overseer (690 across), so
    the Scout (260) sat tiny in the frame; eye and target now scale with the
    assembly's extent about its centre (the Overseer's framing is unchanged within
    a few mm).
    - systems/dimensions.md A Camera (Scout): the DECXIN 2633V2 takes M2 screws, not
    M2.5 (the Overseer's standoff coupon A fitted to the same board, Spark 29 Oct),
    posts O5.6 x 10 with the O3.2 x 5.7 insert and an 8 mm plug keep-out behind the
    board; the saved Scout camera mount v1 still has M2.5 pads, flagged CHECK.
    Co-Authore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
2026-11-03 battery holder: contact regions span each pad + 1.5 (the front stop was empty at a coarse h)
    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
2026-11-03 stale_parts: a cage node whose mesh lacks a socket its setup cuts is stale (node 15 head rod 3.2 not 6.2; node 13 core ties)
    Nodes 13 and 15 had been stamped current by the file rule after a lib edit, from older setups.
    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
2026-11-03 scout page: the bought parts drawn to their dimensions (Spark 3 Nov: realistic parts first)
    tools/scout_meshes.py now also draws, each at the centre of the box the layout
    had there: the Bee35 plate as an X plate (3.5 carbon, body 94 across, arms to
    the motors with the 12 x 12 M2 pattern, the AIO 25.5 diamond holes, the 3 plate
    bolts, the XT60 cut-out at the tail; outline E between the measured numbers),
    the MicoAir743 AIO under the plate on grommet standoffs (36 x 36 diamond at
    (1.9, 0), lowest point z 9.5), the Radxa Zero 3W from its STEP numbers on edge
    in the tail bay, the UBEC brick with leads, the XR2 with its antenna up, the
    4S 1500 pack with leads to the XT60 plug, and the DECXIN 2633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
    [part.stl]
2026-11-03 scout page: the battery swap mechanism off the page (Spark 3 Nov)
    systems/scout.assembly.json: the latch set is removed while the Scout is being
    designed round the shared funnel: receiver v3, its lid, TPU strips and end
    pieces, cartridge v6, both sliders, its strips and skids, and the panel XT60E1-M.
    The 4S 1500 pack and its plug stay. Their contact pairs (136 -> 83), openings
    (9 -> 4) and access paths (swap down, the 4 receiver bolt keys; 8 -> 3) go with
    them. 22 parts on the page. Setup-sha cache refreshed by the build.
    Claude-Session: https://claude.ai/code/session_01EtHMZPtmpwpqrCKthkHL3P
2026-11-03 scout plate: the Bee35 main plate traced from SpeedyBee's render (Spark 3 Nov: the base is the SpeedyBee middle plate, make it accurate)
    SpeedyBee publishes no CAD for the Bee35 carbon (only the TPU accessory STLs,
    checked). tools/bee35_plate.py takes the main-plate render on page 3 of the
    Bee35 frame manual (an RGBA raster with a transparent background), rectifies it
    with a homography from the four motor-pad centres to (+-54.1, +-54.1), traces
    the silhouette and its cut-outs on the half without the camera mount, mirrors
    it, and extrudes 3.5 mm at z 18.5. The holes the raster cannot resolve come
    from their numbers: motor 12 x 12 M2 along the arm, the AIO 25.5 diamond at
    (1.9, 0), the three p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
    [part.stl]
2026-11-03 scout plate: body and nose from SpeedyBee's bare-plate product image (Spark 3 Nov: use the official dimensions)
    SpeedyBee's official numbers are the wheelbase 153, top plate 3.5, bottom 2.0,
    motor holes 12 x 12, FC holes 20 / 25.5 / 30.5, overall 213 x 218 with the
    ducts; the plate outline itself is only published as images. tools/bee35_plate.py
    now rectifies two of them on the four motor pads: the product page's bare main
    plate (sb_bee35-10.jpg, segmented by carbon texture; its pad centres read by
    eye) gives the body and the nose, which the manual render hid under the camera
    mount; the manual render (alpha) gives the arms, which are in shadow in the
    product image. Result: 6366 mm2, 35 cut-o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
    [part.stl]
2026-11-03 box system: swap arm v7, stand, enclosure, the funnel drawn on the latch footprint (3 Nov); README: Scout and box pages and the three live artifact links
    tools/import_box.py builds systems/box.assembly.json and parts/box_<slug>/ from Spark's nox checkout (box W frame); parts/box_funnel/make.py draws the funnel of the 3 Nov proposal, posed with the catch's SEAT_TO_W.
    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
    [part.stl]
2026-11-03 box page: both drones landing into the funnel (Spark 3 Nov: animate how both drones will land on this)
    tools/landing_box.py is the box page's timeline: the Scout (0..10 s) then the Overseer (10..24 s) come down off-centre and yawed, meet a 55 deg face with the receiver, follow the face to the seat, dwell, and climb out; a strip shows each height over the seat. Kinematic, not simulated. The drones are rigid copies of their current pages posed seated (import_box.py groups landing: Scout / Overseer; the Overseer with the same latch footprint under its base). build_site.py takes an assembly's timeline hook instead of the turntable.
    Claude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
    [part.stl]
2026-11-03 landing: funnel v3 and deck from the seated-drone envelopes; Scout belly skirt and clearance cage (Spark 3 Nov: the Overseer collides, find a workable design, build the Scout cage against it)
    tools/seat_envelope.py slices both drones seated on one latch footprint; tools/seat_check.py intersects every part with the funnel and deck as exact booleans. Findings: the two receivers differ in length (Scout 106, Overseer 184), so the seat is the Overseer outline and the Scout gets a matching belly skirt (parts/scout_belly_skirt); the Overseer base's side rails fill |y| 60..80 from h 31 and its flow clip hangs under the nose from h 42, so the funnel's y faces stop at h 28 and its x faces at h 40 (cap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
    [part.stl]
2026-11-03 overseer_top_cover v1: thin translucent cover over the FC, N logo, clamped by the 8 top plate bolts
    Drawn (make.py): skirt follows the top plate outline, lip past the plate edge onto the arm tops,
    45 deg flare into a parabolic dome; 1.2 walls, top z 75.3 (stack 26 + 1.5), 6.7 under the props;
    8 bolt seats with driver wells, 8 cable notches, logo cut through. 27.2 g.
    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
    [part.stl]
2026-11-03 overseer_top_cover: larger cable exits (16 x 12 at the arms, 32 x 14 at the sides)
    Interim step from Spark's photo; the dome redesign (aero for the rear props, raised logo,
    full arm-root overlap) follows.
    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
    [part.stl]
2026-11-03 overseer_top_cover v2: smooth aerodynamic canopy, raised logo, full arm-root overlap
    One blended height field (teardrop dome, peak z 86.6, steep skirt from the plate edge), kept
    6.6 under the rear prop blades and sloping off inside the disks; footprint = plate outline +
    the four rectangular root blocks, lip sandwiching the plate; N mark raised 2.0; 1.26 shell;
    15 x 11 exits at each root end, 48 x 18 on each side; 33.6 over the plate above the FC. 34.3 g.
    Prints upright with organic supports inside.
    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
    [part.stl]
2026-11-03 overseer_top_cover v3: arm roots left bare, the lip butts flush on their sides
    Spark 3 Nov: nothing on top of the root material beyond the plate; the cover stops at the
    plate edge where each root leaves it. 25.4 g, 150k faces, one body.
    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
    [part.stl]
2026-11-03 overseer_top_cover v4: passes the plate onto the arm root rectangles, square ends
    Spark 3 Nov: sit fully on top of the root rectangles, end edges rectangular like them. The
    rectangles are the roots' flat tops at the plate, from a numeric section of the printed arm
    meshes at z 44.5 (front u ..72.8, rear ..74.1, v about +-23). 31.1 g, one body.
    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
    [part.stl]
2026-11-03 overseer_top_cover v5: no cable exits at the root ends (Spark 3 Nov)
    The ends sit closed on the arm root rectangles; the 4 side exits stay. 31.3 g, one body.
    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
    [part.stl]
2026-11-03 overseer_top_cover v6: logo turned to read from the front, moved forward to x 24
    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
    [part.stl]
2026-11-03 overseer_top_cover v7: logo 56 wide, the largest on the dome where it is under 31 deg
    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
    [part.stl]
2026-11-03 scout cage v14, the funnel cage: a closed 3 mm rod shell formed to the Scout seated in the shared funnel (Spark 3 Nov)
    tools/scout_cage.py: 21 nodes, 54 rods, 7.33 m of 3.0 rod (81 g E), mirror-exact, shell closed with two declared openings (the bottom inside the base loop, the nose window for the camera). Base loop 310 x 184 at z -46 (feet, TPU caps), under the funnel mouth and clear of its rim and legs at the capture limits; prop ring at z 41.2 outside the swept discs by 13.0 (rule 12); flat roof at z 76; nose and tail nodes; rods 15.7 off every part; camera view clear; seat_check 0 crossings. Replaces the clearance pattern (removed). dimensions.md: the Cage v14 row. Box page: the Scout la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
    [part.stl]
2026-11-03 remove the Scout cage clearance pattern (superseded by cage v14)
    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
    [part.stl]
2026-11-03 scout cage v15, compact: an octagonal 3 mm rod prism tangent to the prop keep-out, 266 x 230 x 110 (Spark 3 Nov: v14 far too large)
    v14's size came from the tail bay 180 behind the plate, the camera 149 ahead and a hexagonal prop ring. Now: the tail electronics lie flat under the plate's tail over the funnel mouth, the camera sits just ahead of the front discs (lens (122, 0, 40)), the flow sensor 10 inboard, and the cage is one ring at z 62 (prop keep-out and roof edge, flats at |y| 115, nose 136, tail -130, chamfers on |x| + |y| = 193.7) with a 2-node roof spine, a 200 x 230 base ring with feet at z -48, dipped front nodes for the camera window, nose and tail bottom nodes: 18 nodes, 45 rods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
    [part.stl]
2026-11-03 landing: the descent sweep in seat_check; funnel v3 legs and deck opening; Scout cage v15 kept above the wall tops (Spark 3 Nov: the scout is colliding with the funnel)
    tools/seat_check.py --descent now sweeps each drone along the landing path at its capture limits (30 states) and intersects every part with the funnel and deck. It found what the seated check could not: the cage's base ring at z -48 rode into the funnel's end walls a few mm above the seat, the nose node swept through the legs, the Overseer's loop diagonals met the walls' top corners at x offsets over 18 and one of its crossed bay ties met legs placed under the long walls. Now: the cage keeps every member above z 0 (rails at z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
    [part.stl]
2026-11-03 page: one colour and transparency control for all printed parts at once; audit smoke at the SPEC h
    The pick box goes back to naming parts; a panel bottom right recolours every printed part
    together (remembered in the browser, reset restores the designed colours). CLAUDE.md: the
    audit smoke runs at the SPEC h, since room is measured in cells (battery holder passed at
    2.5 and was refused at 1.5).
    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
2026-11-03 box: the two bays nearest the top dropped (Spark 3 Nov), 7 stay; import_box checks every box part against the deck and funnel
    The bay receivers at 30 and -210 deg rose to W Z 85, through the deck at 66 and into the Overseer's loop. The new box_check in tools/import_box.py intersects each box part with the deck and funnel solids: at park the hub, motor A, rail A, the ties and the pack in head A already cut the deck plate, so the deck as a plate is wrong regardless of the bays; the exact rotational sweep is running to settle what the wheel's turn reaches.
    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
    [import_box.py]
2026-11-03 battery holder v2: the snap tab becomes its own drawn clip; holder carries a clip pad
    v1 was refused at the run's h 1.5 (the drawn tab, a flexure, had room on 28 % of its surface,
    audit 35 %; my smoke at h 2.5 had passed). The flexure is now parts/overseer_battery_clip (drawn,
    3.1 g, 12 x 2.5 strip, 38 free, 2.5 hook with a ramp, 0.9 % strain to release; gate PASS), held by
    2 M3 x 8 into 2 M3 x 5.7 inserts in the holder's clip pad; the pack's aft load goes into that pad.
    Audit at h 1.5: OK (drawn 3 %, room ok).
    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
    [part.stl]
2026-11-03 box: the Overseer seated 23 higher (its cartridge bottom is at drone z -76.9, cage v5, not v3's -54); page rebuilt with 7 bays
    With the right datum the Overseer's base and flow clip clear every funnel face seated (0 crossings) and its loop feet sit at W Z 94.5. The exact rotational sweep of the swap wheel (72 angles) is recorded in the next message to Spark: the funnel's tail end and the Overseer's loop lie inside the rails' r 151 at W Y 38..73, and the deck plate inside the hub's r 100, so the belly seat at the arm's grip height is incompatible with this arm; decision pending.
    Claude-Session: https://claude.ai/code/session_01EtHMZPtm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
    [import_box.py, seat_envelope.py]
2026-11-03 xswap short lock as a system: the lock's page copied into the drones' style
    tools/import_xswap.py copies the short lock v5 meshes from the lock's own page into parts/xswap_<slug>/part.stl in the
    Overseer drone frame (page y = drone x - 20, page x = drone -y, page z = drone z + 14.1; pincer parts at the rest pose) and
    merges the Overseer's current parts into three see-through context meshes. systems/xswap.assembly.json is the system;
    tools/xswap_motion.py its timeline: the page's swap cycle (rise, fingers and gate bars, tabs, rail 45, flip 180, and back)
    with readouts for finger stroke, bar swing, rail, flip and the shell's lowest point over the cage feet (-9.5 at rest: the
    skirt under the sh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
    [part.stl]
2026-11-03 landing: the seat 60 higher with the head extending 60 more at the drone slot; no deck; funnel on nose and side legs over the wheel (Spark 3 Nov: go ahead)
    The exact rotational sweep (tools/wheel_sweep.py, 72 angles, 34 turning parts) had the rails' disc and the hub through the funnel's tail end, the Overseer's loop and any deck. Now the cartridge seats at W Z 171 (SEAT_TO_W Z 215.3 in import_box, landing_box and seat_check), as a second stage on the head whose drone stroke grows from 95.6 to about 155 (placeholder head and grip at the drone in the box page); the deck is gone and the enclosure sheets end at W Z 145 under the rail tips; the funnel's underside is at 163 with an 8 mm skirt, its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
    [part.stl]
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2026-11-03 funnel: side legs forward to seat x +-40 (the Overseer's loop nodes grazed them at x 70 on its +-20 y capture)
    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
    [part.stl]
2026-11-03 funnel: seat +65, stand on nose and tail beams across the side sheets
    The side legs at seat x +-40 were grazed by the parked pack's sweep (wheel sweep:
    1 pair) and the Overseer's loop nodes. The funnel now stands on two 12-wide beams
    whose ends rest on the side sheets' top edge: the nose beam under the nose wall
    (W Y 279..291, Z 150..162, with the two nose legs) and the tail beam over the rails'
    band (Y 99..111, Z 155..163, 4 over the rail tips) with a buttress up behind the
    tail wall. Seat z 0 at W Z 220.3 (+65). Scout cage v15 legs shortened to z -45,
    feet 10 over the nose beam. Wheel sweep 0 pairs, box parts at park 0 crossings.
    Cl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
    [part.stl]
2026-11-03 funnel: top corners cut to |y| 44
    An Overseer tube grazed the tail wall's corner (23 mm3) at its +x+y capture
    limit at h 30 with the corners at 48. Scout descent 0 of 30, wheel sweep 0 pairs.
    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
    [part.stl]
2026-11-03 funnel: buttress 80 wide, corners back to |y| 48
    The 23 mm3 graze at the Overseer's +x+y capture limit was the buttress's top
    corner (seat x -121..-109, |y| to 48), not the wall corner: the buttress is now
    |y| 40 and the corner cut is back at 48.
    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
    [part.stl]
2026-11-03 results: [overseer_battery_holder]
    [part.stl]
2026-11-03 funnel: y walls' ends cut to h 24 outside |y| 50
    The Overseer's loop corner grazed the tail end's top (h 25..28, 20 mm3) at the
    diagonal capture limit at h 30. Scout descent 0 of 30.
    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
    [part.stl]
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2026-11-04 battery holder v3: material 22 -> 34 cm3
    v2 (52 min, 38.5 g): FAIL, 1.22 across the layers under the rear bolt pads at (-66, +-25, -17)
    in the +-y 35 g crash, and the drawn pads on 2.4 necks at the gate: too little material for a
    480 g pack hung from 4 pads. Setup otherwise unchanged (audit OK at h 1.5).
    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
    [part.py]
2026-11-04 scout cage v16: the cage lands on two skids, no standalone legs
    The four legs are replaced by two skids at |y| 84, z -48, each hung from its
    base rail as a triangulated panel (Spark 4 Nov). Everything above z 0 is v15.
    The skids stay outboard of the funnel's walls on the whole descent: a point at
    seated height h clears the y walls through the +-20 descent only beyond
    |y| 77 - 0.7 h. Scout seated + 65 descent states 0 crossings, wheel sweep 0.
    Funnel: the tail beam's buttress top lowered to h 24, where its inner edge is
    behind the wall's inner face (at h 30 it stood 2.5 inside it and the Scout's
    skirt grazed it between the descent check's states); the descent check now
    samples every 3..5 mm.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
    [part.stl]
2026-11-04 funnel: top corners cut to |y| 45
    At 48 an Overseer tube grazed the tail wall's top corner (1 mm3) at its diagonal
    capture limit at h 40, a state the finer descent sampling added.
    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
    [part.stl]
2026-11-04 scout cage v17: skid trusses, braces, ties; frame model
    Spark 4 Nov: the bottom was not triangulated enough and every node is PETG, so
    a stiffness check. tools/scout_cage_loads.py runs the Overseer's beam-frame engine
    on the Scout cage: the plate and everything on it a rigid body on the tie roots,
    35 g crash in 14 directions onto hull faces, 6 g flat and rough landings, free-free
    modes, Euler, socket loads, and the pin-jointed count (rods short of 3n - 6).
    v16 with its single-diagonal skid panels: first mode 147 Hz, a tail-first crash
    racked it 17 mm with 1157 N in a corner tie, the 200 rails buckled at 1.10, the
    panels hung on socket bending at 93 % of the cap.
    v17: each skid panel a Warre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
    [part.stl]
2026-11-04 battery holder v4: pack cavity 4 lower, room under the whole of each bolt pad; clip follows
    v3 (34 cm3, 113 min, 54.6 g): FAIL, 0.94 at the same spot as v2, the rear bolt pad root
    (-67, -25, -15) in the +-y crash: the pads sat half over the pack (cavity top 0.5 under them), so
    each joined the body only by its outer half beside the O7 driver path; more material could not
    reach it. Now 4 of design room under every pad. Clip moved down 4 with the floor (gate PASS).
    Audit at h 1.5 OK.
    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
    [part.stl]
2026-11-04 overseer_top_cover v8: one bolt per arm root (the outer one, |y| 55), 4 not 8
    Spark 3 Nov. The other 4 top plate bolt heads sit free under the cover. Open-edge repair after
    marching cubes. 29.5 g, one body, watertight.
    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
    [part.stl]
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2026-11-04 results: [overseer_cage_node_13]
    [part.stl]
2026-11-04 scout: cage v18 low and domed; nose and tail units, arm clips as engine setups
    Spark 4 Nov: the whole design more pleasing, inside parts that hold everything.
    Cage v18 (tools/scout_cage.py): ring z 58, a three-node ridge at z 70 (12 dome),
    NB and TB printed into the units, 8 ties; first mode 232 Hz, prop 12.0, Euler
    <= 0.54; descent 0 of 65, wheel sweep 0.
    parts/scout_units_lib.py + setups: the nose unit (yoke to the receiver's nose
    inserts, the funnel runner with the flow sensor's window, the camera boom on four
    M2 posts, node NB, two tie sockets), the tail unit (yoke, runner, electronics
    tray for the Radxa / UBEC / XR2, node TB, two tie sockets), four arm clips. Drawn
    attachments only; loa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
    [part.stl]
2026-11-04 results: [scout_arm_clip_4]
    [part.stl]
2026-11-04 results: [scout_arm_clip_3]
    [part.stl]
2026-11-04 results: [scout_arm_clip_1]
    [part.stl]
2026-11-04 results: [scout_arm_clip_2]
    [part.stl]
2026-11-04 results: [scout_nose_unit]
    [part.stl]
2026-11-04 results: [scout_tail_unit]
    [part.stl]
2026-11-04 scout units run 1: the thin-drawn class, audit drawn_thin, setups fixed for run 2
    Run 1 (4 Nov): nose gate PASS 60.4 g, index 0.60 at the nose wall's top in the
    funnel catch; tail gate FAIL on two necks at the ends of its 2 mm tape lands and
    index 2.34 under a tail pad sheared by the UBEC lead clearance; clips 1 and 4
    gate FAIL on a 1.1 mm sliver where the plate keep-out sheared the tie collar.
    The class: drawn bodies left thin after their cuts. topo/audit.py drawn_thin
    (exact geometry: a drawn body under 2.5 mm across its smallest extent is refused)
    with a test_topo case; parts/scout_units_lib.check_collars refuses a socket collar
    that loses over 3 % of itself to a keep-out.
    Fixes: tape lan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
    [part.stl]
2026-11-04 battery holder v5: printed on its side (build +y)
    v4 (110 min, 55.4 g): FAIL 1.22 across the layers at the cavity's top corner by the rear bolt pad,
    crash 0. v2..v4 printed flat all failed across the layers in that zone: a hanging bucket puts its
    side walls in vertical tension, across flat layers. On its side the walls and the pad paths are
    in-layer. Fits the A1 mini (150 x 67 footprint, 64 tall). Audit OK at h 1.5.
    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
    [part.py]
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2026-11-04 scout: FC on top of the plate, the yokes through the plate's own holes, tail unit run-3 fixes
    Spark 4 Nov: the FC can stay on top of the base plate. It sits on 4 mm
    standoffs over the plate (board z 26), so the nose and tail yokes meet under the
    plate's middle at x -8 and bolt through Bee35 holes: the nose through (36, 0),
    the FC diamond's front three (the FC's standoff bolts go on into the yoke) and
    (3.9, +-31); the tail through the diamond's tail hole and one drilled pair.
    Tail unit run 2: one neck over the UBEC lead slot in the yoke, index 1.16 at the
    tray's step past the wall room; run 3: the UBEC 6.5 aft, the tray 36 wide only
    behind the wall. Run-2 masses on the page (nose 73.3, tail 8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
    [envelope.stl, part.stl]
2026-11-04 tail unit: UBEC 1.5 aft with lead channels (6.5 aft met the cage rod TB-B1)
    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
    [envelope.stl, part.stl]
2026-11-04 scout: tail electronics on edge in the tail unit's bay, cage v19 tail in to -116, CG on the thrust centre
    Spark 4 Nov: the CG on point and as much of the electronics as possible in the
    printed base that meets the funnel. The tail tray behind the plate is gone: the
    UBEC, Radxa Zero 3W and XR2 stand on edge in a bay over the tail runner inside
    the funnel's bowl (Radxa on four M2.5 posts, ports up between the arms); the tail
    node moves to (-112, 0, 10) on a short arm. Cage v19: the tail flat in from -130
    to -116, the rear discs' keep-out (231 Hz, Euler <= 0.55, prop 12.0, body 11.2).
    CG from the assembly (-0.35, 0.12) against the thrust centre, tolerance 3.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
    [envelope.stl, part.stl]
2026-11-04 box: the Scout's tail unit room with the flipped bay
    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
    [part.stl]
2026-11-05 scout: mounting audit, the bay for screw access, 25 cage node setups
    Spark 4 Nov: confirm every screw hole and its access from the parts' published
    dimensions, then generate the cage nodes. The audit row in dimensions.md lists
    each hole's source (spec, STEP, measured, or the plate trace: the nose bolt
    (36, 0) and the (3.9, +-31) pair are unpublished, CHECK), each screw's length and
    way in. The Radxa's screws had no way in (the UBEC stood 3 mm from the board):
    the Radxa now stands z -15..15 with the UBEC flat under it, its screws come in
    from the open tail end along driver columns cut from the envelope.
    parts/scout_node_lib.py (after the Overseer's node library) and 25 setups
    parts/scout_cage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
    [envelope.stl, part.stl]
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2026-11-05 battery holder v7: front stop 36 x 36 across the pack face, material 34 -> 40 cm3
    v6 (on its side, 81 min, 57.1 g): FAIL 0.81 at the front corner (51, +-23, -34) in the forward
    35 g crash, the 20 x 20 front stop concentrating it; the side and floor pads on 3.0 necks.
    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
    [part.py]
2026-11-05 scout: camera 30 deg up at (130, 0, 38), nose node 4 back, nodes' landing faces 3 mm, frame model skips the cage entries
    Spark 4 Nov: the one camera tilted up for close-ups and ceilings. 30 deg: the
    89 x 73 view spans 6.5 deg below the horizon to 66.5 above, 3 clear of the ring's
    front rod at the window with the 2 deg margin; 35 deg puts the rod in the picture.
    The lens went 2 back and 2 down from the first try: at x 132 the board's bottom
    corners sat 2.3 from the sill rod, and at (128, 0, 32) the plug keep-out sheared
    the nose node's collar; NB moves to (114, 0, 8). Nose unit run 4: h 2.2, 55 cm3.
    Skid nodes' landing faces 3 mm (the audit refuses 2.4).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
    [envelope.stl, part.stl]
2026-11-05 results: [scout_cage_node_km0]
    [part.stl]
2026-11-05 results: [scout_cage_node_km1]
    [part.stl]
2026-11-05 results: [scout_cage_node_k3]
    [part.stl]
2026-11-05 results: [scout_cage_node_p7]
    [part.stl]
2026-11-05 results: [scout_cage_node_p0]
    [part.stl]
2026-11-05 results: [scout_cage_node_k0]
    [part.stl]
2026-11-05 results: [scout_cage_node_r0]
    [part.stl]
2026-11-05 results: [scout_cage_node_p3]
    [part.stl]
2026-11-05 results: [scout_cage_node_k2]
    [part.stl]
2026-11-05 results: [scout_cage_node_rm]
    [part.stl]
2026-11-05 results: [scout_cage_node_bm1]
    [part.stl]
2026-11-05 results: [scout_cage_node_k1]
    [part.stl]
2026-11-05 results: [scout_cage_node_p5]
    [part.stl]
2026-11-05 results: [scout_cage_node_r7]
    [part.stl]
2026-11-05 results: [scout_cage_node_p2]
    [part.stl]
2026-11-05 results: [scout_cage_node_rf]
    [part.stl]
2026-11-05 results: [scout_cage_node_bm0]
    [part.stl]
2026-11-05 results: [scout_cage_node_p4]
    [part.stl]
2026-11-05 results: [scout_cage_node_rb]
    [part.stl]
2026-11-05 results: [scout_cage_node_p6]
    [part.stl]
2026-11-05 results: [scout_cage_node_p1]
    [part.stl]
2026-11-05 scout units run 4: the env_neck class, audit env_neck, rooms widened for run 5; 21 nodes on the page
    Run 4 (5 Nov): nose gate FAIL at 0.42 (the lower camera posts' stubs had 1.2 mm
    of room beside them: two loose blobs), tail gate FAIL at 0.45 (the tail-node arm
    met the bay over a 4 mm overlap: three necks). The class: a loaded drawn body
    whose only room to the support is thinner than a member. topo/audit.py env_neck
    (the room eroded by half a member must still join every loaded body to the
    support) refuses it, with a test_topo case. Run 5 setups: the camera post block
    to the board's back and |y| 24, the arm room into the bay to the Radxa's back.
    Nodes run 1: 21 of 25 PASS, 0.01..0.16, 8.3..1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
    [envelope.stl]
2026-11-05 battery holder v8: material 40 -> 46 cm3
    v7 (111 min, 68.2 g): FAIL, 0.53 in-layer at the front bolt pad (24, -29, -19) in crash 0, and 3
    blobs on 3.0 necks at the gate (6+ in v6): each volume step has closed both.
    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
    [part.py]
2026-11-05 tail unit: the bay room past the Radxa on both sides and over it; env_neck erodes whole cells rounded down
    The Radxa on edge spans the bay's full width and height, so the tail-node arm
    behind it reached the yoke only through slivers (env_neck). The bay room behind
    the plate's tail is now |y| 40 and up to z 22. The audit's half-member erosion
    rounds down to whole cells: at h 2.0 and member 4.4, ceil gave 2 cells (8 mm),
    which cut the 9 mm yoke itself.
    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
    [envelope.stl]
2026-11-05 rear arm v10: installs over core tie left.2 with the rod in place; motor pad skirt, 40 cm3
    Spark 5 Nov: the printed rear arms snapped at the motor end. The link's tunnel is swept down out of
    the envelope (the arm lowers over the rod, top plate off); a drawn 6 deep skirt under the pad rim
    gussets the pad into the arm; material 32 -> 40. Arm 3 is the y-mirror. Audit OK at h 2.0 (102k cells).
    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
    [part.py]
2026-11-05 rear arm v10: printed on its side (build +x)
    Spark 5 Nov: v9 snapped at the motor pad under thrust alone, at index 0.30 printed flat: the
    joint under the pad fails across the layers well below the model. On its side thrust and the
    arm's bending run in-layer. Audit OK.
    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
    [part.py]
2026-11-05 front arm pad: printed on its side (build +y)
    The rear arm v9 snapped at its motor pad under thrust alone at 0.30 printed flat (Spark 5 Nov);
    this pad has the same 6 mm pad and sat at 0.28 in-layer / 0.17 across in that case. Layers in xz
    put thrust in-layer. Arm 4's pad is its y-mirror. Audit OK.
    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
    [part.py]
2026-11-05 arm motor ends: 8 mm pad skirts, more material, strength limit 0.3, printed on their side
    Spark 5 Nov: the printed front pads cracked and the rear arms snapped at the motor, printed
    flat with the layers across the thrust. Both parts: a drawn 8 deep skirt under the pad rim
    gussets the 6 mm pad into the arm (the motor-screw driver sweeps still cut it); front pad
    12 -> 18 cm3, rear arm 32 -> 46; max_worst 0.5 -> 0.3 (the rear arm broke at 0.30 under
    thrust, so 0.3 is the real margin); both printed on their side. Audit OK on both.
    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
    [part.py]
2026-11-05 arms: drawn solid front pad and rear arm for the demo (no topology), printed on their side
    Spark 5 Nov: the printed front pads cracked and the rear arms snapped at the motor base, flat
    prints with the layers across the thrust; demo tomorrow, fastest and safest. Both are drawn solid
    (make.py), gate PASS: front pad 67 g with drop-on sockets one socket length further along the
    rods (the old pads stay glued, the rods are cut flush behind them); rear arm 93 g, installs over
    core tie left.2 / right.2 with the rod in place. Arm lib: a node_r hook for the spoke socket start
    (default unchanged). Assembly points at the solid parts.
    Claude-Sessi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
    [part.stl]
2026-11-05 results: [overseer_arm_front_pad]
    [part.stl]
2026-11-05 nose unit: a root boss behind each camera post (runs 4 and 5 left the lower posts' stubs loose)
    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
    [part.py]
2026-11-05 arms solid v2: smooth blended bodies, O36 bell under each motor pad (gate PASS both)
    Spark 5 Nov: smooth not geometric, even more support round the motor plate, print fast.
    parts/arm_solid_lib.py: a blurred distance field meshed, the arm lib's exact bosses added and its
    cuts subtracted. Front pad 86 g / rear arm 108 g solid volume, printed on their side with 5 walls
    and 50 % gyroid (about half the time of solid; the loads are in-layer).
    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
    [part.stl]
2026-11-05 scout: yoke ties to the rail mid nodes (the corner nodes were forks), fork check in the node library, tail arm room
    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
    [envelope.stl, part.stl]
2026-11-05 units: tie sockets follow the cage's tie list (the yoke ties end at the rail mid nodes)
    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
    [envelope.stl]
2026-11-05 results: [overseer_arm_rear,overseer_battery_holder]
    [part.stl]
2026-11-05 arms solid v3: flat faces capped, front pad slides on from the outboard side, rear arm notched for the Pi
    Probed against the drone: the soft union had raised ridges up to 2.2 mm on the pad tops and the
    root block faces (capped at z 0 / 45 now); the front pad's vertical drop slots crossed (stacked
    tubes), so its sockets are channels open outboard across the arm (tubes 5.8 press, spokes 2.8
    snap), the block bottom z 5; the rear arm's root corner met the Pi + cooler by 1.8, cut with its
    box + 1. Collision check: no part overlap, no rod within clearance; gate PASS both. Mirrored arms
    3 / 4 point at the solid meshes.
    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
    [part.stl]
2026-11-05 battery holder v9: bolt pads O11 -> O16
    v7 0.53 and v8 0.527 (46 cm3, 75.8 g) at the front bolt pad root in the forward crash: each pad
    joined the body only through the 1.9 ring round its O7 driver path, so volume moved nothing.
    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
    [part.py]
2026-11-05 results: [scout_cage_node_b3]
    [part.stl]
2026-11-05 results: [scout_cage_node_b0]
    [part.stl]
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2026-11-07 results: [scout_cage_node_b1]
    [part.stl]
2026-11-07 results: [scout_cage_node_b2]
    [part.stl]
2026-11-07 scout nodes: a strut envelope (a Ø12 strut per member to its collar, a Ø17 hub) in place of the 56 mm ball
    Spark 5 Nov: the nodes still look wrong. Run 1 grew each node in a box-and-ball envelope with tiny frame loads, so
    the budget went into spindly webs between far-apart collars. The engine now only decides how much of each strut
    to keep: a star of struts into the collars.
    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
    [scout_node_lib.py]
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2026-11-07 battery holder v10: side walls 8 -> 12
    v8 0.527 and v9 0.534 (O16 pads, 79.4 g, gate PASS) in the wall beside the cavity's top front
    corner in the forward crash: the load runs from the front stop to the front inserts through an 8
    wide wall. Envelope y +-32 -> +-36 (below the base, inside nothing else).
    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
    [part.py]
2026-11-07 scout cage: nodes closer than 60 mm are one printed structure (10 pairs + 5 singles), the rod between them a printed bridge
    Spark 5 Nov: two nodes too close together become one structure, the same all across the Scout. MERGE_MM 60 in
    tools/scout_cage.py: BRIDGES (P0-R0, P7-R7, P2-P3, P4-P5, the six skid posts), GROUPS by union-find; the node library
    builds a group as one part (both nodes' collars, struts, hubs, a O12 room along the bridge, 5 cm3 a pair); the rods
    mesh and the frame model take the bridges out of the carbon (frame: PETG O8 beams: 218 Hz, 2.0 mm, Euler 0.61).
    Weight a wash: -2 g over the 10 pairs (E), 16 fewer sockets. The 20 merged singles' folders are gone.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
    [part.stl]
2026-11-07 scout cage: the nose braces to P0 / P7 (K0-R0 ran through P0's collar), passing-rod checks, pairs at h 1.2
    The pair setups showed K0-R0 / K3-R7 passing 15.9 mm from P0 / P7, through their P0-P1 / P7-P6 collars; no check
    caught a passing rod. scout_cage.checks screens every rod against every node it does not end at (20 mm), and
    check_members refuses a collar a passing rod comes within 1 mm of (exact; NB, TB too). Bridged nodes keep their
    socket starts (the bridge takes its room in the hub). Pairs at h 1.2 (a 57 mm pair is 230k cells at 1.0).
    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
    [part.stl]
2026-11-07 cage nodes: collar wall 3.5 / floor 4.0, every socket resin-injectable, foot 3.0
    Spark 7 Nov: the bottom nodes cracked in testing; make the nodes injectable with resin. The
    injection pattern (parts/socket_inject.py: annulus with 3 lands, feed ring, O2 fill port, O1.5
    vent) goes on every node socket; the port leaves on the crown side where that clears the other
    collars, else the first clear direction round the socket (16 tried), else through a neighbour's
    collar wall clear of its bore. The landing foot 2.4 -> 3.0 (drawn_thin audit), the envelope
    stops at its face and the landing load sits inside it (load_room audit).
    Claude-Session: ht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
    [cage_node_lib.py]
2026-11-07 cage nodes: strength limit 0.3 and 1.4x material on every node; collars back to 2.5 / 3.0
    Spark 7 Nov: the test breaks were in the generated body between the sockets, not the collar walls.
    The arms showed printed PETG failing at 0.30 of the engine's strength, so every node now runs at
    max_worst 0.3 with 40 % more material budget; the collar thickening is dropped (mass for nothing).
    Injection on every socket and the 3.0 foot stay.
    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
    [cage_node_lib.py, part.py]
2026-11-07 scout nodes: sockets from 5 mm, strut room 1.5, each structure's budget from its skeleton
    The five strut singles at a flat 2 cm3 came in at 5.2..6.2 g with indices 0.04..0.28 but failed the gate on 1 mm flakes
    where the 6.25 members did not fill the room (engine session started for the cleanup). spec_for sets the budget
    from a hub ball and a 6.25 member from the hub to every collar's mouth (+10 %): singles 2.5..3.5 cm3, pairs 5..7.
    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
    [part.py, scout_node_lib.py]
2026-11-07 results: [scout_cage_node_b1_k1]
    [part.stl]
2026-11-07 results: [scout_cage_node_bm1_km1]
    [part.stl]
2026-11-07 results: [scout_cage_node_bm0_km0]
    [part.stl]
2026-11-07 results: [scout_cage_node_b2_k2]
    [part.stl]
2026-11-07 results: [scout_cage_node_b3_k3]
    [part.stl]
2026-11-07 results: [scout_cage_node_p4_p5]
    [part.stl]
2026-11-07 results: [scout_cage_node_p2_p3]
    [part.stl]
2026-11-07 results: [scout_cage_node_b0_k0]
    [part.stl]
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2026-11-07 audit: refuse a drawn wall under the 2 mm floor (the Scout nodes' collars at their resin grooves); the cleanup reports drawn thin walls as kept
    The five Scout strut nodes failed the gate on 2..10 thin walls of 1.0..1.4 mm that the export cleanup listed as slivers removed while
    taking off ~1 mm3. Reproduced on a two-strut test part: the walls are the drawn collars' own rings at the resin grooves (WALL 2.0 round
    the bore minus the 0.5 groove = 1.5, under the floor; the gate's rule reads the ring at 1.1..1.4 because the groove band is 1.5 tall),
    drawn material the cleanup's subtraction rightly excludes. The organic finish reproduces the drawn thickness there (a deeper skin run
    into the cuts cha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
2026-11-07 results: [overseer_cage_node_18]
    [part.stl]
2026-11-07 results: [overseer_cage_node_10]
    [part.stl]
2026-11-07 results: [overseer_cage_node_6]
    [part.stl]
2026-11-07 results: [overseer_cage_node_11]
    [part.stl]
2026-11-07 build_site: a refused run has no mass (the site workflow failed on it since 04:20 UTC)
    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
    [build_site.py]
2026-11-07 scout nodes: collars 2.5 (2.0 at the grooves: the gate's thin walls were the collars), supports per node in a pair
    Merged run 1: every structure but RM failed the gate on 1.1 mm walls that sit on the collars at their 0.5 resin
    grooves (the engine session's drawn_wall audit refuses it now); the pairs' indices 0.54..1.40 sat in the bridge next
    to the node without a support. Strut room 3.0 keeps the drawn share under 30 %.
    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
    [scout_node_lib.py]
2026-11-07 results: [scout_cage_node_p0_r0]
    [part.stl]
2026-11-07 results: [scout_cage_node_p7_r7]
    [part.stl]
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2026-11-07 battery holder v11: clip pad 30 wide, envelope 4 lower, h 1.6
    v10 (46 cm3, 114 min, 79.5 g): strength PASS at last (0.36, forward crash) but the clip pad hung
    on two 2 mm strips beside the clip channel (drawn_not_in_main) with 2 necks at the rear pads. The
    pad is 30 wide (was 18) with room under its wings; h 1.5 -> 1.6 (326k cells at 1.5). Audit OK.
    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
    [part.py]
2026-11-07 scout cage: the rods drawn as cut, socket floor to socket floor (the page dropped the 10 in-line rods), cut list in the spec; look at the page
    The page's mesh cleanup merged two in-line rods meeting at a mid node into one body and dropped it: RF-RM-RB, the
    rails through BM0 / BM1 and the skids through KM0 / KM1 showed empty sockets (Spark 7 Nov). rod_ends() gives each
    rod as it is cut (69 rods, 5.37 m, 42..136 mm; cage_shell.rod_cuts_mm). CLAUDE.md: always look at what Spark looks
    at: the previews and the page rendered headless (Spark 7 Nov).
    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
    [part.stl]
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2026-11-08 node ports avoid a node's extra bodies and cuts; battery holder v12: clip pad flush, L corner pads
    Node 21: a 1.4 sliver beside camera rod 13's fill port, which ran through the camera zone the
    port check never saw (it checked the other collars only); a candidate direction is now rejected
    when its O2 hole + 2 mm meets any extra drawn body or cut. Holder v11 (80.6 g, strength 0.43
    PASS): two 1.0 skins over the clip pad (a 0.5 gap under the floor) and a blob on a 3 mm neck at
    the rear pack corner; the pad is flush with the floor, the floor and side pads meet in an L.
    Claude-Session: https://claude.ai/code/session_01EtHMZMuNjDDQVJhg2Wn7rq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
    [cage_node_lib.py, part.py]
2026-11-08 scout cage: merge distance 60 -> 45 (the 57 mm pairs were 112 mm parts), 23 structures, 77 rods as cut
    Spark 8 Nov: the nodes are super long. A single node is 43..58 mm across; a merged pair carried the 53..57 mm span
    inside one part. Only the window posts P0+R0 / P7+R7 (41 mm) stay merged; the ring corners and the skid-truss nodes
    are single again. Frame: 250 Hz, 1.45 mm (the ten PETG bridges had softened it to 221 Hz, 2.0 mm). Filament row.
    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
    [part.stl]
2026-11-08 battery holder and clip removed (Spark 7 Nov: a swap mechanism instead); arm motor pad 10 thick, no counterbore; front pad v3 topology setup WIP; assembly back on the topology arms
    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
    [part.stl]
2026-11-08 arms: motor pad 10 thick with no head counterbore (M3 x 14); front pad v3 topology setup (slide-on half-pipe sockets on the cut rods, ring boss, on its side, limit 0.3); assembly on the topology arms
    Spark 7 Nov: one topology design for all four arms with a thick motor mount, where every crack
    happened. The battery holder and clip are gone (previous commit).
    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
    [overseer_arm_lib.py, part.py]
2026-11-08 cage v20: half the rods, nothing over the props (Spark 8 Nov)
    Spark: the Scout is far too heavy, keep material near the props as little as possible, halve the rods. v19 was 77 rods as
    cut in 25 nodes (199 g of nodes, 79 g of rod, 1.74 m of rod over or under the discs); v20 is 39 rods (2 bridges) in 21 nodes
    and 4 ties, 41 as cut, 3.52 m, 314 mm in the discs' plan (212 of it the ties under the arms).
    tools/scout_cage.py: the ring with side mid nodes PM0 / PM1, the ridge RF-RM-RB, a waist hoop RM-PM0 / RM-PM1 between the
    discs, the skids at |y| 110 on A-frames from the side mids with a vertical to each ring corner and a brace to the sill or the
    tail flat, the arm ties down to the skid ends; n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
    [part.stl]
2026-11-08 results: [scout_cage_node_pm1]
    [part.stl]
2026-11-08 results: [scout_cage_node_pm0]
    [part.stl]
2026-11-08 front pad v3: socket rings start at the floor plane (a 1 mm slab beside the channel failed drawn_wall); audit OK
    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
    [part.py]
2026-11-08 base nodes: ground-hit case 1.3 kN on the foot, members >= 5, limit 0.2, 2x budget; cage nodes in PCTG
    Spark 8 Nov: the rear base node broke in three in testing. The nodes were sized to shared static
    crash loads; a landing on one node is a 10 J impact stopped in ~15 mm, ~1.3 kN on that node, 30x
    what a PETG strut absorbs. Every base node now carries that hit as its own case, with 5 mm members,
    a 0.2 limit and twice the budget; the material rule puts the cage nodes in PCTG (10-20x the impact
    toughness at PETG settings). Audits pending.
    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
    [cage_node_lib.py, part.py]
2026-11-08 PCTG for every printed part; motor test jig and TPU foot (drawn); base node SPECs without the settings key
    Spark 8 Nov: switch all PETG to PCTG if it is better for all (it is: 10-20x the impact toughness at
    90 % of the stiffness, PETG settings +10 C). The jig clamps a real printed rear arm on its own 4
    bolts and 2 pegs, 45 apart, screwed to a plank, so the motor end is tested on the part itself.
    The foot is 6 tall (the cage's contact <= 6 rule, not the report's 12) until the funnel is checked.
    SPEC settings=dict(min_member_mm) clashed with the run's own argument; the layout already lifts the
    member to 6.25 on the base nodes.
    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
    [part.stl]
2026-11-08 scout: the 8 Nov node rules on cage v20 (PCTG, limit 0.3, ground hit, injectable sockets, TPU feet)
    Spark via the Overseer session, 8 Nov: continue the Scout cage with the Overseer's rules. Every printed part PCTG (the
    engine keeps the PETG model); limit 0.3 on every node, unit and clip with the budgets x1.4; the skid nodes take a 550 N
    ground hit alone (0.7 kg from 0.6 m) at limit 0.2 and twice the budget, the landing slab inside the 3.0 foot; every
    socket the injectable pattern of parts/socket_inject.py with collar WALL 3.0 / FLOOR 3.0 (strut room 4.0: at 3.0 the
    side mids and the ridge mid were 30..34 % drawn); the units' fill port and vent continued 150 out. TPU 95A feet (the
    Overseer's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
    [part.stl]
2026-11-08 Scout cage v21, the half cage: drop the skids, land on the base units
    Spark 8 Nov: the lower half gives little value, the funnel and the base units cover the bottom; drop
    the full cage and focus on the half cage. Kept: the ring, the ridge with its waist hoop, the nose
    window, the four rods into the nose and tail units. Gone: skids, A-frames, verticals, braces, skid
    nodes K0..K3, TPU feet. New: a knee S0 / S1 at (0, +-115, 12) under each side mid, in the side
    flat's plane: a leg to the side mid, a fan to the two ring corners, the arm-clip ties in under the
    discs. 31 rods + 4 ties, 15 printed structures. Frame model: the runners' corners are the base
    contact (scout_cage.BASE); 136 Hz, worst cr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
    [part.stl]
2026-11-08 Scout v21: the arm clips' tie roots down to z 12 (the level tie's collar clipped the plate keep-out)
    The collar check refused all four clips: with the tie to the side knee nearly level, the collar ran
    along under the plate and lost 6 % to its keep-out at root z 13.5 (clear from 12.5). Roots at 12,
    level with the knees. Frame model 135.5 Hz, worst 12.9 mm, moments under the socket cap.
    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
    [part.stl]
2026-11-08 results: [scout_cage_node_s1]
    [part.stl]
2026-11-08 results: [scout_cage_node_s0]
    [part.stl]
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2026-11-08 Scout props: Gemfan Hurricane SL 5125 is the new default
    Spark 8 Nov: 5.1 in, pitch 2.5, T-mount 1.5 on the same ECO II 2004
    motors, for hover efficiency and lower noise (~128 W vs 172 W hover,
    ~8 dB lower prop tone, E). The discs overlap at the Bee35 hubs, so
    Spark's own frame replaces it; hub spacing open (±74.3 keeps the
    current tip gap). Cage v21, unit keep-outs and meshes stay on the
    3520 disc until the frame is laid out. Motor KV added to the D list.
    Claude-Session: https://claude.ai/code/session_01EtHMZP1C1SxaiaJcYLKngC
2026-11-08 Scout v4 shape design: 5.1 in props on a printed PCTG frame, seats in the same funnel
    Spark 8 Nov: new props, no Bee35 plate, everything printed in PCTG, must still fit the landing funnel
    for the battery swapper; a shape design first, its own artifact, newest on the GitHub page.
    tools/scout_v4_shape.py: Gemfan 5125 on hubs +-74.3 (tip gap 19.2), printed deck and arms where the
    plate was, the v3 base / receiver / cartridge / pack unchanged, camera forward to x 149, the v21 half
    cage grown to the new discs (flats 155, every rod >= 12 from the swept discs). seat_check scout_v4
    --descent: 0 crossings in 65 states (seat_check: the Scout capture for any scout_* drone). The page
    lists a system's `o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
    [part.stl]
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2026-11-08 Scout v4 cage: 3 mm rods, a flat roof, hung on four frame outriggers (frame-checked)
    Spark 8 Nov: the stretched v21 cage looked flimsy; keep the 3 mm rods, work the structure, nodes later.
    The stretched cage: 75 Hz, 31 mm, two rods over Euler, 3.3 N m on a socket (the core's load reached
    the cage through level ties in bending). Rods rising past the props can only stand in the flats'
    planes, so the cage now hangs on four nodes printed into the frame's outriggers (the base booms' ends
    and two side spars on x 0), with a V at each end and a fan at each side; the roof is flat (a ridge
    over the ring pushed its triangles into the ring at 1.3x Euler in the upside-down hit). 13 nodes,
    28 rods 3.19 m,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
    [part.stl]
2026-11-08 Scout v4 cage mesh: each rod stops 3 inside its nodes (the page dropped the in-line spine and hoop)
    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
    [part.stl]
2026-11-08 Scout v4 cage: rod triangles between the props instead of printed outriggers
    Spark 8 Nov: "the solids that extend out do not seem optimal at all". The side spars and the tail
    boom are gone: each side node hangs on a rod triangle on x 0 to two sockets on a small lug on the
    deck's side (0, +-40, z 22 and -10, beside the receiver), the tail node on a triangle on y 0 to the
    deck's tail end and the tail runner's end; the nose node stays on the camera's mount, which reaches
    the front flat anyway. 16 nodes + 7 sockets, 34 rods 3.81 m, nothing over a disc; frame model 61 Hz,
    2.1 mm, Euler <= 0.37, moments <= 408 N mm. seat_check scout_v4 --descent: 0 crossings.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
    [part.stl]
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2026-11-08 head mount v10 (Spark 8 Nov, option A): L2 20 back 60 up, cameras under node 17 behind the cage front, sockets one socket along the cut rods
    The old mount is cut off flush at its socket mouths; the new sockets start there and run one socket further along each rod
    (node 17's 4 tubes in half-pipe channels open toward -x, the front core tie in a closed injectable socket), so the mount
    slides straight back onto the cut ends. The head rods are cut off at nodes 15 / 16 (their sockets one back would make the
    mount ~192 wide, over the 180 plate); the uncut crossbar 15-16, 14 behind the L2 base, takes their place in a 50 long saddle.
    L2 base (364.0, 0, 111.0): the furthest back outside the cage (30..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
    [part.stl]
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2026-11-09 injection ports 2.0 -> 2.5 for the one 14 G tip (Spark 8 Nov), feed ring 2.5; the 8 passing Overseer nodes recut
    socket_inject PORT_R 1.0 -> 1.25, FEED_H 1.5 -> 2.5; cage_node_lib PORT_R 1.25. Nodes 6, 10, 11, 13, 15, 18, 20, 21 recut on
    their meshes (tools/recut.py, 0.04..0.08 cm3 removed each), solid check PASS on all 8. Every socket of the 13 designs finds a
    port direction (8 sockets pass through a neighbour's collar wall 2 mm off its annulus, as the fallback allows). The Scout
    parts are shelved (v4 starts on these constants): not recut.
    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
    [part.stl]
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2026-11-09 box: Overseer bays at 60 and 120 deg beside the drone, 11 bays (every slot of the ring but the drone's)
    Spark 8 Nov: fill the wheel without getting in the way of the landing. The two slots beside the drone were
    never in arm v7; each is now the 0 deg bay (receiver + seated cartridge) turned about the axle, which
    reproduces the existing -60 / -120 / 180 bays exactly. Checked before the merge of main: 17.2 mm clear of
    the funnel, 11.4 of the Overseer and 13.2 of the Scout (cage v19) seated and at every descent state, no box
    part crossed. import_box's landing check now covers every drone that seats in the funnel (scout, scout_v4,
    overseer). Rerun against main's Scout v21 and Scout v4 in progress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
    [part.stl]
2026-11-09 Scout v4: the ceiling probe's head is the front camera (one camera); the DECXIN and its mount go
    Spark 9 Nov: make the probe the front camera as well, the default for v4. Parked on the roof node the
    head (Arducam 5MP autofocus on an ES9051 tilt servo) looks forward 20 deg up, its 69 x 55 deg frame
    clear of every rod and disc (the nose ring 9.5 deg below its eye line); rolled out on the 0.3 m tape
    it is the ceiling probe. The camera's mount becomes a stub for the cage's nose node.
    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
    [part.stl]
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2026-11-09 Scout v4: the roof's middle node is a ring round the probe's throat (the four roof rods end in its sides at r 24)
    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
    [part.stl]
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2026-11-09 funnel: nose and tail walls become sliding carriages; seat_check --walls scout
    Spark 9 Nov: the Scout carries as little as possible, the box takes the rest. The funnel splits along its
    corner hips into a fixed frame (side walls, ledges, skirt, beams, buttress) and two end walls that slide along
    x on the side ledges: setting "overseer" is the 184 seat as before, "scout" moves each wall 39.2 in so the seat
    is the Scout receiver v3's own 105.6 x 65.5 outline and the Scout needs no runners. Frame plus walls equals the
    old funnel exactly. The nose legs only held the nose wall, so the frame ties to the beams by four brackets
    under the seat plane (|y| 26..46, clear of the swap head at the tail). Fr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
    [part.stl]
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2026-11-09 base nodes: O24 foot and 1.5x budget for the 1300 N ground hit; node 7 h 1.05; TPU cap O30 on the O24 foot (Spark: go)
    Runs 8 Nov on the O16 foot at the 0.2 limit: node 2 0.34, 3 0.33, 4 0.25, 5 stopped at 1.09, all in the ground hit.
    Foot R 8 -> 12; budgets 2 / 4 / 5 9.0 -> 13.5, 3 12.0 -> 18.0; the 1300 N and the 0.2 limit kept. Node 7 never ran:
    304k cells at h 1.0 with the 3.0 walls (limit 300k); h 1.05 = 276k. All five audits OK.
    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
    [part.stl]
2026-11-09 funnel v4: the Scout seats on its receiver alone (Spark 9 Nov); wall drive, ledge strips, probes; walls move on the box page
    Agreed with the Scout session and confirmed by Spark: the end walls slide 39.2 in for the Scout, which drops
    its runners and keel. Drawn on the box side:
    - drive: one Tr8 lead screw per side under the side walls' overhang, opposite-hand halves; each wall reaches
    both screws by tabs that lean with the wall through slots low in the side walls; a NEMA 8 per side geared to
    the screw's middle; a switch at each wall position; bearing blocks posted to the beams (placeholders, E)
    - TPU strips flush in the side ledges for the landing impact, and four spring probes in the le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
    [part.stl]
2026-11-09 Scout v4: two-blade probe mast, the receiver-only seat base, one UB0238 camera; Scout v3 off the page
    Spark 9 Nov: the double blade, the mast designed fully with the cheapest parts, the base without the
    runners (the funnel's end walls move in; "seat the scout on the receiver alone"), only the newest
    Scout on the page. The mast is two tape blades curves-facing (a lens tube) wound with the flat cable
    on one spool under the roof where the FC sat, an N20 in a deck pocket turning it through 15/40 T,
    a clock-spring drum for the cable, a 30 mm throat beside the roof's middle node (a ring now). The
    camera is the UB0238 (1080p 30 fps; the B0441 does 1080p at 5 fps). The base is yokes, a nose bay
    (the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
    [part.stl]
2026-11-09 page: a part that is already clean closed shells skips the mesh cleanup (the 0 and 180 deg bays showed as empty slots)
    Spark 9 Nov: "why are there still two empty slots on the side of the box". The bays at 0 and 180 deg are
    watertight (5 closed shells each) but square to the axes, so the cartridge's faces lie exactly on the
    receiver's; view_mesh's merge_vertices + unique_faces fused those faces, opened both shells and dropped them,
    keeping 848 of 4924 faces. view_mesh now returns a mesh whose shells are all closed (decimated only if over
    the face cap). Checked on every part of every system: only those two bays change.
    Claude-Session: h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
    [build_site.py]
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2026-11-09 Scout v4 camera: the Arducam 120 fps mono global shutter USB (Spark's pick), 30 deg up on the probe head
    UVC over USB 2.0 (the Radxa Zero 3W's Linux takes it with no driver), 1280 x 800 mono up to 120 fps,
    130 deg D lens (110 x 90), fixed focus 30 cm to inf. Parked 30 deg up its frame clears every rod and
    disc; the head carries its ~38 square board; the scan drops to 26 frames an opening.
    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
    [part.stl]
2026-11-09 funnel: screw bearing blocks 3 inboard and to |y| 58.5 (an Overseer tube grazed the tail block, 2 mm3, at the +x+y capture limit, h 16)
    Checks after: seat_check overseer --descent 0 of 65 states, scout_v4 --descent (walls in, the receiver-only
    base from main ffda5a0) 0 of 65, box parts vs the funnel at both settings and vs all three drones' landing 0.
    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
    [part.stl]
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2026-11-09 Scout v4 camera: Arducam IMX291 colour, 100 deg lens (B0200)
    Spark: "we need colored camera", the 100 deg over the 160 deg fisheye.
    1920 x 1080 colour, MJPG / H.264 30 fps, USB 2.0 UVC on the Radxa, ~92 x 61
    view, 38 x 38 board on M2 28 x 28 posts, white LEDs. Parked tilt 15 deg
    (-15.5..+45.5, clear of every rod and disc from 10 deg). Scan tilts 5 / 50,
    13 frames a height. Probe ~65 g, ~$106. Appendix tables, inset and view
    cone updated; dimensions row updated.
    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
    [part.stl]
2026-11-09 box: a folding rain and dust dome over the funnel, after noxensys.com's dock (Spark 9 Nov)
    parts/box_dome/make.py draws it the website's way (assets/dock/dock.js): 16 coated-fabric gores on one hinge
    axis along W Y, a 3 mm carbon hoop on every other gore edge and on the free edge, a base ring; opening, every
    gore turns about the hinge down to one side (-W X), so the open dome is a thin bundle at the base. Sized on the
    real drones rather than the site's illustration: one dome over the funnel (both drones land in it, one at a
    time), centre W (0, 255) on W Z 120 (25 under the box top: the Overseer's cage feet hang 14 over it outside the
    box), r 490 = the smallest hemisphere holding the seated O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
    [apron.stl, drive.stl, g00.stl, g01.stl, g02.stl, g03.stl, g04.stl, g05.stl]
2026-11-09 Scout v4 page: the probe mast rolls out 300 mm and back on the timeline
    Spark: "make the artifact show the camera extend and retract". The two
    blades are drawn as 1 mm stubs above the throat (scout_v4_shape mast());
    tools/scout_v4_timeline.py stretches them and lifts the head while the
    drone turns (parked 0-3 s, out 3-7, scan 7-15, back 15-19), with a
    "probe mast out" strip under the scrub bar. build_site frames an assembly
    flagged frame_timeline around every eighth of its timeline, so the raised
    head stays in view; other pages unchanged.
    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
    [part.stl]
2026-11-09 Scout v4 probe: the mechanism drawn, the head nods, LED bars, reach 150 mm
    Spark: "show how it can nod up and down ... a led light for the camera,
    build out the actual mechanism", then "shorten the distance where it's as
    safe as possible". Turret as parts: spool with a toothed 40 T gear, 15 T
    pinion, N20 with encoder, clock-spring spiral, blade feed, see-through
    housing and throat. Head: clip, base plate, SG90 on the +y bracket, idler
    pin, tilt cradle (board on M2 posts, hood, VL53L0X) and two 5 V COB LED
    bars beside the lens. tilt_sweep: -20..+90 deg clear, 3.0 over the plate.
    Reach 300 -> 150 mm (tip ~8x stiffer, buckling ~4x, throat moment 1/2;
    lens ~80 mm above the grid). Timeline: roll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
    [part.stl]
2026-11-09 box dome v2: Scout-size, r 263 (Spark 9 Nov: "i only need it as big as the scout, the overseer will not need to be in that dome")
    The dome now holds the seated Scout v4 only (233 above its base + 30), centred on the seat on W Z 155, and folds
    to -W X, where the Overseer has nothing within 280 of the seat: it lands with the dome open. Since the dome no
    longer covers the box top, a 3 mm polycarbonate rain lid closes it at the sheets' top (W Z 142..145), flush
    between the sheets and as a flange outside them out to the ring, open within r 160 of the seat (the funnel, the
    60 / 120 deg bays and the swap head rise there, under the dome); the funnel's beams stand on it and the
    Overseer's cage feet s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
    [apron.stl, drive.stl, g00.stl, g01.stl, g02.stl, g03.stl, g04.stl, g05.stl]
2026-11-09 Scout v4 probe: cheaper and lighter, fitted to the bought camera
    Spark: "I still want the extender ... more cost efficient and more light
    weight". Camera: the Arducam 12MP autofocus USB (B0FLX58WKZ, bought), 61 x
    50 deg, flown out of its 45 g case (bare board drawn 32 square, E). Cut:
    the encoder (the N20 runs to a stall at both ends), the flat cable and
    adapter boards (the camera's own cable up the mast, round the spool, a
    loose coil in the drum), the distance sensor (AF distance), the steel pins
    (M3 screws). Tilt axis 4 mm lower; sweep -20..+90 clear by 2.7. Probe ~55 g
    (was 64), parts to buy ~$30 (was ~$112). Checks: view clear, no props in
    view, head 30.0 / turret 13.5 from the discs. Wr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
    [part.stl]
2026-11-09 Scout v4 probe: 19 mm tape blades for the fold margin
    Spark: "let's be as safe as possible since it doesn't weigh much to
    increase the tape width". Blades 10 -> 19 mm (3/4 in, from two ordinary
    3 m tapes): ~3.5x the fold moment (E), +5 g, so the mast carries the
    camera even in its case. Spool 21 wide, gear and N20 moved out in y,
    drum narrowed to 6 (one layer of the camera cable), throat x 13.5..21.5
    |y| 11, RM ring r 26..38; the turret's side plates trimmed to the axle and
    drum outlines to clear the discs (12.6, need 12). The blades are drawn
    with their width along the spool's axis (they were turned 90 deg). Bench
    pass: >= 0.2 N m at the throat with a 60 g head. Probe ~61 g, Scout
    ~702 g; v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
    [part.stl]
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2026-11-09 Scout v4 probe: designed to the final parts, camera kept in its case
    Spark's order (8 Nov) and "keep the case on ... as light as possible".
    Head: a cradle (side walls + TPU strap) for the 36 x 36 case, bracket off;
    tilt axis 36 over the throat top (sweep -20..+90 clear by 2.7); lens
    (44, 0, 115). LED bars 25 x 8 (the Clearhill strip's cut length). SG90
    DORHEA tabs 32.8; N20 Augiimor 37 long; DRV8833 on the turret's +y plate.
    To add: a JST ZH 4-pin lead for a thin mast cable, a 470 uF capacitor for
    the servo's start. Not needed: distance sensor, FFC, dowel pins. Probe
    ~95 g, Scout ~737 g; view, discs (head 28.2, turret 12.6) and frame model
    pass.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
    [part.stl]
2026-11-09 Scout v4 probe: compact layout to the parts' real sizes
    Spark: "optimize this design with actual dimensions and the most light
    weight and compact layout possible". Turret: spool hub O20 (flanges O29,
    23.4 wide, axis z 41), 30 / 15 T on 18 centres, N20 in the deck, drum r 11;
    the mast at x 12.5 (the wound tangent), throat x 8.5..16.5, RM ring back to
    r 22..34; housing plates sized to the spool and drum. Head: SG90 output
    face 3 off the cradle, idler bracket 1.5 off (head ~70 across, was 92);
    LED bars on the case's top and bottom fronts, no fins; tilt axis 37 over
    the throat (sweep clear by 2.6). Discs: head 29.7, turret 14.0 (was 12.6);
    view clear; frame model passes. Probe ~91 g, Scout ~732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
    [part.stl]
2026-11-09 head mount v10: tube channels a 7.6 slot along the slide, full clearance only at the collar; budget 84 -> 100
    Run 2 (126.9 g, solid PASS, 0.305 in the core tie tension 425 N) left two members on the right stopping short in air
    at (320..323, -41..-43, 42..48), 3 mm from the wall of tube 17-19's channel clearance: the 18 wide band ran the whole 70
    along the slide, out of the part, and the members heading for that socket from behind stopped at it (Spark 9 Nov:
    weird disconnected members). Only the rod needs the path; the 18 band is kept from 2.6 to just past the collar, where
    it keeps the collar walls over 2 mm. Skeleton check: the nodes and the front pad have no such tips. Audit OK.
    Co-Author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
    [part.py]
2026-11-09 Scout v4 probe: compatibility check; N20 moved off the DS0 socket
    Spark: "a full compatibility check on the parts and the design". Found:
    the N20, outboard along +y, ran through the side triangle's lug socket DS0
    (0, 40, 22) and its rods; now under the spool and drum facing +y, 40 / 12 T
    on 20.8 centres. New check "probe vs cage" (every probe part against the
    cage's nodes and rods): clear; turret 12.3 from the discs. Head wiring is
    6 conductors, not 4 (servo and LEDs ride on the head). Page: a
    compatibility table (fit, clashes, electrics, software, unknowns).
    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
    [part.stl]
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2026-11-09 Scout v4: cage adjusted for the probe, CG centred, the nose stub to rods
    Spark: "adjustments to the cage concerning the new addition, light weight
    and compact while stable"; "the CG for both the drone and the probe
    perfectly centred"; "a solid bridge instead of a rod at one end".
    - RM tied to the core through the turret (its ring and the throat's top
    collar one print): worst 2.1 -> 1.3 mm, Euler 0.48 -> 0.40.
    - The ring's two 215 mm flats dropped (-0.43 m).
    - NB on two 62 mm rods to sockets on the nose bay's face; the base's nose
    stub (the old front camera's mount) is gone.
    - Head CG over its mast (dx -7.5, ay -3.8); everything under the deck 3.8
    forward with the funnel's datum (BX); t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
    [part.stl]
2026-11-09 Scout v4: four-fold symmetric cage; receiver held by 4 x M3 like the Overseer
    Spark: "why is the cage not symmetrical, why don't we move all sides in
    like the current two sides" and "just like the overseer make the bottom
    of the battery mounted with 4 screws".
    - Side flats and PM0 / PM1 gone; roof apexes RS0 / RS1 at (0, +-130, 61)
    like RF / RB; S0 / S1 on Vs to their two ring corners: 32 rods 3.37 m,
    worst 1.2 mm, head-first 12.7 mm (was 14.5).
    - The receiver: 4 x M3 up from below into M3 x 5.7 inserts in the base's
    yokes at its v3 bosses (+BX), drawn as part receiver_bolts.
    - BX 3.7: CG (+0.01, 0.00), head over its mast.
    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
    [part.stl]
2026-11-09 Scout v4: battery mechanism out of the design, 4 M3 bolts left to mount it
    Spark: "get rid of the battery mechanism, leave 4 bolts for it to mount
    to". The receiver, cartridge, pack, XT60, feet and pads are no longer
    drawn (their part files removed); the 4 M3 bolts into M3 x 5.7 inserts
    in the base's yokes stay as the mount. Their 266.5 g stays in the frame
    model's core and in a new balance line (BATTERY_SET at its CG): CG
    (+0.01, 0.00) on the thrust centre; all-up ~734 g (468 drawn).
    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
    [scout_v4_shape.py]
2026-11-09 Scout v4: remove the battery mechanism's part files
    The receiver, cartridge, pack, XT60, feet and pads are no longer part of
    the v4 design (27164e8); their meshes go with them.
    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
    [part.stl]
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2026-11-09 box dome v3: the folding mechanism (Spark 9 Nov: "lets actually design the mechanism for the cover")
    Five 3 mm carbon hoops (one 1 m rod each, bent to r 263..299, 9 apart, no joints) on one hinge axis across the
    box (W X, Z 157), each ending in a 7.4 mm PCTG plate at both hubs, stacked 9.1 apart on a 6 mm shoulder bolt.
    A folding fan: plate k+1's 3 mm carbon pin rides in a 45 deg slot in plate k, so neighbours stay 0..45 apart; a
    self-locking JGY-370 worm motor (12 V, 6 rpm, double shaft) at each hub turns only hoop 4: opening it sweeps
    180 -> 0 and picks up hoops 3, 2, 1 in turn; shutting it pulls each out after it to 45 apart. Shut, the worm
    holds hoop 4 and hoop 0 is fixed, so the slots f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
    [drive.stl, fabric_00.stl, fabric_01.stl, fabric_02.stl, fabric_03.stl, fabric_10.stl, fabric_11.stl, fabric_12.stl]
2026-11-09 Scout v4: topology setups for every printed part (audits in progress)
    Spark: "generate everything with the best dimensions you can find".
    Setups: 16 cage nodes (parts/scout_v4_node_lib.py on the v4 frame
    model's node loads, systems/scout_v4.cage_loads.json), the frame (deck,
    arms, pods, side lugs), the base as nose and tail units (183 mm in one
    piece; the A1 mini prints 180), the probe turret (housing, throat, drum,
    RM), the head frame and the camera cradle (parts/scout_v4_units_lib.py,
    parts/scout_v4_base_lib.py). Dimensions: listings and datasheets where
    found (Arducam board 32 x 32 in a 36 case, SG90 22.2-23.1 x 11.8-12.2,
    tape blade t 0.11-0.19 / cup R 12.7-25.4 from patents, N20 gearbox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
    [part.stl]
2026-11-09 Scout v4 setups: audit fixes (head frame, cradle, base units), UBEC behind the turret
    The head frame's idler bracket room 10 (a 4.4 slab was a neck), its clip
    1 taller; the cradle's pads and back stop 2.8; the Radxa's posts O8 and
    the Radxa 1.5 higher; the XR2 / DRV8833 lands 3.2 and the nose bay |y| 30;
    the FC 3 up off the bay's floor; two deck bolts to (-40, +-18), out of the
    Radxa's footprint. The UBEC is 61 long: under the deck x -75..-14, behind
    the turret's N20 (at -47 it ran into the motor's pocket). BX 1.3: CG
    (-0.01, 0.00). Head-first: 2.07 N m on BS0-S0 (cap 2.0 E).
    Claude-Session: https://claude.ai/code/session_01EtHMZPtmpwp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
    [part.stl]
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2026-11-09 results: [scout_v4_node_rs0]
    [part.stl]
2026-11-09 results: [scout_v4_node_rf]
    [part.stl]
2026-11-09 results: [scout_v4_node_rb]
    [part.stl]
2026-11-09 results: [scout_v4_node_p4]
    [part.stl]
2026-11-09 results: [scout_v4_node_r0]
    [part.stl]
2026-11-09 results: [scout_v4_node_p3]
    [part.stl]
2026-11-09 results: [scout_v4_node_p6]
    [part.stl]
2026-11-09 results: [scout_v4_node_p2]
    [part.stl]
2026-11-09 results: [scout_v4_node_rs1]
    [part.stl]
2026-11-09 results: [scout_v4_node_s0]
    [part.stl]
2026-11-09 results: [scout_v4_node_p1]
    [part.stl]
2026-11-09 results: [scout_v4_node_r7]
    [part.stl]
2026-11-09 results: [scout_v4_node_nb]
    [part.stl]
2026-11-09 results: [scout_v4_node_p5]
    [part.stl]
2026-11-09 results: [scout_v4_node_s1]
    [part.stl]
2026-11-09 results: [scout_v4_node_tb]
    [part.stl]
2026-11-09 results: [scout_v4_cradle]
    [part.stl]
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2026-11-09 front pad: ring boss back (Spark 9 Nov: yes), its 8 Nov result restored; base nodes 2, 3, 5: ground-hit limit 0.3
    Front pad without the ring: 0.41 in the 35 g downward crash (the pad stood on four posts over a gap). part.py is back to
    the 8 Nov file, setup d054fc301a328de2, whose CI result (6c654fd: 41.4 g, solid PASS, 0.26) is restored as it was.
    Nodes 2 / 3 / 5 at 2.25x budget gave 0.23 / 0.22 / 0.28 against 0.2; the limit is 0.3 as every other case (Spark: yes).
    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
    [part.stl]
2026-11-09 results: [scout_v4_probe_turret]
    [part.stl]
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2026-11-09 topo/run: a setup that cannot be built at 2h skips the coarse stage instead of killing the run
    setup(2h) ran outside the try that catches the coarse Layout's ValueError, so
    scout_v4_base_nose (SPEC h 1.5) died at 2 min in CI run 42575222053: its thin
    DRV8833 side land's load region is empty at h 3.0 and Part.load_multi raised.
    The 2h setup is now built inside the same try; the skip log line carries the
    error and the fine layout starts cold. test_topo: t_coarse_setup_fails (a
    0.4 mm load slab, empty at h 2.0, found at h 1.0). Engine tag coarse-setup-skip.
    Claude-Session: https://claude.ai/code/session_01EtHMZNQFoZcqtaRg1KTPxm
2026-11-09 results: [scout_v4_frame]
    [part.stl]
2026-11-09 head mount v10: L2 cable slot a notch at the flange; core tie port down
    Run 3 (147.5 g, strength PASS 0.18, gate FAIL): a 1.1 mm wall at (341, -1, 54) beside the core tie's upward port, and
    members ending in air at (322 / 332, -41, 42..49). Those end at the L2 cable slot, which ran 120 down from the base: with
    the L2 60 up it cut through the mount's right side (the channel change of run 3 was not the cause). The slot is now 32.5..55
    from the axis (past the flange), the port points down between the cameras. Audit OK.
    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
    [part.py]
2026-11-09 arms: circular motor pad (O36 top plate 3 + rim 3.5 + the 4 lugs); front pad two socket lengths back
    Spark 9 Nov: the motor mount base completely circular and less likely to shatter: no notches between lugs for a crack to
    start. A solid O36 x 14 disc is a drawn block to the audit (core 11 / 9 mm), so the pad is a whole-circle top plate 3 thick
    and a rim 3.5 wide the full 14 deep round the 4 screw lugs; the pockets between are design room.
    Front arms (Spark: replaced once, now cut again): tube sockets 34 toward the root, spoke sockets 24 out from the arm node
    (was 17 / 12). Two back, spoke 1.1's collar stands alone and its lib wall was 2.0 at the grooves (drawn_wall): the 3.0 ring
    now starts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
    [overseer_arm_lib.py, part.py]
2026-11-09 front pad (two sockets back): budget 18 -> 28; run 1 stopped at 1.03 in the cage crash (spoke 1.1 -238 N on the longer reach)
    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
    [part.py]
2026-11-09 audit: solid_ok bodies (Part(..., solid_ok=[...])) skip drawn_blocks and the drawn-structure check
    Spark 9 Nov: the arm motor mounts are solid under the motor so they do not crack again.
    Declared bodies are listed in result.json audit.solid_ok and are part of the setup hash;
    every other audit rule and the gate are unchanged. test_topo: t_audit_solid_ok.
    Engine tag solid-ok.
    Claude-Session: https://claude.ai/code/session_01EtHMZMnsZVRVWeNSpu7AGc
    [part.py, part_sha.py]
2026-11-09 arms: solid motor pad O36 x 14 on a solid cone (8 deep, O36 -> O28), declared solid_ok; arm limit 0.3 -> 0.2
    Spark 9 Nov: the entire motor mount, even under the circular plate, solid ("a lot of material there so it doesn't crack and
    break again"), and the motor must not tear off with its mount again. The circular plate run left the pad layer 52 % solid
    and the band under it 3 %. Now the pad and a cone under it are drawn solid, declared solid_ok (engine 9ca145a), cut only by
    the bore, the 4 slots and the 4 driver sweeps; the generator joins the cone to the arm. Strength limit 0.2 on both arms
    (rear 0.10 on the circular plate); front pad budget 28 -> 36 (two sockets back). Both audits OK.
    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
    [overseer_arm_lib.py, overseer_tube_arm_lib.py, part.py]
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2026-11-09 Organisation: design chat stays free (workers do the waiting, report once, archive themselves), no dispatch after a push, weekly sweep, CI commit fixes, 35 unused meshes archived
    - CLAUDE.md: Sessions section (Spark 9 Nov): the design chat only talks, decides and starts workers; one worker per
    stream, at most 3 per chat and one engine worker; a worker runs the loop alone (the 9 Nov "make these choices yourself"
    rule from claude/fervent-ritchie-4b1zxu, replacing operator/auto mode), reports once with send_message and archives
    itself. Check-ins move into the worker. The dispatch after a push is gone: every session push is under Spark's
    account and already starts the runs (15 of 54 push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
    [part.stl]
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2026-11-09 Scout v4 frame: one body with the base, real motor loads (Spark 9 Nov)
    The deck, arms, motor pods, side lugs and the base (yokes for the battery
    mechanism's 4 M3, nose block, flow pod, tail tray) are one PCTG print in
    parts/scout_v4_frame; scout_v4_base_nose / _tail and their 12 deck bolts
    are retired (folders, lib and assembly rows removed).
    - Fits the A1 mini: inside |x|,|y| <= 89.3. DN/BN/DT/BT moved in to
    x +-75.5 so their collars end at 89.2; the nose bay is gone: the FC and
    the Radxa hang under the deck over the receiver on posts, the XR2 and
    DRV8833 flat under lands beside the FC, the UBEC on the tail tray floor.
    - Printed deck-top down (build -z): each motor pad is in its arm'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
    [part.stl]
2026-11-09 Scout v4 nodes NB TB S0 S1: the frame's paired sockets now 12-14 deg apart (one-body frame on the A1 mini), bores 29-34 mm out: a short Y, limit 25 -> 36 (v4-only)
    Smokes at h 1.0: audit OK, 72-82k cells, drawn 12-13 %.
    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
    [scout_v4_node_lib.py]
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2026-11-09 rear arm: motor mount filled solid on the passing result (Spark 9 Nov: no rerun, more material at the motor mount)
    tools/recut.py now fills the setup's solid_ok bodies before cutting the holes (the layout had kept the solid_ok pad as
    2.5 mm skins: 50 % solid). overseer_arm_rear: +7.6 cm3, 96.9 g, solid check PASS, one body; the pad z 31..45 89 % solid
    (the rest is the bore and the 4 slots), the cone 59 % of its O28 cylinder (the 4 driver sweeps). Strength recorded 0.094
    (limit 0.2) is the unfilled layout's: material only added.
    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
    [part.stl]
2026-11-09 print/: the rear arms on their side, ready to slice (left = part.stl turned drone +x up, right = its y-mirror)
    parts/overseer_arm_rear/part.stl is in the drone frame, so a slicer lays it flat (layers across the thrust: the way the old
    arms snapped). These are turned so the layers stack along the drone's x: thrust and bending in-layer. Footprint 46.5 x 132.4,
    66.1 tall.
    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
    [overseer_arm2_left_rear.stl, overseer_arm3_right_rear.stl]
2026-11-09 Scout v4 probe: the mast simulated, final mechanism (Spark 9 Nov: one spool or two)
    tools/probe_mast_sim.py (coil plate theory, stroke torque, blossoming elastica, cable) and
    tools/probe_mast_fe.py (CalculiX: flat-to-lens transition, fold, buckling), plots in systems/probe_sim.
    Decision: one spool. The blades' fight is length: the wires between them on the coil made A pay
    out 17.3 mm more than B (the clip took 3). Two spools do not fit under the props' keep-out (~75 mm
    across, |x| <= 20 allowed) and would coil both blades opposite sense.
    - hub r 14 (von Mises 1574 -> 1283 MPa), mast x 15.1, 6 x 30 AWG PTFE ribbon 0.6 (fight 7.5 mm)
    - head: 14 mm sleeve, B's M2 in an 11 mm slot, ribbon loop (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
    [part.stl]
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2026-11-09 Scout v4 nodes NB TB S0 S1: budgets 1.25 -> 1.7 / 1.35 x skeleton (run 2 as Ys: NB 0.357, TB 0.378 fail, S0 0.266, S1 0.283)
    The fork's two supports 29-34 mm out lengthen the load path from the cage rods' sockets; more generated material, nothing drawn.
    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
    [scout_v4_node_lib.py]
2026-11-09 Print meshes out of git: the full mesh to the 'meshes' release, a viewing mesh in part.stl
    Each result committed its full part.stl (up to 27 MB; meshes were 93 % of git storage, 441 MB at HEAD).
    tools/print_mesh.py publish uploads the gated print mesh as release asset meshes/<part>.stl
    (url + sha256 in result.json print_stl) and puts a 60k-face viewing mesh (~3 MB) in part.stl.
    parts.yml does it before either commit path; a failed upload leaves no result. recut.yml recuts
    the release's print mesh and re-uploads. meshes.yml migrates old results and moves print/*.stl
    to the release (print/index.json). The page links each part's print file. The bore check
    (stale_parts socket_mismatch) and recut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
    [build_site.py, motion.py, print_mesh.py, recut.py, stale_parts.py]
2026-11-09 meshes: print meshes to the release, viewing meshes in git
    [overseer_arm2_left_rear.stl, overseer_arm3_right_rear.stl, part.stl]
2026-11-09 meshes.yml: a part whose result lands mid-job keeps main's files instead of failing the rebase
    The first full migration lost its commit to a binary conflict on scout_v4_cradle/part.stl.
    Claude-Session: https://claude.ai/code/session_01EtHMZQH4kukTSpdndvPGbR
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2026-11-09 results: [scout_v4_cradle,scout_v4_head_frame,scout_v4_probe_turret]
    [part.stl]
2026-11-09 Archive Scout v3: its parts, bee35_plate.py and its dimensions section to archive/
    Moved: the 21 generated v3 parts (15 cage nodes, 4 arm clips, nose and tail units: all stale, so a blanket
    dispatch would have rerun them), the v3 mesh-only folders (cage v21, props, camera, Bee35 plate, pack, XT60),
    tools/bee35_plate.py, and the System Scout v3 section of systems/dimensions.md (archive/dimensions_scout_v3.md).
    Kept, because Scout v4 or the box reads them: systems/scout.assembly.json, scout.cage_loads.json,
    tools/scout_cage.py, scout_cage_loads.py, scout_meshes.py and the bought meshes scout_v4_shape places.
    The box's seat checks (seat_envelope, seat_check both, wheel_sweep) now seat scout_v4;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
    [envelope.stl, part.stl]
2026-11-09 stale_parts: bore check by the nearest wall, not mid-socket
    socket_mismatch probed each socket at mid-depth on 3 rays; since the
    injection pattern that depth is in the 0.5 annulus between the lands, so
    every Overseer node read bore_r + 0.5 and all 21 were flagged. Now: the
    nearest wall over 24 rays at 12 depths (every cut only widens a bore, the
    lip and lands sit at bore_r), on the viewing mesh (no print-mesh fetch),
    skipping mirror dirs with no part.py. 21 -> 0 flagged; viewing mesh within
    0.024 mm of bore_r on all 78 sockets; a wrong bore (swapped bore_r on 13
    nodes, a 3.2 sleeve in a 6.2 socket of node 5) still flags.
    Claude-Session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
    [stale_parts.py]
2026-11-09 Scout v4 nodes: socket supports and loads on the bore only (floor to mouth), not 0.5 behind the floor
    Run 3: every Y node's worst (NB 0.276, TB 0.319 fail, S0 0.269, S1 0.284) sat at the rim of the support's lining where it reached
    0.5 behind the collar's floor into the room, a rigid disc the generated material joined; +36 % budget moved S0 0.266 -> 0.269.
    The rod bears in the bore: the region now starts at the bore floor (LINING_BACK 0.0, the v4 nodes; the lib default unchanged).
    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
    [scout_node_lib.py, scout_v4_node_lib.py]
2026-11-10 results: [overseer_cage_node_4,overseer_cage_node_3,overseer_cage_node_2,overseer_cage_node_5,overseer_cage_node_6,overseer_cage_node_7,overseer_cage_node_10,overseer_cage_node_11,overseer_cage_node_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
    [part.stl]
2026-11-10 Overseer: front pad spoke room a cone, base O14 clamp pads, nodes 5/6 budgets for PCTG
    - overseer_arm_front_pad: refused at room_full 1.40 (cage crash, spoke 1.1 -238 N): the pushed-out
    spoke collars sat on an r 9 tube of room. Now a hull from the arm node (r 18) to each collar
    (r 10.5): room_full 0.104. Budget 36 -> 40.
    - overseer_base: 1.26 (crash 7, pack 750 g) on the bottom fibre under the (-52, 38) pad: pads
    O9 -> O14 (the M3 clamp cone), support r 7.5; budget 60 -> 80.
    - overseer_cage_node_5 0.305, node_6 0.319 (PETG 0.282): budgets sized at the PETG margin,
    20 -> 23 and 4.9 -> 5.7.
    Smokes at the SPEC h: audit OK (front pad, base).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
    [part.py]
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2026-11-10 export: a pinch no longer drops the part's body; an export that loses volume is a FAIL result
    10 Nov, scout_v4_frame: the weld rounds vertices to 1e-4 mm, so two surfaces touching within that (a pinch)
    welded into a non-manifold edge; trimesh called the 95 cm3 shell not watertight and weld_mesh dropped it whole,
    leaving 55 mm3 of specks that passed as a watertight export. Reproduced on a 1.7M-face organic part (the
    simplified second pass kept 5.8 of 439 cm3). Now the pinch clusters stay unwelded and move 1 um into their own
    surface (reload-stable), an open shell over 10 mm3 is never dropped, an export more than 0.1 % under the exact
    volume raises ExportError, and build_and_check writes that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
2026-11-10 predict: engine export-pinch (weld keeps pinched bodies, export/strength fail cleanly)
    Claude-Session: https://claude.ai/code/session_01EtHMZM7zEBXVWtKohdh2HF
2026-11-10 latch v5: press-two-tabs latch with steel bolt pins, ledge + 20 deg seat ramp, XT60 guide poles, rest-stop lugs; battery-side motion page
    Built on the vendored latch v4 CAD (parts/latch5/battery_latch_v4.py). Checks in parts/latch5/result.json: no fit, squeeze,
    insertion or held-pull interference; solid gate PASS on receiver, carrier, cap, cartridge, slider. Page: systems/latch5.assembly.json.
    build_site: pages label printed mass at PCTG density.
    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
    [blade_n.stl, blade_p.stl, bolt_pin_n.stl, bolt_pin_p.stl, carrier.stl, carrier_cap.stl, cartridge.stl, cartridge_strip_nx.stl]
2026-11-10 Scout v4 probe check-in 1: cradle PASS; turret RM arms shortened, head frame crash stop
    - cradle: PASS 8.2 g, worst 0.17 (head-first 250 N)
    - turret FAIL 0.72 at RM-RB (30.2 g): its four sockets reached out to r 34; each mouth now as near
    as its neighbours allow (tools/scout_v4_shape.RM_MOUTH: RF 33 clear of the throat's slot, RB 26,
    RS0 29, RS1 34). Smoke: audit OK, room_full 0.139
    - head frame stopped early at 5.3: the 250 N head-first went through the SG90's pads and the idler
    on 3 cm3. Hit on top, the cradle turns down (the SG90 slips at 1.8 kg cm) and lands on a drawn
    crash stop on the plate under the camera's lower front edge (the sweep's lowest point): 250 N on
    the stop, 18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
    [part.stl]
2026-11-10 latch v6: twin springs, cartridge-side wedge grip with heel pads, hold table, motion page
    Two steel springs between the tabs (2.2 x the 35 g slider inertia). The grabber grips the
    cartridge instead of the loose tabs: 10 deg self-locking wedge feet on the centre rib, hook
    nubs on the blade tips, four heel pads on the rim bands. Every v5 check plus spring, rib,
    six-direction hold, bending, Overseer fit and a per-frame collision check of the motion.
    Claude-Session: https://claude.ai/code/session_01EtHMZQ63j64XEYVCACxi6b
    [blade_n.stl, blade_p.stl, bolt_pin_n.stl, bolt_pin_p.stl, carrier.stl, carrier_cap.stl, cartridge.stl, cartridge_strip_nx.stl]
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2026-11-10 Scout v4 nodes: 2.1 between near-parallel bores (not WALL): the Ys' forks 33.5 -> 29.3 / 29.2 -> 25.6; TB budget 1.7 -> 1.9
    Run 5: 15 of 16 pass; TB 0.320 (96 N pull-out) just outside its fork collar's floor, NB 0.278 at 77 N: the moment down the fork.
    Two near-parallel collars are one drawn body: the audit's wall between their grooves (2.1) is enough, the lever 12 % shorter.
    Smokes at h 1.0: all 16 audits OK, 41-72k cells.
    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
    [scout_node_lib.py, scout_v4_node_lib.py]
2026-11-10 latch v7: audit of v6 (error budget, force balance, real loads), resized grip, crowned push pad, spring guide pins
    [blade_n.stl, blade_p.stl, bolt_pin_n.stl, bolt_pin_p.stl, carrier.stl, carrier_cap.stl, cartridge.stl, cartridge_strip_nx.stl]
2026-11-10 latch v7: spring guide pins on the page, corrected v6 comparison, numbers section
    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
    [spring_pin_a.stl, spring_pin_b.stl]
2026-11-10 results: [scout_v4_head_frame]
    [part.stl]
2026-11-10 recut: overseer_arm_front_pad
    [part.stl]
2026-11-10 print/: the front pads on their side, ready to slice (left = the print mesh turned drone +y up, right = its mirror)
    From the CI print mesh (277,716 faces, the solid-filled recut of 10 Nov: 86.3 g PCTG, pad 89 % solid, solid check PASS,
    strength 0.19 of 0.2). Turned to the setup's build +y so thrust and bending run in-layer; the right pad is the mirror with
    its outboard side up too. 85.8 x 63.7 on the bed, 71.6 tall.
    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
    [overseer_arm1_left_front_pad.stl, overseer_arm4_right_front_pad.stl]
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2026-11-10 overseer_base: the M3 head's bearing ring as support beside the pad top
    Run at 80 cm3 / O14 pads: 0.962 (crash 7, pack 750 g) on the head clearance's rim under the
    (-52, 38) pad. The clamp holds the pad on both faces (plate above, head below); the model held only
    the top. Smoke at h 1.7: audit OK.
    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
    [part.py]
2026-11-10 overseer_head_mount: crossbar sockets' clearance band at the collar's width (two 12 mm stubs ending in air)
    v11 passed (0.241, 140.5 g) but the skeleton-tip check found two 12-13 mm members, 8.4 thick,
    ending 7.6 mm from every attachment at (349, +-35, 115): aimed at the back of the cut-bar collars,
    stopped at the 18 wide clearance band that carved +-9 round the bar behind its r 6.6 collar. The
    band is now the collar's width there (13.2). Smoke at h 2.0: audit OK.
    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
    [part.py]
2026-11-10 recut: overseer_arm_rear
    [part.stl]
2026-11-10 dimensions: socket resin is G/flex 650 (Spark 9 Nov), injected with a 3 ml syringe and a 14 G blunt tip
    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
2026-11-10 latch v7 for both packs: one 3 x 20 dowel size, printed spring guides, Overseer set and page; funnel hole and seat resized to the real latch sets, fit check
    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
    [blade_n.stl, blade_p.stl, bolt_pin_n.stl, bolt_pin_p.stl, carrier.stl, carrier_cap.stl, cartridge.stl, guide_pole_n.stl]
2026-11-10 funnel: strips and drive meshes after the seat resize
    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
    [part.stl]
2026-11-10 Scout v4 frame: budget 60 -> 120, wider arms, lugs and nose block (run 186: FAIL 1.515, BN-NB, 117 g)
    The result read what the audit's uniformly-thinned estimate predicted (room_full 0.261 / budget
    share 0.177 = 1.48; final 1.515): with this many separate load paths the layout gained little over
    uniform thinning. Budget 60 -> 120 cm3; the nose block's room |y| 26 -> 34 (as the tail tray, the
    BN socket's region), arms' room 26 -> 32 wide (motor 1's root 1.25 in-layer), the lugs' room
    x +-20 -> +-28 (BS1-S1 1.28 across the layers: the lug bends as a column), the FC posts' clear
    ring r 6.5 -> 7.5 (one post off the main body). Smoke: audit OK, room_full 0.256 (BT-TB),
    budget 30 % of the room, th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
    [part.py]
2026-11-10 funnel: Overseer seat 1.98 toward the tail so both tab lines sit on the grip line; Scout wall setting 37.2
    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
    [part.stl]
2026-11-10 funnel: trim a zero-volume fin left at the tail after the seat shift
    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
    [part.stl]
2026-11-10 Scout v4 nodes, round 2: socket depth per socket from its load, 2.55 collars, the mouth plane and paired bores off coincident faces
    - depth = max(7.0 injection pattern, 2.0 lip + axial / 56.5 N/mm (G/flex 650 on sanded G-10 3,459 psi PATTI, half, x2 on crash),
    4 V / (3.2 x 5.3 MPa) mouth bearing): 7.0 every cage rod (was 10), the Ys' DN/DT 13.5 and BN/BT 11.5 (645 / 528 N; 10 had x1.4)
    - hub collars 2.55 (2.05 at the grooves), outside round with only the wall over the crown (no 1.7 mm ridge along the top)
    - strut room ends 1.0 short of the mouth, keep-out starts 0.5 past it (the sliver sheets in the mouths of P1 / P5 / R0)
    - hub pairs of near-parallel bores 2.4 apart at the grooves (2.1 pu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
    [scout_node_lib.py, scout_v4_node_lib.py]
2026-11-10 latch v7: four landing feet on the Scout receiver so the funnel holds it along its length
    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
    [part.stl, receiver.stl]
2026-11-10 latch v7 both: Scout on the left in the section view, short view names
    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
    [latch7_both_motion.py]
2026-11-10 Scout v4 probe: bench-test prints (drawn mechanism parts), turret and head frame run 3
    Spark (9 Nov): "start printing the parts needed for the bench test". Drawn, not topology, one make.py each:
    - spool + 40 T gear, 12 T pinion: involute m 0.8 generated by a rolled rack, x -0.35 / +0.35 (no undercut,
    centres 20.8), backlash 0.15 (2D roll: no contact, 0.155 play); D bore 3.1 / 2.6, axle bore 3.4
    - roller tube O10.1 (O8 left 1.0 round the MR63ZZ seats; ROLLER r 5.05 in the shape tool)
    - fit coupon (every fit x3, the pair on 20.8 / 20.9 / 21.0), bench base (posts + inserts at the turret's bolts)
    - bench turret: the flight turret's drawn mechanism and cuts on flat plates (no keep-out, no RM so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
    [part.stl, scout_v4_probe_bench_base.stl, scout_v4_probe_bench_turret.stl, scout_v4_probe_coupon.stl, scout_v4_probe_pinion.stl, scout_v4_probe_roller.stl, scout_v4_probe_spool.stl]
2026-11-10 Scout v4 probe: gear outlines simplified to 8 um (spool 165k -> 10k faces), sim plots as palette PNGs: the page under 16 MB
    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
    [part.stl, scout_v4_probe_pinion.stl, scout_v4_probe_spool.stl]
2026-11-10 results: [overseer_arm_front_pad,overseer_base,overseer_cage_node_5,overseer_cage_node_6]
    [part.stl]
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2026-11-10 Overseer TPU boots for the printed base nodes (Spark 10 Nov: all bottom nodes cracked, need shock absorption)
    One push-on TPU 95A boot per printed base-node design, fitted to the meshes Spark flew: node 5 36fce92
    (the 29 Oct FINAL print), node 2 3432732, node 3 188a69f (fits 1 and 3), node 4 6457305 (fits 0 and 4).
    Cavity = the node's lobe sliced every 0.25 mm, 0.15 under for grip, a 1.2 mm 45 deg snap lip over the
    bulb, zip tie groove; a 15 mm O48 sole for 20 % gyroid crush (~7.5 mm stroke, ~800-900 N peak vs the
    cage model's 1300 N, E). Replaces the 8 Nov glued cap (it fit the unprinted O24 foot). Solid check PASS
    on all four; funnel: seated clear, 3 of 65 descent states (node 3 cup at the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
    [overseer_tpu_foot_node2.stl, overseer_tpu_foot_node3.stl, overseer_tpu_foot_node4.stl, overseer_tpu_foot_node5.stl, part.stl]
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2026-11-10 overseer_arm_front_pad: the 02:45 recut's result back (the 04:36 batch commit had put the run's own result over it)
    The release still holds the recut's print mesh (sha256 64a38816, fetch verified), so recut.yml
    refused on the mismatch; result.json, the viewing mesh and preview from 0197376 match it again.
    86.3 g, watertight, solid check PASS, pad 88.7 % solid. parts.yml now keeps such recuts (recut_of).
    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
    [part.stl]
2026-11-10 Overseer TPU boots v2: 68D cup + in-plane honeycomb crush puck (Spark 10 Nov: the spool is TPU for AMS)
    Design session for the cracked base nodes. Bambu's own numbers: TPU for AMS is 1190 / 600 MPa and yields near 3 %,
    so no elastic 68D pad of this size holds the 9.7 J worst case (1.65 kg from 0.6 m onto one node); it folds without
    breaking only in plane (650 %, vs 31 % across layers). So: v1's push-on cup (fit adapted: lip 0.5, interference 0.08,
    zip tie in the top 3 mm mandatory) over a pocket holding a replaceable crush puck, 50 x 40 x 20 of 3 x 3 hex cells
    (side 9.0, wall 2.0) printed on its side so the folds run along the layers. Model (absorber_model.py, Gibson-Ashby,
    flow stress 15 MP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
    [overseer_tpu_foot_crush.stl, overseer_tpu_foot_node2.stl, overseer_tpu_foot_node2_95a.stl, overseer_tpu_foot_node3.stl, overseer_tpu_foot_node3_95a.stl, overseer_tpu_foot_node4.stl, overseer_tpu_foot_node4_95a.stl, overseer_tpu_foot_node5.stl]
2026-11-10 Scout v4 frame: socket depths from their loads (the NODES stream's rule, 10 Nov)
    units_lib.socket_depth (= scout_v4_node_lib.socket_depth: G/flex 650 bond 56.5 N/mm past the 2.0 lip,
    mouth bearing at 5.3 MPa, 7.0 least): DN / DT 13.5, BN / BT 11.5 (645 / 528 N had x1.4 at 10),
    DS / BS 7.0. The end sockets' mouths stay inside the A1 mini's 180, so their extra depth goes behind
    the standard floor: DN-NB / DT-TB rods 3.5 longer, BN-NB / BT-TB 1.5 longer at the frame end. The
    lug sockets keep their floor, mouths 3 nearer. Drawn bodies clipped at the bed plane (DN / DT's
    collars rose to 24.8 at their back). Smoke: audit OK, room_full 0.246, budget 29 %.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
    [part.py, scout_v4_units_lib.py]
2026-11-10 Scout v4 probe check-in 3: head frame PASS 22.2 g (0.23); turret 0.50 -> budget 20
    - head frame: PASS 22.2 g, worst 0.228 (SG90 stall), solid check PASS
    - cradle: PASS 8.2 g, 0.17 (unchanged)
    - turret: FAIL 0.504, the 1.2 N m fold in y at (19.8, 10.2, 31.7), the +y roller guide, where the
    head-first crash (0.42) peaks too: one strut from the throat past the guide to the floor bolts,
    30.1 g on 14 cm3. Budget 20 for a second path; the setup is otherwise unchanged (audit as smoked)
    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
    [part.py]
2026-11-10 Scout v4 nodes round 3: a mouth cut beyond every socket, room to the mouth plane
    The paired sockets' strut room reached over the neighbour's mouth, where its keep-out and lead-in carved
    notches; the room ended 1.0 short of every mouth, leaving a proud drawn ring. Each socket now has a cut of the
    room's radius + 0.5 from its mouth plane out (other collars spared by 0.5), the room runs 2.0 into it, the collar
    ends on the plane. Drawn collars unchanged; v3 nodes unchanged (MOUTH_R off).
    Claude-Session: https://claude.ai/code/session_01EtHMZMgut3Vh3dBoxFhuvQ
    [scout_node_lib.py, scout_v4_node_lib.py]
2026-11-10 Overseer TPU boots v3: one 68D body per node, honeycomb crush zone cut in, 31 under the landing face (Spark 10 Nov: aesthetic, "too tall", "one body")
    Claude-Session: https://claude.ai/code/session_01EtHMZLFQRxeNAkH1LJHCx6
    [overseer_tpu_foot_node2.stl, overseer_tpu_foot_node2_95a.stl, overseer_tpu_foot_node3.stl, overseer_tpu_foot_node3_95a.stl, overseer_tpu_foot_node4.stl, overseer_tpu_foot_node4_95a.stl, overseer_tpu_foot_node5.stl, overseer_tpu_foot_node5_95a.stl]
2026-11-10 overseer_base: budget 125 -> 140 (0.516 in crash 7, pack 750 g; 173.5 g)
    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
    [part.py]
2026-11-10 TPU boots on the page: part.stl is the six boots on their nodes in the drone frame; assembly line (Spark 10 Nov: put the bumpers on)
    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
    [part.stl]
2026-11-10 TPU boots page mesh: 180k faces (60k for six boots wiped out the cells and rounded corners on the page)
    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
    [part.stl]
2026-11-10 Scout v4 probe turret run 5: no room under the spool (skins), budget 23
    Run 4 (20 cm3): FAIL, 37.7 g, worst 0.341 head-first at (11.4, -17.4, 44.9), solid check: thin walls
    1.1-1.5 at z ~25 under the spool, where its sweep (down to z 24.1) and the N20's gearbox (up to 25.5)
    leave room only for skins. That band is a cut now; budget 23. Smoke: audit OK, room_full 0.140.
    The class (room thinner than a member between two cuts, filled by skins) has no audit check yet:
    it belongs to the engine worker.
    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
    [part.py]
2026-11-10 TPU boots on the page: one entry per boot, cavity full in the page view
    Six boots in one entry got ~3k faces each on the page (Spark: looks weird); each boot is now its own
    entry (parts/overseer_tpu_foot/page/node<k>.stl, 10k faces), drawn with the cavity full since the
    node on the page fills it. Print files unchanged.
    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
    [node0.stl, node1.stl, node2.stl, node3.stl, node4.stl, node5.stl, part.stl]
2026-11-10 Overseer battery tray v1: drawn, zip ties, on the base's 4 M3, pack front on x 60
    Spark 10 Nov: the drone is tail heavy; a holder as far forward as it goes, bolted to the 4 inserts,
    zip ties, nothing generated. The flow sensor's down view sets the front limit (pack x -78..60,
    centre -10). 63 g PCTG, solid check PASS. Print file goes to the meshes release.
    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
    [overseer_battery_tray.stl, part.stl]
2026-11-10 latch v7 made stronger on both packs: bolts 42 wide on two pins, two-hook 34 mm blades, four springs, full-length feet, gusseted rib
    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
    [blade_n.stl, blade_p.stl, bolt_pin_n.stl, bolt_pin_p.stl, carrier.stl, carrier_cap.stl, cartridge.stl, cartridge_strip_nx.stl]
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2026-11-10 Scout v4 frame: the receiver cut's corners rounded, a handling case on the flow pod (run 188: FAIL 0.785, 191 g)
    Run 188 (b9cfed5): worst 0.785 in-layer (0.70 across) at the receiver box's tail corner (BT-TB 527 N),
    the solid check failed on the flow land's 1.8 mm necks; pods <= 0.48 in-layer, 0.33 across.
    - The receiver keep-out's vertical corners round r 5 above z -2.6: the receiver v3 mesh is empty
    in that zone at both ends (checked point by point), the square cut was a stress raiser.
    - The flow pod gets a handling case (10 N up, 10 N side, misuse): it is the frame's lowest, most
    exposed printed feature, picked by hand, and carried 1.5 g so the layout left it on a neck.
    Smoke: audit O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
    [part.py]
2026-11-10 Scout v4 probe turret run 6: drawn N20 cheeks, drum wall 4.0, no room under the motor axis
    Run 5 (23 cm3): 41.0 g, worst 0.325 head-first in the drum's 2.5 drawn ring (11.4, -17.4, 44.9),
    solid check FAIL: 3 bodies (two 1.7 strips beside the N20's can, room the pocket left below its
    axis). The pocket's room now starts at the axis; the N20's mount is drawn (two 2.0 cheeks from the
    face plate to the shaft's tip bearing, which reaches the room beyond the gear); the void band under
    the spool stops at the face plate; the drum's wall 4.0. Smoke: audit OK, room_full 0.161.
    Claude-Session: https://claude.ai/code/session_01EtHMZPdHQgqTx6pjb4DNM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
    [part.py]
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2026-11-10 Scout v4 probe turret run 7: cable drum r 11 -> 9, out of the head-first path
    Run 6 (23 cm3): solid check PASS, 42.2 g, worst 0.338 (in-layer 0.305) head-first at
    (11.4, -17.4, 44.4), inside the drum's drawn ring again with its wall at 4.0: the drum stands in the
    path from the throat to the -y floor bolts (the frame's interface, fixed). With the 0.6 ribbon the
    3.5 turns of room need r ~8.2: the drum is r 9, its wall 2.5 again, the room round it generated.
    The roller's axle slot starts at r 17 (from 10: it reached the smaller drum's end plate). Head-first
    load from the frame model now 270 N. Smoke: audit OK, room_full 0.139.
    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
    [part.stl]
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2026-11-10 Scout v4 probe turret run 8: the roller's guides +-6.5 (walls 4.25 beside the slot)
    Run 7 (23 cm3): 40.9 g, worst 0.326 head-first at (18.6, 11.4, 27.6), in the +y roller guide's
    2.25 walls beside its axle slot and spring pocket; solid check FAIL on a blob on a 3 mm neck at
    (22, 2.7, 34) by the roller. The roller can't leave the throat's path: past 40 deg before the exit
    the deck is in the way, and at 150 deg or more the locked arc blossoms to the housing (elastica:
    1.5 lift). So the guides take the load: +-6.5. Smoke: audit OK, room_full 0.139.
    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
    [part.py]
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2026-11-11 engine: a part's identity is every repo file its setup reads; parts input takes commas, fails on unknown names
    1. tools/part_sha.py records, with an audit hook, every repo file a setup opens or imports while it is
    built (systems/ data, tools/ modules, parts/ libs, inputs/; repo modules re-imported fresh so a
    cached import is still seen) into setup.json "reads"; data_sha and the cache key are over those.
    10 Nov: the Scout v4 head-first load (systems/scout_v4.head_load.json) and tools/scout_v4_shape.py
    were outside the key. New --files <part> (identity files) and --affected <changed files>.
    parts.yml: a push to parts/*.py, systems/** or tools/** runs the parts whose identity fil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
    [part_sha.py]
2026-11-11 Bottom nodes: Spark's 11 Nov notes (they snap everywhere, full redesign, rods cut at the old nodes)
    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
2026-11-11 Scout v4 frame: clear the turret's new below-deck geometry; FC forward, Radxa back
    The PROBE stream's turret on main (722f7dc) hangs its N20 block (x +-8.5, z >= 14.7) and two
    roller-guide stubs (x 15.6..29.7, |y| 9..18, z >= 18.4) below its floor pads into the deck.
    The frame now cuts the turret's drawn + room below z 24.5, grown 0.4 (never above the deck top,
    so the bosses keep their height). The FC sat on the stubs: forward to x 30.5..66.5 (EKF2_IMU_POS_X
    +0.049). The Radxa (65) between the N20 block and DT's 13.5-deep collar: back 1.3 to x -73.9..-8.9,
    posts r 3.75 (2.0 round the M2.5 insert), its cut 0.2 at its ends, and a deep socket's floor behind
    its bore is generated (the collar sta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
    [part.stl]
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2026-11-11 Scout v4 frame: motor loads where they enter, pad 8 thick, FC back, budget 140
    Run a25e31d (ff70b88) stopped early at 0.952 (DN-NB 714 N at (75, 11, 17.7)); its motor cases read
    0.29-0.53 in-layer and 0.33-0.39 across the layers (Spark 10 Nov: scared the arms snap off).
    - Motor loads: the pull away from the pad (+z) at each M2 head's seat on the pad's underside (it
    bears up into the pad), lateral / torque / push at the motor base on its top round each screw;
    the column through the pad's thickness pulled its layers apart, an across-layer artefact.
    - Drawn pad 6 -> 8 (z 16.5..24.5): M2 x 10 screws (8 + 2 into the motor's base).
    - FC back to x 18.5..54.5 (the turret's stubs never print): at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
    [part.stl]
2026-11-11 Foot nodes v7: sockets one node length back on the cut rods, boot stud and shoulder, one 68D boot for all six
    Spark 11 Nov: the foot nodes broke again, full redesign. Root cause: the printed nodes (29-31 Oct, PETG, 12-17 g) were sized
    before any ground-hit case existed; a 0.6 m drop on one node is 1300 N, 19x the 67 N landing they were sized for.
    Nodes 2, 3, 4, 5 (parts/cage_foot_lib.py): each bore's floor 0.5 inside the printed node's collar mouth, 17.5 / 12.5 deep;
    a drawn boot stud (O30 disc, O28 neck, shoulder ring); foot cases held at every socket. A sideways hit through the boot
    is named as a missing case (needs a friction number and the drop test).
    Boot v4 (overseer_tpu_foot): one 68D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
    [node0.stl, node1.stl, node2.stl, node3.stl, node4.stl, node5.stl, overseer_tpu_foot.stl, part.stl]
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2026-11-11 scout_v4_frame: audit parity check; room boxes overlap, the UBEC off BT's path
    The run of 0dd1778 failed the solid check (a 1 mm U slot round the flow pod,
    1.4 mm walls, two blobs on necks) and read 0.76 at BT-TB. Cause: room boxes
    that only touched on a face (the flow land on the nose room's floor at z -10,
    the side rooms under the deck at z 9.6) stay two shells in the union; the
    ray-parity voxeliser counted the shared face once and emptied 52 columns up
    to the deck. topo/audit.py parity refuses any such column (test_topo case);
    the boxes now overlap 0.5. The UBEC lay across the tail tray at BT's height
    with its leads cutting the sides: it now hangs in a pod under the tray
    (room filled soli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
    [part.stl]
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2026-11-11 scout_v4_frame: the lugs' room along the receiver, budget 180
    Run of a093523: solid check PASS, 222.9 g; FAIL 0.821 across the layers at
    BS0-S0 (175 N out along y at z -8.8, the lug could only hang from the deck),
    motors 0.35-0.65. The lugs' wedge now runs the receiver's whole length so a
    plate at the socket's height carries the pull along x in its layers; budget
    140 -> 180 (the room thinned uniformly read ~0.56, the run 0.82). Smoke:
    audit OK, room filled solid 0.232, 5.5 GB.
    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
    [part.py]
2026-11-11 scout_v4_frame: the arms' room 48 at the root, budget 200
    Run of 071cc14: 274.1 g, solid check PASS, FAIL 0.481: every pod's flight
    case worst at its root by the deck's corner (0.29-0.48 in-layer), each arm
    one ~10 wide bar; sockets now <= 0.41. The arms' room widens 32 -> 48 at the
    root (30 at the pod) so the root can spread into a V in its layers; budget
    180 -> 200. Smoke: audit OK, room filled solid 0.209, 5.6 GB.
    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
    [part.py]
2026-11-11 Foot nodes v8: one PCTG body, no boot or stud, the belly 9.1 under the loop axis is the landing face
    Spark 11 Nov on v7: no TPU block under the node, low, good-looking, fits the funnel, does not crack.
    The stud, neck, shoulder and relief pocket are gone; the sole is a O30 x 3 flat in the belly at z -89.0
    (printed nodes -93.05), the room's floor is the ground plane. Sockets and rod cuts as v7. The 68D boots
    leave the assembly. Budgets 30/34/38/40 -> 24/28/32/40 (v7 read 0.11..0.15 on 2-4 carrying the stud).
    Claude-Session: https://claude.ai/code/session_01EtHMZLj26sKtPkZkp8v3z4
    [cage_foot_lib.py, part.py]
2026-11-12 scout_v4_frame: loads in the layers by geometry, budget 90 (<= 160 g)
    Run of 4b95423: 300.7 g, FAIL 0.458 across at BS1-S1, motor 3 0.386 across
    under its pad, motor 4 0.343, BT-TB 0.363. The design chat: stop raising the
    budget, <= 160 g, every fail by geometry. The arms' room is a 12 deep band in
    the deck's layers (thrust bends a plate in its layers, no web under the pad);
    a belt round the receiver at the B sockets' height (side rooms, tail tray and
    nose to z -12, |y| 40) so BS's pull bends a bar along x in its layers; the
    motor pad drawn as its seat skin and 4 screw bosses (was a solid O28 x 8);
    budget 200 -> 90. Smoke: audit OK, room filled solid 0.152, 5.6 GB.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
    [part.py]
2026-11-12 results: [motor_mount]
    [part.stl]
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2026-11-12 scout_v4: BS sockets to the nose block's corners; frame arms haunched, budget 100
    Run of 1a9f9b7 (gen 90): 149.2 g, FAIL 0.746 (motor 2's root), the engine's
    own beta-4 check 0.81, BS0-S0 0.72 across: the lugs mid-way along the
    receiver cost a belt the budget could not fill. BS0 / BS1 move to x 60 (the
    nose block's corners, BS_X): the D / B pair keeps its 28.7 depth, BS rods
    117 -> 131 (frame model: Euler <= 0.94, end moment <= 839, worst crash
    deflection 1.4 -> 5.6 mm in y; BS 208 N, DS 274 N). The frame loses the
    lug wedges and the belt along the receiver; each side socket gets its own
    room. Arms haunched (z 6 at the root to 12.5 at the pod, ~8 deg off the
    layers). One USB-C plug cut (the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
    [part.stl]
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2026-11-12 Head mount: Spark 12 Nov, v11 does not fit the rods on the page, the bar cut buys nothing, still too far forward
    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
2026-11-12 latch v7: bolts are plain bars that go in from outside (the tab-plate bolt could not be installed), drop-in stop bar, springs in the bolts, build and install check
    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
    [blade_n.stl, blade_p.stl, cartridge.stl, heel_deck.stl, part.stl, rib.stl, slider_n.stl, slider_p.stl]
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2026-11-12 Head mount v12: L2 in the cage's front vertex (326, 0, 22), 18 back at less field blocked; deep U sockets; crossbar whole
    Spark 12 Nov on v11: the mount does not fit the rods on the page, does not need the bar cut, still too far forward.
    Study: back costs L2 field fast at any height above node 17; lower is what buys distance (the lower front rods end-on
    to the window). L2 base (344, 0, 91) -> (326, 0, 22), field blocked 1.8 % -> 1.0 %. Node 17's 4 tubes and the core tie
    are cut further back round the L2 body (6 1/2 in out of node 15 / 16's collar, 5 7/16 in out of node 18 / 19's, tie
    9 in long); the crossbar stays whole. Cameras over the L2 at (337, +-30, 102), view clean. The 4 tubes sit in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
    [part.stl]
2026-11-12 latch v7: no steel parts (printed bolt noses with a flat ramp face, printed guide pegs on the plug carrier), two springs per bolt
    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
    [carrier.stl, carrier_cap.stl, cartridge.stl, guide_pole_n.stl, guide_pole_p.stl, part.stl, slider_n.stl, slider_p.stl]
2026-11-12 Scout v4 probe: no measurements, estimates + a labelled coupon (Spark 12 Nov)
    Spark: "only have me do what is absolutely necessary; also if we are testing
    with a coupon we can find what works that way as well".
    - tools/scout_v4_shape.py: COUPON (three choices a test) and COUPON_PICK, the
    one place the spool, pinion, roller, bench turret, flight turret, head frame
    and cradle read D/B/A/G/M/T/C from; estimates tagged E with sources: blade t
    0.13 (patents 0.11..0.15), the ribbon 0.81 x 4.9 (30 AWG PTFE type E, OD
    0.032 in; was 0.6 x 3.3), N20 stall 2.2 kg cm (vendors 1.5..2.2), SG90 holes
    27.7 (oval pilots +-0.4), camera case 20 (coupon C)
    - margins over t 0.10..0.15, R 12.7..25.4, m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
    [part.stl, scout_v4_probe_bench_base.stl, scout_v4_probe_bench_turret.stl, scout_v4_probe_coupon.stl, scout_v4_probe_pinion.stl, scout_v4_probe_roller.stl, scout_v4_probe_spool.stl]
2026-11-13 scout_v4 frame: three variants at once (va flat 12 arms, vb flat 16, vc budget 130); NB 5.7 -> 6.9
    The run of 57802c8 on the built-hold engine: 159.9 g, FAIL 0.834 across at
    motor 1's root (z 9.7, where the haunch's bottom chord meets the body);
    with the hold on 0.519 at 158.8 g, released by the solid check. Per the
    design chat, three temporary variants of the frame run together, one
    change each; the best is folded into scout_v4_frame and the folders go.
    Smokes: audit OK; room filled solid va 0.185, vb 0.126, vc 0.125.
    NB: 0.314 at 5.7 -> 6.9 (index ~ V^-1.25 toward 0.25); smoke OK, 0.123.
    Claude-Session: https://claude.ai/code/session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
    [part.py, scout_v4_node_lib.py]
2026-11-13 latch v7: latches when the cartridge lands slanted (bolts spring out 1.5 mm before the seat, seat strips only at the latch line, roomier bolt pockets); slant check in the build
    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
    [part.stl, receiver.stl, receiver_strips.stl]
2026-11-13 Engine: no sealed void (Spark 13 Nov, foot nodes v8: cavities full of slicer supports)
    Virtual-temperature constraint in the optimisation (topo/cavity.py, Settings.no_cavity, one MMA row on the
    design as built), the export fills any sealed cavity left (build.fill_cavities in assemble and export_mesh),
    the gate fails sealed voids and inner shells (tools/solid_check.py). test_topo t_no_cavity.
    Claude-Session: https://claude.ai/code/session_01EtHMZN3HEQzuWjA55EZJKc
    [solid_check.py]
2026-11-13 feedback: Spark 13 Nov, full run over the swap design, build the arm, ready to print (latch, arm, funnel streams)
    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
2026-11-13 Latch v7: receivers as engine parts (both packs), Scout feet clear of the mount bolts, Overseer roll 0.74, XT60W plug collar [skip ci]
    - parts/latch7_recv_lib.py + latch7_receiver / latch7_ov_receiver part.py: only pads, bosses, pockets and seats drawn, walls, deck and ends
    generated in the drawn receiver's room (audit smoke passes at the SPEC h on both; no run from this branch)
    - make.py: the Scout's landing feet filled the mount bolts' head bores (131 mm3 each): legs go round the bores, build check step 7 sweeps every bolt
    - make.py: Overseer side walls set back 0.1 above the lead-in: the cartridge rolled the arm's worst 0.74 deg enters and latches
    - make.py: XT60W-M (Amass sheet, E) in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
    [carrier.stl, carrier_cap.stl, cartridge.stl, guide_pole_n.stl, guide_pole_p.stl, part.stl, receiver.stl, receiver_room.stl]
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2026-11-13 results: [scout_v4_frame_vc]
    [part.stl]
2026-11-13 results: [scout_v4_frame_vb]
    [part.stl]
2026-11-13 Swap arm v8: drawn for latch v7 and both packs, swap cycle checked, setups written (audit not passing yet)
    Two heads 180 apart, each a lift on three steel rods driven by a T8 x 2 screw, picking its carriage up for the
    last 60 mm (the seat is 65 higher than v7 reached). Ring at R 127 (v7's 113 overlaps latch v7's receivers).
    Grab unit to parts/latch7/make.py: sprung pilots, spring float, jack-screw pads, a hall per bolt.
    parts/box_arm8/make.py checks 502 states of the swap cycle against the latch sets, funnel, bays and drones: 0 overlaps.
    Hub, carriage and lift part.py are written; their setup audits fail (result.json audit_smoke).
    Cla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
    [box_arm8_a_blade_n.stl, box_arm8_a_blade_p.stl, box_arm8_a_blade_rods.stl, box_arm8_a_blade_springs.stl, box_arm8_a_boom.stl, box_arm8_a_boom_rods.stl, box_arm8_a_carriage.stl, box_arm8_a_coupler.stl]
2026-11-13 Funnel v5: frame in two engine halves on four cross arms under the lid, lead-screw wall drive, box check between the streams
    The one-piece 245 x 418 frame fits no bed and its 12 x 12 / 12 x 8 beams fail the 6 g landing. Now two frame halves and one cross arm
    as engine setups (parts/box_funnel_lib.py), drawn walls and strips that pass the solid gate, four N20 M4 screw gearmotors for the end
    walls. tools/box_check.py: every pair of pieces from different streams, seated, landing, swap path, the wheel turning; box.yml runs it.
    Audit: drawn_walls tiles a large drawn body at the gate's pitch instead of coarsening it to 0.4 (false thin wall on a sloped 3.0 wall),
    with a test case. The box page (sys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
    [part.stl]
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2026-11-13 Latch v7: the arm's 118 N head push on the seats and a jammed bolt's lead-in, bay receiver geometry without feet [skip ci]
    - make.py: ARM stall_N 74 -> 118 (arm v8 float springs, parts/box_arm8_lib.py F_LIMIT); seat strips 0.47 MPa, 0.12 mm squash; B[recv_bay] = the receiver without landing feet
    - latch7_recv_lib.py: insert case at 118 N on the seats; the jammed-bolt case on the lead-in's outer half where the bolt tip bears; Scout budget 28 -> 34 cm3
    - fit, slant, build check, motion clean on both packs; audit smoke passes on both receivers
    Claude-Session: https://claude.ai/code/session_01EtHMZLaMTyTKY2MRVDjqa6
    [latch7_recv_lib.py, part.py]
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2026-11-13 results: [scout_v4_frame_va]
    [part.stl]
2026-11-13 Box page: funnel v5, latch v7 at the seat, both drones as they stand, arm v8; the check passes against arm v8 (quick run)
    Tail beam 5 behind the v8 rails, the dome ring and rail tips cleared, the stand's keel and toe cut back from the -90 deg bay
    (geometry only, strength not rechecked). The check now reads systems/swap_arm.assembly.json and tests the stand against the arm.
    Page: per-part max_faces and a system fps so 251 parts fit the 16 MB artifact.
    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
    [part.stl]
2026-11-13 Head mount v12: budget 80 -> 110 and room 4 -> 12 round the tube collars (80 FAILED 0.411 across the layers)
    The run of a3cf667: 118.1 g, solid check PASS, strength FAIL 0.411 (limit 0.3), tube 17-18 compression 229 N, across
    the layers under the 15-17 collar at (352, 41, 51); only the 17-18 / 17-19 cases are over (in-layer all <= 0.27).
    Cause: the lower socket's push goes up a short strut to the upper socket on its side, across the layers, through a
    4 mm band of room between the L2 body and the envelope, on a budget cut from v11's 100 to 80 without a run behind it.
    Room round the 4 tube collars 4 -> 12 (inside the same 48 x 72 x 80 grid), budget 110. Smoke: audit OK, room_full 0.039.
    Co-Au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
    [part.py]
2026-11-13 scout_v4 frame: round 1's vb folded in (flat 16 arms); round 2 variants; cage loads from setups
    Round 1 (ed89fbd): va (flat 12 arms) 159.3 g FAIL 0.807 + solid; vb (flat 16)
    159.0 g solid PASS, worst 0.59 (BS0 compression across), motors <= 0.44, the
    hold kept; vc (haunch, gen 130) 196.3 g 0.462. vb is folded into the frame
    (its setup hash 9957a139 = the frame's now). NB passes at 6.9 (0.238).
    Round 2, one change each from the frame: va the rooms beside the receiver
    out to |y| 46 (BT's tail corner), vb their front half down to z -12 (BS's
    push in its layers), vc both. Smokes: audit OK, room filled solid frame
    0.127, va 0.116, vb 0.127, vc 0.115, 5.1-5.3 GB.
    The frame model takes each generat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
    [part.stl]
2026-11-13 Box page: full check PASS against arm v8 (0 overlaps), funnel halves' budget 140 cm3, the arm lane 1 mm clear
    Audit smokes at the SPEC h on this geometry: arm 0.265, tail half 0.405, nose half 0.462 filled solid (limit 0.5).
    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
    [part.stl]
2026-11-13 Swap arm v8, second pass: 11 bays at R 129, screw under the rods with a two-way thrust wall, v7's cases, drawn prints all pass
    Against the latch at 1c5f9a1: 551 states, 0 overlaps. Bay receivers without feet, saddles on the receivers' own mount
    bolts (result.json bay_mount). Lift on three rods (LM6UU 0.47 swap / 0.89 misuse). Hub setup passes the audit; carriage
    and lift each fail room_full (1.97, 0.74). Funnel v5's tail cross arm is in the head's lane at the drone (compat.funnel_note).
    Claude-Session: https://claude.ai/code/session_01EtHMZP52CJUSAJ2PuwHVrE
    [box_arm8_a_carriage.stl, box_arm8_a_coupler.stl, box_arm8_a_lift.stl, box_arm8_a_motor.stl, box_arm8_a_nut.stl, box_arm8_a_pilots.stl, box_arm8_a_rail.stl, box_arm8_a_rods.stl]
2026-11-13 Latch v7: hold-down notches for the funnel's pins on both drone receivers, Scout leg room wider [skip ci]
    - make.py hold_down(): four notches in the outer side faces at |x| 34.0, 6..10 above the underside, 2.5 deep, in drawn blocks (Scout: on the foot pads;
    Overseer: wall-thick at the side walls' ends, clear of the mount bolts); where they are: result.json hold_down (cartridge and seat frames, pin limits)
    - latch7_recv_lib.py: the head's 118 N on the seats against the four pins as its own case; the blocks drawn with the feet
    - Scout: leg room round the corner bolts r 8 up to the drawn boss (room-full 0.52 -> 0.44 in the hold-down case); gate_member off as on the Overseer
    - funnel fit and i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
    [receiver.stl, receiver_room.stl]
2026-11-13 results: [scout_v4_frame_va,scout_v4_frame_vb,scout_v4_frame_vc]
    [part.stl]
2026-11-13 Latch v7: hold-down moved to the end faces' corners for tongues on the funnel's sliding end walls [skip ci]
    - the funnel has nothing free behind its side walls (gearmotors, tab slots): the side notches of 800061d go
    - make.py hold_down(): a notch 2.5 deep in the end face at each corner, 6..10 above the underside; Scout in the foot blocks' end faces,
    Overseer where the side walls run out, outboard of the mount bolts; result.json hold_down: boxes in both frames, the tongue's lane and limits
    - funnel fit and its 65 landing states unchanged; slant, build check, motion clean; audit smoke passes on both receivers (room-full 0.47 / 0.27)
    C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
    [receiver.stl, receiver_room.stl]
2026-11-13 Swap arm v8: clear of funnel v5 and the current box (551 states, 0 overlaps), saddle plates trimmed, audit state recorded
    Carriage: lower rod clamps get a short way to the wheels (column and tail plate beside the rail). Lift: tapered cross-over,
    nut in a lug under the block. Hub setup passes its audit; carriage (2.15) and lift (0.745) still fail room_full.
    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
    [box_arm8_a_carriage.stl, box_arm8_b_carriage.stl, box_arm8_bay_0_saddle.stl, box_arm8_bay_120_saddle.stl, box_arm8_bay_30_saddle.stl, box_arm8_bay_60_saddle.stl, box_arm8_bay_m120_saddle.stl, box_arm8_bay_m150_saddle.stl]
2026-11-13 Latch v7 hold-down: 3 x 3 steel square key tongues (agreed with the funnel stream), landing on two tongues as its own case [skip ci]
    - result.json hold_down: tongue section, lane |y| 30.9..33.9, entry 2.0; bearing 4.6 / 4.0 MPa (index 0.47 / 0.41); a round pin refused (Hertz 102 MPa on PCTG)
    - latch7_recv_lib.py: 6 g landing with one end on its wall's two tongues, nose pair and tail pair
    - standing checks clean on both packs; audit smoke passes on both receivers
    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
    [latch7_recv_lib.py]
2026-11-13 Swap arm v8: bay_mount with the saddle's contact outline and the bay load cases; bay receivers from the latch's recv_bay; 551 states clean against the latch at HEAD
    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
    [box_arm8_bay_0_recv.stl, box_arm8_bay_120_recv.stl, box_arm8_bay_30_recv.stl, box_arm8_bay_60_recv.stl, box_arm8_bay_m120_recv.stl, box_arm8_bay_m150_recv.stl, box_arm8_bay_m180_recv.stl, box_arm8_bay_m210_recv.stl]
2026-11-13 Funnel: hold-down drawn on the end walls (two steel pins a wall into the receivers' end notches), walls seated / parked / open
    With the latch worker: O2.5 dowel pins at |y| 32.25, z -36.5; land with the walls parked 2.5 out, back off to 11 out, drive in.
    118 N head push in the halves' and the arm's loads. Check: seated with the pins in, parked, open; landing with the walls parked;
    leaving with them open. It fails only where the pins meet receivers that have no notch yet (the latch worker's next push).
    Switches raised over the arm v8 bay saddles, tail beam clear of the v8 head motors, screws M4 x 62.
    Claude-Session: https://claude.ai/c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
    [part.stl]
2026-11-13 Latch v7 receivers: the arm's bay cases (pack weight in every direction, the bay's pull-out with the bolts in) [skip ci]
    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
    [latch7_recv_lib.py]
2026-11-13 Funnel: turned pose (seat half a turn in the box: W x = seat y, W y = 167.1 - seat x), hold-down tongues as 3 x 3 steel keys
    The funnel's box-side features change ends: the nose beam is now on the hub side (seat x 138..162), the tail beam at -128..-104,
    the arm lane at the nose. tools/seat_check.py holds the one SEAT_TO_W. Quick box check on the turned pose: 0 overlaps.
    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
    [part.stl]
2026-11-13 Latch v7: funnel fit against the keyed end walls (parked for the landing states, ends on the keys counted) [skip ci]
    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
2026-11-13 Swap arm v8: lift setup passes its audit printed on its side (0.488), float bolts from above into whole ties; audit state and its cause recorded
    Hub and lift pass room_full only nearly solid (their runs are likely to fail strength); the carriage still fails it (2.15).
    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
    [box_arm8_a_float_bolts.stl, box_arm8_a_lift.stl, box_arm8_a_unit_body.stl, box_arm8_b_float_bolts.stl, box_arm8_b_lift.stl, box_arm8_b_unit_body.stl, part.stl]
2026-11-13 Funnel: switches flat under a lug, tripped by a tab on the nut block (the rib behind each side wall gets its room back)
    On the turned pose both halves read 0.69 / 0.83 filled solid with the raised switches and their finger in the rib's room; the tail
    half now reads 0.434 (the 118 N hold-down governs). Box page files from the full check on the turned pose (0 overlaps).
    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
    [part.stl]
2026-11-13 Funnel: one home switch a wall tripped by a bar on the nut block (clear of the Overseer's foot nodes), a wider link from the nose half to its beam
    The flat switches at the blocks' out positions crossed the Overseer's foot nodes while landing (full check: 4 pairs), and the
    nose half read 0.61 filled solid on the turned pose. Audits and the full check on this geometry are running.
    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
    [part.stl]
2026-11-13 Box page: turned pose, hold-down keys, full check PASS (0 overlaps); nose half still over the audit limit (0.59)
    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
    [part.stl]
2026-11-13 Swap arm v8: turned pose; lift on a bought MGN12H rail on the carriage's spine, three carbon rods under the grab unit; all three setups pass their audits by the estimate
    Pull-out acts at the tab line in either pose, so the turn alone did not shorten the lever. The cause was the
    load's path: 70 across to three rods, back through a 5 mm plate to the wheels, out along printed booms.
    Now yoke -> MGN block -> rail -> spine beside the wheel pair; V wheels o 26 on a 64 span (flank 0.32 in a swap).
    Audit at the SPEC h: hub 0.295 solid / 0.47 at budget, carriage 0.396 / 0.47, lift 0.352 / 0.46.
    Swap cycle 551 states against the funnel and latch at the branch head: 0 overlaps. 14 drawn prints pass the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
    [box_arm8_a_blade_n.stl, box_arm8_a_blade_p.stl, box_arm8_a_boom.stl, box_arm8_a_boom_rods.stl, box_arm8_a_booms.stl, box_arm8_a_carriage.stl, box_arm8_a_coupler.stl, box_arm8_a_float_bolts.stl]
2026-11-13 Swap arm v8: swap cycle rerun against the funnel at 7361018 (551 states, 0 overlaps)
    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
    [box_arm8_funnel.stl]
2026-11-13 Swap arm v8: funnel_keepout one-sided as the head is (X -36..69), funnel_sweep for the turning arm
    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
2026-11-13 Box page files from the full check against the turned arm (PASS, 0 overlaps); the blocks' lane flush to the motor plate
    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
    [part.stl]
2026-11-13 Funnel halves: fins of room at the nut blocks' lane closed, a second joint M4 outside a wider rib; audit names a peak in a fin
    The nose half's room_full 0.60 sat in a one-cell fin (the lane's cut stopped 0.9 short of the room's edge) ending on the
    motor's front plate; the tail half hid the same cell among those left out beside a loaded node. With the fins closed the
    honest peak was the rib at the joint (0.53 nose, 0.42 tail): the joint now has an M4 outside the rib at |y| 83, the rib is
    77 wide with a root to z -41. Nose half audit at h 2.2: OK, room filled solid 0.469.
    topo/audit.py room_strength: when the peak sits in room one cell thin the refusal says so and gives the fin's box (test add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
    [part.stl]
2026-11-13 Box page files after the funnel halves' fix: full check PASS, 0 overlaps; audits nose 0.469, tail 0.410, arm 0.241; notes for the next worker
    Claude-Session: https://claude.ai/code/session_01EtHMZQEmMbreZjxCMTMFTs
    [part.stl]
2026-11-13 scout_v4 frame: round 2 variants removed (none beat the frame)
    Round 2 (c4dfb15): frame 158.8 g 0.525 (BT-TB by the tail bolt), va (side
    rooms |y| 46) 161.9 g 0.651, vb (front side rooms to -12) 158.9 g 0.539,
    vc (both) 160.4 g 0.770. The frame keeps its setup.
    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
    [part.stl]
2026-11-13 scout_v4 frame: round 3, the budget at 115 / 130 / 155
    Round 2: the frame (flat 16 arms, gen 100) 158.8 g, worst 0.525 BT-TB by the
    tail bolt; BT-TB floors every variant at ~0.5 (0.46 at 196 g). The design
    chat lifted the 160 g cap (Spark: compact and not snapping): the lightest
    variant passing every case < 0.3 wins. The Radxa out of the tail tray has
    nowhere to go (the deck top under the discs' keep-out, every 65 mm run under
    the deck taken), so the three are budgets: 115, 130, 155.
    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
    [part.py]
2026-11-13 scout_v4 frame: round 4 (the battery bolts on face + insert at 130 / 155; gen 180)
    Round 3: gen 115 / 130 / 155 -> 177.8 / 196.3 / 227.4 g, worst 0.459 / 0.386 /
    0.338, always BT-TB 3.6 behind the tail bolt's boss, just over the support
    region (the boss's clamped bottom 1.5 only). REC_SUPPORT (the frame keeps
    'face'): 'insert' adds the M3 insert's 6 mm bore lining, where the bolt's
    shear goes in. va insert at 130, vb insert at 155, vc face at 180 (index ~
    V^-1.0: ~0.29). Smoke of va: audit OK, support 68 -> 116 cells, room
    filled solid 0.126.
    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
    [part.stl]
2026-11-13 scout_v4 frame: round 5 (face + insert support at gen 170 / 185 / 200)
    Round 4: insert support at 130 / 155 -> 196.4 / 228.4 g, 0.376 / 0.321;
    face at 180 -> 258.9 g, 0.306; the frame (100) 158.9 g 0.555. Always
    BT-TB by the tail bolt; index ~ V^-0.9 with the insert: 0.29 at ~174.
    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
    [part.stl]
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2026-11-13 scout_v4 frame: insert support and the Radxa's cut into the turret's; round 5 removed
    Round 5 (insert support): gen 170 / 185 / 200 -> 246.7 / 265.5 / 284.2 g,
    worst 0.306 / 0.308 / 0.281 (BT-TB), solid FAIL at 185 / 200 (a 1.5-1.7
    wall in the 1.9 gap between the Radxa's cut and the turret's: the Radxa's
    cut now runs 2.4 on into the turret's). Those runs read the cage loads of a
    156 g frame: with the frame model on its own mass (setup_mass) DN-NB
    reaches 1.0 x Euler at ~145 cm3 (1.06 at 200) and BT-TB +12 %, so no
    budget passes. The frame stays at gen 100 with the insert support.
    Claude-Session: https://claude.ai/code/session_01EtHMZMt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
    [part.stl]
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2026-11-13 results: [scout_v4_node_nb_vs]
    [part.stl]
2026-11-13 results: [scout_v4_node_tb_vt]
    [part.stl]
2026-11-13 results: [scout_v4_node_tb_vs]
    [part.stl]
2026-11-13 results: [scout_v4_node_nb_vt]
    [part.stl]
2026-11-13 results: [scout_v4_frame_vd]
    [part.stl]
2026-11-13 Swap arm v8: print kit for the 14 drawn pieces (held until the three runs pass), assembly order; listings for the float spring, M4 inserts, M3 x 12
    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
    [box_arm8_funnel.stl]
2026-11-13 Latch v7 print kit: 12 drawn pieces in their print poses (print/latch7_*.stl), solid-checked as exported, a bed picture each, kit.json with counts and the assembly order
    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
    [latch7_bolt.stl, latch7_cartridge.stl, latch7_ov_bolt.stl, latch7_ov_cartridge.stl, latch7_ov_plug_carrier.stl, latch7_ov_plug_carrier_cap.stl, latch7_plug_carrier.stl, latch7_plug_carrier_cap.stl]
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2026-11-13 results: [box_arm8_lift]
    [part.stl]
2026-11-13 results: [box_arm8_carriage]
    [part.stl]
2026-11-13 results: [scout_v4_node_tb_vu]
    [part.stl]
2026-11-13 results: [scout_v4_node_s1_vu]
    [part.stl]
2026-11-13 results: [box_arm8_hub]
    [part.stl]
2026-11-13 scout_v4: the bolt forks line (architecture review) at gen 100 / 130 / 160; frame model on the core's real CG
    The architecture review (13 Nov), chosen by the design chat: NB / TB / S0 /
    S1 down to z 2.7, each on a horizontal fork of two 3.0 rods to sockets at
    z 11 beside the receiver's 4 bolts (BN0/1, BT0/1, SA0/1 at the front bolts'
    x, SB0/1 at the rear's); the 8 D / B rods and the DN / DT / BN / BT / DS /
    BS sockets go. The model fix in the same change: tools/scout_v4_shape.
    core_of (the core without the node parts, which the frame model adds per
    node, at its real CG, (-0.3, 0, 15.2), not the origin), used by the shape
    tool's frame model and every variant. Frame model on the frame's own ma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
    [part.py, scout_v4_shape.py]
2026-11-13 results: [scout_v4_node_s0_vu]
    [part.stl]
2026-11-13 results: [box_funnel_half_nose]
    [part.stl]
2026-11-13 results: [box_funnel_half_tail]
    [part.stl]
2026-11-13 scout_v4: round 6 variants removed (tube 170 / 200, split 100 / 130 and their nodes)
    Round 6 (85eb750): tube vb (200) 285.5 g 0.345 at BT-TB 687 N; split vd
    (130) 198.4 g 0.505 at DT-TB 1287 N; NB_vt 0.434, TB_vt 0.46, NB_vs 0.397,
    TB_vs 0.23. Superseded by the bolt forks (vg / vh / vi) and kept as the
    fallback by tube2 (ve / vf).
    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
    [part.stl]
2026-11-13 results: [scout_v4_node_nb_vu]
    [part.stl]
2026-11-13 results: [scout_v4_node_nb_vf]
    [part.stl]
2026-11-13 results: [scout_v4_node_s0_vf]
    [part.stl]
2026-11-13 results: [scout_v4_node_s1_vf]
    [part.stl]
2026-11-13 results: [box_funnel_arm]
    [part.stl]
2026-11-13 results: [scout_v4_node_tb_vf]
    [part.stl]
2026-11-13 Swap arm v8: carriage and lift after their first runs (0.528, 0.532): section at the two junctions that failed, budgets to 94 and 91 % of the rooms
    Carriage: the 9.85 plate bent between the low wheel's axle and the spine: 12.25 thick there now. Lift: the yoke's plate runs on down past the MGN block.
    Audits PASS at the SPEC h, estimates 0.38 / 0.38 (the first setups passed at 0.47 / 0.46 and ran 12 to 15 % over). Swap cycle 551 states, 0 overlaps. Hub ran PASS (0.353).
    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
    [box_arm8_a_booms.stl, box_arm8_a_carriage.stl, box_arm8_a_lift.stl, box_arm8_b_booms.stl, box_arm8_b_carriage.stl, box_arm8_b_lift.stl]
2026-11-13 results: [latch7_ov_receiver]
    [part.stl]
2026-11-13 results: [latch7_receiver]
    [part.stl]
2026-11-13 scout_v4 frame: under-arm braces (bolt forks + braces at gen 70 / 100)
    Spark (13 Nov): 'if adding a rod to the bottom of the motors can prevent
    snapping we should do that instead of adding more material'. frame.BRACES
    (off by default): per arm a 3.0 carbon rod from a socket under the arm 20
    inboard of the motor (clear of its 4 M2 drivers and O8 centre; port down,
    not along the arm's chord) down and in to a socket at (+-42, +-42, -8)
    beside the receiver; the rod a Part.insert (carbon / PCTG 44 x, its real
    E A), 2 short of each socket floor so the voxel rod's overstated bending
    stiffness carries no moment; its own room round the rod and into the side
    room. units_lib.BraceSock (7 deep: ~40-80 N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
    [part.py, scout_v4_units_lib.py]
2026-11-13 Latch v7 receivers after run 265 (carried from the work branch, latch worker's ff98f43): lead-end support on the carrier's ear seats (Overseer 0.526), a web's room for the Scout's foot legs (solid FA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
    The page file systems/latch7_both.assembly.json follows later: seven Scout v4 frame variants with no result yet read it.
    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
    [receiver.stl, receiver_room.stl]
2026-11-13 box: check PASS [skip ci]
    [part.stl]
2026-11-13 Funnel halves: rib 88 wide over the motor, the joint's outer M4 in the rib; clear of the Overseer's v8 foot nodes
    The nose half's first run read 0.545 in the rib's lower outer fibre over the motor (limit 0.5). The rib is now the beam's
    width from the joint to x 50 (77 beyond, its top outer edge chamfered, the nose rib ending at x 84: the Overseer's v8 foot
    nodes pass there landing off centre) and the joint's outer bolt sits in it at |y| 68, pocket open to the top.
    Audits at SPEC h: nose 0.434, tail 0.413, arm 0.241. Box check PASS, 0 overlaps; latch fit ok both packs.
    Claude-Session: https://claude.ai/code/session_01EtHMZQEmMbreZjxCMT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
    [part.stl]
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2026-11-13 Swap arm v8 lift: the yoke's back tapers into its plate (both runs peaked at that inside corner: 0.532, 0.510), printed upright
    Audit PASS at h 1.8: 0.284 filled solid (was 0.349), estimate 0.31. Swap cycle 551 states, 0 overlaps. Carriage reran PASS (0.434).
    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
    [box_arm8_a_lift.stl, box_arm8_b_lift.stl, box_arm8_bay_120_recv.stl, box_arm8_bay_30_recv.stl, box_arm8_bay_60_recv.stl, box_arm8_bay_m150_recv.stl, box_arm8_bay_m210_recv.stl, box_arm8_bay_m30_recv.stl]
2026-11-14 results: [box_arm8_carriage,box_arm8_hub,box_arm8_lift,box_funnel_arm,box_funnel_half_nose,box_funnel_half_tail,latch7_ov_receiver,latch7_receiver,scout_v4_frame_va,scout_v4_frame_vb,scout_v4_frame_v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
    [part.stl]
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2026-11-14 results: [scout_v4_frame_vh]
    [part.stl]
2026-11-14 Overseer base as printed (Spark 14 Nov): the page and seat checks draw the glued 31 Oct base
    The base on the drone is v7 of 31 Oct (dc223fe, 88.5 g), not main's 10 Nov rerun (191.8 g). An assembly
    entry with "as_printed" draws its mesh (parts/overseer_base/as_printed/dc223fe.stl, 60k faces) on the page and
    in tools/seat_envelope.py; the design part is untouched. seat_check overseer --descent: 0 crossings, 0 of 65.
    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
    [dc223fe.stl]
2026-11-14 results: [scout_v4_frame_ve]
    [part.stl]
2026-11-14 results: [scout_v4_frame,scout_v4_frame_vb,scout_v4_frame_vc,scout_v4_frame_vd,scout_v4_frame_ve,scout_v4_frame_vf,scout_v4_node_nb_vu,scout_v4_node_s0_vu,scout_v4_node_s1_vu,scout_v4_node_tb_vu]
    [part.stl]
2026-11-14 Swap arm v8: all three runs PASS (hub 0.353, carriage 0.434, lift 0.407); the lift's passing result restored; print kit released
    An older workflow's results commit (835993a) put the lift's first failed result (0.532, gen 82) back over the passing run of the
    tapered setup (338ba56: 0.407, 138.7 g, solid check PASS). Restored result.json, part.stl, preview.png and setup.json from 338ba56.
    Boom rods are 115 long (socket floor at 84). Swap cycle 551 states, 0 overlaps.
    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
    [box_arm8_funnel.stl, part.stl]
2026-11-14 Latch v7: the Overseer receiver fits its printed base (four deck bosses into the base's inserts, top edges in to 33.3, plug 3.5 lower with the leads out the lead end); the Scout feet's gussets drawn;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
    Spark 14 Nov: "why does the base need to change, can we just change the design for the battery side, the base is already glued to the nodes".
    - make.py drone_mount(): four bosses on the deck under overseer_base's M3 inserts at drone (-60, +-25), (20, +-25): M3 x 10 from below with the cartridge out, heads flush in
    the deck's underside, 2.4 over the cartridge's rim, clear of the seat strips. The six mount-plane bosses stay as the arm's bay set (latch7_recv_lib: support "bay")
    - OV_TOP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
    [blade_n.stl, blade_p.stl, carrier.stl, carrier_cap.stl, cartridge.stl, guide_pole_n.stl, guide_pole_p.stl, heel_deck.stl]
2026-11-14 results: [scout_v4_frame_vi]
    [part.stl]
2026-11-14 Latch v7: the Overseer receiver's four deck bolts take 5.0 of thread in the printed base's inserts (M3 x 10, head seat 2.8, 5.0 of deck under the head); no setup change [skip ci]
    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
    [receiver.stl, receiver_room.stl]
2026-11-14 results: [scout_v4_frame_vg]
    [part.stl]
2026-11-14 Latch v7: scout_keepout in parts/latch7/result.json, the Scout set's outline in the Scout v4 drone frame (meshes in parts/latch7/view/keepout/); no setup change [skip ci]
    Design chat 14 Nov: the Scout keeps its bolt positions (lead-end mount bolts at drone x 49.58, tab line at +6.65); the frame, flow sensor and skid room clear the v7 set.
    Items: the receiver's whole room, carrier and cap, the cartridge with its bolts out swept 150 down, the plug with its tabs, 12 over the tabs for the leads (E), the seat strips,
    and the TPU skids as their own item.
    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
    [carrier_cap.stl, cartridge_path_down.stl, leads_E.stl, plug_tabs.stl, receiver_room.stl, seat_strips.stl, tpu_skids.stl]
2026-11-14 Latch v7: the Scout's TPU edge skids and cartridge side strips go; scout_keepout without them [skip ci]
    Scout v4 design chat 14 Nov: v4 stands on four TPU feet on the receiver's bottom corners, the skids have no job on it; the box does not need them either.
    - build(): no receiver skids, no cartridge side strips (the cartridge's two TPU end skids are its outline and stay); the feet's legs are no longer notched round the skids
    (latch7_receiver's setup changes: audit smoke OK, room filled solid 0.430, was 0.46)
    - fit: free play unchanged (0.52 / 0.52 along, 0.68 across), 65 landing states 0 mm3, swap path 0; the receiver's box is 34.0 a side (was 35.75) and 2.2 shorter at the nose
    - motion 0.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
    [receiver.stl, receiver_room.stl, tpu_skids.stl]
2026-11-14 Scout v4 probe: the coupon's picks (Spark 14 Nov) in the drawn parts and the flight setups
    Spark printed print-scout_v4_probe_coupon.stl (0589981) and read it; COUPON_PICK now takes an index or an explicit size.
    - D: D1, D2 would not go on, D3 too hard to press home: the pinion's D bore 3.3 / 2.8, one step past D3
    - B: dropped, no bearings: the roller is an O8 x 19 tube (was O10.1 for the MR63ZZ seats) turning on its M3 axle in a 3.3 bore;
    roller_drag(): ~19 N mm at the spool (mu 0.25 PCTG on steel E; 31 at 0.4), the worst stroke 311 vs the N20's 417..612 (1.34x);
    MR63ZZ (B075CLH2WM) off the assembly json and the page's buy list
    - A: A1 3.3 for the spool and the roller; M: M1, hub r 14 (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
    [part.stl, scout_v4_probe_bench_turret.stl, scout_v4_probe_pinion.stl, scout_v4_probe_roller.stl, scout_v4_probe_spool.stl]
2026-11-14 Latch v7: the Scout's plug 4.3 lower, leads out the lead end: nothing of the latch above the mount plane on the Scout either [skip ci]
    Scout v4 design chat 14 Nov: the XT60W's tabs (3.8 over the mount plane) and the leads' turn over them sat inside the FC, which has nowhere else under the deck.
    - PLUG_DROP scout 4.3: the pack's plug pocket, the carrier's pocket and the cap's ceiling 4.3 lower, pegs 4.3 longer; leads through the cap's rim and the top of the
    receiver's lead end wall (WIRE, as on the Overseer). Plug, tabs and float end 0.5 under the mount plane. The plug's place along the pack is unchanged.
    - The tab line stays at 42.87 (bl.TAB_OFF scout 0.12, asserted): the lighter lead end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
    [carrier.stl, carrier_cap.stl, cartridge.stl, cartridge_path_down.stl, guide_pole_n.stl, guide_pole_p.stl, latch7_cartridge.stl, latch7_plug_carrier.stl]
2026-11-14 Scout v4 cradle: a sleeve round the case, clamped by the camera's own side screws (design chat 14 Nov)
    The case has no holes on its back, only its bracket's threaded hole a side (Spark). The cradle is now a square sleeve round its four
    sides (36 + 0.45 a side, 2.2 wall, 12 long), open front and back, a 3.0 lip on the front rim's top and upper sides outside the lens,
    and a 3.4 slot along each side at mid-height for the camera's own side screws (up to M3), heads on the slot's edges. The lip fixes
    the lens for any depth 12..18; a deeper case stands out behind. LED bars through windows in the sleeve's top and bottom fronts.
    - no lip along the bottom and no room under the sleeve: the lip's corner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
    [part.py, scout_v4_shape.py]
2026-11-14 Funnel print kit: seven files in print pose, each on the plate and solid check PASS (parts/box_funnel/kit.json)
    Halves 1590 / 1470 mm2 flat on the bed, arms 407, end walls 252 standing on their foot, strips 991.
    The builder (tools/funnel_kit.py) and the page's kit table are held on claude/funnel-kit-hold:
    a tools/ push would restart the Scout frame runs that have no result yet.
    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
    [box_funnel_arm.stl, box_funnel_arm_mirrored.stl, box_funnel_half_nose.stl, box_funnel_half_tail.stl, box_funnel_strips.stl, box_funnel_wall_nose.stl, box_funnel_wall_tail.stl]
2026-11-14 Swap arm v8 print kit: 23 print files in their poses, measured; the grab unit made buildable; carriage and lift bed planes
    Print kit (parts/box_arm8/kit.py -> print/box_arm8_*.stl, parts/box_arm8/kit/*.png, kit.json): every drawn piece as the exact
    file in its print pose, solid check on that file, first layer, overhang and the part of it that needs supports measured on the
    file, bed fit and brim, print order, the one-head grab-unit test set with its bought parts, steps and install sweeps.
    Found while building it, fixed in the design:
    - Grab unit could not be assembled: the servo had no way in and nothing held it (slot through the wall to the open side, a tab
    for its inner ear), the paddle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
    [box_arm8_a_carriage.stl, box_arm8_a_paddle.stl, box_arm8_a_pads.stl, box_arm8_a_pilots.stl, box_arm8_a_servo.stl, box_arm8_a_unit_body.stl, box_arm8_b_carriage.stl, box_arm8_b_paddle.stl]
2026-11-14 results: [scout_v4_frame_vk]
    [part.stl]
2026-11-14 scout_v4 frame: vh's keep-out run (latch v7), one-end landing, boards on the grid; seat pose from latch7's tab line
    Round 7: vh (bolt forks, gen 130) 195.3 g, solid PASS, worst 0.217 (motor 4
    across); every case <= 0.22; fork nodes NB / TB / S0 / S1 pass (0.03-0.05);
    seat check --descent with the real node meshes and the fork rods: 0
    crossings in 65 states; camera view clear. vg (100) solid FAIL 0.39, vi
    (160) solid FAIL, vk (braced, 100) 163 g 0.387, tube2 ve / vf heavier:
    all removed (vj too).
    Its keep-out run (variant vl): frame.LATCH_V7 cuts latch v7's Scout set
    (parts/latch7 scout_keepout: the receiver room x -48.3..63.1, carrier and
    cap, the cartridge's path down, the lowered plug's ta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
    [part.stl]
2026-11-14 Swap arm v8: hub, carriage and lift rerun PASS (0.353 / 349.6 g, 0.373 / 91.8 g, 0.407 / 142.8 g); their print files; the page shows the run shapes
    print/box_arm8_{hub,carriage,lift}.stl in their build directions, solid check PASS on each file, first layers 973 / 2323 / 1288 mm2,
    supports only on the hub (6615 mm2 under the plate, from the bed). kit.json: 26 files, nothing waiting. The carriage's and lift's
    generated faces stop 0.25 to 0.5 short of the bed beside the drawn seats (low_gap_mm2, measured apart: no support fits there).
    The lift's run is stamped 115fe.. where main gives 2fbd.. for the same setup (the sign of least-squares noise in its load
    arrays, read by design_hash): accepted f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
    [box_arm8_carriage.stl, box_arm8_hub.stl, box_arm8_lift.stl]
2026-11-14 Latch v7 receivers after the 14 Nov runs (Scout 0.64, Overseer 0.565, both solid check PASS): the Scout's key seats 12 long, budgets 46 / 92 cm3
    Scout (run on 4d3d93cf, 73.5 g): 0.64 across the layers at the lead notches' roots in the hold-down (0.77 before the final pass, room filled solid 0.43).
    - the key's seat block was the foot pad's 6.0 long, 3.5 of it behind the 2.5 notch: 12 long now, as the Overseer's (HOLD sc_len), cut by the mount bolts' head and
    driver sweeps (build check step 7 caught the first try: 39 mm3 in the driver's way)
    - 36 cm3 was 52 % of the room: 46 (67 %), about 86 g
    Overseer (run on df3173c2, 122.7 g): 0.565 across the layers in the lead end wall landing on the le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
    [receiver.stl, receiver_room.stl]
2026-11-14 Scout v4 cradle: budget 6.0 (the sleeve failed early at 1.85 on 2.0); audit refuses a budget too thin for its room
    Cause: the sleeve's room (21 cm3) filled solid reads 0.226 in the 280 N head-first crash, but the 2.0 cm3 budget was 9 % of it:
    thinned uniformly the room read 2.41, 8x max_worst, and the run failed early at 1.85. Not the room, the budget.
    - topo/audit.py room_strength: refuse when the uniformly thinned room reads over 6x max_worst (BUDGET_K; every passing result on
    main reads 5.4x or under, the cradle 8.0x; no other current part is over); test_topo t_audit_room_full case: PASS
    - the cradle at 6.0 cm3: 28 % of the room, thinned ~0.8 (2.7x, as the head frame and the turret); au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
    [part.py]
2026-11-14 results: [scout_v4_frame_vl]
    [part.stl]
2026-11-14 Scout v4 cradle and head frame: the sleeve's walls drawn back to the pivots, the head-first crash landed on the crash stop
    Runs of 8c421a5 / 12fa257: cradle early fail 1.55 (head-first 280 N), head frame 0.318 (SG90 stall).
    - cradle: beside the case the room is 3 wide (y 18.45..21.5, the SG90's face at 23), under the 6.25 member, so nothing joined the sleeve
    to the horn's pad and the idler's boss: its side walls are drawn back to them (x -2..8, z +-10)
    - cradle head-first, as the head frame models it: the SG90 slips and the cradle nods down until the sleeve's bottom front edge lands on
    the head frame's crash stop (-20 deg); the rigid metal case squeezes the sleeve's bottom wall onto it (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
    [part.py, scout_v4_shape.py]
2026-11-14 scout_v4: the bolt forks folded in (frame 189.3 g, worst 0.211)
    Round 7's winner with its keep-out run (scout_v4_frame_vl, run of 8f97d87):
    189.3 g, solid PASS, worst 0.211 (6 g landing on the nose bolts only),
    motors <= 0.20; seat_check --descent with the fork nodes' meshes and rods
    and latch7's tab line: 0 crossings in 65 states; camera view clear.
    tools/scout_v4_shape.py: the bolt-fork cage (NB / TB / S0 / S1 at ZF 2.7 on
    forks of two 3.0 rods to BN0/1, BT0/1, SA0/1, SB0/1 at z 11 beside the
    receiver's 4 bolts; the 8 D / B rods gone), the flow sensor at FLOW_LO
    (64, -6.8) forward of latch v7's receiver room. The frame's defaults: the
    fork sockets, LATCH_V7, LANDING_ONE_END, gen 130. Node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
    [part.stl]
2026-11-14 Scout v4 arm coupon: motor 1's pod and arm cut from the frame's mesh, a clamp block, a puck, the engine's break loads (up 328 N, sideways 538 N)
    Cut from the vl run's print mesh (the fold's same setup); recut from scout_v4_frame when the fold's run lands.
    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
    [part.stl, scout_v4_arm_coupon.stl, scout_v4_arm_coupon_puck.stl]
2026-11-14 Latch v7 Scout receiver after the run on 48814dfb (87.4 g, solid check PASS, 0.524 in the hold-down): the hold-down as the arm's two cases
    The run read 0.524 across the layers at the tail notches' roots holding the head's 118 N as a flight case. The arm's own cases (parts/box_arm8_lib.py) have that
    118 N limit as misuse; what the head puts on a cartridge every swap is its commanded over-travel, 72 + 23.04 x 1.5 = 106.6 N. The Scout's hold-down is now those two
    cases: 106.6 N flight, 118 N misuse (fault). No gate touched. The Overseer keeps 118 N as flight (stricter; its setup does not change: 13f99d2f).
    Tried on the notch root first, both worse or no better in the room filled solid: a V root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
    [latch7_recv_lib.py]
2026-11-14 Latch v7 Overseer receiver after the run on 13f99d2f (144.9 g, solid check PASS, 0.574 landing on the lead keys): haunch room in the lead window's top corners
    76 and 92 cm3 read 0.565 and 0.574 across the layers at the same point, (11.2, 176.2, 26.0): the square top corner of the lead end wall's window (|x| 9.25, up to
    y 44.35, in a 3.0 wall). Landing on the lead wall's two keys makes that wall a portal between the key corners; the budget was not the cause (the 92 run's other cases
    fell to 0.41). Room for a 7.0 haunch in each top corner (WIN_HAUNCH); nothing passes there (cartridge, pack, plug and their path end short of the wall).
    Audit smoke at SPEC h OK, room filled solid 0.312. Budget st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
    [latch7_recv_lib.py]
2026-11-14 Scout v4 arm coupon: recut from the frame's fold result (189.3 g, 0.207): break up 246 N, sideways 500 N (FE h 1.0)
    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
    [part.stl, scout_v4_arm_coupon.stl, scout_v4_arm_coupon_puck.stl]
2026-11-14 Swap arm v8 page: kit tables, test set, open items, run shapes (held off main: a systems/ push restarts scout_v4_frame_vl, no result yet; published at the artifact)
    Claude-Session: https://claude.ai/code/session_01EtHMZNE9LEcKru42RcbwJa
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2026-11-14 Kit builder: take the release's identical arm mesh with a note [skip ci]
    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
    [funnel_kit.py]
2026-11-14 Box stand for the hub 15 mm higher (Spark 13 Nov): mast 15 longer, keel as printed less its cradle, toe as printed; geometry only, strength open [skip ci]
    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
    [part.stl]
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2026-11-14 Box stand checked with the arm v8: FAILS (mast 0.77 standing, kb 1.27, keel >= 1.75 on a flat floor, bars 1.22, toe 2.11 uneven; the v8 stub does not bolt to the mast); do not print the 15 longer mas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
    Claude-Session: https://claude.ai/code/session_01EtHMZMT6vv4EepLkPy7dTc
    [import_box.py]
2026-11-14 Scout v4: the frame model's rod end moments into every socket (frame, turret, 16 nodes)
    Each member end's bending moment and axis now in systems/scout_v4.cage_loads.json (tools/cage_loads.py returns the global moment
    vectors; scout_cage_loads / scout_v4_shape carry them). Every v4 socket case adds it as a couple across the bore (thirds: +Fc mouth,
    -Fc floor, the side force in the moment's plane). Socket depth adds the moment's bearing on the G/flex sleeve, 36.3 MPa yield:
    BT0/BT1 14.0, SB 12.5, SA 11.0, node sockets 7-10. Node budgets P2/P5 1.0, RS0/RS1 0.6, RB 0.5 (audit budget check).
    Claude-Session: https://claude.ai/code/session_01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
    [part.stl]
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2026-11-14 Box stand v2 for the swap arm v8: mast, two base halves, two rails (engine parts, parts/box_stand2_lib.py) and four TPU feet; the old demo stand out of systems/box.assembly.json; box check PASS, 0 ov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
    The mast takes the v8 stub's flange at W Y 0 (bearing ring r 33..45, 3 M5 x 16 on Ø15 washers from behind into heat-set inserts
    in the flange: the 135 deg hole is 0.5 into the axle stepper, and nothing fits in front of the flange, 2.0 to the bearings) and
    runs behind the hub to its foot at W Z -135; the halves bolt up into it (8 M5 into inserts) and reach the rails at |X| 120..177.5
    under the ring's sweep; each rail laps its half's cheek (4 M5 x 60) to the front foot at Y 232. Four feet: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
    [part.stl]
